Normansrule/Gonioreflectometer-Open-Source/phases/00-plan/3d/README.md

# 00 · 3D files

## Print

Black ABS, enclosed printer: nozzle 245–255 °C, bed 100–105 °C, fan ≤ 20 %, 0.2 mm layers, 4 walls, 25 % gyroid, brim on tall or long parts, no supports unless noted; XY shrink compensation from the coupon (M03.3). Ventilate the room (ABS fumes). Counts and grams: [cad/PRINT.md](../../../cad/PRINT.md). v0 geometry: measure your parts first.

**STEP** imports into Onshape as an editable solid (Insert → Import). **STL** is a mesh for the slicer.

| ID | Part | Edit (STEP) | Print (STL) |
|---|---|---|---|
| PLAN-01 | Fit test: M2 self-tap holes + 608 pockets | [PLAN-01_tolerance_coupon.step](PLAN-01_tolerance_coupon.step) | [PLAN-01_tolerance_coupon.stl](PLAN-01_tolerance_coupon.stl) |

Regenerate: `python tools/cad/parts.py` (parameters at the top of the file).

## Bought parts

Every bought part has a model in the repo (dummy in `cad/bought/` or open model in `cad/open/`; list: [cad/README.md](../../../cad/README.md)). `bash scripts/get_cad.sh` saves the real vendor models into `cad/vendor/` (not committed: vendor licences).

| ID | Part | In the repo | Real model |
|---|---|---|---|
| FIL-01 | ABS filament 1.75 mm, black, 1 kg (4 spools) | — | n/a (filament) |

Design notes: [../design.md](../design.md).
