Normansrule/Gonioreflectometer-Open-Source/phases/11-scan-capture/3d/README.md

# 11 · 3D files

## Print

Black ABS, enclosed printer: nozzle 245–255 °C, bed 100–105 °C, fan ≤ 20 %, 0.2 mm layers, 4 walls, 25 % gyroid, brim on tall or long parts, no supports unless noted; XY shrink compensation from the coupon (M03.3). Ventilate the room (ABS fumes). Counts and grams: [cad/PRINT.md](../../../cad/PRINT.md). v0 geometry: measure your parts first.

**STEP** imports into Onshape as an editable solid (Insert → Import). **STL** is a mesh for the slicer.

| ID | Part | Edit (STEP) | Print (STL) |
|---|---|---|---|
| SCN-03a | Riser 20 mm | [SCN-03a_riser_20.step](SCN-03a_riser_20.step) | [SCN-03a_riser_20.stl](SCN-03a_riser_20.stl) |
| SCN-03b | Riser 40 mm | [SCN-03b_riser_40.step](SCN-03b_riser_40.step) | [SCN-03b_riser_40.stl](SCN-03b_riser_40.stl) |
| SCN-03c | Riser 60 mm | [SCN-03c_riser_60.step](SCN-03c_riser_60.step) | [SCN-03c_riser_60.stl](SCN-03c_riser_60.stl) |
| SCN-03d | Scan camera plate, looks 15 deg down | [SCN-03d_scan_camera_plate_15.step](SCN-03d_scan_camera_plate_15.step) | [SCN-03d_scan_camera_plate_15.stl](SCN-03d_scan_camera_plate_15.stl) |

Regenerate: `python tools/cad/parts.py` (parameters at the top of the file).

## Bought parts

Every bought part has a model in the repo (dummy in `cad/bought/` or open model in `cad/open/`; list: [cad/README.md](../../../cad/README.md)). `bash scripts/get_cad.sh` saves the real vendor models into `cad/vendor/` (not committed: vendor licences).

| ID | Part | In the repo | Real model |
|---|---|---|---|
| SCN-01 | Mounting putty 2 oz | [`SCN-01_mounting_putty_blob.step`](../../../cad/bought/SCN-01_mounting_putty_blob.step) | None published - use the dummy (putty) |
| SCN-02 | ChArUco scanning mat (printed on TLS-08) | [`SCN-02_charuco_mat_print.step`](../../../cad/bought/SCN-02_charuco_mat_print.step) | None published - use the dummy (print, generated by the software) |
| CAM-04 | Second USB camera 12 MP IMX477, M12 mount (scan camera) | [`CAM-01_arducam_b0433_imx477_usb.step`](../../../cad/bought/CAM-01_arducam_b0433_imx477_usb.step) | None published - use the dummy (same as CAM-01) |
| CAM-05 | Second M12 16 mm lens (scan camera) | [`CAM-02_m12_lens_16mm.step`](../../../cad/bought/CAM-02_m12_lens_16mm.step) | None published - use the dummy (same as CAM-02) |

Design notes: [../design.md](../design.md).
