Normansrule/Gonioreflectometer-Open-Source/wiki/Hardware.md

<!-- generated from wiki/src/Hardware.md by tools/refs_bib.py - edit the source -->

# Hardware

Every electrical connection, pin by pin (power, SKR Pico, ESP32-S3 header, lamp, USB; step by step in the [wiring guide](https://github.com/Normansrule/Gonioreflectometer-Open-Source/blob/main/docs/wiring.html)): [README → Wiring](https://github.com/Normansrule/Gonioreflectometer-Open-Source/blob/main/README.md#wiring).

| Subsystem | Parts | Stage |
|---|---|---|
| Power | 24 V 3 A wall adapter with a screw-terminal jack, latching e-stop in its own box, pre-wired limit switch, lever connectors | [01](https://github.com/Normansrule/Gonioreflectometer-Open-Source/blob/main/phases/01-power) |
| Controller | BTT SKR Pico (grblHAL, USB-C) + ESP32-S3 hub, keypads | [02](https://github.com/Normansrule/Gonioreflectometer-Open-Source/blob/main/phases/02-controller) |
| Frame | printed 600 × 600 mm deck (9 tiles), printed 20 × 20 bars, M2 screws | [03](https://github.com/Normansrule/Gonioreflectometer-Open-Source/blob/main/phases/03-frame) |
| Light arm (M4) | 12 in lazy Susan, GT2 belt rim, 24:1 | [04](https://github.com/Normansrule/Gonioreflectometer-Open-Source/blob/main/phases/04-light-arm) |
| Table (M3), tilt (M2), spin (M1) | NEMA 17 steppers, 5:1 belts, M8 bolt axles, direct-drive spin | [05](https://github.com/Normansrule/Gonioreflectometer-Open-Source/blob/main/phases/05-table) · [08](https://github.com/Normansrule/Gonioreflectometer-Open-Source/blob/main/phases/08-tilt) · [09](https://github.com/Normansrule/Gonioreflectometer-Open-Source/blob/main/phases/09-spin) |
| Camera | 12 MP IMX477 USB, 16 mm M12 lens, printed f/8 stop | [06](https://github.com/Normansrule/Gonioreflectometer-Open-Source/blob/main/phases/06-camera-light) |
| Light | Citizen CLU701 COB, colour rendering index (CRI) ≥ 90, 2700 K, in a solderless TE holder, 350 mA wire-lead driver, pin-fin heatsink | [06](https://github.com/Normansrule/Gonioreflectometer-Open-Source/blob/main/phases/06-camera-light) |

- **No tools beyond a kit:** lever connectors, screw terminals, modules instead of loose chips, M2 screws self-tapping into printed pilots.
- **One screw size:** M2 everywhere; M3 only into the motors, M8 bolts as axles.
- **Printed parts:** black ABS (acrylonitrile butadiene styrene) on an enclosed printer; ≈ 2.7 kg, half of it the deck.
- **Circuit board (future):** a carrier board that replaces the modules and jumpers: [pcb/](https://github.com/Normansrule/Gonioreflectometer-Open-Source/blob/main/pcb/README.md).
- **Optical homing** on every axis; one over-travel switch in the e-stop loop (light arm, at 17°; the other ends rely on soft limits and the e-stop).
- **Cost:** see the [bill of materials](https://github.com/Normansrule/Gonioreflectometer-Open-Source/blob/main/README.md#electronics) (pictures, buy links, STEP/STL downloads).

Open-hardware practice (Open Source Hardware Association, n.d.; Pearce, 2012): [Appendix E](Appendix-E-Hardware.md).

## References

Open Source Hardware Association. (n.d.). *Open source hardware (OSHW) definition 1.0*. Retrieved <https://oshwa.org/definition/>

Pearce, J. M. (2012). Building research equipment with free, open-source hardware. *Science*, *337*(6100), 1303–1304. <https://doi.org/10.1126/science.1228183>
