Normansrule/Gonioreflectometer-Open-Source/wiki/Appendix-E-Hardware.md

# Appendix E · Motion control, electronics, open hardware

<!-- generated by tools/refs_bib.py from REFERENCES.md - edit that file, then `make build` -->

Background papers and sources, by topic. Format: APA reference — *what this project uses it for*. Full list: [Bibliography](Bibliography.md).

## Stepper drivers and microcontrollers

- Analog Devices (Trinamic). (n.d.-b). *TMC2209 datasheet*. https://www.analog.com/media/en/technical-documentation/data-sheets/tmc2209_datasheet_rev1.09.pdf — *Driver registers, UART, current (phase 02)* `[H1]`
- Analog Devices (Trinamic). (n.d.-a). *AN-002: Parameterization of StallGuard2 & CoolStep*. https://www.analog.com/en/resources/app-notes/an-002.html — *Stall-detection thresholds, crash detection (phases 02, 04)* `[H2]`
- Dwersteg (Analog Devices/Trinamic), B. (n.d.). *AN-026: Programmable adaptive microstep table*. https://www.analog.com/en/resources/app-notes/an-026.html — *Microstep linearity, even step spacing (phases 08, 09)* `[H3]`
- Marlin Firmware. (n.d.). *Trinamic drivers*. https://marlinfw.org/docs/hardware/tmc_drivers.html — *StealthChop vs SpreadCycle choice (phase 02)* `[H4]`
- Espressif Systems. (n.d.-b). *ESP32 technical reference manual*. https://documentation.espressif.com/esp32_technical_reference_manual_en.pdf — *E4 MCU peripherals, step timing (phase 02)* `[H5]`
- Espressif Systems. (n.d.-a). *ESP32 series datasheet*. https://www.espressif.com/sites/default/files/documentation/esp32_datasheet_en.pdf — *Strapping pins, electrical limits (phase 02)* `[H6]`
- Raspberry Pi Ltd. (n.d.-b). *RP2040 datasheet*. https://datasheets.raspberrypi.com/rp2040/rp2040-datasheet.pdf — *Pico GPIO, pull-ups, PIO (phase 02)* `[H7]`
- Raspberry Pi Ltd. (n.d.-a). *Raspberry Pi Pico-series Python SDK: A MicroPython environment for Raspberry Pi microcontrollers*. https://datasheets.raspberrypi.com/pico/raspberry-pi-pico-python-sdk.pdf — *MicroPython button-hub firmware (phase 02)* `[H8]`

## Interface electronics and position sensors

- Sharp Corporation. (2018). *PC817XxNSZ1B series*. https://global.sharp/products/device/lineup/data/pdf/datasheet/PC817XxNSZ1B_e.pdf — *24 V sense optocoupler, CTR (phase 01)* `[H9]`
- Texas Instruments. (2025). *ULN200x, ULQ200x high-voltage, high-current darlington transistor arrays*. https://www.ti.com/lit/gpn/ULN2003A — *8-band LED low-side switching (phase 10)* `[H10]`
- Vishay Semiconductors. (n.d.). *TCST2103, TCST2202, TCST2300: Transmissive optical sensor with phototransistor output*. https://www.vishay.com/docs/81147/tcst2103.pdf — *Optical homing flag, 1 mm aperture (phases 04, 05)* `[H11]`
- ams AG (ams OSRAM). (2014). *AS5600 – 12-bit programmable contactless potentiometer*. https://www.mouser.com/pdfdocs/AMS_AS5600_Datasheet_EN.PDF — *Absolute-angle check of axes (phase 17)* `[H12]`

## Camera interface

- Sony Semiconductor Solutions. (2018). *IMX477-AACK: Diagonal 7.857 mm (type 1/2.3) 12.3 mega-pixel CMOS image sensor*. https://www.sony-semicon.com/files/62/pdf/p-13_IMX477-AACK_Flyer.pdf — *Pixel pitch 1.55 µm, sensor size (phase 06)* `[H13]`
- USB Implementers Forum. (2012). *Video class v1.5 document set*. https://www.usb.org/document-library/video-class-v15-document-set — *UVC exposure/white-balance controls (phase 06)* `[H14]`
- Linux kernel documentation. (n.d.). *The linux USB video class (UVC) driver*. https://www.kernel.org/doc/html/latest/userspace-api/media/drivers/uvcvideo.html — *uvcvideo controls, extension units (phases 06, 14)* `[H15]`

## Belt drives and positioning accuracy

- Gates Corporation. (n.d.-b). *PowerGrip GT2 belt drives – drive design manual*. https://docs.rs-online.com/5016/0900766b8002d3b7.pdf — *GT tooth profile, registration, backlash (phases 04, 05)* `[H16]`
- Gates Corporation. (n.d.-a). *Light power & precision drive design manual*. https://www.gates.com/content/dam/documents-library/catalogs/light-power-and-precision-manual.pdf — *Small-pitch pulley sizing, tension (phases 04, 05)* `[H17]`
- Prusa Research. (n.d.). *Adjusting belt tension (CORE one/+, CORE one INDX, CORE one L/+)*. https://help.prusa3d.com/article/adjusting-belt-tension-core-one_845048 — *Frequency-based belt tension check (phase 04)* `[H18]`
- Oriental Motor USA. (n.d.). *Stepper motor basics*. https://www.orientalmotor.com/stepper-motors/technology/stepper-motor-basics.html — *Angular error budget per axis (phase 07)* `[H19]`
- Walter, M. (2016). How accurate is microstepping really? *Hackaday*, *29*. https://hackaday.com/2016/08/29/how-accurate-is-microstepping-really/ — *Microsteps ≠ accuracy under load (phase 08)* `[H20]`
- Fritz Faulhaber GmbH, Dr. (n.d.). *Stepper motor technical note: Microstepping myths and realities*. https://www.faulhaber.com/fileadmin/user_upload/Support/dff_200276_whitepaper_microstepping_8cb.pdf — *Incremental torque per microstep (phase 08)* `[H21]`
- Zaber Technologies. (n.d.). *Microstepping tutorial*. https://www.zaber.com/technical-articles/microstepping-tutorial — *Stiction vs microstep resolution (phase 07)* `[H22]`
- Chang, C., & Tran, T. (2025). Mastering precision: Understanding microstepping in motion control. *Analog Dialogue*, *59*(2). https://www.analog.com/en/resources/analog-dialogue/articles/mastering-precision-understanding-microstepping.html — *Microstep current waveforms, holding torque (phase 02)* `[H23]`

## Motion firmware, homing and G-code

- Grbl project (gnea). (n.d.). *An open source, embedded, high performance g-code-parser and CNC milling controller*. https://github.com/gnea/grbl — *FluidNC lineage, protocol, homing cycle (phase 02)* `[H24]`
- grblHAL. (n.d.). *grblHAL core code and master wiki*. https://github.com/grblHAL/core — *Alternative Grbl-derived firmware (phase 02)* `[H25]`
- LinuxCNC. (n.d.). *Homing configuration*. https://linuxcnc.org/docs/html/config/ini-homing.html — *Two-speed search/latch homing (phases 04, 05)* `[H26]`
- Kramer, T. R., Proctor, F. M., & Messina, E. R. (2000). *The NIST RS274NGC interpreter – version 3*. https://www.nist.gov/publications/nist-rs274ngc-interpreter-version-3 — *G-code semantics for capture scripts (phase 14)* `[H27]`

## Open-source hardware practice and licensing

- Pearce, J. M. (2012). Building research equipment with free, open-source hardware. *Science*, *337*(6100), 1303–1304. https://doi.org/10.1126/science.1228183 — *Rationale for open lab equipment (phase 00)* `[H28]`
- Pearce, J. M. (2014). *Open-source lab: How to build your own hardware and reduce research costs*. Elsevier. https://doi.org/10.1016/C2012-0-07249-3 — *Low-cost scientific tool design (phase 00)* `[H29]`
- Jones, R., Haufe, P., Sells, E., Iravani, P., Olliver, V., Palmer, C., & Bowyer, A. (2011). RepRap – the replicating rapid prototyper. *Robotica*, *29*(1), 177–191. https://doi.org/10.1017/S026357471000069X — *Printed-part machine heritage (phase 03)* `[H30]`
- Open Source Hardware Association. (n.d.). *Open source hardware (OSHW) definition 1.0*. https://oshwa.org/definition/ — *Release documentation criteria (phase 16)* `[H31]`
- CERN. (n.d.). *CERN open hardware licence version 2*. https://www.ohwr.org/cernohl — *Hardware licence choice (phase 16)* `[H32]`
- Gathering for Open Science Hardware. (n.d.). *GOSH manifesto*. https://openhardware.science/gosh-manifesto/ — *Project values, accessibility (phase 16)* `[H33]`
- Bonvoisin, J., Mies, R., Boujut, J.-F., & Stark, R. (2017). What is the ’source’ of open source hardware? *Journal of Open Hardware*, *1*(1). https://doi.org/10.5334/joh.7 — *What files to publish (phase 16)* `[H34]`
- Collins, J. T., Knapper, J., Stirling, J., …, & Bowman, R. (2020). Robotic microscopy for everyone: The OpenFlexure microscope. *Biomedical Optics Express*, *11*(5), 2447–2460. https://doi.org/10.1364/BOE.385729 — *Model for documented printed instrument (phases 00, 16)* `[H35]`
- Elsevier. (n.d.). *Guide for authors – HardwareX*. https://doi.org/10.5281/zenodo.5078227 — *Paper structure, BOM, validation (phase 16)* `[H36]`

## Low-cost open instruments (HardwareX and related)

- Toschke, Y., Klenen, J., & Imlau, M. (2024). Open photonics: An integrated approach for building a 3D-printed motorized rotation stage system. *HardwareX*, *20*, e00577. https://doi.org/10.1016/j.ohx.2024.e00577 — *ESP32 rotation stage, home switch (phases 05, 09)* `[H37]`
- Schneidereit, D., Kraus, L., Meier, J. C., Friedrich, O., & Gilbert, D. F. (2017). Step-by-step guide to building an inexpensive 3D printed motorized positioning stage for automated high-content screening microscopy. *Biosensors and Bioelectronics*, *92*, 472–481. https://doi.org/10.1016/j.bios.2016.10.078 — *Printed stepper stage accuracy (phase 03)* `[H38]`
- Hietanen, I., Heikkinen, I. T. S., Savin, H., & Pearce, J. M. (2018). Approaches to open source 3-D printable probe positioners and micromanipulators for probe stations. *HardwareX*. https://doi.org/10.1016/j.ohx.2018.e00042 — *Validating printed positioners (phase 07)* `[H39]`
- Salazar-Vazquez, J., & Mendez-Vazquez, A. (2020). A plug-and-play hyperspectral imaging sensor using low-cost equipment. *HardwareX*. https://doi.org/10.1016/j.ohx.2019.e00087 — *Low-cost spectral imaging prior art (phase 10)* `[H40]`
- Dhankania, K. C., & Pearce, J. M. (2016). Open source laboratory sample rotator mixer and shaker. *HardwareX*. http://www.sciencedirect.com/science/article/pii/S2468067216300049 — *Printed rotary stage prior art (phase 05)* `[H41]`
- Public Lab. (n.d.). *Desktop spectrometry kit 3.0*. https://publiclab.org/wiki/desktop-spectrometry-kit-3-0 — *DIY spectral calibration (phase 10)* `[H42]`

## Design tools and project publishing

- *KiCad EDA*. (n.d.). https://kicad.org/ — *Power-box and hub schematics (phases 01, 02)* `[H43]`
- GitHub Docs. (n.d.-b). *REST API endpoints for milestones*. https://docs.github.com/en/rest/issues/milestones — *Phase milestones and issue scripts (phase 00)* `[H44]`
- GitHub Docs. (n.d.-a). *Configuring a publishing source for your GitHub pages site*. https://docs.github.com/en/pages/getting-started-with-github-pages/configuring-a-publishing-source-for-your-github-pages-site — *Documentation site deployment (phase 16)* `[H45]`

## Software dependencies

- *Python software foundation, Python language and standard library*. (n.d.). https://www.python.org — *Laptop app runtime (phase 14)* `[H46]`
- Harris, C. R., Millman, K. J., Walt, S. J. van der, et al. (2020). Array programming with NumPy. *Nature*, *585*, 357–362. https://doi.org/10.1038/s41586-020-2649-2 — *Image arrays, HDR, geometry (phase 07)* `[H47]`
- Virtanen, P., Gommers, R., Oliphant, T. E., et al. (2020). SciPy 1.0: Fundamental algorithms for scientific computing in Python. *Nature Methods*, *17*, 261–272. https://doi.org/10.1038/s41592-019-0686-2 — *BRDF least-squares fitting, rotations (phases 07, 08)* `[H48]`
- Bradski, G. (2000). The OpenCV library. *Dr. Dobb’s Journal of Software Tools*. https://github.com/opencv/opencv/wiki/CiteOpenCV — *Capture, calibration, ChArUco (phases 06, 11)* `[H49]`
- *PyYAML (YAML parser and emitter for Python)*. (n.d.). https://pyyaml.org/ — *Config files and test suite (phase 14)* `[H50]`

## Standalone station

- *Raspberry Pi Zero 2 W*. (n.d.). https://www.raspberrypi.com/products/raspberry-pi-zero-2-w/ — *Standalone station (phase 15)* `[H51]`
- *Micropython-lib SSD1306 driver*. (n.d.). https://github.com/micropython/micropython-lib/tree/master/micropython/drivers/display/ssd1306 — *Panel OLED (phase 15)* `[H52]`
- *Raspberry Pi configuration, ‘raspi-config‘ and UART*. (n.d.). https://www.raspberrypi.com/documentation/computers/configuration.html — *Pi UART to Pico (phase 15)* `[H53]`
- *Usbipd-win*. (n.d.). https://github.com/dorssel/usbipd-win — *USB boards into WSL (phase 02)* `[H54]`
- *MicroPython ‘machine.UART‘*. (n.d.). https://docs.micropython.org/en/latest/library/machine.UART.html — *Pico ↔ Pi link (phase 15)* `[H55]`
- *CadQuery 2.x, parametric CAD in Python*. (n.d.). https://pypi.org/project/cadquery/ — *Generated STEP/STL parts (phase 00)* `[H56]`
- *Numpy-stl*. (n.d.). https://pypi.org/project/numpy-stl/ — *Parts gallery rendering (phase 00)* `[H57]`
- *Matplotlib*. (n.d.). https://matplotlib.org/ — *Parts gallery rendering (phase 00)* `[H58]`
- *Ams AS7341 11-channel spectral sensor; adafruit breakout #4698*. (n.d.). https://www.adafruit.com/product/4698 — *Spectral sensor (phase 10)* `[H59]`
- *W3C, portable network graphics (PNG) specification*. (n.d.). https://www.w3.org/TR/png/ — *Built-in PNG reader/writer in `opengonio.imageio` (phase 00)* `[H60]`
