Normansrule/Gonioreflectometer-Open-Source/phases/07-calibrate/design.md

# 07 · Design

- Blackout drape on four dowels; black felt behind the sample; the power plate and controller tray stay uncovered (air around the e-stop box, adapter jack and SKR Pico).
- Printed kinematic holders for PTFE, mirror tile, chrome balls, ChArUco board on glass.

## 3D parts

| Part | Source |
|---|---|
| Dowel sockets, drape clips (ENC-04) | Onshape `ENC` |
| Holders for PTFE, mirror, balls (CAL-06) | Onshape `CAL` |

## Results

(fill in)
