Normansrule/Gonioreflectometer-Open-Source/phases/06-camera-light/optics.md

# Fixed-camera optics (generated by tools/optics.py)

f = 16.0 mm, 3840 x 3032 px at 1.55 um (sensor 5.95 x 4.70 mm).

## BRDF mode (350 mm)

- Magnification 0.0479; field 124 x 98 mm; pixel footprint 32 um.
- Depth needed for a 50 mm swatch: 43 mm at theta_r 60 deg.

| Aperture N | Airy disk (um) | Airy / pixel | DOF (mm, c = 2 px) |
|---:|---:|---:|---:|
| f/2 | 2.7 | 1.7 | 5.7 |
| f/2.8 | 3.8 | 2.4 | 7.9 |
| f/4 | 5.4 | 3.5 | 11.3 |
| f/5.6 | 7.5 | 4.8 | 15.9 |
| f/8 | 10.7 | 6.9 | 22.6 |
| f/11 | 14.8 | 9.5 | 31.1 |
| f/16 | 21.5 | 13.9 | 45.3 |

Swatch BRDF: f/8 (averaged regions). Texture detail: f/4 and theta_r <= 45 deg.

## Scan mode (650 mm)

- Magnification 0.0252; field 236 x 186 mm; pixel footprint 0.061 mm (footprint, not resolution: see table).

| Aperture N | DOF (mm, c = diffraction) | Resolution on object (mm) |
|---:|---:|---:|
| f/5.6 | 57 | 0.18 |
| f/8 | 117 | 0.25 |
| f/11 | 221 | 0.35 |
| f/16 | 467 | 0.51 |

Scanning uses f/8: ~0.25 mm detail with enough depth for objects ~110 mm deep. Printed aperture stop = f / N = 2.0 mm (same stop as BRDF mode).
