Normansrule/Gonioreflectometer-Open-Source/wiki/Bibliography.md

# Bibliography

<!-- generated by tools/refs_bib.py from REFERENCES.md - edit that file, then `make build` -->

322 scholarly sources, APA 7th edition. `[G12]` = ID in [REFERENCES.md](https://github.com/Normansrule/Gonioreflectometer-Open-Source/blob/main/REFERENCES.md) and BibTeX key in [paper/references.bib](https://github.com/Normansrule/Gonioreflectometer-Open-Source/blob/main/paper/references.bib). Topic lists with what each source is used for: [Appendix A](Appendix-A-Measurement.md) · [Appendix B](Appendix-B-Reflectance-models.md) · [Appendix C](Appendix-C-Calibration-and-3D.md) · [Appendix D](Appendix-D-Standards-and-colour.md) · [Appendix E](Appendix-E-Hardware.md).

- Ackermann, J., & Goesele, M. (2015). A survey of photometric stereo techniques. *Foundations and Trends in Computer Graphics and Vision*, *9*. https://doi.org/10.1561/0600000065 `[V27]`
- Aittala, M., Weyrich, T., & Lehtinen, J. (2013). Practical SVBRDF capture in the frequency domain. *ACM Transactions on Graphics*, *32*(4). https://doi.org/10.1145/2461912.2461978 `[G44]`
- Ali, I., Suominen, O., Gotchev, A., & Ruiz Morales, E. (2019). Methods for simultaneous robot-world-hand–eye calibration: A comparative study. *Sensors*, *19*(12), 2837. https://doi.org/10.3390/s19122837 `[V17]`
- ams AG (ams OSRAM). (2014). *AS5600 – 12-bit programmable contactless potentiometer*. https://www.mouser.com/pdfdocs/AMS_AS5600_Datasheet_EN.PDF `[H12]`
- *Ams AS7341 11-channel spectral sensor; adafruit breakout #4698*. (n.d.). https://www.adafruit.com/product/4698 `[H59]`
- Analog Devices (Trinamic). (n.d.-a). *AN-002: Parameterization of StallGuard2 & CoolStep*. https://www.analog.com/en/resources/app-notes/an-002.html `[H2]`
- Analog Devices (Trinamic). (n.d.-b). *TMC2209 datasheet*. https://www.analog.com/media/en/technical-documentation/data-sheets/tmc2209_datasheet_rev1.09.pdf `[H1]`
- Andersson, Z., Edmondson, P., Guertault, J., Herubel, A., Kutz, P., Machizaud, A., Portsmouth, J., Servant, F., & Stone, J. (2025). OpenPBR surface: An open shading model for physically based materials. *DigiPro 2025*. https://doi.org/10.1145/3744199.3744632 `[T50]`
- Ansari-Asl, M. (2026). *Development of a multispectral camera-based device for goniometric acquisition of spatially varying reflectance properties*. PhD thesis. https://www.ntnu.edu/colourlab/phd-theses `[G35]`
- Ansari-Asl, M., Barbieri, M., Obein, G., & Hardeberg, J. Y. (2023). Advancing material appearance measurement: A cost-effective multispectral imaging system for capturing SVBRDF and BTF. *London Imaging Meeting*. https://doi.org/10.2352/lim.2023.4.1.25 `[G33]`
- Ansari-Asl, M., Barbieri, M., Obein, G., & Hardeberg, J. Y. (2024). Optical and electromechanical design and implementation of an advanced multispectral device to capture material appearance. *Journal of Imaging*, *10*(3), 55. https://doi.org/10.3390/jimaging10030055 `[R1]`
- Ansari-Asl, M., Thomas, J.-B., & Hardeberg, J. Y. (2022). Camera response function assessment in multispectral HDR imaging. *IS&T Electronic Imaging (Color Imaging XXVII)*, *141*. https://doi.org/10.2352/EI.2022.34.15.COLOR-141 `[G34]`
- Ashikhmin, M., & Shirley, P. (2000). An anisotropic Phong BRDF model. *Journal of Graphics Tools*, *5*(2), 25–32. https://doi.org/10.1080/10867651.2000.10487522 `[T15]`
- ASTM International. (n.d.). *Standard test method for specular gloss*. https://store.astm.org/standards/d523 `[N4]`
- ASTM International. (2003). *Standard practice for angle resolved optical scatter measurements on specular or diffuse surfaces*. https://www.astm.org/DATABASE.CART/WITHDRAWN/E1392.htm `[N2]`
- ASTM International. (2005). *Standard practice for goniophotometry of objects and materials*. https://store.astm.org/e0167-96.html `[N3]`
- ASTM International. (2019). *Standard practice for goniometric optical scatter measurements*. https://store.astm.org/e2387-19.html `[N1]`
- ASTM International. (2023a). *Standard practice for obtaining spectrometric data for object-color evaluation*. https://store.astm.org/standards/e1164 `[N9]`
- ASTM International. (2023b). *Standard test methods for measurement of gloss of high-gloss surfaces by abridged goniophotometry*. https://store.astm.org/standards/e430 `[N5]`
- ASTM International. (2025a). *Standard terminology of appearance*. https://doi.org/10.1520/E0284-25 `[N6]`
- ASTM International. (2025b). *Standard test method for multiangle color measurement of metal flake pigmented materials*. https://doi.org/10.1520/E2194-14R25 `[N8]`
- ASTM International. (2026). *Standard practice for specifying the geometry of multiangle spectrophotometers*. https://store.astm.org/standards/e2175 `[N7]`
- *ASWF, MaterialX specification and physically based shading nodes*. (n.d.). https://github.com/AcademySoftwareFoundation/MaterialX/blob/main/documents/Specification/MaterialX.PBRSpec.md `[T51]`
- Baek, S.-H., Zeltner, T., Ku, H., Hwang, I., Tong, X., Jakob, W., & Kim, M. H. (2020). Image-based acquisition and modeling of polarimetric reflectance. *ACM Transactions on Graphics*, *39*(4), 139. https://doi.org/10.1145/3386569.3392387 `[G45]`
- Bagher, M. M., Soler, C., & Holzschuch, N. (2012). Accurate fitting of measured reflectances using a shifted gamma micro-facet distribution. *Computer Graphics Forum*, *31*(4). https://inria.hal.science/hal-00702304 `[T23]`
- Barnes, P. Y., Early, E. A., & Parr, A. C. (1998a). *NIST measurement services: Spectral reflectance*. https://nvlpubs.nist.gov/nistpubs/Legacy/SP/nistspecialpublication250-48.pdf `[G21]`
- Barnes, P. Y., Early, E. A., & Parr, A. C. (1998b). *Spectral reflectance*. https://doi.org/10.6028/NIST.SP.250-48 `[N33]`
- Basri, R., Jacobs, D., & Kemelmacher, I. (2007). Photometric stereo with general, unknown lighting. *International Journal of Computer Vision*, *72*(3), 239–257. https://doi.org/10.1007/s11263-006-8815-7 `[V26]`
- Ben-Ezra, M., Wang, J., Wilburn, B., Li, X., & Ma, L. (2008). An LED-only BRDF measurement device. *Proceedings of the IEEE Conference on Computer Vision and Pattern Recognition*. https://doi.org/10.1109/CVPR.2008.4587766 `[G17]`
- Blender Manual. (n.d.). *Principled BSDF*. https://docs.blender.org/manual/en/latest/render/shader_nodes/shader/principled.html `[T48]`
- *Blender manual: PLY, OBJ, glTF 2.0, formats*. (n.d.). https://docs.blender.org/manual/en/latest/files/import_export/ply.html `[S16]`
- Blinn, J. F. (1977). Models of light reflection for computer synthesized pictures. *Proc. SIGGRAPH ’77*. https://doi.org/10.1145/563858.563893 `[T9]`
- Bonvoisin, J., Mies, R., Boujut, J.-F., & Stark, R. (2017). What is the ’source’ of open source hardware? *Journal of Open Hardware*, *1*(1). https://doi.org/10.5334/joh.7 `[H34]`
- Born, M., & Wolf, E. (2019). *Principles of optics* (7th ed.). https://www.cambridge.org/9781108477437 `[T30]`
- Bouguet, J.-Y. (2022). *Camera calibration toolbox for Matlab*. https://doi.org/10.22002/D1.20164 `[V5]`
- *BQ ciclop scanner + horus software*. (n.d.). https://github.com/bqlabs/ciclop `[V55]`
- Bradski, G. (2000). The OpenCV library. *Dr. Dobb’s Journal of Software Tools*. https://github.com/opencv/opencv/wiki/CiteOpenCV `[H49]`
- Brown, D. C. (1971). Close-range camera calibration. *Photogrammetric Engineering*, *37*(8), 855–866. https://www.semanticscholar.org/paper/Close-Range-Camera-Calibration-Brown/1150007b62a3c7dac99c2c8f85c63bfab74891af `[V4]`
- Burley, B. (2012). Physically-based shading at Disney. *Practical Physically Based Shading in Film and Game Production*. https://static1.squarespace.com/static/58586fa5ebbd1a60e7d76d3e/t/593a3afa46c3c4a376d779f6/1496988449807/s2012_pbs_disney_brdf_notes_v2.pdf `[T33]`
- Burley, B. (2015). *Extending the Disney BRDF to a BSDF with integrated subsurface scattering*. https://blog.selfshadow.com/publications/s2015-shading-course/burley/s2015_pbs_disney_bsdf_notes.pdf `[T34]`
- *CadQuery 2.x, parametric CAD in Python*. (n.d.). https://pypi.org/project/cadquery/ `[H56]`
- CERN. (n.d.). *CERN open hardware licence version 2*. https://www.ohwr.org/cernohl `[H32]`
- Chang, C., & Tran, T. (2025). Mastering precision: Understanding microstepping in motion control. *Analog Dialogue*, *59*(2). https://www.analog.com/en/resources/analog-dialogue/articles/mastering-precision-understanding-microstepping.html `[H23]`
- Chen, G., Dong, Y., Peers, P., Zhang, J., & Tong, X. (2014). Reflectance scanning: Estimating shading frame and BRDF with generalized linear light sources. *ACM Transactions on Graphics*, *33*(4). https://doi.org/10.1145/2601097.2601180 `[G43]`
- Chitnis, S., Sole, A., & Chandran, S. (2025). Spectral bidirectional reflectance distribution function simplification. *Journal of Imaging*, *11*(1), 18. https://doi.org/10.3390/jimaging11010018 `[G37]`
- CIE. (1995). *Method of measuring and specifying colour rendering properties of light sources*. https://cie.co.at/publications/method-measuring-and-specifying-colour-rendering-properties-light-sources `[N15]`
- CIE. (2006). *A framework for the measurement of visual appearance*. https://cie.co.at/publications/framework-measurement-visual-appearance `[N12]`
- CIE. (2017). *CIE 2017 colour fidelity index for accurate scientific use*. https://doi.org/10.25039/TR.224.2017 `[N16]`
- CIE. (2018). *Colorimetry, 4th edition*. https://doi.org/10.25039/TR.015.2018 `[N13]`
- CIE. (2020). *ILV: International lighting vocabulary, 2nd edition*. https://doi.org/10.25039/S017.2020 `[N14]`
- Collins, J. T., Knapper, J., Stirling, J., …, & Bowman, R. (2020). Robotic microscopy for everyone: The OpenFlexure microscope. *Biomedical Optics Express*, *11*(5), 2447–2460. https://doi.org/10.1364/BOE.385729 `[H35]`
- COLMAP FAQ. (n.d.). *Reconstruct sparse/dense model from known camera poses*. https://colmap.github.io/faq.html `[S2]`
- *COLMAP output format*. (n.d.). https://colmap.github.io/format.html `[S1]`
- Cook, R., & Torrance, K. (1982). A reflectance model for computer graphics. *ACM Transactions on Graphics*, *1*(1). `[R8]`
- *Cornell gonioreflectometer*. (n.d.). http://w1.graphics.cornell.edu/research/measure/gonio.html `[R10]`
- *Cornell measurement data*. (n.d.). https://www.graphics.cornell.edu/online/measurements/ `[R12]`
- Curless, B., & Levoy, M. (1996). A volumetric method for building complex models from range images. *Proc. SIGGRAPH*. https://doi.org/10.1145/237170.237269 `[V44]`
- Dana, K. J., Ginneken, B. van, Nayar, S. K., & Koenderink, J. J. (1999). Reflectance and texture of real-world surfaces. *ACM Transactions on Graphics*, *18*(1), 1–34. https://doi.org/10.1145/300776.300778 `[G11]`
- Dana, K. J., & Wang, J. (2004). Device for convenient measurement of spatially varying bidirectional reflectance. *Journal of the Optical Society of America A*, *21*(1), 1–12. https://doi.org/10.1364/JOSAA.21.000001 `[G14]`
- Daniilidis, K. (1999). Hand-eye calibration using dual quaternions. *International Journal of Robotics Research*, *18*(3), 286–298. https://doi.org/10.1177/02783649922066213 `[V12]`
- Debevec, P., Hawkins, T., Tchou, C., Duiker, H.-P., Sarokin, W., & Sagar, M. (2000). Acquiring the reflectance field of a human face. *Proc. SIGGRAPH*. https://doi.org/10.1145/344779.344855 `[V48]`
- Debevec, P., & Malik, J. (1997). Recovering high dynamic range radiance maps from photographs. *Proc. SIGGRAPH ’97*. https://pauldebevec.com/Research/HDR/debevec-siggraph97.pdf `[R5]`
- Dhankania, K. C., & Pearce, J. M. (2016). Open source laboratory sample rotator mixer and shaker. *HardwareX*. http://www.sciencedirect.com/science/article/pii/S2468067216300049 `[H41]`
- Dornaika, F., & Horaud, R. (1998). Simultaneous robot-world and hand-eye calibration. *IEEE Transactions on Robotics and Automation*, *14*(4), 617–622. https://doi.org/10.1109/70.704233 `[V14]`
- Dorsey, J., Rushmeier, H., & Sillion, F. (2008). *Digital modeling of material appearance*. Morgan Kaufmann. https://booksite.elsevier.com/samplechapters/9780122211812/Sample_Chapters/01~Front_Matter.pdf `[G2]`
- Dupuy, J., & Benyoub, A. (2023). Sampling visible GGX normals with spherical caps. *Computer Graphics Forum*, *42*(8). https://doi.org/10.1111/cgf.14867 `[T20]`
- Dupuy, J., Heitz, E., Iehl, J.-C., Poulin, P., & Ostromoukhov, V. (2015). Extracting microfacet-based BRDF parameters from arbitrary materials with power iterations. *Computer Graphics Forum*, *34*(4), 21–30. https://doi.org/10.1111/cgf.12675 `[T26]`
- Dupuy, J., & Jakob, W. (2018). *An adaptive parameterization for efficient material acquisition and rendering*. https://rgl.epfl.ch/publications/Dupuy2018Adaptive `[R15]`
- Durell, C., Scharpf, D., McKee, G., L’Heureux, M., Georgiev, G., Obein, G., & Cooksey, C. (2015). Creation and validation of sintered PTFE BRDF targets & standards. *Proceedings of SPIE*. https://tsapps.nist.gov/publication/get_pdf.cfm?pub_id=919590 `[G24]`
- Dwersteg (Analog Devices/Trinamic), B. (n.d.). *AN-026: Programmable adaptive microstep table*. https://www.analog.com/en/resources/app-notes/an-026.html `[H3]`
- Elsevier. (n.d.). *Guide for authors – HardwareX*. https://doi.org/10.5281/zenodo.5078227 `[H36]`
- EMVA. (2021). *Standard 1288: Standard for characterization of image sensors and cameras*. https://www.emva.org/standards-technology/emva-1288/ `[N24]`
- Epic Games. (n.d.). *Physically based materials in Unreal engine*. https://dev.epicgames.com/documentation/en-us/unreal-engine/physically-based-materials-in-unreal-engine `[T46]`
- Ericson, C. (2005). *Real-time collision detection*. Morgan Kaufmann. `[R9]`
- Espressif Systems. (n.d.-a). *ESP32 series datasheet*. https://www.espressif.com/sites/default/files/documentation/esp32_datasheet_en.pdf `[H6]`
- Espressif Systems. (n.d.-b). *ESP32 technical reference manual*. https://documentation.espressif.com/esp32_technical_reference_manual_en.pdf `[H5]`
- *F. Schröder, master’s thesis, 2019*. (2019). https://f-schroeder.github.io/publication/masterthesis/ `[R37]`
- *FabScan, media computing group, RWTH aachen university*. (n.d.). https://hci.rwth-aachen.de/fabscan `[V54]`
- Fairchild, M. D. (2013). *Color appearance models* (3rd ed.). https://doi.org/10.1002/9781118653128 `[N22]`
- Filip, J., & Haindl, M. (2009). Bidirectional texture function modeling: A state of the art survey. *IEEE Transactions on Pattern Analysis and Machine Intelligence*, *31*(11). https://doi.org/10.1109/TPAMI.2008.246 `[G5]`
- Filip, J., Vávra, R., & Krupička, M. (2014). Rapid material appearance acquisition using consumer hardware. *Sensors*, *14*(10), 19785–19805. https://doi.org/10.3390/s141019785 `[G38]`
- Fitzgibbon, A. W., Cross, G., & Zisserman, A. (1998). *Automatic 3D model construction for turn-table sequences*. https://doi.org/10.1007/3-540-49437-5_11 `[S9]`
- Fritz Faulhaber GmbH, Dr. (n.d.). *Stepper motor technical note: Microstepping myths and realities*. https://www.faulhaber.com/fileadmin/user_upload/Support/dff_200276_whitepaper_microstepping_8cb.pdf `[H21]`
- Furukawa, Y., & Hernández, C. (2015). Multi-view stereo: A tutorial. *Foundations and Trends in Computer Graphics and Vision*, *9*. https://doi.org/10.1561/0600000052 `[V39]`
- Furukawa, Y., & Ponce, J. (2010). Accurate, dense, and robust multiview stereopsis. *IEEE Transactions on Pattern Analysis and Machine Intelligence*, *32*(8), 1362–1376. https://doi.org/10.1109/TPAMI.2009.161 `[V38]`
- Garrido-Jurado, S., Muñoz-Salinas, R., Madrid-Cuevas, F. J., & Marín-Jiménez, M. J. (2014). Automatic generation and detection of highly reliable fiducial markers under occlusion. *Pattern Recognition*, *47*(6), 2280–2292. https://doi.org/10.1016/j.patcog.2014.01.005 `[V7]`
- Gates Corporation. (n.d.-a). *Light power & precision drive design manual*. https://www.gates.com/content/dam/documents-library/catalogs/light-power-and-precision-manual.pdf `[H17]`
- Gates Corporation. (n.d.-b). *PowerGrip GT2 belt drives – drive design manual*. https://docs.rs-online.com/5016/0900766b8002d3b7.pdf `[H16]`
- Gathering for Open Science Hardware. (n.d.). *GOSH manifesto*. https://openhardware.science/gosh-manifesto/ `[H33]`
- *GatherLab/goniometer*. (n.d.). https://github.com/GatherLab/Goniometer `[R38]`
- Georgiev, I., Portsmouth, J., Andersson, Z., Herubel, A., King, A., Ogaki, S., & Servant, F. (n.d.). *Autodesk standard surface*. https://autodesk.github.io/standard-surface/ `[T49]`
- Ghosh, A., Chen, T., Peers, P., Wilson, C. A., & Debevec, P. (2009). Estimating specular roughness and anisotropy from second order spherical gradient illumination. *Eurographics Symposium on Rendering*. https://www.cs.wm.edu/~ppeers/publications/Ghosh2009ESR/Ghosh_EGSR2009.pdf `[G41]`
- Ghosh, A., Chen, T., Peers, P., Wilson, C. A., & Debevec, P. (2010). Circularly polarized spherical illumination reflectometry. *ACM SIGGRAPH Asia*. https://vgl.ict.usc.edu/Research/CPSIR/ `[G42]`
- Ghosh, A., Fyffe, G., Tunwattanapong, B., Busch, J., Yu, X., & Debevec, P. (2011). Multiview face capture using polarized spherical gradient illumination. *ACM Transactions on Graphics*, *30*(6). https://doi.org/10.1145/2070781.2024163 `[V50]`
- GitHub Docs. (n.d.-a). *Configuring a publishing source for your GitHub pages site*. https://docs.github.com/en/pages/getting-started-with-github-pages/configuring-a-publishing-source-for-your-github-pages-site `[H45]`
- GitHub Docs. (n.d.-b). *REST API endpoints for milestones*. https://docs.github.com/en/rest/issues/milestones `[H44]`
- Goldman, D. B., Curless, B., Hertzmann, A., & Seitz, S. M. (2005). *Shape and spatially-varying BRDFs from photometric stereo*. https://doi.org/10.1109/ICCV.2005.219 `[S15]`
- Goodman, J. W. (2017). *Introduction to Fourier optics* (1st ed.). https://doi.org/10.1063/1.3035549 `[N46]`
- Granados, M., Ajdin, B., Wand, M., Theobalt, C., Seidel, H.-P., & Lensch, H. P. A. (2010). Optimal HDR reconstruction with linear digital cameras. *Proceedings of the IEEE Conference on Computer Vision and Pattern Recognition*. https://vcai.mpi-inf.mpg.de/projects/opthdr/ `[V23]`
- Grbl project (gnea). (n.d.). *An open source, embedded, high performance g-code-parser and CNC milling controller*. https://github.com/gnea/grbl `[H24]`
- grblHAL. (n.d.). *grblHAL core code and master wiki*. https://github.com/grblHAL/core `[H25]`
- Griwodz, C. et al. (2021). AliceVision meshroom: An open-source 3D reconstruction pipeline. *Proc. ACM MMSys*. https://doi.org/10.1145/3458305.3478443 `[V40]`
- Grossberg, M. D., & Nayar, S. K. (2003). What is the space of camera response functions? *Proceedings of the IEEE Conference on Computer Vision and Pattern Recognition*. https://doi.org/10.1109/TPAMI.2004.88 `[V21]`
- Guarnera, D., Guarnera, G. C., Ghosh, A., Denk, C., & Glencross, M. (2016). BRDF representation and acquisition. *Computer Graphics Forum*, *35*(2), 625–650. https://doi.org/10.1111/cgf.12867 `[G3]`
- Gulbrandsen, O. (2014). Artist friendly metallic Fresnel. *Journal of Computer Graphics Techniques*, *3*(4), 64–72. https://jcgt.org/published/0003/04/03/paper.pdf `[T31]`
- Guy, R., & Agopian, M. (n.d.). *Physically based rendering in Filament*. https://google.github.io/filament/Filament.md.html `[T39]`
- Han, J. Y., & Perlin, K. (2003). Measuring bidirectional texture reflectance with a kaleidoscope. *ACM Transactions on Graphics*, *22*(3). https://doi.org/10.1145/882262.882341 `[G13]`
- Hanrahan, P. (2016). *Reflection models I: Ideal materials*. `[R2]`
- Hardeberg, J. Y. (2001). *Acquisition and reproduction of color images: Colorimetric and multispectral approaches*. https://doi.org/10.1002/col.10073 `[N43]`
- Hardeberg, J. Y. (2004). Filter selection for multispectral color image acquisition. *Journal of Imaging Science and Technology*, *48*(2). https://doi.org/10.2352/J.ImagingSci.Technol.2004.48.2.art00005 `[N44]`
- Harris, C. R., Millman, K. J., Walt, S. J. van der, et al. (2020). Array programming with NumPy. *Nature*, *585*, 357–362. https://doi.org/10.1038/s41586-020-2649-2 `[H47]`
- Hartley, R., & Zisserman, A. (2004). *Multiple view geometry in computer vision* (2nd ed.). https://doi.org/10.1017/CBO9780511811685 `[V8]`
- Hasinoff, S. W., Durand, F., & Freeman, W. T. (2010). Noise-optimal capture for high dynamic range photography. *Proceedings of the IEEE Conference on Computer Vision and Pattern Recognition*, 553–560. https://doi.org/10.1109/CVPR.2010.5540167 `[V22]`
- Heikkilä, J., & Silvén, O. (1997). A four-step camera calibration procedure with implicit image correction. *Proceedings of the IEEE Conference on Computer Vision and Pattern Recognition*, 1106–1112. https://doi.org/10.1109/CVPR.1997.609468 `[V3]`
- Heitz, E. (2014). Understanding the masking-shadowing function in microfacet-based BRDFs. *Journal of Computer Graphics Techniques*, *3*(2), 48–107. https://jcgt.org/published/0003/02/03/paper.pdf `[T17]`
- Heitz, E. (2018). Sampling the GGX distribution of visible normals. *Journal of Computer Graphics Techniques*, *7*(4), 1–13. https://jcgt.org/published/0007/04/01/paper.pdf `[T19]`
- Heitz, E., & d’Eon, E. (2014). Importance sampling microfacet-based BSDFs using the distribution of visible normals. *Computer Graphics Forum*, *33*(4), 103–112. https://doi.org/10.1111/cgf.12417 `[T18]`
- Heitz, E., Hanika, J., d’Eon, E., & Dachsbacher, C. (2016). Multiple-scattering microfacet BSDFs with the Smith model. *ACM Transactions on Graphics*, *35*(4), 58. https://doi.org/10.1145/2897824.2925943 `[T21]`
- Hernández Esteban, C., & Schmitt, F. (2004). Silhouette and stereo fusion for 3D object modeling. *Computer Vision and Image Understanding*, *96*(3), 367–392. https://www.sciencedirect.com/science/article/abs/pii/S1077314204000542 `[V42]`
- Hertzmann, A., & Seitz, S. M. (2005). Example-based photometric stereo: Shape reconstruction with general, varying BRDFs. *IEEE Transactions on Pattern Analysis and Machine Intelligence*, *27*(8), 1254–1264. https://doi.org/10.1109/TPAMI.2005.158 `[V25]`
- Hietanen, I., Heikkinen, I. T. S., Savin, H., & Pearce, J. M. (2018). Approaches to open source 3-D printable probe positioners and micromanipulators for probe stations. *HardwareX*. https://doi.org/10.1016/j.ohx.2018.e00042 `[H39]`
- Hoffman, N. (2015). Physics and math of shading. *Physically Based Shading in Theory and Practice*. https://blog.selfshadow.com/publications/s2015-shading-course/hoffman/s2015_pbs_physics_math_slides.pdf `[T38]`
- Höpe, A. et al. (2012). ARGon3: ’3D appearance robot-based gonioreflectometer’ at PTB. *Review of Scientific Instruments*, *83*(4), 045102. https://pubs.aip.org/aip/rsi/article/83/4/045102/355039/ARGon3-3D-appearance-robot-based `[G27]`
- Höpe, A. et al. (2014). Multidimensional reflectometry for industry (xD-reflect) an European research project. *Proceedings of SPIE*. https://doi.org/10.1117/12.2035981 `[G28]`
- Höpe, A., & Hauer, K.-O. (2010). Three-dimensional appearance characterization of diffuse standard reflection materials. *Metrologia*, *47*(3), 295. https://doi.org/10.1088/0026-1394/47/3/021 `[G26]`
- Höpe, A., Hünerhoff, D., & Hauer, K.-O. (2006). Robot-based gonioreflectometer. In *Industrial robotics: Programming, simulation and applications* (pp. 624–632). (ed. L. K. Huat). https://cdn.intechopen.com/pdfs/284/InTech-Robot_based_gonioreflectometer.pdf `[G25]`
- Hsia, J. J., & Barnes, P. Y. (1995). *45°/0° reflectance factors of pressed polytetrafluoroethylene (PTFE) powder*. https://doi.org/10.6028/NIST.TN.1413 `[N32]`
- Hunt, R. W. G., & Pointer, M. R. (2011). *Measuring colour* (4th ed.). https://doi.org/10.1002/9781119975595 `[N23]`
- IEC. (n.d.). *Photobiological safety of lamps and lamp systems*. https://doi.org/10.3403/30149289 `[N47]`
- *IEC, "audio/video, information and communication technology equipment*. (n.d.). https://doi.org/10.3403/30347376U `[N51]`
- *IEC, "multimedia systems and equipment*. (n.d.). https://webstore.ansi.org/standards/iec/iec61966ed1999 `[N28]`
- *IEC, "safety of machinery*. (n.d.). https://doi.org/10.3403/30238348 `[N49]`
- IES. (n.d.). *Technical memorandum: IES method for evaluating light source color rendition*. https://store.ies.org/product/technical-memorandum-ies-method-for-evaluating-light-source-color-rendition/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 `[N18]`
- Ikehata, S. (2018). CNN-PS: CNN-based photometric stereo for general non-convex surfaces. *European Conference on Computer Vision*. https://doi.org/10.1007/978-3-030-01267-0_1 `[V34]`
- Imai, F. H., Berns, R. S., & Tzeng, D.-Y. (2000). A comparative analysis of spectral reflectance estimated in various spaces using a trichromatic camera system. *Journal of Imaging Science and Technology*, *44*(4), 280–287. https://doi.org/10.2352/J.ImagingSci.Technol.2000.44.4.art00003 `[N41]`
- Imai, F. H., Rosen, M. R., & Berns, R. S. (2000). Comparison of spectrally narrow-band capture versus wide-band with a priori sample analysis for spectral reflectance estimation. *Color and Imaging Conference*, *8*(1), 234–241. https://doi.org/10.2352/CIC.2000.8.1.art00043 `[N42]`
- *ISO, "graphic technology and photography*. (n.d.). https://www.iso.org/standard/35835.html `[N27]`
- *ISO, "paints and varnishes*. (n.d.). https://www.iso.org/standard/56807.html `[N10]`
- *ISO, "photography*. (n.d.-a). https://www.iso.org/standard/79169.html `[N25]`
- *ISO, "photography*. (n.d.-b). https://www.iso.org/standard/82233.html `[N26]`
- *ISO, "safety of machinery*. (n.d.-a). https://doi.org/10.3403/30265059 `[N48]`
- *ISO, "safety of machinery*. (n.d.-b). https://doi.org/10.3403/30201665 `[N50]`
- *J. Filip et al., specular BRDF with a goniometer, 2017*. (2017). https://staff.utia.cas.cz/filip/papers/filip17brdf.pdf `[R17]`
- Jakob, W., & Hanika, J. (2019). A low-dimensional function space for efficient spectral upsampling. *Computer Graphics Forum*, *38*(2), 147–155. https://doi.org/10.1111/cgf.13626 `[T53]`
- Jones, R., Haufe, P., Sells, E., Iravani, P., Olliver, V., Palmer, C., & Bowyer, A. (2011). RepRap – the replicating rapid prototyper. *Robotica*, *29*(1), 177–191. https://doi.org/10.1017/S026357471000069X `[H30]`
- *K. A. G. Smet, CRI_CIE_rf_2017 calculator (MATLAB/excel)*. (n.d.). https://github.com/ksmet1977/CRI_CIE_Rf_2017 `[N17]`
- Kajiya, J. T. (1986). The rendering equation. *Proc. SIGGRAPH ’86, Computer Graphics*, *20*(4), 143–150. https://doi.org/10.1145/15922.15902 `[T1]`
- Karis, B. (2013). Real shading in Unreal engine 4. *Physically Based Shading in Theory and Practice*. https://cdn2.unrealengine.com/Resources/files/2013SiggraphPresentationsNotes-26915738.pdf `[T35]`
- Karis, B. (2014). *Physically based shading on mobile*. `[T57]`
- Kavoosighafi, B. et al. (2025). Perceived quality of BRDF models. *Computer Graphics Forum*. https://doi.org/10.1111/cgf.70162 `[T28]`
- Kazhdan, M., Bolitho, M., & Hoppe, H. (2006). Poisson surface reconstruction. *Eurographics Symposium on Geometry Processing*. https://diglib.eg.org/items/245d6ba1-0209-4365-a4a4-16ce46421620 `[V45]`
- Kazhdan, M., & Hoppe, H. (2013). Screened Poisson surface reconstruction. *ACM Transactions on Graphics*, *32*(3), 29. https://doi.org/10.1145/2487228.2487237 `[V46]`
- *Khronos, glTF sample viewer*. (n.d.). https://github.com/KhronosGroup/glTF-Sample-Viewer `[T45]`
- Khronos Group. (n.d.). *glTF 2.0 specification*. https://registry.khronos.org/glTF/specs/2.0/glTF-2.0.html#metallic-roughness-material `[T40]`
- *Khronos, KHR_materials_anisotropy*. (n.d.). https://github.com/KhronosGroup/glTF/blob/main/extensions/2.0/Khronos/KHR_materials_anisotropy/README.md `[T41]`
- *Khronos, KHR_materials_sheen, KHR_materials_clearcoat*. (n.d.). https://github.com/KhronosGroup/glTF/blob/main/extensions/2.0/Khronos/KHR_materials_sheen/README.md `[T42]`
- *Khronos, KHR_materials_specular, KHR_materials_ior*. (n.d.). https://github.com/KhronosGroup/glTF/blob/main/extensions/2.0/Khronos/KHR_materials_specular/README.md `[T43]`
- *Khronos, KHR_texture_transform*. (n.d.). https://github.com/KhronosGroup/glTF/blob/main/extensions/2.0/Khronos/KHR_texture_transform/README.md `[T44]`
- *KiCad EDA*. (n.d.). https://kicad.org/ `[H43]`
- Kingslake, R., & Johnson, R. B. (2010). *Lens design fundamentals* (2nd ed.). https://doi.org/10.1016/B978-0-12-374301-5.00008-5 `[N45]`
- Kramer, T. R., Proctor, F. M., & Messina, E. R. (2000). *The NIST RS274NGC interpreter – version 3*. https://www.nist.gov/publications/nist-rs274ngc-interpreter-version-3 `[H27]`
- Kulla, C., & Conty, A. (2017). *Revisiting physically based shading at Imageworks*. https://blog.selfshadow.com/publications/s2017-shading-course/imageworks/s2017_pbs_imageworks_slides_v2.pdf `[T37]`
- Kurt, M., Szirmay-Kalos, L., & Křivánek, J. (2010). An anisotropic BRDF model for fitting and Monte Carlo rendering. *ACM SIGGRAPH Computer Graphics*, *44*(1), 1–15. https://doi.org/10.1145/1722991.1722996 `[G18]`
- Kutulakos, K. N., & Seitz, S. M. (2000). A theory of shape by space carving. *International Journal of Computer Vision*. https://doi.org/10.1023/A:1008191222954 `[S7]`
- Labsphere. (n.d.). *Technical guide: Reflectance materials and coatings*. https://www.systems-eng.co.jp/dcms_media/other/Guide_Reflectance_Materials_Coatings.pdf `[N34]`
- Lafortune, E. P. F., Foo, S.-C., Torrance, K. E., & Greenberg, D. P. (1997). Non-linear approximation of reflectance functions. *Proc. SIGGRAPH ’97*. https://doi.org/10.1145/258734.258801 `[T14]`
- Lagarde, S., & Rousiers, C. de. (2014). *Moving Frostbite to physically based rendering 3.0*. https://seblagarde.wordpress.com/wp-content/uploads/2015/07/course_notes_moving_frostbite_to_pbr_v3.pdf `[T36]`
- Lanevski, D. et al. (2022). Machine-readable universal data format for bidirectional reflectance distribution function and BiRDview—an open-source web-based application for viewing and comparing bidirectional reflectance data. *Color Research & Application*. https://doi.org/10.1002/col.22790 `[G52]`
- Laurentini, A. (1994). The visual hull concept for silhouette-based image understanding. *IEEE Transactions on Pattern Analysis and Machine Intelligence*, *16*(2). https://doi.org/10.1109/34.273735 `[S5]`
- Lavoué, G., Bonneel, N., Farrugia, J.-P., & Soler, C. (2021). Perceptual quality of BRDF approximations: Dataset and metrics. *Computer Graphics Forum*, *40*(2). https://doi.org/10.1111/cgf.142636 `[T27]`
- Le Breton, R., Ged, G., & Obein, G. (2015). Out of plane BRDF measurement at LNE-cnam using ’ConDOR’ our primary goniospectrophotometer. *Proc. 28th CIE Session*. https://inm.cnam.fr/gael-obein-71373.kjsp `[G30]`
- Lévy, B., Petitjean, S., Ray, N., & Maillot, J. (2002). Least squares conformal maps for automatic texture atlas generation. *ACM Transactions on Graphics*, *21*(3), 362–371. https://doi.org/10.1145/566654.566590 `[V56]`
- Linux kernel documentation. (n.d.). *The linux USB video class (UVC) driver*. https://www.kernel.org/doc/html/latest/userspace-api/media/drivers/uvcvideo.html `[H15]`
- LinuxCNC. (n.d.). *Homing configuration*. https://linuxcnc.org/docs/html/config/ini-homing.html `[H26]`
- *Loctite fun-tak 2 oz*. (n.d.). https://www.staples.com/Loctite-Fun-Tak-2-oz-Mounting-Adhesive-Putty-1270884/product_1480018 `[S20]`
- Logothetis, F., Quéau, Y., Mecca, R., & Cipolla, R. (2017). Semi-calibrated near-light photometric stereo. *SSVM*. https://doi.org/10.1007/978-3-319-58771-4_52 `[V31]`
- Lorensen, W. E., & Cline, H. E. (1987). Marching cubes: A high resolution 3D surface construction algorithm. *Proc. SIGGRAPH*. https://doi.org/10.1145/37401.37422 `[V43]`
- Löw, J., Kronander, J., Ynnerman, A., & Unger, J. (2012). BRDF models for accurate and efficient rendering of glossy surfaces. *ACM Transactions on Graphics*, *31*(1), 9. https://doi.org/10.1145/2077341.2077350 `[T25]`
- Lyngby, R. A., Matthiassen, J. B., Frisvad, J. R., Dahl, A. B., & Aanæs, H. (2019). Using a robotic arm for measuring BRDFs. *SCIA 2019*. https://doi.org/10.1007/978-3-030-20205-7_16 `[G39]`
- *M. Stokes, M. Anderson, S. Chandrasekar, R. Motta, "a standard default color space for the internet*. (n.d.). https://www.w3.org/Graphics/Color/sRGB.html `[N29]`
- Ma, W.-C., Hawkins, T., Peers, P., Chabert, C.-F., Weiss, M., & Debevec, P. (2007). Rapid acquisition of specular and diffuse normal maps from polarized spherical gradient illumination. *Eurographics Symposium on Rendering*. https://diglib.eg.org/items/da04b92c-39fe-41d1-a658-a8535521521c `[V49]`
- Marlin Firmware. (n.d.). *Trinamic drivers*. https://marlinfw.org/docs/hardware/tmc_drivers.html `[H4]`
- Marschner, S. R., Westin, S. H., Lafortune, E. P. F., & Torrance, K. E. (2000). Image-based bidirectional reflectance distribution function measurement. *Applied Optics*, *39*(16), 2592–2600. https://doi.org/10.1364/AO.39.002592 `[G12]`
- *Matplotlib*. (n.d.). https://matplotlib.org/ `[H58]`
- Matusik, W., Buehler, C., Raskar, R., Gortler, S. J., & McMillan, L. (2000). Image-based visual hulls. *Proc. SIGGRAPH*. https://doi.org/10.1145/344779.344951 `[V41]`
- Matusik, W., Pfister, H., Brand, M., & McMillan, L. (2003). Efficient isotropic BRDF measurement. *Proc. 14th Eurographics Workshop on Rendering*. https://www.pbr-book.org/4ed/Reflection_Models/Further_Reading `[G15]`
- Matusik, W., Pfister, H., Brand, M., & McMillan, L. (2023). *BRDF database – bidirectional reflectance distribution function*. https://doi.org/10.5281/zenodo.8101681 `[G51]`
- Mecca, R., Wetzler, A., Bruckstein, A. M., & Kimmel, R. (2014). Near field photometric stereo with point light sources. *SIAM Journal on Imaging Sciences*, *7*(4), 2732–2770. https://doi.org/10.1137/140968100 `[V29]`
- *MERL BRDF database*. (n.d.). Retrieved `[R13]`
- *Meshroom / AliceVision*. (n.d.). https://alicevision.org/ `[S10]`
- *MicroPython ‘machine.UART‘*. (n.d.). https://docs.micropython.org/en/latest/library/machine.UART.html `[H55]`
- *Micropython-lib SSD1306 driver*. (n.d.). https://github.com/micropython/micropython-lib/tree/master/micropython/drivers/display/ssd1306 `[H52]`
- Mitsuba 3 documentation. (n.d.). *BSDFs*. https://mitsuba.readthedocs.io/en/stable/src/generated/plugins_bsdfs.html `[T7]`
- Mitsunaga, T., & Nayar, S. K. (1999). Radiometric self calibration. *Proceedings of the IEEE Conference on Computer Vision and Pattern Recognition*, 374–380. https://doi.org/10.1109/CVPR.1999.786966 `[V19]`
- Molloy, E., Patrick, H., Hauer, K.-O., Hünerhoff, D., & Quast, T. (2026). Comparison of bidirectional reflectance distribution function scales over the hemisphere. *Applied Optics*, *65*(18), 6358–6365. https://doi.org/10.1364/AO.603369 `[G29]`
- Montes, R., & Ureña, C. (2012). *An overview of BRDF models*. https://digibug.ugr.es/bitstream/handle/10481/19751/rmontes_LSI-2012-001TR.pdf `[T5]`
- Murray-Coleman, J. F., & Smith, A. M. (1990). The automated measurement of BRDFs and their application to luminaire modeling. *Journal of the Illuminating Engineering Society*, *19*, 87–99. https://doi.org/10.1080/00994480.1990.10747944 `[G8]`
- *MVTec HALCON ‘photometric_stereo‘ reference*. (n.d.). https://www.mvtec.com/doc/halcon/13/en/photometric_stereo.html `[S8]`
- Nadal, M. E., & Thompson, E. A. (2001). NIST reference goniophotometer for specular gloss measurements. *Journal of Coatings Technology*, *73*(917), 73–80. https://www.paint.org/wp-content/uploads/2021/09/jctJUNE01-Nadal.pdf `[N11]`
- Narkowicz, K. (2016). *ACES filmic tone mapping curve*. `[T58]`
- Nayar, S. K., Fang, X.-S., & Boult, T. (1997). Separation of reflection components using color and polarization. *International Journal of Computer Vision*, *21*(3), 163–186. https://doi.org/10.1023/A:1007937815113 `[V51]`
- Nehab, D., Rusinkiewicz, S., Davis, J., & Ramamoorthi, R. (2005). Efficiently combining positions and normals for precise 3D geometry. *ACM Transactions on Graphics*, *24*(3). https://gfx.cs.princeton.edu/pubs/Nehab_2005_ECP/index.php `[V36]`
- Ngan, A., Durand, F., & Matusik, W. (2005). Experimental analysis of BRDF models. *Eurographics Symposium on Rendering*. https://diglib.eg.org/items/b3a3223e-ad94-4366-8ae7-fce371c08d04 `[G16]`
- Nicodemus, F. E., Richmond, J. C., Hsia, J. J., Ginsberg, I. W., & Limperis, T. (1977). Geometrical considerations and nomenclature for reflectance. *NBS Monograph*, *160*. https://doi.org/10.6028/NBS.MONO.160 `[G1]`
- Nielsen, J. B., Jensen, H. W., & Ramamoorthi, R. (2015). On optimal, minimal BRDF sampling for reflectance acquisition. *ACM Transactions on Graphics*, *34*(6), 186. https://www.pbr-book.org/4ed/Reflection_Models/Further_Reading `[G46]`
- Nimier-David, M., Vicini, D., Zeltner, T., & Jakob, W. (2019). Mitsuba 2: A retargetable forward and inverse renderer. *ACM Transactions on Graphics*, *38*(6), 203. https://doi.org/10.1145/3355089.3356498 `[T6]`
- *Numpy-stl*. (n.d.). https://pypi.org/project/numpy-stl/ `[H57]`
- Obein, G. (2021). The measurement of appearance. *Proc. Int. School of Physics "Enrico Fermi"*. https://doi.org/10.3254/ENFI210025 `[G7]`
- Ohno, Y. (2005). Spectral design considerations for white LED color rendering. *Optical Engineering*, *44*(11). https://doi.org/10.1117/1.2130694 `[N20]`
- Open Source Hardware Association. (n.d.). *Open source hardware (OSHW) definition 1.0*. https://oshwa.org/definition/ `[H31]`
- *OpenCV, camera calibration and 3D reconstruction (‘calibrateHandEye‘, ‘calibrateRobotWorldHandEye‘)*. (n.d.). https://docs.opencv.org/4.13.0/d9/d0c/group__calib3d.html `[V18]`
- *OpenCV ChArUco calibration*. (n.d.). https://docs.opencv.org/4.13.0/da/d13/tutorial_aruco_calibration.html `[S12]`
- *OpenCV ‘solvePnP‘*. (n.d.). https://docs.opencv.org/4.13.0/d5/d1f/calib3d_solvePnP.html `[S11]`
- *OpenMVS*. (n.d.). https://github.com/cdcseacave/openMVS `[S17]`
- *OpenScan (Raspberry Pi photogrammetry scanner)*. (n.d.). https://openscan.eu/pages/openscan-mini `[V53]`
- Oren, M., & Nayar, S. K. (1994). Generalization of Lambert’s reflectance model. *Proc. SIGGRAPH ’94*. https://doi.org/10.1145/192161.192213 `[T13]`
- Oriental Motor USA. (n.d.). *Stepper motor basics*. https://www.orientalmotor.com/stepper-motors/technology/stepper-motor-basics.html `[H19]`
- Papadhimitri, T., & Favaro, P. (2013). A new perspective on uncalibrated photometric stereo. *Proceedings of the IEEE Conference on Computer Vision and Pattern Recognition*. https://openaccess.thecvf.com/content_cvpr_2013/papers/Papadhimitri_A_New_Perspective_2013_CVPR_paper.pdf `[V33]`
- Park, F. C., & Martin, B. J. (1994). Robot sensor calibration: Solving AX=XB on the Euclidean group. *IEEE Transactions on Robotics and Automation*, *10*(5), 717–721. https://doi.org/10.1109/70.326576 `[V11]`
- Park, J.-I., Lee, M.-H., Grossberg, M. D., & Nayar, S. K. (2007). Multispectral imaging using multiplexed illumination. *Proceedings of the IEEE International Conference on Computer Vision*, 1–8. https://doi.org/10.1109/ICCV.2007.4409090 `[N37]`
- Patrick, H., Cooksey, C., Germer, T. A., Nadal, M. E., & Zarobila, C. (2021). Bidirectional reflectance capabilities of the NIST robotic optical scattering instrument. *Applied Optics*, *60*(28), 8774. https://doi.org/10.1364/AO.435117 `[G23]`
- Pearce, J. M. (2012). Building research equipment with free, open-source hardware. *Science*, *337*(6100), 1303–1304. https://doi.org/10.1126/science.1228183 `[H28]`
- Pearce, J. M. (2014). *Open-source lab: How to build your own hardware and reduce research costs*. Elsevier. https://doi.org/10.1016/C2012-0-07249-3 `[H29]`
- Peters, C., Merzbach, S., Hanika, J., & Dachsbacher, C. (2019). Using moments to represent bounded signals for spectral rendering. *ACM Transactions on Graphics*, *38*(4), 136. https://doi.org/10.1145/3306346.3322964 `[T54]`
- Pharr, M., Jakob, W., & Humphreys, G. (2023). *Physically based rendering: From theory to implementation* (4th ed.). https://www.pbr-book.org/4ed/Reflection_Models/Further_Reading `[T2]`
- Phong, B. T. (1975). Illumination for computer generated pictures. *Communications of the ACM*, *18*(6), 311–317. https://doi.org/10.1145/360825.360839 `[T8]`
- Polyanskiy, M. N. (2024). Refractiveindex.info database of optical constants. *Scientific Data*, *11*, 94. https://doi.org/10.1038/s41597-023-02898-2 `[T32]`
- Proctor, J. E., & Barnes, P. Y. (1996). NIST high accuracy reference reflectometer-spectrophotometer. *Journal of Research of the National Institute of Standards and Technology*, *101*(5), 619. https://nvlpubs.nist.gov/nistpubs/jres/101/5/j5proc.pdf `[G22]`
- Prusa Research. (n.d.). *Adjusting belt tension (CORE one/+, CORE one INDX, CORE one L/+)*. https://help.prusa3d.com/article/adjusting-belt-tension-core-one_845048 `[H18]`
- Public Lab. (n.d.). *Desktop spectrometry kit 3.0*. https://publiclab.org/wiki/desktop-spectrometry-kit-3-0 `[H42]`
- *Python software foundation, Python language and standard library*. (n.d.). https://www.python.org `[H46]`
- *PyYAML (YAML parser and emitter for Python)*. (n.d.). https://pyyaml.org/ `[H50]`
- *QuakeHold! Museum putty*. (n.d.). https://www.sosproducts.com/quakehold-museum-putty-p/64810.htm `[S19]`
- Quéau, Y., Durix, B., Wu, T., Cremers, D., Lauze, F., & Durou, J.-D. (2018). LED-based photometric stereo: Modeling, calibration and numerical solution. *Journal of Mathematical Imaging and Vision*, *60*(3), 313–340. https://doi.org/10.1007/s10851-017-0761-1 `[V30]`
- Quéau, Y., Durou, J.-D., & Aujol, J.-F. (2018). Normal integration: A survey. *Journal of Mathematical Imaging and Vision*, *60*(4), 576–593. https://doi.org/10.1007/s10851-017-0773-x `[V35]`
- *Raspberry Pi configuration, ‘raspi-config‘ and UART*. (n.d.). https://www.raspberrypi.com/documentation/computers/configuration.html `[H53]`
- Raspberry Pi Ltd. (n.d.-a). *Raspberry Pi Pico-series Python SDK: A MicroPython environment for Raspberry Pi microcontrollers*. https://datasheets.raspberrypi.com/pico/raspberry-pi-pico-python-sdk.pdf `[H8]`
- Raspberry Pi Ltd. (n.d.-b). *RP2040 datasheet*. https://datasheets.raspberrypi.com/rp2040/rp2040-datasheet.pdf `[H7]`
- *Raspberry Pi Zero 2 W*. (n.d.). https://www.raspberrypi.com/products/raspberry-pi-zero-2-w/ `[H51]`
- *RealityScan (formerly RealityCapture)*. (n.d.). https://www.realityscan.com/license `[S18]`
- Reinhard, E., Ward, G., Pattanaik, S., Debevec, P., Heidrich, W., & Myszkowski, K. (2010). *High dynamic range imaging: Acquisition, display, and image-based lighting* (2nd ed.). https://www.oreilly.com/library/view/high-dynamic-range/9780123749147/ `[V24]`
- *RGL-EPFL, customized PAB pgII gonio-photometer (instrument page)*. (n.d.). https://rgl.epfl.ch/pages/lab/pgII `[G32]`
- *RGL-EPFL material database*. (n.d.). https://rgl.epfl.ch/pages/lab/material-database `[R16]`
- Ribardière, M., Bringier, B., Meneveaux, D., & Simonot, L. (2017). STD: Student’s t-distribution of slopes for microfacet based BSDFs. *Computer Graphics Forum*, *36*(2). https://doi.org/10.1111/cgf.13137 `[T24]`
- Riviere, J., Peers, P., & Ghosh, A. (2016). Mobile surface reflectometry. *Computer Graphics Forum*, *35*, 191–202. https://doi.org/10.1111/cgf.12719 `[G40]`
- Robertson, M. A., Borman, S., & Stevenson, R. L. (2003). Estimation-theoretic approach to dynamic range enhancement using multiple exposures. *Journal of Electronic Imaging*, *12*(2), 219–228. https://doi.org/10.1117/1.1557695 `[V20]`
- Royer, M. P. (2019). Analysis of color rendition specification criteria. *Proceedings of SPIE*. https://www.energy.gov/cmei/ssl/articles/analysis-color-rendition-specification-criteria `[N19]`
- Rusinkiewicz, S. (1998). A new change of variables for efficient BRDF representation. *Rendering Techniques ’98*. https://doi.org/10.1007/978-3-7091-6453-2_2 `[T16]`
- *S. Westin et al., cornell three-axis gonioreflectometer, SPIE 5878-29*. (n.d.). https://www.graphics.cornell.edu/~westin/SPIE_5878-29_Gonio.pdf `[R11]`
- Saha, D., Gevaux, L., Frisvad, J. R., & Obein, G. (2024). Bidirectional reflectance measurements over a micrometric surface area using a goniospectrophotometer. *Review of Scientific Instruments*, *95*(5), 055114. https://doi.org/10.1063/5.0193490 `[G31]`
- Salazar-Vazquez, J., & Mendez-Vazquez, A. (2020). A plug-and-play hyperspectral imaging sensor using low-cost equipment. *HardwareX*. https://doi.org/10.1016/j.ohx.2019.e00087 `[H40]`
- Santo, H., Waechter, M., & Matsushita, Y. (2020). Deep near-light photometric stereo for spatially varying reflectances. *European Conference on Computer Vision*. https://doi.org/10.1007/978-3-030-58598-3_9 `[V32]`
- Schlick, C. (1994). An inexpensive BRDF model for physically-based rendering. *Computer Graphics Forum*, *13*(3). `[R7]`
- Schneidereit, D., Kraus, L., Meier, J. C., Friedrich, O., & Gilbert, D. F. (2017). Step-by-step guide to building an inexpensive 3D printed motorized positioning stage for automated high-content screening microscopy. *Biosensors and Bioelectronics*, *92*, 472–481. https://doi.org/10.1016/j.bios.2016.10.078 `[H38]`
- Schnieders, D., & Wong, K.-Y. K. (2013). Camera and light calibration from reflections on a sphere. *Computer Vision and Image Understanding*. https://www.sciencedirect.com/science/article/abs/pii/S1077314213001082 `[S13]`
- Schönberger, J. L., & Frahm, J.-M. (2016). *Structure-from-motion revisited*. https://doi.org/10.1007/978-3-319-46487-9_31 `[S3]`
- Schöps, T., Larsson, V., Pollefeys, M., & Sattler, T. (2020). Why having 10,000 parameters in your camera model is better than twelve. *Proceedings of the IEEE Conference on Computer Vision and Pattern Recognition*. https://openaccess.thecvf.com/content_CVPR_2020/html/Schops_Why_Having_10000_Parameters_in_Your_Camera_Model_Is_Better_CVPR_2020_paper.html `[V6]`
- Schwartz, C., Sarlette, R., Weinmann, M., & Klein, R. (2013). DOME II: A parallelized BTF acquisition system. *Eurographics Workshop on Material Appearance Modeling*. https://doi.org/10.2312/MAM.MAM2013.025-031 `[G50]`
- Schwartz, C., Sarlette, R., Weinmann, M., Rump, M., & Klein, R. (2014). Design and implementation of practical bidirectional texture function measurement devices focusing on the developments at the university of Bonn. *Sensors*, *14*(5), 7753–7819. https://doi.org/10.3390/s140507753 `[G49]`
- Shah, M. (2013). Solving the robot-world/hand-eye calibration problem using the Kronecker product. *Journal of Mechanisms and Robotics*, *5*(3), 031007. https://doi.org/10.1115/1.4024473 `[V15]`
- Sharp Corporation. (2018). *PC817XxNSZ1B series*. https://global.sharp/products/device/lineup/data/pdf/datasheet/PC817XxNSZ1B_e.pdf `[H9]`
- Shi, B. et al. (2016). A benchmark dataset and evaluation for non-Lambertian and uncalibrated photometric stereo. *Proceedings of the IEEE Conference on Computer Vision and Pattern Recognition*. https://openaccess.thecvf.com/content_cvpr_2016/html/Shi_A_Benchmark_Dataset_CVPR_2016_paper.html `[V28]`
- Shrestha, R., & Hardeberg, J. Y. (2013). Multispectral imaging using LED illumination and an RGB camera. *Color and Imaging Conference*, *21*(1), 8–13. https://doi.org/10.2352/CIC.2013.21.1.art00003 `[N38]`
- Shrestha, R., & Hardeberg, J. Y. (2014a). Evaluation and comparison of multispectral imaging systems. *Color and Imaging Conference*, *22*(1). https://doi.org/10.2352/CIC.2014.22.1.art00018 `[N39]`
- Shrestha, R., & Hardeberg, J. Y. (2014b). How are LED illumination based multispectral imaging systems influenced by different factors? *ICISP 2014*, *61*, 61–71. https://doi.org/10.1007/978-3-319-07998-1_8 `[N40]`
- Smith, B. G. (1967). Geometrical shadowing of a random rough surface. *IEEE Transactions on Antennas and Propagation*, *15*(5), 668–671. https://ui.adsabs.harvard.edu/abs/1967ITAP...15..668S/abstract `[T12]`
- Smits, B. (1999). An RGB-to-spectrum conversion for reflectances. *Journal of Graphics Tools*, *4*(4), 11–22. https://doi.org/10.1080/10867651.1999.10487511 `[T52]`
- Snavely, N., Seitz, S. M., & Szeliski, R. (2006). Photo tourism: Exploring photo collections in 3D. *ACM Transactions on Graphics*, *25*(3), 835–846. https://doi.org/10.1145/1141911.1141964 `[V37]`
- Sole, A. (2019). *Image-based bidirectional reflectance measurement of non-diffuse and gonio-chromatic materials*. PhD thesis. https://www.ntnu.edu/colourlab/phd-theses `[G20]`
- Sole, A., Farup, I., Nussbaum, P., & Tominaga, S. (2018). Evaluating an image-based bidirectional reflectance distribution function measurement setup. *Applied Optics*, *57*(8), 1918–1928. https://doi.org/10.1364/AO.57.001918 `[G19]`
- Sole, A., Gigilashvili, D., Midtfjord, H., Guarnera, D., Guarnera, G. C., Thomas, J.-B., & Hardeberg, J. Y. (2019). On the acquisition and reproduction of material appearance. *CCIW 2019*, *11418*, 26–38. https://doi.org/10.1007/978-3-030-13940-7_3 `[G36]`
- Sony Semiconductor Solutions. (2018). *IMX477-AACK: Diagonal 7.857 mm (type 1/2.3) 12.3 mega-pixel CMOS image sensor*. https://www.sony-semicon.com/files/62/pdf/p-13_IMX477-AACK_Flyer.pdf `[H13]`
- Springsteen, A. (1998a). Reflectance spectroscopy: An overview of classification and techniques. In *Applied spectroscopy: A compact reference for practitioners* (pp. 193–224). Academic Press. https://doi.org/10.1016/B978-012764070-9/50008-1 `[N35]`
- Springsteen, A. (1998b). Standards for reflectance measurements. In *Applied spectroscopy: A compact reference for practitioners* (pp. 247–267). Academic Press. https://doi.org/10.1016/B978-012764070-9/50010-X `[N36]`
- *Stanford spherical gantry*. (n.d.). https://graphics.stanford.edu/projects/gantry/ `[R3]`
- *Stanford spherical gantry specifications*. (n.d.). https://graphics.stanford.edu/projects/gantry/design/specifications.html `[R4]`
- Szeliski, R. (1993). Rapid octree construction from image sequences. *CVGIP: Image Understanding*, *58*(1). https://www.sciencedirect.com/science/article/abs/pii/S1049966083710296 `[S6]`
- Szeliski, R. (2022). *Computer vision: Algorithms and applications* (2nd ed.). https://doi.org/10.1007/978-3-030-34372-9 `[V9]`
- Sztrajman, A., Rainer, G., Ritschel, T., & Weyrich, T. (2021). Neural BRDF representation and importance sampling. *Computer Graphics Forum*, *40*. https://doi.org/10.1111/cgf.14335 `[T29]`
- Tabb, A., & Ahmad Yousef, K. M. (2017). Solving the robot-world hand-eye(s) calibration problem with iterative methods. *Machine Vision and Applications*. https://doi.org/10.1007/s00138-017-0841-7 `[V16]`
- Taubin, G. (1995). A signal processing approach to fair surface design. *SIGGRAPH*. `[T56]`
- Texas Instruments. (2025). *ULN200x, ULQ200x high-voltage, high-current darlington transistor arrays*. https://www.ti.com/lit/gpn/ULN2003A `[H10]`
- Torrance, K. E., & Sparrow, E. M. (1967). Theory for off-specular reflection from roughened surfaces. *Journal of the Optical Society of America*, *57*(9), 1105–1114. https://doi.org/10.1364/JOSA.57.001105 `[T10]`
- Toschke, Y., Klenen, J., & Imlau, M. (2024). Open photonics: An integrated approach for building a 3D-printed motorized rotation stage system. *HardwareX*, *20*, e00577. https://doi.org/10.1016/j.ohx.2024.e00577 `[H37]`
- Trowbridge, T. S., & Reitz, K. P. (1975). Average irregularity representation of a rough surface for ray reflection. *Journal of the Optical Society of America*, *65*(5), 531–536. https://doi.org/10.1364/JOSA.65.000531 `[T11]`
- Tsai, R. Y. (1987). A versatile camera calibration technique for high-accuracy 3D machine vision metrology using off-the-shelf TV cameras and lenses. *IEEE Journal of Robotics and Automation*, *3*(4), 323–344. https://doi.org/10.1109/JRA.1987.1087109 `[V2]`
- Tsai, R. Y., & Lenz, R. K. (1989). A new technique for fully autonomous and efficient 3D robotics hand/eye calibration. *IEEE Transactions on Robotics and Automation*, *5*(3), 345–358. https://doi.org/10.1109/70.34770 `[V10]`
- Turquin, E. (2019). *Practical multiple scattering compensation for microfacet models*. https://blog.selfshadow.com/publications/turquin/ms_comp_final.pdf `[T22]`
- *Unity, HDRP "lit shader"*. (n.d.). https://docs.unity3d.com/Packages/com.unity.render-pipelines.high-definition@14.0/manual/Lit-Shader.html `[T47]`
- USB Implementers Forum. (2012). *Video class v1.5 document set*. https://www.usb.org/document-library/video-class-v15-document-set `[H14]`
- *Usbipd-win*. (n.d.). https://github.com/dorssel/usbipd-win `[H54]`
- *UTIA BTF database*. (n.d.). https://btf.utia.cas.cz/?faq= `[R18]`
- Vávra, R., & Filip, J. (2016). Minimal sampling for effective acquisition of anisotropic BRDFs. *Computer Graphics Forum*, *35*(7), 299–309. https://www.pbr-book.org/4ed/Reflection_Models/Further_Reading `[G47]`
- Vávra, R., & Filip, J. (2018). Adaptive slices for acquisition of anisotropic BRDF. *Computational Visual Media*, *4*(1), 55–69. https://doi.org/10.1007/s41095-017-0099-z `[G48]`
- Veach, E. (1997). *Robust Monte Carlo methods for light transport simulation*. https://graphics.stanford.edu/papers/veach_thesis/thesis-bw.pdf `[T3]`
- Virtanen, P., Gommers, R., Oliphant, T. E., et al. (2020). SciPy 1.0: Fundamental algorithms for scientific computing in Python. *Nature Methods*, *17*, 261–272. https://doi.org/10.1038/s41592-019-0686-2 `[H48]`
- Vishay Semiconductors. (n.d.). *TCST2103, TCST2202, TCST2300: Transmissive optical sensor with phototransistor output*. https://www.vishay.com/docs/81147/tcst2103.pdf `[H11]`
- *W. Matusik et al., MERL TR2003-83*. (n.d.). https://www.merl.com/publications/docs/TR2003-83.pdf `[R14]`
- *W3C, portable network graphics (PNG) specification*. (n.d.). https://www.w3.org/TR/png/ `[H60]`
- Waechter, M., Moehrle, N., & Goesele, M. (2014). Let there be color! Large-scale texturing of 3D reconstructions. *European Conference on Computer Vision*. https://doi.org/10.1007/978-3-319-10602-1_54 `[V58]`
- Walter, B., Marschner, S., Li, H., & Torrance, K. (2007). Microfacet models for refraction through rough surfaces. *Eurographics Symposium on Rendering*. `[R6]`
- Walter, M. (2016). How accurate is microstepping really? *Hackaday*, *29*. https://hackaday.com/2016/08/29/how-accurate-is-microstepping-really/ `[H20]`
- Ward, G. J. (1992). Measuring and modeling anisotropic reflection. *ACM SIGGRAPH Computer Graphics*, *26*(2), 265–272. https://doi.org/10.1145/142920.134078 `[G9]`
- Weidner, V. R., & Hsia, J. J. (1981). Reflection properties of pressed polytetrafluoroethylene powder. *Journal of the Optical Society of America*, *71*(7), 856–861. https://doi.org/10.1364/JOSA.71.000856 `[N30]`
- Weidner, V. R., Hsia, J. J., & Adams, B. (1985). Laboratory intercomparison study of pressed polytetrafluoroethylene powder reflectance standards. *Applied Optics*, *24*(14), 2225. https://doi.org/10.1364/AO.24.002225 `[N31]`
- Weinmann, M., & Klein, R. (2015). Advances in geometry and reflectance acquisition (course notes). *SIGGRAPH Asia 2015 Courses*. https://doi.org/10.1145/2818143.2818165 `[G4]`
- Weyrich, T., Lawrence, J., Lensch, H. P. A., Rusinkiewicz, S., & Zickler, T. (2009). Principles of appearance acquisition and representation. *Foundations and Trends in Computer Graphics and Vision*, *4*(2), 75–191. https://doi.org/10.1561/0600000022 `[T4]`
- White, D. R., Saunders, P., Bonsey, S. J., Ven, J. van de, & Edgar, H. (1998). Reflectometer for measuring the bidirectional reflectance of rough surfaces. *Applied Optics*, *37*(16), 3450–3454. https://doi.org/10.1364/AO.37.003450 `[G10]`
- Wilkie, A., Nawaz, S., Droske, M., Weidlich, A., & Hanika, J. (2014). Hero wavelength spectral sampling. *Computer Graphics Forum*, *33*(4), 123–131. https://doi.org/10.1111/cgf.12419 `[T55]`
- Wolff, L. B. (1990). Polarization-based material classification from specular reflection. *IEEE Transactions on Pattern Analysis and Machine Intelligence*, *12*(11), 1059–1071. https://doi.org/10.1109/34.61705 `[V52]`
- Woodham, R. J. (1980). Photometric method for determining surface orientation from multiple images. *Optical Engineering*, *19*(1). https://doi.org/10.1117/12.7972479 `[S4]`
- Wyszecki, G., & Stiles, W. S. (1982). *Color science: Concepts and methods, quantitative data and formulae* (2nd ed.). https://doi.org/10.1002/col.5080080421 `[N21]`
- *Xatlas, mesh parameterization / UV unwrapping library*. (n.d.). https://github.com/jpcy/xatlas `[V57]`
- *X-rite PANTORA*. (n.d.). https://www.xrite.com/pantora-software `[R40]`
- *X-rite TAC7*. (n.d.). https://www.xrite.com/categories/appearance/tac7 `[R19]`
- *X-rite TAC7 user guide*. (n.d.). https://www.xrite.com/-/media/xrite/files/manuals_and_userguides/t/tac7_user_guide_en.pdf `[R39]`
- Yu, Chen, & Da. (2025). Geometric calibration for photometric stereo under near-field point light sources using spheres. *Optics & Laser Technology*, *180*. https://www.sciencedirect.com/science/article/pii/S0030399224010156 `[S14]`
- Zaber Technologies. (n.d.). *Microstepping tutorial*. https://www.zaber.com/technical-articles/microstepping-tutorial `[H22]`
- Zhang, Z. (2000). A flexible new technique for camera calibration. *IEEE Transactions on Pattern Analysis and Machine Intelligence*, *22*(11), 1330–1334. https://doi.org/10.1109/34.888718 `[V1]`
- Zhou, Q.-Y., Park, J., & Koltun, V. (2018). *Open3D: A modern library for 3D data processing*. https://arxiv.org/abs/1801.09847 `[V47]`
- Zhuang, H., Roth, Z. S., & Sudhakar, R. (1994). Simultaneous robot/world and tool/flange calibration by solving homogeneous transformation equations of the form AX=YB. *IEEE Transactions on Robotics and Automation*, *10*(4), 549–554. https://doi.org/10.1109/70.313105 `[V13]`
- Zou, Y., Zhang, L., Zhang, J., Li, B., & Lv, X. (2022). Developmental trends in the application and measurement of the bidirectional reflection distribution function. *Sensors*, *22*(5), 1739. https://doi.org/10.3390/s22051739 `[G6]`
