Normansrule/Gonioreflectometer-Open-Source/wiki/Home.md

<!-- generated from wiki/src/Home.md by tools/refs_bib.py - edit the source -->

# OpenGonio wiki

Open-source four-axis gonioreflectometer and 3D scanner. It measures the bidirectional reflectance distribution function (BRDF) of flat samples and scans objects in 3D. Design follows Ansari-Asl et al. (2024), rebuilt for under \$630 in parts, with no soldering, drilling, sawing or crimping.

New here? The **project map** on the website (`docs/explore/`) shows the whole project as a clickable map with a guided tour in plain words. Inside (`docs/inside.html`) opens up the software, tests, firmware, wiring and roadmap, and the control app (`docs/app/`) runs in the browser on the simulated machine.

| Page | Contents |
|---|---|
| [How it works](How-it-works.md) | BRDF, geometry, the four axes, one measurement |
| [Machine](Machine.md) · [Hardware](Hardware.md) | axes, subsystems, cost |
| [Tools and joins](Tools-and-joins.md) · [CAD](CAD.md) | joins without tools; 3D files, Onshape |
| [Calibration](Calibration.md) | angles, camera response, absolute reflectance, drift |
| [3D scanning](3D-scanning.md) | fixed camera, visual hull, photogrammetry, photometric stereo |
| [Software](Software.md) · [Commands](Commands.md) | `opengonio`, simulator, every command |
| [Build guide](Build-guide.md) · [Theory](Theory.md) | how steps work; all equations |
| [Test materials](Test-materials.md) · [Extend](Extend.md) · [Repository map](Repository-map.md) | samples; changing the design; where files are |
| [Paper](Paper.md) | manuscript for *HardwareX*, build, status |
| [Bibliography](Bibliography.md) | every scholarly source, APA 7 |
| Appendices [A](Appendix-A-Measurement.md) · [B](Appendix-B-Reflectance-models.md) · [C](Appendix-C-Calibration-and-3D.md) · [D](Appendix-D-Standards-and-colour.md) · [E](Appendix-E-Hardware.md) | background papers by topic, with what each is used for |

Build guide, bill of materials and commands: [README](https://github.com/Normansrule/Gonioreflectometer-Open-Source/blob/main/README.md). Step checklists: [phases](https://github.com/Normansrule/Gonioreflectometer-Open-Source/blob/main/phases).

## References

Ansari-Asl, M., Barbieri, M., Obein, G., & Hardeberg, J. Y. (2024). Optical and electromechanical design and implementation of an advanced multispectral device to capture material appearance. *Journal of Imaging*, *10*(3), 55. <https://doi.org/10.3390/jimaging10030055>
