Normansrule/Gonioreflectometer-Open-Source/wiki/Appendix-D-Standards-and-colour.md

# Appendix D · Standards, colour, optics, safety

<!-- generated by tools/refs_bib.py from REFERENCES.md - edit that file, then `make build` -->

Background papers and sources, by topic. Format: APA reference — *what this project uses it for*. Full list: [Bibliography](Bibliography.md).

## Appearance and scatter measurement standards (ASTM)

- ASTM International. (2019). *Standard practice for goniometric optical scatter measurements*. https://store.astm.org/e2387-19.html — *BRDF/BTDF measurement practice (phases 07, 08)* `[N1]`
- ASTM International. (2003). *Standard practice for angle resolved optical scatter measurements on specular or diffuse surfaces*. https://www.astm.org/DATABASE.CART/WITHDRAWN/E1392.htm — *Historical BRDF practice cited by Labsphere (phase 07)* `[N2]`
- ASTM International. (2005). *Standard practice for goniophotometry of objects and materials*. https://store.astm.org/e0167-96.html — *Goniophotometer geometry conventions (phase 06)* `[N3]`
- ASTM International. (n.d.). *Standard test method for specular gloss*. https://store.astm.org/standards/d523 — *20/60/85° gloss cross-check (phase 07)* `[N4]`
- ASTM International. (2023b). *Standard test methods for measurement of gloss of high-gloss surfaces by abridged goniophotometry*. https://store.astm.org/standards/e430 — *Haze/distinctness-of-image near specular (phases 08, 17)* `[N5]`
- ASTM International. (2025a). *Standard terminology of appearance*. https://doi.org/10.1520/E0284-25 — *Docs glossary terms (phase 00)* `[N6]`
- ASTM International. (2026). *Standard practice for specifying the geometry of multiangle spectrophotometers*. https://store.astm.org/standards/e2175 — *Reporting light/camera angle geometry (phase 08)* `[N7]`
- ASTM International. (2025b). *Standard test method for multiangle color measurement of metal flake pigmented materials*. https://doi.org/10.1520/E2194-14R25 — *Aspecular angles for metallic samples (phases 08, 09)* `[N8]`
- ASTM International. (2023a). *Standard practice for obtaining spectrometric data for object-color evaluation*. https://store.astm.org/standards/e1164 — *Spectral data and calibration practice (phase 10)* `[N9]`
- *ISO, "paints and varnishes*. (n.d.). https://www.iso.org/standard/56807.html — *Gloss reference geometry (phase 07)* `[N10]`
- Nadal, M. E., & Thompson, E. A. (2001). NIST reference goniophotometer for specular gloss measurements. *Journal of Coatings Technology*, *73*(917), 73–80. https://www.paint.org/wp-content/uploads/2021/09/jctJUNE01-Nadal.pdf — *Reference-instrument design and uncertainty (phases 06, 17)* `[N11]`

## CIE colorimetry, appearance and colour rendering

- CIE. (2006). *A framework for the measurement of visual appearance*. https://cie.co.at/publications/framework-measurement-visual-appearance — *Colour/gloss/translucency/texture scope (phase 00)* `[N12]`
- CIE. (2018). *Colorimetry, 4th edition*. https://doi.org/10.25039/TR.015.2018 — *XYZ, CIELAB, illuminants from spectra (phase 10)* `[N13]`
- CIE. (2020). *ILV: International lighting vocabulary, 2nd edition*. https://doi.org/10.25039/S017.2020 — *Radiometric/photometric terminology (phase 00)* `[N14]`
- CIE. (1995). *Method of measuring and specifying colour rendering properties of light sources*. https://cie.co.at/publications/method-measuring-and-specifying-colour-rendering-properties-light-sources — *COB CRI (Ra) meaning (phases 04, 10)* `[N15]`
- CIE. (2017). *CIE 2017 colour fidelity index for accurate scientific use*. https://doi.org/10.25039/TR.224.2017 — *Rf for white and LED-bank spectra (phase 10)* `[N16]`
- *K. A. G. Smet, CRI_CIE_rf_2017 calculator (MATLAB/excel)*. (n.d.). https://github.com/ksmet1977/CRI_CIE_Rf_2017 — *Checking our Rf implementation (phase 10)* `[N17]`
- IES. (n.d.). *Technical memorandum: IES method for evaluating light source color rendition*. https://store.ies.org/product/technical-memorandum-ies-method-for-evaluating-light-source-color-rendition/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 — *Rf/Rg report for light sources (phase 10)* `[N18]`
- Royer, M. P. (2019). Analysis of color rendition specification criteria. *Proceedings of SPIE*. https://www.energy.gov/cmei/ssl/articles/analysis-color-rendition-specification-criteria — *Choosing Rf/Rg acceptance thresholds (phase 10)* `[N19]`
- Ohno, Y. (2005). Spectral design considerations for white LED color rendering. *Optical Engineering*, *44*(11). https://doi.org/10.1117/1.2130694 — *Designing the 8-band LED spectrum (phase 10)* `[N20]`

## Colour science books

- Wyszecki, G., & Stiles, W. S. (1982). *Color science: Concepts and methods, quantitative data and formulae* (2nd ed.). https://doi.org/10.1002/col.5080080421 — *Colorimetric data and formulae (phase 10)* `[N21]`
- Fairchild, M. D. (2013). *Color appearance models* (3rd ed.). https://doi.org/10.1002/9781118653128 — *Appearance/white point for renders (phases 10, 13)* `[N22]`
- Hunt, R. W. G., & Pointer, M. R. (2011). *Measuring colour* (4th ed.). https://doi.org/10.1002/9781119975595 — *Practical colour measurement geometry (phase 10)* `[N23]`

## Camera characterization and colour encoding

- EMVA. (2021). *Standard 1288: Standard for characterization of image sensors and cameras*. https://www.emva.org/standards-technology/emva-1288/ — *IMX477 linearity, noise, dark current tests (phases 06, 07)* `[N24]`
- *ISO, "photography*. (n.d.-a). https://www.iso.org/standard/79169.html — *Slanted-edge SFR of 16 mm lens (phase 06)* `[N25]`
- *ISO, "photography*. (n.d.-b). https://www.iso.org/standard/82233.html — *Noise and dynamic range for HDR (phase 07)* `[N26]`
- *ISO, "graphic technology and photography*. (n.d.). https://www.iso.org/standard/35835.html — *Camera spectral sensitivity/colour matrix (phase 10)* `[N27]`
- *IEC, "multimedia systems and equipment*. (n.d.). https://webstore.ansi.org/standards/iec/iec61966ed1999 — *sRGB transfer function for texture export (phases 07, 13)* `[N28]`
- *M. Stokes, M. Anderson, S. Chandrasekar, R. Motta, "a standard default color space for the internet*. (n.d.). https://www.w3.org/Graphics/Color/sRGB.html — *Linear vs gamma-encoded texture handling (phase 13)* `[N29]`

## Reflectance standards (PTFE / Spectralon)

- Weidner, V. R., & Hsia, J. J. (1981). Reflection properties of pressed polytetrafluoroethylene powder. *Journal of the Optical Society of America*, *71*(7), 856–861. https://doi.org/10.1364/JOSA.71.000856 — *PTFE white reference reflectance (phase 07)* `[N30]`
- Weidner, V. R., Hsia, J. J., & Adams, B. (1985). Laboratory intercomparison study of pressed polytetrafluoroethylene powder reflectance standards. *Applied Optics*, *24*(14), 2225. https://doi.org/10.1364/AO.24.002225 — *PTFE reference repeatability (phase 07)* `[N31]`
- Hsia, J. J., & Barnes, P. Y. (1995). *45°/0° reflectance factors of pressed polytetrafluoroethylene (PTFE) powder*. https://doi.org/10.6028/NIST.TN.1413 — *45/0 PTFE factor for our geometry (phase 07)* `[N32]`
- Barnes, P. Y., Early, E. A., & Parr, A. C. (1998b). *Spectral reflectance*. https://doi.org/10.6028/NIST.SP.250-48 — *Traceable reflectance calibration method (phase 07)* `[N33]`
- Labsphere. (n.d.). *Technical guide: Reflectance materials and coatings*. https://www.systems-eng.co.jp/dcms_media/other/Guide_Reflectance_Materials_Coatings.pdf — *Spectralon vs DIY PTFE choice (phase 07)* `[N34]`
- Springsteen, A. (1998a). Reflectance spectroscopy: An overview of classification and techniques. In *Applied spectroscopy: A compact reference for practitioners* (pp. 193–224). Academic Press. https://doi.org/10.1016/B978-012764070-9/50008-1 — *Reflectance geometry nomenclature (phase 07)* `[N35]`
- Springsteen, A. (1998b). Standards for reflectance measurements. In *Applied spectroscopy: A compact reference for practitioners* (pp. 247–267). Academic Press. https://doi.org/10.1016/B978-012764070-9/50010-X — *Choosing white/grey/black references (phase 07)* `[N36]`

## Multispectral imaging with LED illumination

- Park, J.-I., Lee, M.-H., Grossberg, M. D., & Nayar, S. K. (2007). Multispectral imaging using multiplexed illumination. *Proceedings of the IEEE International Conference on Computer Vision*, 1–8. https://doi.org/10.1109/ICCV.2007.4409090 — *Multiplexed LED band capture (phase 10)* `[N37]`
- Shrestha, R., & Hardeberg, J. Y. (2013). Multispectral imaging using LED illumination and an RGB camera. *Color and Imaging Conference*, *21*(1), 8–13. https://doi.org/10.2352/CIC.2013.21.1.art00003 — *LED bank + RGB camera reflectance (phase 10)* `[N38]`
- Shrestha, R., & Hardeberg, J. Y. (2014a). Evaluation and comparison of multispectral imaging systems. *Color and Imaging Conference*, *22*(1). https://doi.org/10.2352/CIC.2014.22.1.art00018 — *Spectral accuracy metrics (phases 10, 17)* `[N39]`
- Shrestha, R., & Hardeberg, J. Y. (2014b). How are LED illumination based multispectral imaging systems influenced by different factors? *ICISP 2014*, *61*, 61–71. https://doi.org/10.1007/978-3-319-07998-1_8 — *Noise/band-count sensitivity of LED bank (phase 10)* `[N40]`
- Imai, F. H., Berns, R. S., & Tzeng, D.-Y. (2000). A comparative analysis of spectral reflectance estimated in various spaces using a trichromatic camera system. *Journal of Imaging Science and Technology*, *44*(4), 280–287. https://doi.org/10.2352/J.ImagingSci.Technol.2000.44.4.art00003 — *Spectral reconstruction from camera signals (phase 10)* `[N41]`
- Imai, F. H., Rosen, M. R., & Berns, R. S. (2000). Comparison of spectrally narrow-band capture versus wide-band with a priori sample analysis for spectral reflectance estimation. *Color and Imaging Conference*, *8*(1), 234–241. https://doi.org/10.2352/CIC.2000.8.1.art00043 — *Narrow-band LEDs vs filters trade-off (phase 10)* `[N42]`
- Hardeberg, J. Y. (2001). *Acquisition and reproduction of color images: Colorimetric and multispectral approaches*. https://doi.org/10.1002/col.10073 — *Camera colorimetric/spectral calibration (phase 10)* `[N43]`
- Hardeberg, J. Y. (2004). Filter selection for multispectral color image acquisition. *Journal of Imaging Science and Technology*, *48*(2). https://doi.org/10.2352/J.ImagingSci.Technol.2004.48.2.art00005 — *Choosing the 8 LED bands (phase 10)* `[N44]`

## Optics textbooks

- Kingslake, R., & Johnson, R. B. (2010). *Lens design fundamentals* (2nd ed.). https://doi.org/10.1016/B978-0-12-374301-5.00008-5 — *M12 lens f-number/aberration reasoning (phase 06)* `[N45]`
- Goodman, J. W. (2017). *Introduction to Fourier optics* (1st ed.). https://doi.org/10.1063/1.3035549 — *Diffraction limit and MTF at f/8 (phase 06)* `[N46]`

## Photobiological and machine/electrical safety

- IEC. (n.d.). *Photobiological safety of lamps and lamp systems*. https://doi.org/10.3403/30149289 — *COB and LED-bank eye-safety risk groups (phases 04, 10)* `[N47]`
- *ISO, "safety of machinery*. (n.d.-a). https://doi.org/10.3403/30265059 — *E-stop category and reset behaviour (phases 01, 02)* `[N48]`
- *IEC, "safety of machinery*. (n.d.). https://doi.org/10.3403/30238348 — *Power wiring, colours, stop circuit (phase 01)* `[N49]`
- *ISO, "safety of machinery*. (n.d.-b). https://doi.org/10.3403/30201665 — *Pinch-point/hazard risk assessment (phases 00, 16)* `[N50]`
- *IEC, "audio/video, information and communication technology equipment*. (n.d.). https://doi.org/10.3403/30347376U — *Bought-in PSU safety listing (phase 01)* `[N51]`
