Normansrule/Gonioreflectometer-Open-Source/firmware/grblhal/settings.txt

; OpenGonio - grblHAL settings for the BTT SKR Pico V1.0 (generated by tools/grblhal_settings.py: edit
; machine.yaml or the tool, then `make build`). Send with: bash scripts/controller.sh settings
; Lines starting with ';' are comments. Setting numbers: grblHAL core + Trinamic plugin [R83][R84].

$1=255    ; step idle delay: 255 = motors stay energised between poses (hold torque)
$5=0    ; limit inputs not inverted (optical endstop low = triggered); set the axis bit if `?` shows Pn while clear
$10=17    ; status report: machine position (1) + pin state Pn (16), as the software parses
$20=1    ; soft limits on (needs homing)
$21=0    ; hard limits off: one switch per axis, at the home end; the J3 over-travel switch cuts motor power
$22=15    ; homing: enable (1) + single-axis $HX (2) + Alarm until homed (4) + 0 at the switch (8)
$23=15    ; home every axis in the negative direction (switches at the range minimum)
$24=30    ; homing locate rate, deg/min
$25=300    ; homing search rate, deg/min
$26=250    ; homing debounce, ms
$27=2    ; homing pull-off, deg
$62=1    ; sleep enable: `$SLP` = opengonio sleep (leave with a reset, then re-home)
$44=1    ; homing cycle 1: X only ($H homes one axis at a time)
$45=2    ; homing cycle 2: Y only ($H homes one axis at a time)
$46=4    ; homing cycle 3: Z only ($H homes one axis at a time)
$47=8    ; homing cycle 4: A only ($H homes one axis at a time)
$100=213.333    ; X = M4 light_arm: steps per degree (gear 24, 1/16)
$110=900    ; X max rate, deg/min
$120=30    ; X acceleration, deg/s^2
$130=304    ; X travel, deg (20 to 324)
$140=800    ; X motor current, mA RMS (SKR Pico: add the fan above 800 mA)
$150=16    ; X microsteps
$210=50    ; X hold current, % of run current
$101=44.444    ; Y = M3 table_yaw: steps per degree (gear 5, 1/16)
$111=1800    ; Y max rate, deg/min
$121=60    ; Y acceleration, deg/s^2
$131=360    ; Y travel, deg (-180 to 180)
$141=800    ; Y motor current, mA RMS (SKR Pico: add the fan above 800 mA)
$151=16    ; Y microsteps
$211=50    ; Y hold current, % of run current
$102=44.444    ; Z = M2 sample_tilt: steps per degree (gear 5, 1/16)
$112=900    ; Z max rate, deg/min
$122=40    ; Z acceleration, deg/s^2
$132=180    ; Z travel, deg (-90 to 90)
$142=800    ; Z motor current, mA RMS (SKR Pico: add the fan above 800 mA)
$152=16    ; Z microsteps
$212=50    ; Z hold current, % of run current
$103=35.556    ; A = M1 sample_spin: steps per degree (gear 1, 1/64)
$113=1800    ; A max rate, deg/min
$123=60    ; A acceleration, deg/s^2
$133=360    ; A travel, deg (-180 to 180)
$143=700    ; A motor current, mA RMS (SKR Pico: add the fan above 800 mA)
$153=64    ; A microsteps
$213=50    ; A hold current, % of run current
