Normansrule/Gonioreflectometer-Open-Source/paper/generated/specs.tex

% generated by tools/paper_assets.py
\begin{tabularx}{\linewidth}{|l|X|}\hline
Hardware name & Open Source Gonioreflectometer \\ \hline
Subject area & Engineering and materials science; computer graphics (material appearance) \\ \hline
Hardware type & Measuring physical properties and in-lab sensors; imaging tools \\ \hline
Closest commercial analog & Laboratory gonioreflectometers and goniospectrophotometers \\ \hline
Open source license & Hardware CERN-OHL-S-2.0; software GPL-3.0-or-later; documentation CC BY-SA 4.0 \\ \hline
Cost of hardware & US\$511.60 in parts (cap US\$630); tools US\$469.76 \\ \hline
Source file repository & \url{https://github.com/Normansrule/Gonioreflectometer-Open-Source} (DOI at release) \\ \hline
\end{tabularx}
