Normansrule/Gonioreflectometer-Open-Source/exports/wiki/opengonio-wiki.docx

# OpenGonio wiki

Explanations, bibliography (APA 7) and background appendices

# OpenGonio wiki

Open-source four-axis gonioreflectometer and 3D scanner. It measures the bidirectional reflectance distribution function (BRDF) of flat samples and scans objects in 3D. Design follows Ansari-Asl et al. (2024), rebuilt for under $630 in parts, with no soldering, drilling, sawing or crimping.

New here? The project map on the website (docs/explore/) shows the whole project as a clickable map with a guided tour in plain words. Inside (docs/inside.html) opens up the software, tests, firmware, wiring and roadmap, and the control app (docs/app/) runs in the browser on the simulated machine.

Page | Contents
How it works | BRDF, geometry, the four axes, one measurement
Machine · Hardware | axes, subsystems, cost
Tools and joins · CAD | joins without tools; 3D files, Onshape
Calibration | angles, camera response, absolute reflectance, drift
3D scanning | fixed camera, visual hull, photogrammetry, photometric stereo
Software · Commands | opengonio, simulator, every command
Build guide · Theory | how steps work; all equations
Test materials · Extend · Repository map | samples; changing the design; where files are
Paper | manuscript for HardwareX, build, status
Bibliography | every scholarly source, APA 7
Appendices A · B · C · D · E | background papers by topic, with what each is used for

Build guide, bill of materials and commands: README (https://github.com/Normansrule/Gonioreflectometer-Open-Source/blob/main/README.md). Step checklists: phases (https://github.com/Normansrule/Gonioreflectometer-Open-Source/blob/main/phases).

## References

Ansari-Asl, M., Barbieri, M., Obein, G., & Hardeberg, J. Y. (2024). Optical and electromechanical design and implementation of an advanced multispectral device to capture material appearance. Journal of Imaging, 10(3), 55. https://doi.org/10.3390/jimaging10030055

# How it works

## What is measured

The BRDF f_r is reflected radiance per unit incident irradiance, for one incoming and one outgoing direction (Hanrahan, 2016; Nicodemus et al., 1977):

f_r (ω_i →ω_r )=(dL_r (ω_i →ω_r ))/(dE_i) [sr^(−1) ]

Isotropic materials need 3 angles; anisotropic ones (brushed metal, satin) need 4 (Ward, 1992).

## Geometry

One zero point; every axis turns about it.

Axis | Moves | Range
M4 | light arm around the sample | 20–324°
M3 | table (sample yaw) | ±180°
M2 | sample tilt | ±90°
M1 | sample spin | ±180°

- Measuring camera fixed at 350 mm; light 300 mm from the zero point.
- Light on a horizontal ring: M3 and M2 already turn the sample to every direction an overhead light could reach, so the arm stays low, stiff and out of the light path (Ansari-Asl et al., 2024).
- In-plane, the mirror peak sits at M3 = M4 / 2.
- Light within 20° of the camera is out of reach: pure back-scatter is not measured.

## One measurement

1. Move to a pose (inverse kinematics from θ_i ,θ_r ,Δφ ).
2. Capture at fixed exposure; several exposures for high dynamic range (HDR) (Debevec & Malik, 1997).
3. Subtract dark frame, linearise, divide by the white reference (Calibration).
4. Fit Lambert + GGX microfacet model (Trowbridge & Reitz, 1975; Walter et al., 2007) → game-engine material.

Full equations: Theory.

## References

Ansari-Asl, M., Barbieri, M., Obein, G., & Hardeberg, J. Y. (2024). Optical and electromechanical design and implementation of an advanced multispectral device to capture material appearance. Journal of Imaging, 10(3), 55. https://doi.org/10.3390/jimaging10030055

Debevec, P., & Malik, J. (1997). Recovering high dynamic range radiance maps from photographs. Proc. SIGGRAPH ’97. https://pauldebevec.com/Research/HDR/debevec-siggraph97.pdf

Hanrahan, P. (2016). Reflection models I: Ideal materials.

Nicodemus, F. E., Richmond, J. C., Hsia, J. J., Ginsberg, I. W., & Limperis, T. (1977). Geometrical considerations and nomenclature for reflectance. NBS Monograph, 160. https://doi.org/10.6028/NBS.MONO.160

Trowbridge, T. S., & Reitz, K. P. (1975). Average irregularity representation of a rough surface for ray reflection. Journal of the Optical Society of America, 65(5), 531–536. https://doi.org/10.1364/JOSA.65.000531

Walter, B., Marschner, S., Li, H., & Torrance, K. (2007). Microfacet models for refraction through rough surfaces. Eurographics Symposium on Rendering.

Ward, G. J. (1992). Measuring and modeling anisotropic reflection. ACM SIGGRAPH Computer Graphics, 26(2), 265–272. https://doi.org/10.1145/142920.134078

# The machine

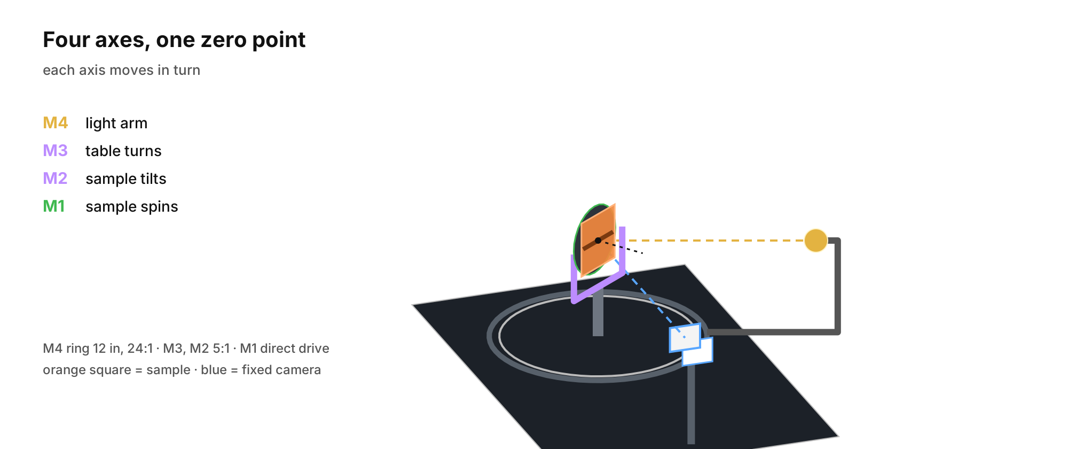
[picture p16: figure]

Four axes, one zero point

Axis | Moves | Range | Drive | Step (1/16) | Built in
M4 | light arm around the sample | 20–324° | GT2 belt on 12 in ring, 24:1 | 0.0047° | stage 04
M3 | table (sample yaw) | ±180° | 20T → 100T, 5:1 | 0.0225° | stage 05
M2 | sample tilt (yoke) | ±90° | 20T → 100T, 5:1 | 0.0225° | stage 08
M1 | sample spin (platter) | ±180° | direct drive (pancake motor), 1/64 microstep | 0.028° | stage 09

Measuring camera fixed on +X at 350 mm; scan camera fixed at 650 mm, 15° up, looking over it, so no camera ever moves or refocuses (one-camera option: move it, $81 cheaper). Light 300 mm from the zero point. Optical homing on every axis, one over-travel switch in the e-stop loop (light arm, at 17°; the other ends rely on soft limits and the e-stop), 30 mm keep-out and 5° minimum light–camera angle (Ansari-Asl et al., 2024).

Why the light is on a side ring. Reflectance depends only on the light and camera directions relative to the sample, and the table (M3) and tilt (M2) already turn the sample to every direction an overhead light could reach. A horizontal ring keeps the arm’s weight on the bearing (the motor only moves it), stays low and stiff, and keeps cables out of the light path. A light on the camera axis (coaxial, via a beam splitter) sees only back-scatter, not the mirror peak, and loses ~75 % of the light in the splitter; it stays a possible later add-on for retroreflective materials.

### Two sensors, two jobs

| Camera (IMX477, fixed, 350 mm) | Spectral sensor (AS7341, above the camera)
Measures | images: brightness per pixel, 3 colours | 8 visible bands 415–680 nm + clear + NIR (10 readings), one spot
Used for | angles (mirror test), textures (SVBRDF), 3D scan, calibration | colour spectrum vs angle (spectral BRDF)
Command | opengonio capture … | opengonio capture … --spectral (or --no-camera)
Stage | 06 | 10 (optional, +$17)

## References

Ansari-Asl, M., Barbieri, M., Obein, G., & Hardeberg, J. Y. (2024). Optical and electromechanical design and implementation of an advanced multispectral device to capture material appearance. Journal of Imaging, 10(3), 55. https://doi.org/10.3390/jimaging10030055

# Hardware

Every electrical connection, pin by pin (power, SKR Pico, ESP32-S3 header, lamp, USB; step by step in the wiring guide (https://github.com/Normansrule/Gonioreflectometer-Open-Source/blob/main/docs/wiring.html)): README → Wiring (https://github.com/Normansrule/Gonioreflectometer-Open-Source/blob/main/README.md#wiring).

Subsystem | Parts | Stage
Power | 24 V 3 A wall adapter with a screw-terminal jack, latching e-stop in its own box, pre-wired limit switch, lever connectors | 01 (https://github.com/Normansrule/Gonioreflectometer-Open-Source/blob/main/phases/01-power)
Controller | BTT SKR Pico (grblHAL, USB-C) + ESP32-S3 hub, keypads | 02 (https://github.com/Normansrule/Gonioreflectometer-Open-Source/blob/main/phases/02-controller)
Frame | printed 600 × 600 mm deck (9 tiles), printed 20 × 20 bars, M2 screws | 03 (https://github.com/Normansrule/Gonioreflectometer-Open-Source/blob/main/phases/03-frame)
Light arm (M4) | 12 in lazy Susan, GT2 belt rim, 24:1 | 04 (https://github.com/Normansrule/Gonioreflectometer-Open-Source/blob/main/phases/04-light-arm)
Table (M3), tilt (M2), spin (M1) | NEMA 17 steppers, 5:1 belts, M8 bolt axles, direct-drive spin | 05 (https://github.com/Normansrule/Gonioreflectometer-Open-Source/blob/main/phases/05-table) · 08 (https://github.com/Normansrule/Gonioreflectometer-Open-Source/blob/main/phases/08-tilt) · 09 (https://github.com/Normansrule/Gonioreflectometer-Open-Source/blob/main/phases/09-spin)
Camera | 12 MP IMX477 USB, 16 mm M12 lens, printed f/8 stop | 06 (https://github.com/Normansrule/Gonioreflectometer-Open-Source/blob/main/phases/06-camera-light)
Light | Citizen CLU701 COB, colour rendering index (CRI) ≥ 90, 2700 K, in a solderless TE holder, 350 mA wire-lead driver, pin-fin heatsink | 06 (https://github.com/Normansrule/Gonioreflectometer-Open-Source/blob/main/phases/06-camera-light)

- No tools beyond a kit: lever connectors, screw terminals, modules instead of loose chips, M2 screws self-tapping into printed pilots.
- One screw size: M2 everywhere; M3 only into the motors, M8 bolts as axles.
- Printed parts: black ABS (acrylonitrile butadiene styrene) on an enclosed printer; ≈ 2.7 kg, half of it the deck.
- Circuit board (future): a carrier board that replaces the modules and jumpers: pcb/ (https://github.com/Normansrule/Gonioreflectometer-Open-Source/blob/main/pcb/README.md).
- Optical homing on every axis; one over-travel switch in the e-stop loop (light arm, at 17°; the other ends rely on soft limits and the e-stop).
- Cost: see the bill of materials (https://github.com/Normansrule/Gonioreflectometer-Open-Source/blob/main/README.md#electronics) (pictures, buy links, STEP/STL downloads).

Open-hardware practice (Open Source Hardware Association, n.d.; Pearce, 2012): Appendix E.

## References

Open Source Hardware Association. (n.d.). Open source hardware (OSHW) definition 1.0. Retrieved https://oshwa.org/definition/

Pearce, J. M. (2012). Building research equipment with free, open-source hardware. Science, 337(6100), 1303–1304. https://doi.org/10.1126/science.1228183

# Tools and joins

Nothing is assumed owned except a laptop: the tools are rows TLS-01–TLS-10 with prices, a separate total from the machine’s (printer $279 of it; a print service or makerspace replaces it). Prints are black ABS, which needs an enclosed printer and a ventilated room. The parts were picked so nothing needs a soldering iron, drill, saw, crimper or heat-set inserts. Mark them have / ordered in PARTS.md (https://github.com/Normansrule/Gonioreflectometer-Open-Source/blob/main/PARTS.md).

Join | How, without solder or drilling | Parts
Wire to wire | strip 11 mm, lever connector (thin jumper wire: fold the stripped end double) | PWR-20 P47 (https://github.com/Normansrule/Gonioreflectometer-Open-Source/blob/main/REFERENCES.md)
Wire to terminal | stripped, twisted wire under the screw (2 wires may share one) | PWR-30 jack, PWR-28 e-stop, SKR Pico POWER
Wire to a pin | jumper wire (cut one in half for pin → bare wire); XH leads crimped on both ends for endstops; PH→XH cables for motors | CTL-07 C10 (https://github.com/Normansrule/Gonioreflectometer-Open-Source/blob/main/REFERENCES.md), CTL-06, CTL-11 C11 (https://github.com/Normansrule/Gonioreflectometer-Open-Source/blob/main/REFERENCES.md)
Small electronics | modules with screw terminals (opto PWR-10, MOSFET MSK-03) or wire leads (LED driver LSR-02, into screw terminals and lever connectors), held in printed frames with double-sided tape; no breadboard, no loose chips | PWR-10, MSK-03, LSR-02
Boards | SKR Pico (connectors fitted), ESP32-S3 dev board and Pi Zero 2 WH with headers soldered | CTL-01 C12 (https://github.com/Normansrule/Gonioreflectometer-Open-Source/blob/main/REFERENCES.md), CTL-02 C13 (https://github.com/Normansrule/Gonioreflectometer-Open-Source/blob/main/REFERENCES.md), STA-01
COB LED | sits in a solderless holder with poke-in wire terminals; the lamp cap clamps it | LSR-06 L23 (https://github.com/Normansrule/Gonioreflectometer-Open-Source/blob/main/REFERENCES.md)
Printed part to the deck | M2 × 12 into the pilot boss already printed at that spot (deck map (https://github.com/Normansrule/Gonioreflectometer-Open-Source/blob/main/phases/03-frame/deck-map.svg)); spare pilots every 40 mm | FRM-06
Deck tile to tile | M2 × 10 + nut through the shared walls, 3 per edge | FRM-06
Screw into a printed part | M2 self-taps into 1.7 mm pilots (M2_TAP, set from the coupon); one screw size everywhere. Only the motor faces take M3 (FRM-07) | FRM-06
Bar to clamp | printed 20 × 20 bars with M2 pilots at every clamp station; couplers join the halves | FRM-02, FRM-09i
Axles | M8 bolts instead of shafts: the table drum turns on two 608s around a fixed bolt (one nut clamps the inner races); the tilt cradle turns on two stub bolts; spin is direct drive. No shaft to cut, no flat to file | TBL-05, TLT-05, SPN-01

Trade-off: the solderless power path has no reverse-polarity MOSFET or surge diode. The jack’s screws are marked + / −, and step M04.2 checks the adapter’s polarity at the jack with the meter (M06.1 again at MOT+ / MOT−) before the motor board is connected; the SKR Pico has its own input fuse and capacitors. Short-circuit protection comes from the adapter itself (listing), not from anything built here.

# 3D files and making parts


All printed parts

Every part has a 3D model in the repo — list and status per part: cad/README.md (https://github.com/Normansrule/Gonioreflectometer-Open-Source/blob/main/cad/README.md).

Folder | What
phases/NN/3d/ | printed parts: STEP (Onshape: Insert → Import, editable solid) and STL (slicer)
cad/bought/ (https://github.com/Normansrule/Gonioreflectometer-Open-Source/blob/main/cad/bought) | dummy models of every bought part at true size (motors, boards, bearings, belts, camera, lens…)
cad/open/ (https://github.com/Normansrule/Gonioreflectometer-Open-Source/blob/main/cad/open) | real open-licence models (Adafruit MIT, KiCad CC-BY-SA + exception)
cad/assembly/opengonio_assembly.step (https://github.com/Normansrule/Gonioreflectometer-Open-Source/blob/main/cad/assembly) | the whole machine, one STEP: import this into Onshape to start
cad/vendor/ (not committed) | real vendor models: bash scripts/get_cad.sh
cad/PRINT.md (https://github.com/Normansrule/Gonioreflectometer-Open-Source/blob/main/cad/PRINT.md) | print list: how many of each, size vs build volume, ≈ grams of ABS (core ≈ 2.7 kg, deck tiles ≈ 1.4 kg)

Putting it together: the build book (https://github.com/Normansrule/Gonioreflectometer-Open-Source/blob/main/docs/build.html) shows every modelled part in order, one step per page (PDF (https://github.com/Normansrule/Gonioreflectometer-Open-Source/blob/main/exports/build-book.pdf)); the order is docs/assembly.yaml, the words come from the stage checklists.

make cad regenerates dummies + assembly and runs make cad-check (no collisions across every axis’ travel, clear sight lines from both cameras and the lamp to the sample); make cad-zip packs every STEP into dist/opengonio-cad.zip (one Onshape import).

- Starter geometry, generated: python tools/cad/parts.py (CadQuery; parameters at the top). Print the tolerance coupon (https://github.com/Normansrule/Gonioreflectometer-Open-Source/blob/main/phases/00-plan/3d/PLAN-01_tolerance_coupon.stl) first and set CLEAR / M2_TAP.
- Vendor models: bash scripts/get_cad.sh → cad/vendor/ (not committed); browser-only downloads: bash scripts/get_cad.sh --from /mnt/c/Users/aleks/Downloads.
- Deck: deck map (https://github.com/Normansrule/Gonioreflectometer-Open-Source/blob/main/phases/03-frame/deck-map.svg) (tiles and every pilot; PLACE in tools/cad/parts.py is the source) · frame design (https://github.com/Normansrule/Gonioreflectometer-Open-Source/blob/main/phases/03-frame/design.md).
- Wiring: power netlist (https://github.com/Normansrule/Gonioreflectometer-Open-Source/blob/main/phases/01-power/design.md) · controller pins (https://github.com/Normansrule/Gonioreflectometer-Open-Source/blob/main/phases/02-controller/design.md) · standalone wiring (https://github.com/Normansrule/Gonioreflectometer-Open-Source/blob/main/phases/15-standalone/design.md).
- Onshape: set-up steps (https://github.com/Normansrule/Gonioreflectometer-Open-Source/blob/main/phases/00-plan/design.md) — import the STEP files, edit, export STEP + STL back.

# Calibration

Quantity | Method | Pass
Angle offset | mirror peak must sit at M3 = M4 / 2 (Ansari-Asl et al., 2024) | residual ≤ 0.1°
Dark level C_d | lamp-off frame | —
Camera response γ | exposure series (Debevec & Malik, 1997) | linear fit
Absolute BRDF | PTFE (polytetrafluoroethylene) tile, ≈ 99 % diffuse, at 45° (Weidner & Hsia, 1981) | —
Lamp drift | repeat the first pose at the end | ≤ 2 %

f_r =(C_(lin))/(C_(w,lin))⋅(ρ_w)/π⋅(cos45^(∘))/(cosθ_i),  C_(lin) =(C−C_d )^γ

C camera counts, C_w white tile, ρ_w its reflectance. Steps: stage 07 (https://github.com/Normansrule/Gonioreflectometer-Open-Source/blob/main/phases/07-calibrate).

## References

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

Debevec, P., & Malik, J. (1997). Recovering high dynamic range radiance maps from photographs. Proc. SIGGRAPH ’97. https://pauldebevec.com/Research/HDR/debevec-siggraph97.pdf

Weidner, V. R., & Hsia, J. J. (1981). Reflection properties of pressed polytetrafluoroethylene powder. Journal of the Optical Society of America, 71(7), 856–861. https://doi.org/10.1364/JOSA.71.000856

# 3D scanning

The camera never moves; the sample axes turn the object, so every photo’s pose is known.

1. Pose from the axes: camera calibrated once against the turntable (hand-eye, AX = YB) (Shah, 2013).
2. Quick shape: silhouettes → visual hull (Laurentini, 1994).
3. Full mesh: photogrammetry (Griwodz et al., 2021), then screened Poisson reconstruction (Kazhdan & Hoppe, 2013).
4. Surface detail (optional LED bank): photometric stereo from known light directions (Ackermann & Goesele, 2015).
5. Material: measured BRDF fitted onto the mesh; export to a game engine (Rendering).

Stages 11 (https://github.com/Normansrule/Gonioreflectometer-Open-Source/blob/main/phases/11-scan-capture) · 12 (https://github.com/Normansrule/Gonioreflectometer-Open-Source/blob/main/phases/12-scan-mesh) · 13 (https://github.com/Normansrule/Gonioreflectometer-Open-Source/blob/main/phases/13-object-material). Background: Appendix C.

## References

Ackermann, J., & Goesele, M. (2015). A survey of photometric stereo techniques. Foundations and Trends in Computer Graphics and Vision, 9. https://doi.org/10.1561/0600000065

Griwodz, C. et al. (2021). AliceVision meshroom: An open-source 3D reconstruction pipeline. Proc. ACM MMSys. https://doi.org/10.1145/3458305.3478443

Kazhdan, M., & Hoppe, H. (2013). Screened Poisson surface reconstruction. ACM Transactions on Graphics, 32(3), 29. https://doi.org/10.1145/2487228.2487237

Laurentini, A. (1994). The visual hull concept for silhouette-based image understanding. IEEE Transactions on Pattern Analysis and Machine Intelligence, 16(2). https://doi.org/10.1109/34.273735

Shah, M. (2013). Solving the robot-world/hand-eye calibration problem using the Kronecker product. Journal of Mechanisms and Robotics, 5(3), 031007. https://doi.org/10.1115/1.4024473

# Rendering

What the machine measures, on a real shape: the fitted material and the scanned object as computer graphics.

Step | Command | File
1. Measure the Bidirectional Reflectance Distribution Function (BRDF) | opengonio capture inplane (after calibrate white) | curve.csv
2. Fit base colour, roughness, metallic | opengonio fit data/<run> | fit.json, fit.svg
3. Scan the object | opengonio scan run, opengonio scan hull | hull_mesh.ply, hull.glb
4. Combine shape + material | opengonio render data/<run> --mesh scan_out/hull_mesh.ply | hull_mesh.glb, hull_mesh.png
5. Render | Render page (https://normansrule.github.io/gonioreflectometer-open-source/render.html), Blender, Unity, Unreal, three.js | pixels

Without hardware: opengonio render demo runs all five on simulated data (data/render_demo/).

## One model everywhere

The fit is Lambert + GGX with metallic-roughness parameters (Walter et al., 2007) (Khronos Group, n.d.), the model glTF, Blender, Unreal (Karis, 2013) and Unity use. Three renderers draw it with the same formula:

Renderer | Where | Use
opengonio.render.raster | numpy, CPU | pictures in scripts and tests; no GPU
docs/og/render-gl.js | WebGL 2, browser | Render page and the control app’s material preview
Blender, Unity, Unreal, three.js | the .glb | production

tests/test_render.py checks that the renderer’s BRDF equals fit.py’s, and that a lit white sphere has the brightness the formula predicts.

## The .glb

- glTF 2.0 binary (Khronos Group, n.d.): one mesh, one metallic-roughness material, provenance (run, holdout, notes) in extras.
- Geometry stays in the scanner’s millimetres, Z up; the node’s scale (0.001) and rotation make it metres, Y up.
- Unity: smoothness = 1 − roughness (URP Lit).

## Lighting

- Lamp: the fitted model, exactly.
- Studio (sky gradient + two softboxes): approximate. A fitted curve lights the shadowed sides (Karis, 2014); it is not measured.
- Tone: ACES filmic (Narkowicz, 2016), then sRGB.

## Scan → mesh

The visual hull’s boundary voxels become triangles, then λ/μ smoothing removes the voxel steps without shrinking (Taubin, 1995). It is still the visual hull: cavities come out filled (the demo mug: hull 43 cm³ against 17 cm³ real).

## Limits

- Grey: one camera channel. A colour tint is typed by hand (--color R G B).
- One material per object; no texture.
- Isotropic only.
- Between and beyond the measured angles the picture is the model’s guess: check the holdout in fit.json.

## In the control app

Under a run’s curve: Material. With a fit it shows it; with absolute values it offers Fit material; a relative-only run says why it can’t be fitted, and a simulated run previews the simulator’s true material. Download .glb saves it on a shader ball.

## References

Karis, B. (2013). Real shading in Unreal engine 4. Physically Based Shading in Theory and Practice. https://cdn2.unrealengine.com/Resources/files/2013SiggraphPresentationsNotes-26915738.pdf

Karis, B. (2014). Physically based shading on mobile.

Khronos Group. (n.d.). glTF 2.0 specification. Retrieved https://registry.khronos.org/glTF/specs/2.0/glTF-2.0.html#metallic-roughness-material

Narkowicz, K. (2016). ACES filmic tone mapping curve.

Taubin, G. (1995). A signal processing approach to fair surface design. SIGGRAPH.

Walter, B., Marschner, S., Li, H., & Torrance, K. (2007). Microfacet models for refraction through rough surfaces. Eurographics Symposium on Rendering.

# Software

Python package opengonio (software/ (https://github.com/Normansrule/Gonioreflectometer-Open-Source/blob/main/software)). Motion: grblHAL on the BTT SKR Pico over USB-C (FluidNC ESP32 boards also supported); the ESP32-S3 hub reads keypads and sensors.

make setup && source .venv/bin/activate
make sim # simulated machine, ends "ALL PASS"
opengonio check-pose M4=60 M3=30 # angles + collision check
opengonio --sim plastic capture inplane --step 10 --out data/sim/plastic
opengonio curve data/sim/plastic # reflectance curve

- Laptop mode: the laptop runs jobs. Standalone mode: a Pi Zero 2 W runs them; opengonio pull + opengonio verify bring data back.
- make all: rebuild docs, checks, tests.

# Commands

### Try without hardware

make setup && source .venv/bin/activate # once; `source …` again in every new terminal
make all # build + check + tests
make ci # replay the GitHub checks on a clean clone (before pushing)
make sim # simulated machine: mirror → calibrate → dark → gamma → white → matte → drift → fit; ends "ALL PASS"
opengonio check-pose M4=60 M3=30 # angles + collision check for one pose
opengonio --sim plastic capture inplane --step 10 --out data/sim/plastic && opengonio curve data/sim/plastic
opengonio scan demo --out demo # 3D scan pipeline on a synthetic object

--sim MATERIAL (mirror, ptfe, matte, paper, plastic) runs any capture on a simulated machine; --sim-error M3=0.8 hides an angle error in it, --sim-drift 0.3 dims its lamp 0.3 % per shot and --sim-gamma 2.2 makes its camera non-linear, so you can watch verify and calibrate find them. The Calibration lab (https://github.com/Normansrule/Gonioreflectometer-Open-Source/blob/main/docs/lab.html#calibrate) shows the same thing interactively.

### Measure and calibrate

Measuring loop: capture, verify, calibrate, curve, fit (https://github.com/Normansrule/Gonioreflectometer-Open-Source/blob/main/docs/assets/measure.svg?raw=true)

opengonio capture warmup --minutes 10 # stage 06: lamp settle time -> lights.white.warmup_s
opengonio capture mirror --theta 40 # mirror sweep -> data/mirror_40/ (images + manifest.json)
opengonio verify data/mirror_40 # PASS / WARN / FAIL: missing images, angles, lamp drift, saturation
opengonio curve data/mirror_40 # curve.csv + curve.svg (picture of the run)
opengonio calibrate mirror data/mirror_* # angle offset -> software/config/calibration.yaml
opengonio capture dark && opengonio calibrate dark data/dark # lamp-off level
opengonio capture linearity && opengonio calibrate linearity data/linearity # camera response (gamma)
opengonio capture white && opengonio calibrate white data/white # PTFE at 45:0 -> absolute units
opengonio capture inplane --step 10 --out data/paper && opengonio curve data/paper # brdf_per_sr column
opengonio fit data/paper # base colour, roughness, metallic -> fit.json (+ Blender/Unreal/Unity values), fit.svg
opengonio render data/paper # that material on a shader ball -> material.glb + material.png (see Rendering)
opengonio render data/paper --mesh scan_out/hull_mesh.ply # on your scanned object -> hull_mesh.glb
opengonio render demo # the whole path on simulated data -> data/render_demo/
opengonio capture isotropic --step 15 # stage 08: out-of-plane set from BRDF angles (inverse kinematics)
opengonio capture spin --theta 30 # stage 09: sample spun 0–180° (brushed metal)
opengonio scan hull --out scan_cube --voxel 0.5 # stage 12: silhouettes -> hull.ply + object size
opengonio scan ps --out scan_ball --sphere # stage 12: photometric stereo -> normals, error on a sphere
opengonio calibrate show # every value, its date, and what is stale or not measured yet

Mirror run before calibration (curve.svg) | Material fit (fit.svg)
Mirror sweep: peak 0.4 degrees left of M3 = M4/2 (https://github.com/Normansrule/Gonioreflectometer-Open-Source/blob/main/docs/assets/example-mirror.svg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) | Fitted GGX curves through measured points (https://github.com/Normansrule/Gonioreflectometer-Open-Source/blob/main/docs/assets/example-fit.svg?raw=true)

Both from the simulated machine (make build regenerates them): the mirror peak sits 0.4° left of the orange line until calibrate mirror runs; the fit recovers the simulated plastic (base 0.2, roughness 0.3).

Every run shoots its first pose again at the end (ref_start.png, ref_end.png); verify fails the run if the lamp changed by more than drift_limit_pct (2 %). Every manifest.json carries schema, units and the calibration used, so old data can be re-processed later.

### Flash and move the motors

Full steps (incl. WSL USB): firmware.md (https://github.com/Normansrule/Gonioreflectometer-Open-Source/blob/main/phases/02-controller/design.md).

bash scripts/controller.sh flash # how to put grblHAL on the SKR Pico (Web Builder .uf2, drag and drop)
bash scripts/controller.sh settings # send firmware/grblhal/settings.txt over USB-C
bash scripts/controller.sh pins # output port numbers for machine.yaml lights
bash scripts/e4.sh test # home, move, motors off
bash scripts/hub.sh flash oct # MicroPython onto the ESP32-S3 (oct = N8R8/N16R8 module)
bash scripts/hub.sh # button hub firmware

### Control app: laptop, desktop, phone, website

opengonio app --sim mirror # browser, simulated machine
opengonio app --window # desktop window (pip install "./software[desktop]")
opengonio app --lan # + phones and tablets on this Wi-Fi: scan the QR code under Phone (pip install "./software[lan]")
bash scripts/pages.sh # once: the website on GitHub Pages (asks before making the repo public)
python software/packaging/build.py # desktop app for this computer -> dist/OpenGonio-<os>.zip (GitHub builds all three)

Each run in the app’s list downloads as a zip (↓). The web version (https://github.com/Normansrule/Gonioreflectometer-Open-Source/blob/main/docs/app/index.html) runs the same Python in the browser (Pyodide) on the simulated machine. The optional status screen on the hub shows the machine’s state without any app: SCREEN ON on the hub’s serial port (hub add-ons (https://github.com/Normansrule/Gonioreflectometer-Open-Source/blob/main/docs/addons.html)).

### Standalone mode (no laptop)

Wiring and setup (https://github.com/Normansrule/Gonioreflectometer-Open-Source/blob/main/phases/15-standalone/design.md).

bash scripts/station.sh aleks@opengonio.local # once: installs the station on the Pi Zero 2 W
# on the machine: NEXT = choose job, START = run, STOP = abort
opengonio pull aleks@opengonio.local # later, on the laptop
opengonio verify data/* # PASS / WARN / FAIL per job

### Publish and update the private GitHub repo (Ubuntu)

# 1. Tools
sudo apt update && sudo apt install -y git python3-venv unzip curl
sudo mkdir -p -m 755 /etc/apt/keyrings
curl -fsSL https://cli.github.com/packages/githubcli-archive-keyring.gpg | sudo tee /etc/apt/keyrings/githubcli-archive-keyring.gpg >/dev/null
echo "deb [arch=$(dpkg --print-architecture) signed-by=/etc/apt/keyrings/githubcli-archive-keyring.gpg] https://cli.github.com/packages stable main" | sudo tee /etc/apt/sources.list.d/github-cli.list >/dev/null
sudo apt update && sudo apt install -y gh

# 2. Log in (workflow scope lets the CI file push)
gh auth login --hostname github.com --git-protocol https --web --scopes workflow
gh auth setup-git

# 3. Unzip (WSL: /mnt/c/Users/<you>/Downloads)
mkdir -p ~/projects && cd ~/projects
unzip -q ~/Downloads/Gonioreflectometer-Open-Source.zip
cd Gonioreflectometer-Open-Source

# 4. Private repo, push, milestones, issues
bash scripts/publish.sh

# 5. Check
gh repo view --web

Other account over SSH: OWNER=<user> REMOTE=git@<host-alias>:<user>/Gonioreflectometer-Open-Source.git bash scripts/publish.sh

Every update after that (pushes, then syncs milestones and issues with .github/phases.yml):

cd ~/projects/Gonioreflectometer-Open-Source

# your own edits (same as: make publish m="…")
bash scripts/update.sh "M05.1 done"

# a new zip (keeps your history; replaces repo files with the zip's)
bash scripts/update.sh "update from new zip" /mnt/c/Users/<you>/Downloads/Gonioreflectometer-Open-Source.zip
bash scripts/get_papers.sh

# Build guide

## Start here

1. Set up once: publish the repo (commands), then make setup. Decide your parts in PARTS.md (https://github.com/Normansrule/Gonioreflectometer-Open-Source/blob/main/PARTS.md).
2. Try the software without hardware: Try without hardware.
3. Do the steps in order. make next prints the next one; its stage checklist has the full instructions.
4. After each step: make done id=M05.1 closes its GitHub issue, ticks it in the checklists and figures, and publishes.

Every step (= one GitHub issue) is Time · Needs → Do (numbered actions) → Verify (a measurement with a pass number) → If a check fails (what to look at first) → Record (the file to fill in). To change or extend anything, see Tweak and extend.

## Two ways to run

| Laptop mode | Standalone mode (stage 15)
Who runs jobs | laptop (opengonio) | Pi Zero 2 W (opengonio station)
Inputs | laptop or buttons | buttons + OLED menu; phone WebUI for jogging
Data | processed live | saved on the Pi → laptop opengonio pull + opengonio verify
Extra cost | $0 | $38 kit (optional)

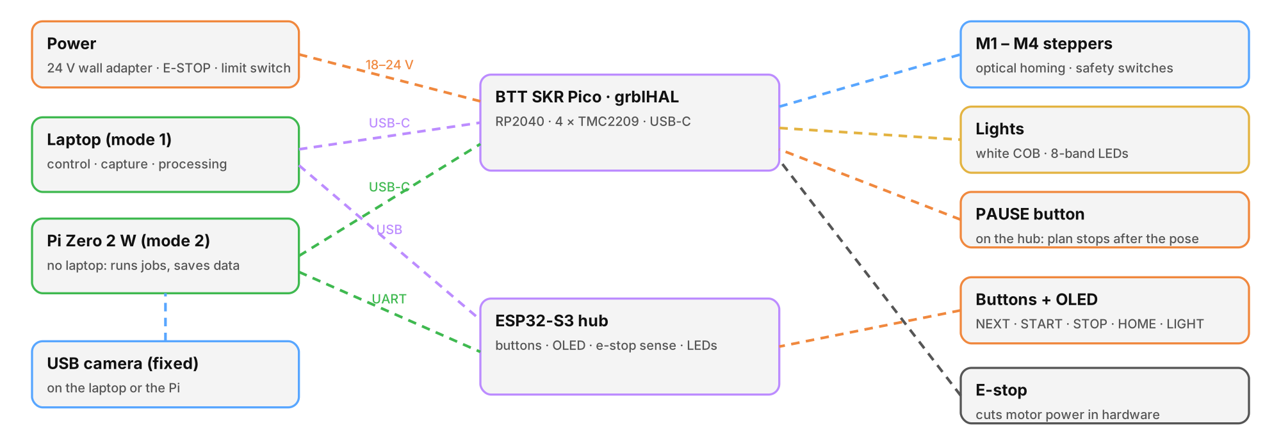
[picture p17: figure]

Laptop mode and standalone mode

# Theory and equations

- Bidirectional reflectance distribution function (BRDF): how much light arriving from one direction leaves toward another. The machine sets both directions: the light arm (M4) sets where light comes from; the fixed camera is where it goes; the sample axes (M3, M2, M1) turn the sample between them.
- Isotropic vs anisotropic: most materials look the same when spun about their normal (3 angles). Brushed metal, satin and hair do not (4 angles), so they need M1.
- Microfacet model: a rough surface is many tiny mirrors; GGX describes how they are tilted, Fresnel how much each reflects, Smith how they shadow each other. Fitting roughness, colour and metalness to measurements gives a game-engine material.
- Mirror check: a mirror only reflects when the incident and reflected angles are equal, so with no tilt the peak must sit at M3 = M4 / 2. That calibrates the angles.
- Calibration: the mirror peak gives the angle offset; a lamp-off image gives the dark level; a PTFE tile (≈ 99 % white, diffuse) at 45° turns camera counts into absolute BRDF units; repeating the first pose at the end of every run shows whether the lamp drifted.
- 3D scan: the camera never moves, so every photo’s pose is known from the axes; silhouettes give a quick shape (visual hull), photogrammetry gives the full mesh, and (with the optional LED bank) lights from several known directions give surface detail (photometric stereo).

BRDF and reflection equation (Hanrahan, 2016; Nicodemus et al., 1977)

f_r (ω_i →ω_r )=(dL_r (ω_i →ω_r ))/(dE_i) [sr^(−1) ],  L_r (x,ω_r )=∫_(H^2)^() f_r L_i (x,ω_i )cosθ_i dω_i

Reciprocity, isotropy, energy (Hanrahan, 2016)

f_r (ω_r →ω_i )=f_r (ω_i →ω_r ),  f_r^(iso) =f_r (θ_i ,θ_r ,|φ_r −φ_i |),  ∫_(H^2)^() f_r cosθ_r dω_r ≤1

Anisotropic (needs M1) (Ward, 1992)

f_r^(aniso) =f_r (θ_i ,φ_i ,θ_r ,φ_r ) (4 angles; φ measured from the brushing direction)

Mirror, Snell, total internal reflection (Hanrahan, 2016)

R=I−2(I⋅N)N,  η_i sinθ_i =η_t sinθ_t ,  1−μ^2 (1−(I⋅N)^2 )<0

Fresnel (Schlick), Lambert (Hanrahan, 2016; Schlick, 1994)

F(θ)=F_0 +(1−F_0 )(1−cosθ)^5 , F_0 =((η−1)/(η+1))^2 ,  f_(r,d) =(ρ_d)/π

Fitted model (Lambert + GGX) (Heitz, 2014; Trowbridge & Reitz, 1975; Walter et al., 2007)

f_r =(1−m)(1−F)ρ/π+(D G_2 F)/(4cosθ_i cosθ_r), D=(α^2)/(π((h⋅n)^2 (α^2 −1)+1)^2), h=(ω_i +ω_r)/(∥ω_i +ω_r ∥)

Sample orientation and angles (Ansari-Asl et al., 2024)

R=R_z (M_3 ) R_y (−M_2 ) R_x (M_1 ), ω^s =R^(⊤) ω^w , θ=arccos(ω^s ⋅n), φ=atan2(ω_z^s ,ω_y^s )

Light and camera directions (Ansari-Asl et al., 2024)

l=R_z (M_4 ) x,  c=x (fixed),  ω_i (p)=(P_L −p)/(∥P_L −p∥), ω_r (p)=(P_C −p)/(∥P_C −p∥)

In-plane geometry (M2 = M1 = 0) (Ansari-Asl et al., 2024)

θ_r =M_3 ,  θ_i =M_4 −M_3 ,  specular: M_3 =(M_4)/2

Step size

Δθ=(360^(∘))/(200⋅16⋅G) ⇒ 0.0047^(∘) (M_4 , G=24), 0.0225^(∘) (M_3 ,M_2 ); M_1 direct at 1/64: 0.028^(∘)

Optics (Ansari-Asl et al., 2024)

1/(p′)−1/p=1/f, m=(p′)/p, d_(Airy) =2.44 λN, DOF≈(2Nc(1+m))/(m^2)

HDR (Debevec & Malik, 1997)

g(Z_(ij) )=lnE_i +lnΔt_j

Repeatability from the mirror (Ansari-Asl et al., 2024)

Δθ_L =(s p_(px) P)/(f D_L)

Calibration: angle offset, camera response, absolute BRDF, lamp drift (Ansari-Asl et al., 2024; Debevec & Malik, 1997; Hanrahan, 2016)

δ_(M3) ←δ_(M3) −(M_3^(peak) −(M_4)/2),  ln(C−C_d )=1/γlnt+k,  C_(lin) =(C−C_d )^γ

f_r =(C_(lin))/(C_(w,lin))⋅(ρ_w)/π⋅(cos45^(∘))/(cosθ_i),  drift=(C_(end) −C_(start))/(C_(start) −C_d)≤2 %

C = camera counts (centre of the sample), C_d = lamp off, t = exposure, γ = camera response (1 = linear), C_w = PTFE at θ_i =45^(∘) , ρ_w = PTFE reflectance, δ = angle offset (true = commanded + δ ). Same exposure for all shots.

Out-of-plane poses from BRDF angles (inverse kinematics, stages 08–09) (Ansari-Asl et al., 2024; Hanrahan, 2016)

cosα=cosθ_i cosθ_r +sinθ_i sinθ_r cosΔφ, M_4 =α, n=ac+bl+g(c×l), M_2 =arcsinn_z , M_3 =atan2(n_y ,n_x )

a,b from n⋅c=cosθ_r , n⋅l=cosθ_i ; g from |n|=1 . Light on the camera axis ( α<20^(∘) ) is out of reach, so pure back-scatter is not measured.

3D scan: projection, view elevation (COLMAP Output Format, n.d.; OpenCV ’solvePnP‘, n.d.)

λ[u,v,1]^(⊤) =K(R_(oc) p_O +t_(oc) ), R_(oc) =R_(wc) RP,  ϵ=90^(∘) −M_2 +e_(cam)

3D scan: camera calibration (AX = YB) (Shah, 2013)

minX,Y∑_i^() ∥log(A_i^(−1) XB_i Y)∥^2

3D scan: visual hull, photometric stereo (Laurentini, 1994; Woodham, 1980)

V=⋂j{p:π_j (p)∈S_j },  I=L g, g=L^(+) I, ρ=∥g∥, n=g/ρ

Full notes: theory.md (https://github.com/Normansrule/Gonioreflectometer-Open-Source/blob/main/phases/00-plan/research.md) · scan methods (https://github.com/Normansrule/Gonioreflectometer-Open-Source/blob/main/phases/12-scan-mesh/research.md).

## References

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

COLMAP output format. (n.d.). Retrieved https://colmap.github.io/format.html

Debevec, P., & Malik, J. (1997). Recovering high dynamic range radiance maps from photographs. Proc. SIGGRAPH ’97. https://pauldebevec.com/Research/HDR/debevec-siggraph97.pdf

Hanrahan, P. (2016). Reflection models I: Ideal materials.

Heitz, E. (2014). Understanding the masking-shadowing function in microfacet-based BRDFs. Journal of Computer Graphics Techniques, 3(2), 48–107. https://jcgt.org/published/0003/02/03/paper.pdf

Laurentini, A. (1994). The visual hull concept for silhouette-based image understanding. IEEE Transactions on Pattern Analysis and Machine Intelligence, 16(2). https://doi.org/10.1109/34.273735

Nicodemus, F. E., Richmond, J. C., Hsia, J. J., Ginsberg, I. W., & Limperis, T. (1977). Geometrical considerations and nomenclature for reflectance. NBS Monograph, 160. https://doi.org/10.6028/NBS.MONO.160

OpenCV ’solvePnP‘. (n.d.). Retrieved https://docs.opencv.org/4.13.0/d5/d1f/calib3d_solvePnP.html

Schlick, C. (1994). An inexpensive BRDF model for physically-based rendering. Computer Graphics Forum, 13(3).

Shah, M. (2013). Solving the robot-world/hand-eye calibration problem using the Kronecker product. Journal of Mechanisms and Robotics, 5(3), 031007. https://doi.org/10.1115/1.4024473

Trowbridge, T. S., & Reitz, K. P. (1975). Average irregularity representation of a rough surface for ray reflection. Journal of the Optical Society of America, 65(5), 531–536. https://doi.org/10.1364/JOSA.65.000531

Walter, B., Marschner, S., Li, H., & Torrance, K. (2007). Microfacet models for refraction through rough surfaces. Eurographics Symposium on Rendering.

Ward, G. J. (1992). Measuring and modeling anisotropic reflection. ACM SIGGRAPH Computer Graphics, 26(2), 265–272. https://doi.org/10.1145/142920.134078

Woodham, R. J. (1980). Photometric method for determining surface orientation from multiple images. Optical Engineering, 19(1). https://doi.org/10.1117/12.7972479

# Test materials

θi = M4 − M3 (light from the normal), θr = M3 (camera from the normal), in-plane. Isotropic needs 3 angles (M4, M3, M2); anisotropic needs 4 (adds M1).

Material | Type | Light (M4) · camera (θr = M3) | What to look for
PTFE white reference | isotropic, diffuse | 45° · 0° (CIE 45°:0°) | flat response; calibrates brightness (Weidner & Hsia, 1981)
Matte paper | isotropic, diffuse | 60° · sweep M3 | ≈ cos θr
First-surface mirror | isotropic, specular | 60° · 30° | peak at M3 = M4/2; calibrates angles
Glossy plastic (acrylic, LEGO) | isotropic, glossy | 40/80/120° · M4/2 ± 10° | lobe width → roughness
Metallic car paint | isotropic, flake | 90° · 35° (15° off specular) | sparkle, colour shift (ASTM International, 2025)
Brushed aluminium | anisotropic | 60° · 30°, spin M1 0–180° | highlight stretches across the brushing (Ward, 1992)
Satin ribbon | anisotropic | 70° · 35°, M2 15°, M1 15° steps | two lobes vs direction
Velvet / retroreflective tape | back-scatter | 20° (closest allowed) · 10° | peak toward the light
3D scan: matte print, painted toy | object | lamp 30°, scan camera 650 mm / 15° up, M2 85→25°, M1 36 steps | spray shiny parts matte

## References

ASTM International. (2025). Standard test method for multiangle color measurement of metal flake pigmented materials. https://doi.org/10.1520/E2194-14R25

Ward, G. J. (1992). Measuring and modeling anisotropic reflection. ACM SIGGRAPH Computer Graphics, 26(2), 265–272. https://doi.org/10.1145/142920.134078

Weidner, V. R., & Hsia, J. J. (1981). Reflection properties of pressed polytetrafluoroethylene powder. Journal of the Optical Society of America, 71(7), 856–861. https://doi.org/10.1364/JOSA.71.000856

# Tweak and extend

Everything is generated from a few source files. Edit the source, run make all, then make publish m="…".

To change… | Edit | Then
a step, a milestone, a pass number | .github/phases.yml (do, verify, fail, record, time, wait, needs) | make all
mark a step done | — | make done id=M05.1 (closes the issue, refreshes ticks and figures)
add a stage / milestone / step | python tools/new.py stage 18-name "Title" · milestone 04-light-arm "Title" "Goal" · step M14 "Title" | fill the TODO lines, make all
agree / have / ordered / swap / skip a part, what you paid | PARTS.md (https://github.com/Normansrule/Gonioreflectometer-Open-Source/blob/main/PARTS.md) (also on GitHub in the browser) | make locally, or nothing: parts-sync runs on GitHub
a part’s spec, price or link; a new part | phases/NN/bom.csv (or python tools/new.py part …) | make all (budget is re-checked)
a printed part’s size | the PARAMETERS block or the part function in tools/cad/parts.py | make parts
a printed part, by hand | import phases/NN/3d/*.step into Onshape, export STEP + STL back | make all
machine geometry, ports, gear ratios (what you built) | software/config/machine.yaml | make all (simulator numbers update too)
angle offsets, dark level, white reference (what you measured) | written by opengonio calibrate … into software/config/calibration.yaml | commit it
lamp warm-up, drift limit | lights.white.warmup_s (machine.yaml) · drift_limit_pct (calibration.yaml) | —
what you paid | Paid USD column in phases/NN/bom.csv | make prints spent so far
mark a stage done | — | make release s=06 (tag v0.6 + every STEP/STL as a zip on GitHub)
motor board settings | tools/grblhal_settings.py → firmware/grblhal/settings.txt | make build, then bash scripts/controller.sh settings
buttons, screen, spectral sensor | firmware/hub/main.py | bash scripts/hub.sh
a reference | python tools/new.py ref G "Source" "Used for (phase NN)"; cite as [G53](https://github.com/Normansrule/Gonioreflectometer-Open-Source/blob/main/REFERENCES.md) | make all
how-to text for a stage | phases/NN/design.md (how) · research.md (why) | make check
a test result | phases/NN/test.csv | commit

Rules that keep it simple: - Generated, don’t edit by hand: phases/NN/README.md, phases/NN/3d/README.md, the tables between <!-- … --> markers in this README, docs/assets/*.svg, docs/assets/steps/*.svg, docs/machine.js, docs/plan.js, .github/progress.json, optics.md, power_budget.md, deck-map.svg. - Specs vs decisions: bom.csv holds what a part is (spec, price, link); PARTS.md holds what you decided (status, paid, note). make copies decisions into bom.csv (Status, Own, Paid USD), so edit those three only in PARTS.md. Zip updates never overwrite your PARTS.md. - Math on GitHub: make check rejects TeX macros GitHub refuses (operator-name and new-command macros); write \mathrm{atan2}. - Built vs measured: machine.yaml holds design values; calibration.yaml holds measured ones with dates. verify warns when a calibration is older than 30 days. - Simulator = software: the web simulator reads docs/machine.js, generated from machine.yaml; make check fails if they differ. - Test without hardware first: a code change must keep make sim at ALL PASS. - Go back: git checkout v0.6 returns to the state when stage 06 passed (git checkout main to return). - Every step has a time and a pass number: make check rejects a step without Do / Verify, with a malformed time, or with TODO left in it. - Milestone IDs never change once published: new ones get the next free number, so GitHub issue history stays attached. - make check lists every problem in one place: milestone format, parts lists, the budget cap, reference IDs, broken links, machine and calibration config. - Measurement data goes in data/<job>/: manifest.json, curve.csv and spectral.csv are committed; images stay local.

# Repository map

README.md this guide
CLAUDE.md rules for AI agents: update + build + commit the PDF after every change
PARTS.md your working parts list: decisions, paid, notes (edit on GitHub)
Makefile make help · setup · build · parts · cad · cad-check · cad-zip · check · test · paper · export · ci · all · sim · next · done · release · publish
REFERENCES.md 487 sources (also listed below)
phases/NN-name/ one folder per stage
README.md checklist: Do / Verify / Record (generated)
design.md how it is built (wiring, dimensions, notes)
research.md why (requirements, methods)
bom.csv parts to buy, prices, links
test.csv test log you fill in
3d/ printed parts: .step (Onshape) + .stl (slicer)
cad/ README.md (model per part) · PRINT.md (print list) · bought/ dummies · open/ open models · assembly/ whole machine · vendor/ (local)
pcb/ carrier circuit board: reference spec for a future version (README.md)
firmware/ grblHAL settings (SKR Pico) · FluidNC config (ESP32-board option) · MicroPython hub (ESP32-S3)
software/ opengonio: control, capture, calibration, simulator, scanning
config/ machine.yaml (built) · calibration.yaml (measured)
tools/ check.py (health) · new.py (add things) · roadmap, BOM, figures, CAD parts, deck map, export_machine
scripts/ controller.sh · hub.sh · e4.sh · station.sh · publish.sh · update.sh · release.sh · get_papers.sh · get_cad.sh
docs/ interactive simulator (index.html, machine.js, plan.js) + figures (assets/, assets/steps/NN.svg)
exports/ Word, Overleaf, Zotero, Excel, wiki PDF, glTF copies (generated; see exports/README.md)
paper/ HardwareX manuscript: opengonio.tex · references.bib (generated) · build/opengonio.pdf
wiki/ explanations, Bibliography (APA), Appendices A–E · src/ = sources · scripts/publish_wiki.sh
papers/ PDFs: open/ (committed) · personal/ (local only)
data/ measurement jobs: manifest.json, curve.csv, spectral.csv (images stay local; data/sim/ not committed)
.github/phases.yml stages + milestones (source of every checklist and issue)
.github/progress.json closed steps, pulled from GitHub by `make done` / `make publish`

# Paper

Manuscript for HardwareX (Elsevier), the open-source scientific hardware journal: paper/ (https://github.com/Normansrule/Gonioreflectometer-Open-Source/blob/main/paper).

- PDF: paper/build/opengonio.pdf (https://github.com/Normansrule/Gonioreflectometer-Open-Source/blob/main/paper/build/opengonio.pdf), rebuilt by make paper on every change.
- Sections follow the HardwareX hardware-article template; citations APA 7 (biblatex-apa), keys = reference IDs.
- Edit elsewhere: Word (https://github.com/Normansrule/Gonioreflectometer-Open-Source/blob/main/exports/paper/opengonio.docx) · Overleaf zip (https://github.com/Normansrule/Gonioreflectometer-Open-Source/blob/main/exports/paper/opengonio-overleaf.zip) · references for Zotero (https://github.com/Normansrule/Gonioreflectometer-Open-Source/blob/main/exports/references); copy edits back into paper/opengonio.tex.
- Results sections wait for measured data (stages 06–09).

# Bibliography

322 scholarly sources, APA 7th edition. [G12] = ID in REFERENCES.md (https://github.com/Normansrule/Gonioreflectometer-Open-Source/blob/main/REFERENCES.md) and BibTeX key in paper/references.bib (https://github.com/Normansrule/Gonioreflectometer-Open-Source/blob/main/paper/references.bib). Topic lists with what each source is used for: Appendix A · Appendix B · Appendix C · Appendix D · Appendix E.

- Ackermann, J., & Goesele, M. (2015). A survey of photometric stereo techniques. Foundations and Trends in Computer Graphics and Vision, 9. https://doi.org/10.1561/0600000065 [V27]
- Aittala, M., Weyrich, T., & Lehtinen, J. (2013). Practical SVBRDF capture in the frequency domain. ACM Transactions on Graphics, 32(4). https://doi.org/10.1145/2461912.2461978 [G44]
- Ali, I., Suominen, O., Gotchev, A., & Ruiz Morales, E. (2019). Methods for simultaneous robot-world-hand–eye calibration: A comparative study. Sensors, 19(12), 2837. https://doi.org/10.3390/s19122837 [V17]
- ams AG (ams OSRAM). (2014). AS5600 – 12-bit programmable contactless potentiometer. https://www.mouser.com/pdfdocs/AMS_AS5600_Datasheet_EN.PDF [H12]
- Ams AS7341 11-channel spectral sensor; adafruit breakout #4698. (n.d.). https://www.adafruit.com/product/4698 [H59]
- Analog Devices (Trinamic). (n.d.-a). AN-002: Parameterization of StallGuard2 & CoolStep. https://www.analog.com/en/resources/app-notes/an-002.html [H2]
- Analog Devices (Trinamic). (n.d.-b). TMC2209 datasheet. https://www.analog.com/media/en/technical-documentation/data-sheets/tmc2209_datasheet_rev1.09.pdf [H1]
- Andersson, Z., Edmondson, P., Guertault, J., Herubel, A., Kutz, P., Machizaud, A., Portsmouth, J., Servant, F., & Stone, J. (2025). OpenPBR surface: An open shading model for physically based materials. DigiPro 2025. https://doi.org/10.1145/3744199.3744632 [T50]
- Ansari-Asl, M. (2026). Development of a multispectral camera-based device for goniometric acquisition of spatially varying reflectance properties. PhD thesis. https://www.ntnu.edu/colourlab/phd-theses [G35]
- Ansari-Asl, M., Barbieri, M., Obein, G., & Hardeberg, J. Y. (2023). Advancing material appearance measurement: A cost-effective multispectral imaging system for capturing SVBRDF and BTF. London Imaging Meeting. https://doi.org/10.2352/lim.2023.4.1.25 [G33]
- Ansari-Asl, M., Barbieri, M., Obein, G., & Hardeberg, J. Y. (2024). Optical and electromechanical design and implementation of an advanced multispectral device to capture material appearance. Journal of Imaging, 10(3), 55. https://doi.org/10.3390/jimaging10030055 [R1]
- Ansari-Asl, M., Thomas, J.-B., & Hardeberg, J. Y. (2022). Camera response function assessment in multispectral HDR imaging. IS&T Electronic Imaging (Color Imaging XXVII), 141. https://doi.org/10.2352/EI.2022.34.15.COLOR-141 [G34]
- Ashikhmin, M., & Shirley, P. (2000). An anisotropic Phong BRDF model. Journal of Graphics Tools, 5(2), 25–32. https://doi.org/10.1080/10867651.2000.10487522 [T15]
- ASTM International. (n.d.). Standard test method for specular gloss. https://store.astm.org/standards/d523 [N4]
- ASTM International. (2003). Standard practice for angle resolved optical scatter measurements on specular or diffuse surfaces. https://www.astm.org/DATABASE.CART/WITHDRAWN/E1392.htm [N2]
- ASTM International. (2005). Standard practice for goniophotometry of objects and materials. https://store.astm.org/e0167-96.html [N3]
- ASTM International. (2019). Standard practice for goniometric optical scatter measurements. https://store.astm.org/e2387-19.html [N1]
- ASTM International. (2023a). Standard practice for obtaining spectrometric data for object-color evaluation. https://store.astm.org/standards/e1164 [N9]
- ASTM International. (2023b). Standard test methods for measurement of gloss of high-gloss surfaces by abridged goniophotometry. https://store.astm.org/standards/e430 [N5]
- ASTM International. (2025a). Standard terminology of appearance. https://doi.org/10.1520/E0284-25 [N6]
- ASTM International. (2025b). Standard test method for multiangle color measurement of metal flake pigmented materials. https://doi.org/10.1520/E2194-14R25 [N8]
- ASTM International. (2026). Standard practice for specifying the geometry of multiangle spectrophotometers. https://store.astm.org/standards/e2175 [N7]
- ASWF, MaterialX specification and physically based shading nodes. (n.d.). https://github.com/AcademySoftwareFoundation/MaterialX/blob/main/documents/Specification/MaterialX.PBRSpec.md [T51]
- Baek, S.-H., Zeltner, T., Ku, H., Hwang, I., Tong, X., Jakob, W., & Kim, M. H. (2020). Image-based acquisition and modeling of polarimetric reflectance. ACM Transactions on Graphics, 39(4), 139. https://doi.org/10.1145/3386569.3392387 [G45]
- Bagher, M. M., Soler, C., & Holzschuch, N. (2012). Accurate fitting of measured reflectances using a shifted gamma micro-facet distribution. Computer Graphics Forum, 31(4). https://inria.hal.science/hal-00702304 [T23]
- Barnes, P. Y., Early, E. A., & Parr, A. C. (1998a). NIST measurement services: Spectral reflectance. https://nvlpubs.nist.gov/nistpubs/Legacy/SP/nistspecialpublication250-48.pdf [G21]
- Barnes, P. Y., Early, E. A., & Parr, A. C. (1998b). Spectral reflectance. https://doi.org/10.6028/NIST.SP.250-48 [N33]
- Basri, R., Jacobs, D., & Kemelmacher, I. (2007). Photometric stereo with general, unknown lighting. International Journal of Computer Vision, 72(3), 239–257. https://doi.org/10.1007/s11263-006-8815-7 [V26]
- Ben-Ezra, M., Wang, J., Wilburn, B., Li, X., & Ma, L. (2008). An LED-only BRDF measurement device. Proceedings of the IEEE Conference on Computer Vision and Pattern Recognition. https://doi.org/10.1109/CVPR.2008.4587766 [G17]
- Blender Manual. (n.d.). Principled BSDF. https://docs.blender.org/manual/en/latest/render/shader_nodes/shader/principled.html [T48]
- Blender manual: PLY, OBJ, glTF 2.0, formats. (n.d.). https://docs.blender.org/manual/en/latest/files/import_export/ply.html [S16]
- Blinn, J. F. (1977). Models of light reflection for computer synthesized pictures. Proc. SIGGRAPH ’77. https://doi.org/10.1145/563858.563893 [T9]
- Bonvoisin, J., Mies, R., Boujut, J.-F., & Stark, R. (2017). What is the ’source’ of open source hardware? Journal of Open Hardware, 1(1). https://doi.org/10.5334/joh.7 [H34]
- Born, M., & Wolf, E. (2019). Principles of optics (7th ed.). https://www.cambridge.org/9781108477437 [T30]
- Bouguet, J.-Y. (2022). Camera calibration toolbox for Matlab. https://doi.org/10.22002/D1.20164 [V5]
- BQ ciclop scanner + horus software. (n.d.). https://github.com/bqlabs/ciclop [V55]
- Bradski, G. (2000). The OpenCV library. Dr. Dobb’s Journal of Software Tools. https://github.com/opencv/opencv/wiki/CiteOpenCV [H49]
- Brown, D. C. (1971). Close-range camera calibration. Photogrammetric Engineering, 37(8), 855–866. https://www.semanticscholar.org/paper/Close-Range-Camera-Calibration-Brown/1150007b62a3c7dac99c2c8f85c63bfab74891af [V4]
- Burley, B. (2012). Physically-based shading at Disney. Practical Physically Based Shading in Film and Game Production. https://static1.squarespace.com/static/58586fa5ebbd1a60e7d76d3e/t/593a3afa46c3c4a376d779f6/1496988449807/s2012_pbs_disney_brdf_notes_v2.pdf [T33]
- Burley, B. (2015). Extending the Disney BRDF to a BSDF with integrated subsurface scattering. https://blog.selfshadow.com/publications/s2015-shading-course/burley/s2015_pbs_disney_bsdf_notes.pdf [T34]
- CadQuery 2.x, parametric CAD in Python. (n.d.). https://pypi.org/project/cadquery/ [H56]
- CERN. (n.d.). CERN open hardware licence version 2. https://www.ohwr.org/cernohl [H32]
- Chang, C., & Tran, T. (2025). Mastering precision: Understanding microstepping in motion control. Analog Dialogue, 59(2). https://www.analog.com/en/resources/analog-dialogue/articles/mastering-precision-understanding-microstepping.html [H23]
- Chen, G., Dong, Y., Peers, P., Zhang, J., & Tong, X. (2014). Reflectance scanning: Estimating shading frame and BRDF with generalized linear light sources. ACM Transactions on Graphics, 33(4). https://doi.org/10.1145/2601097.2601180 [G43]
- Chitnis, S., Sole, A., & Chandran, S. (2025). Spectral bidirectional reflectance distribution function simplification. Journal of Imaging, 11(1), 18. https://doi.org/10.3390/jimaging11010018 [G37]
- CIE. (1995). Method of measuring and specifying colour rendering properties of light sources. https://cie.co.at/publications/method-measuring-and-specifying-colour-rendering-properties-light-sources [N15]
- CIE. (2006). A framework for the measurement of visual appearance. https://cie.co.at/publications/framework-measurement-visual-appearance [N12]
- CIE. (2017). CIE 2017 colour fidelity index for accurate scientific use. https://doi.org/10.25039/TR.224.2017 [N16]
- CIE. (2018). Colorimetry, 4th edition. https://doi.org/10.25039/TR.015.2018 [N13]
- CIE. (2020). ILV: International lighting vocabulary, 2nd edition. https://doi.org/10.25039/S017.2020 [N14]
- Collins, J. T., Knapper, J., Stirling, J., …, & Bowman, R. (2020). Robotic microscopy for everyone: The OpenFlexure microscope. Biomedical Optics Express, 11(5), 2447–2460. https://doi.org/10.1364/BOE.385729 [H35]
- COLMAP FAQ. (n.d.). Reconstruct sparse/dense model from known camera poses. https://colmap.github.io/faq.html [S2]
- COLMAP output format. (n.d.). https://colmap.github.io/format.html [S1]
- Cook, R., & Torrance, K. (1982). A reflectance model for computer graphics. ACM Transactions on Graphics, 1(1). [R8]
- Cornell gonioreflectometer. (n.d.). http://w1.graphics.cornell.edu/research/measure/gonio.html [R10]
- Cornell measurement data. (n.d.). https://www.graphics.cornell.edu/online/measurements/ [R12]
- Curless, B., & Levoy, M. (1996). A volumetric method for building complex models from range images. Proc. SIGGRAPH. https://doi.org/10.1145/237170.237269 [V44]
- Dana, K. J., Ginneken, B. van, Nayar, S. K., & Koenderink, J. J. (1999). Reflectance and texture of real-world surfaces. ACM Transactions on Graphics, 18(1), 1–34. https://doi.org/10.1145/300776.300778 [G11]
- Dana, K. J., & Wang, J. (2004). Device for convenient measurement of spatially varying bidirectional reflectance. Journal of the Optical Society of America A, 21(1), 1–12. https://doi.org/10.1364/JOSAA.21.000001 [G14]
- Daniilidis, K. (1999). Hand-eye calibration using dual quaternions. International Journal of Robotics Research, 18(3), 286–298. https://doi.org/10.1177/02783649922066213 [V12]
- Debevec, P., Hawkins, T., Tchou, C., Duiker, H.-P., Sarokin, W., & Sagar, M. (2000). Acquiring the reflectance field of a human face. Proc. SIGGRAPH. https://doi.org/10.1145/344779.344855 [V48]
- Debevec, P., & Malik, J. (1997). Recovering high dynamic range radiance maps from photographs. Proc. SIGGRAPH ’97. https://pauldebevec.com/Research/HDR/debevec-siggraph97.pdf [R5]
- Dhankania, K. C., & Pearce, J. M. (2016). Open source laboratory sample rotator mixer and shaker. HardwareX. http://www.sciencedirect.com/science/article/pii/S2468067216300049 [H41]
- Dornaika, F., & Horaud, R. (1998). Simultaneous robot-world and hand-eye calibration. IEEE Transactions on Robotics and Automation, 14(4), 617–622. https://doi.org/10.1109/70.704233 [V14]
- Dorsey, J., Rushmeier, H., & Sillion, F. (2008). Digital modeling of material appearance. Morgan Kaufmann. https://booksite.elsevier.com/samplechapters/9780122211812/Sample_Chapters/01~Front_Matter.pdf [G2]
- Dupuy, J., & Benyoub, A. (2023). Sampling visible GGX normals with spherical caps. Computer Graphics Forum, 42(8). https://doi.org/10.1111/cgf.14867 [T20]
- Dupuy, J., Heitz, E., Iehl, J.-C., Poulin, P., & Ostromoukhov, V. (2015). Extracting microfacet-based BRDF parameters from arbitrary materials with power iterations. Computer Graphics Forum, 34(4), 21–30. https://doi.org/10.1111/cgf.12675 [T26]
- Dupuy, J., & Jakob, W. (2018). An adaptive parameterization for efficient material acquisition and rendering. https://rgl.epfl.ch/publications/Dupuy2018Adaptive [R15]
- Durell, C., Scharpf, D., McKee, G., L’Heureux, M., Georgiev, G., Obein, G., & Cooksey, C. (2015). Creation and validation of sintered PTFE BRDF targets & standards. Proceedings of SPIE. https://tsapps.nist.gov/publication/get_pdf.cfm?pub_id=919590 [G24]
- Dwersteg (Analog Devices/Trinamic), B. (n.d.). AN-026: Programmable adaptive microstep table. https://www.analog.com/en/resources/app-notes/an-026.html [H3]
- Elsevier. (n.d.). Guide for authors – HardwareX. https://doi.org/10.5281/zenodo.5078227 [H36]
- EMVA. (2021). Standard 1288: Standard for characterization of image sensors and cameras. https://www.emva.org/standards-technology/emva-1288/ [N24]
- Epic Games. (n.d.). Physically based materials in Unreal engine. https://dev.epicgames.com/documentation/en-us/unreal-engine/physically-based-materials-in-unreal-engine [T46]
- Ericson, C. (2005). Real-time collision detection. Morgan Kaufmann. [R9]
- Espressif Systems. (n.d.-a). ESP32 series datasheet. https://www.espressif.com/sites/default/files/documentation/esp32_datasheet_en.pdf [H6]
- Espressif Systems. (n.d.-b). ESP32 technical reference manual. https://documentation.espressif.com/esp32_technical_reference_manual_en.pdf [H5]
- F. Schröder, master’s thesis, 2019. (2019). https://f-schroeder.github.io/publication/masterthesis/ [R37]
- FabScan, media computing group, RWTH aachen university. (n.d.). https://hci.rwth-aachen.de/fabscan [V54]
- Fairchild, M. D. (2013). Color appearance models (3rd ed.). https://doi.org/10.1002/9781118653128 [N22]
- Filip, J., & Haindl, M. (2009). Bidirectional texture function modeling: A state of the art survey. IEEE Transactions on Pattern Analysis and Machine Intelligence, 31(11). https://doi.org/10.1109/TPAMI.2008.246 [G5]
- Filip, J., Vávra, R., & Krupička, M. (2014). Rapid material appearance acquisition using consumer hardware. Sensors, 14(10), 19785–19805. https://doi.org/10.3390/s141019785 [G38]
- Fitzgibbon, A. W., Cross, G., & Zisserman, A. (1998). Automatic 3D model construction for turn-table sequences. https://doi.org/10.1007/3-540-49437-5_11 [S9]
- Fritz Faulhaber GmbH, Dr. (n.d.). Stepper motor technical note: Microstepping myths and realities. https://www.faulhaber.com/fileadmin/user_upload/Support/dff_200276_whitepaper_microstepping_8cb.pdf [H21]
- Furukawa, Y., & Hernández, C. (2015). Multi-view stereo: A tutorial. Foundations and Trends in Computer Graphics and Vision, 9. https://doi.org/10.1561/0600000052 [V39]
- Furukawa, Y., & Ponce, J. (2010). Accurate, dense, and robust multiview stereopsis. IEEE Transactions on Pattern Analysis and Machine Intelligence, 32(8), 1362–1376. https://doi.org/10.1109/TPAMI.2009.161 [V38]
- Garrido-Jurado, S., Muñoz-Salinas, R., Madrid-Cuevas, F. J., & Marín-Jiménez, M. J. (2014). Automatic generation and detection of highly reliable fiducial markers under occlusion. Pattern Recognition, 47(6), 2280–2292. https://doi.org/10.1016/j.patcog.2014.01.005 [V7]
- Gates Corporation. (n.d.-a). Light power & precision drive design manual. https://www.gates.com/content/dam/documents-library/catalogs/light-power-and-precision-manual.pdf [H17]
- Gates Corporation. (n.d.-b). PowerGrip GT2 belt drives – drive design manual. https://docs.rs-online.com/5016/0900766b8002d3b7.pdf [H16]
- Gathering for Open Science Hardware. (n.d.). GOSH manifesto. https://openhardware.science/gosh-manifesto/ [H33]
- GatherLab/goniometer. (n.d.). https://github.com/GatherLab/Goniometer [R38]
- Georgiev, I., Portsmouth, J., Andersson, Z., Herubel, A., King, A., Ogaki, S., & Servant, F. (n.d.). Autodesk standard surface. https://autodesk.github.io/standard-surface/ [T49]
- Ghosh, A., Chen, T., Peers, P., Wilson, C. A., & Debevec, P. (2009). Estimating specular roughness and anisotropy from second order spherical gradient illumination. Eurographics Symposium on Rendering. https://www.cs.wm.edu/~ppeers/publications/Ghosh2009ESR/Ghosh_EGSR2009.pdf [G41]
- Ghosh, A., Chen, T., Peers, P., Wilson, C. A., & Debevec, P. (2010). Circularly polarized spherical illumination reflectometry. ACM SIGGRAPH Asia. https://vgl.ict.usc.edu/Research/CPSIR/ [G42]
- Ghosh, A., Fyffe, G., Tunwattanapong, B., Busch, J., Yu, X., & Debevec, P. (2011). Multiview face capture using polarized spherical gradient illumination. ACM Transactions on Graphics, 30(6). https://doi.org/10.1145/2070781.2024163 [V50]
- GitHub Docs. (n.d.-a). Configuring a publishing source for your GitHub pages site. https://docs.github.com/en/pages/getting-started-with-github-pages/configuring-a-publishing-source-for-your-github-pages-site [H45]
- GitHub Docs. (n.d.-b). REST API endpoints for milestones. https://docs.github.com/en/rest/issues/milestones [H44]
- Goldman, D. B., Curless, B., Hertzmann, A., & Seitz, S. M. (2005). Shape and spatially-varying BRDFs from photometric stereo. https://doi.org/10.1109/ICCV.2005.219 [S15]
- Goodman, J. W. (2017). Introduction to Fourier optics (1st ed.). https://doi.org/10.1063/1.3035549 [N46]
- Granados, M., Ajdin, B., Wand, M., Theobalt, C., Seidel, H.-P., & Lensch, H. P. A. (2010). Optimal HDR reconstruction with linear digital cameras. Proceedings of the IEEE Conference on Computer Vision and Pattern Recognition. https://vcai.mpi-inf.mpg.de/projects/opthdr/ [V23]
- Grbl project (gnea). (n.d.). An open source, embedded, high performance g-code-parser and CNC milling controller. https://github.com/gnea/grbl [H24]
- grblHAL. (n.d.). grblHAL core code and master wiki. https://github.com/grblHAL/core [H25]
- Griwodz, C. et al. (2021). AliceVision meshroom: An open-source 3D reconstruction pipeline. Proc. ACM MMSys. https://doi.org/10.1145/3458305.3478443 [V40]
- Grossberg, M. D., & Nayar, S. K. (2003). What is the space of camera response functions? Proceedings of the IEEE Conference on Computer Vision and Pattern Recognition. https://doi.org/10.1109/TPAMI.2004.88 [V21]
- Guarnera, D., Guarnera, G. C., Ghosh, A., Denk, C., & Glencross, M. (2016). BRDF representation and acquisition. Computer Graphics Forum, 35(2), 625–650. https://doi.org/10.1111/cgf.12867 [G3]
- Gulbrandsen, O. (2014). Artist friendly metallic Fresnel. Journal of Computer Graphics Techniques, 3(4), 64–72. https://jcgt.org/published/0003/04/03/paper.pdf [T31]
- Guy, R., & Agopian, M. (n.d.). Physically based rendering in Filament. https://google.github.io/filament/Filament.md.html [T39]
- Han, J. Y., & Perlin, K. (2003). Measuring bidirectional texture reflectance with a kaleidoscope. ACM Transactions on Graphics, 22(3). https://doi.org/10.1145/882262.882341 [G13]
- Hanrahan, P. (2016). Reflection models I: Ideal materials. [R2]
- Hardeberg, J. Y. (2001). Acquisition and reproduction of color images: Colorimetric and multispectral approaches. https://doi.org/10.1002/col.10073 [N43]
- Hardeberg, J. Y. (2004). Filter selection for multispectral color image acquisition. Journal of Imaging Science and Technology, 48(2). https://doi.org/10.2352/J.ImagingSci.Technol.2004.48.2.art00005 [N44]
- Harris, C. R., Millman, K. J., Walt, S. J. van der, et al. (2020). Array programming with NumPy. Nature, 585, 357–362. https://doi.org/10.1038/s41586-020-2649-2 [H47]
- Hartley, R., & Zisserman, A. (2004). Multiple view geometry in computer vision (2nd ed.). https://doi.org/10.1017/CBO9780511811685 [V8]
- Hasinoff, S. W., Durand, F., & Freeman, W. T. (2010). Noise-optimal capture for high dynamic range photography. Proceedings of the IEEE Conference on Computer Vision and Pattern Recognition, 553–560. https://doi.org/10.1109/CVPR.2010.5540167 [V22]
- Heikkilä, J., & Silvén, O. (1997). A four-step camera calibration procedure with implicit image correction. Proceedings of the IEEE Conference on Computer Vision and Pattern Recognition, 1106–1112. https://doi.org/10.1109/CVPR.1997.609468 [V3]
- Heitz, E. (2014). Understanding the masking-shadowing function in microfacet-based BRDFs. Journal of Computer Graphics Techniques, 3(2), 48–107. https://jcgt.org/published/0003/02/03/paper.pdf [T17]
- Heitz, E. (2018). Sampling the GGX distribution of visible normals. Journal of Computer Graphics Techniques, 7(4), 1–13. https://jcgt.org/published/0007/04/01/paper.pdf [T19]
- Heitz, E., & d’Eon, E. (2014). Importance sampling microfacet-based BSDFs using the distribution of visible normals. Computer Graphics Forum, 33(4), 103–112. https://doi.org/10.1111/cgf.12417 [T18]
- Heitz, E., Hanika, J., d’Eon, E., & Dachsbacher, C. (2016). Multiple-scattering microfacet BSDFs with the Smith model. ACM Transactions on Graphics, 35(4), 58. https://doi.org/10.1145/2897824.2925943 [T21]
- Hernández Esteban, C., & Schmitt, F. (2004). Silhouette and stereo fusion for 3D object modeling. Computer Vision and Image Understanding, 96(3), 367–392. https://www.sciencedirect.com/science/article/abs/pii/S1077314204000542 [V42]
- Hertzmann, A., & Seitz, S. M. (2005). Example-based photometric stereo: Shape reconstruction with general, varying BRDFs. IEEE Transactions on Pattern Analysis and Machine Intelligence, 27(8), 1254–1264. https://doi.org/10.1109/TPAMI.2005.158 [V25]
- Hietanen, I., Heikkinen, I. T. S., Savin, H., & Pearce, J. M. (2018). Approaches to open source 3-D printable probe positioners and micromanipulators for probe stations. HardwareX. https://doi.org/10.1016/j.ohx.2018.e00042 [H39]
- Hoffman, N. (2015). Physics and math of shading. Physically Based Shading in Theory and Practice. https://blog.selfshadow.com/publications/s2015-shading-course/hoffman/s2015_pbs_physics_math_slides.pdf [T38]
- Höpe, A. et al. (2012). ARGon3: ’3D appearance robot-based gonioreflectometer’ at PTB. Review of Scientific Instruments, 83(4), 045102. https://pubs.aip.org/aip/rsi/article/83/4/045102/355039/ARGon3-3D-appearance-robot-based [G27]
- Höpe, A. et al. (2014). Multidimensional reflectometry for industry (xD-reflect) an European research project. Proceedings of SPIE. https://doi.org/10.1117/12.2035981 [G28]
- Höpe, A., & Hauer, K.-O. (2010). Three-dimensional appearance characterization of diffuse standard reflection materials. Metrologia, 47(3), 295. https://doi.org/10.1088/0026-1394/47/3/021 [G26]
- Höpe, A., Hünerhoff, D., & Hauer, K.-O. (2006). Robot-based gonioreflectometer. In Industrial robotics: Programming, simulation and applications (pp. 624–632). (ed. L. K. Huat). https://cdn.intechopen.com/pdfs/284/InTech-Robot_based_gonioreflectometer.pdf [G25]
- Hsia, J. J., & Barnes, P. Y. (1995). 45°/0° reflectance factors of pressed polytetrafluoroethylene (PTFE) powder. https://doi.org/10.6028/NIST.TN.1413 [N32]
- Hunt, R. W. G., & Pointer, M. R. (2011). Measuring colour (4th ed.). https://doi.org/10.1002/9781119975595 [N23]
- IEC. (n.d.). Photobiological safety of lamps and lamp systems. https://doi.org/10.3403/30149289 [N47]
- IEC, “audio/video, information and communication technology equipment. (n.d.). https://doi.org/10.3403/30347376U [N51]
- IEC, “multimedia systems and equipment. (n.d.). https://webstore.ansi.org/standards/iec/iec61966ed1999 [N28]
- IEC, “safety of machinery. (n.d.). https://doi.org/10.3403/30238348 [N49]
- IES. (n.d.). Technical memorandum: IES method for evaluating light source color rendition. https://store.ies.org/product/technical-memorandum-ies-method-for-evaluating-light-source-color-rendition/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 [N18]
- Ikehata, S. (2018). CNN-PS: CNN-based photometric stereo for general non-convex surfaces. European Conference on Computer Vision. https://doi.org/10.1007/978-3-030-01267-0_1 [V34]
- Imai, F. H., Berns, R. S., & Tzeng, D.-Y. (2000). A comparative analysis of spectral reflectance estimated in various spaces using a trichromatic camera system. Journal of Imaging Science and Technology, 44(4), 280–287. https://doi.org/10.2352/J.ImagingSci.Technol.2000.44.4.art00003 [N41]
- Imai, F. H., Rosen, M. R., & Berns, R. S. (2000). Comparison of spectrally narrow-band capture versus wide-band with a priori sample analysis for spectral reflectance estimation. Color and Imaging Conference, 8(1), 234–241. https://doi.org/10.2352/CIC.2000.8.1.art00043 [N42]
- ISO, “graphic technology and photography. (n.d.). https://www.iso.org/standard/35835.html [N27]
- ISO, “paints and varnishes. (n.d.). https://www.iso.org/standard/56807.html [N10]
- ISO, “photography. (n.d.-a). https://www.iso.org/standard/79169.html [N25]
- ISO, “photography. (n.d.-b). https://www.iso.org/standard/82233.html [N26]
- ISO, “safety of machinery. (n.d.-a). https://doi.org/10.3403/30265059 [N48]
- ISO, “safety of machinery. (n.d.-b). https://doi.org/10.3403/30201665 [N50]
- J. Filip et al., specular BRDF with a goniometer, 2017. (2017). https://staff.utia.cas.cz/filip/papers/filip17brdf.pdf [R17]
- Jakob, W., & Hanika, J. (2019). A low-dimensional function space for efficient spectral upsampling. Computer Graphics Forum, 38(2), 147–155. https://doi.org/10.1111/cgf.13626 [T53]
- Jones, R., Haufe, P., Sells, E., Iravani, P., Olliver, V., Palmer, C., & Bowyer, A. (2011). RepRap – the replicating rapid prototyper. Robotica, 29(1), 177–191. https://doi.org/10.1017/S026357471000069X [H30]
- K. A. G. Smet, CRI_CIE_rf_2017 calculator (MATLAB/excel). (n.d.). https://github.com/ksmet1977/CRI_CIE_Rf_2017 [N17]
- Kajiya, J. T. (1986). The rendering equation. Proc. SIGGRAPH ’86, Computer Graphics, 20(4), 143–150. https://doi.org/10.1145/15922.15902 [T1]
- Karis, B. (2013). Real shading in Unreal engine 4. Physically Based Shading in Theory and Practice. https://cdn2.unrealengine.com/Resources/files/2013SiggraphPresentationsNotes-26915738.pdf [T35]
- Karis, B. (2014). Physically based shading on mobile. [T57]
- Kavoosighafi, B. et al. (2025). Perceived quality of BRDF models. Computer Graphics Forum. https://doi.org/10.1111/cgf.70162 [T28]
- Kazhdan, M., Bolitho, M., & Hoppe, H. (2006). Poisson surface reconstruction. Eurographics Symposium on Geometry Processing. https://diglib.eg.org/items/245d6ba1-0209-4365-a4a4-16ce46421620 [V45]
- Kazhdan, M., & Hoppe, H. (2013). Screened Poisson surface reconstruction. ACM Transactions on Graphics, 32(3), 29. https://doi.org/10.1145/2487228.2487237 [V46]
- Khronos, glTF sample viewer. (n.d.). https://github.com/KhronosGroup/glTF-Sample-Viewer [T45]
- Khronos Group. (n.d.). glTF 2.0 specification. https://registry.khronos.org/glTF/specs/2.0/glTF-2.0.html#metallic-roughness-material [T40]
- Khronos, KHR_materials_anisotropy. (n.d.). https://github.com/KhronosGroup/glTF/blob/main/extensions/2.0/Khronos/KHR_materials_anisotropy/README.md [T41]
- Khronos, KHR_materials_sheen, KHR_materials_clearcoat. (n.d.). https://github.com/KhronosGroup/glTF/blob/main/extensions/2.0/Khronos/KHR_materials_sheen/README.md [T42]
- Khronos, KHR_materials_specular, KHR_materials_ior. (n.d.). https://github.com/KhronosGroup/glTF/blob/main/extensions/2.0/Khronos/KHR_materials_specular/README.md [T43]
- Khronos, KHR_texture_transform. (n.d.). https://github.com/KhronosGroup/glTF/blob/main/extensions/2.0/Khronos/KHR_texture_transform/README.md [T44]
- KiCad EDA. (n.d.). https://kicad.org/ [H43]
- Kingslake, R., & Johnson, R. B. (2010). Lens design fundamentals (2nd ed.). https://doi.org/10.1016/B978-0-12-374301-5.00008-5 [N45]
- Kramer, T. R., Proctor, F. M., & Messina, E. R. (2000). The NIST RS274NGC interpreter – version 3. https://www.nist.gov/publications/nist-rs274ngc-interpreter-version-3 [H27]
- Kulla, C., & Conty, A. (2017). Revisiting physically based shading at Imageworks. https://blog.selfshadow.com/publications/s2017-shading-course/imageworks/s2017_pbs_imageworks_slides_v2.pdf [T37]
- Kurt, M., Szirmay-Kalos, L., & Křivánek, J. (2010). An anisotropic BRDF model for fitting and Monte Carlo rendering. ACM SIGGRAPH Computer Graphics, 44(1), 1–15. https://doi.org/10.1145/1722991.1722996 [G18]
- Kutulakos, K. N., & Seitz, S. M. (2000). A theory of shape by space carving. International Journal of Computer Vision. https://doi.org/10.1023/A:1008191222954 [S7]
- Labsphere. (n.d.). Technical guide: Reflectance materials and coatings. https://www.systems-eng.co.jp/dcms_media/other/Guide_Reflectance_Materials_Coatings.pdf [N34]
- Lafortune, E. P. F., Foo, S.-C., Torrance, K. E., & Greenberg, D. P. (1997). Non-linear approximation of reflectance functions. Proc. SIGGRAPH ’97. https://doi.org/10.1145/258734.258801 [T14]
- Lagarde, S., & Rousiers, C. de. (2014). Moving Frostbite to physically based rendering 3.0. https://seblagarde.wordpress.com/wp-content/uploads/2015/07/course_notes_moving_frostbite_to_pbr_v3.pdf [T36]
- Lanevski, D. et al. (2022). Machine-readable universal data format for bidirectional reflectance distribution function and BiRDview—an open-source web-based application for viewing and comparing bidirectional reflectance data. Color Research & Application. https://doi.org/10.1002/col.22790 [G52]
- Laurentini, A. (1994). The visual hull concept for silhouette-based image understanding. IEEE Transactions on Pattern Analysis and Machine Intelligence, 16(2). https://doi.org/10.1109/34.273735 [S5]
- Lavoué, G., Bonneel, N., Farrugia, J.-P., & Soler, C. (2021). Perceptual quality of BRDF approximations: Dataset and metrics. Computer Graphics Forum, 40(2). https://doi.org/10.1111/cgf.142636 [T27]
- Le Breton, R., Ged, G., & Obein, G. (2015). Out of plane BRDF measurement at LNE-cnam using ’ConDOR’ our primary goniospectrophotometer. Proc. 28th CIE Session. https://inm.cnam.fr/gael-obein-71373.kjsp [G30]
- Lévy, B., Petitjean, S., Ray, N., & Maillot, J. (2002). Least squares conformal maps for automatic texture atlas generation. ACM Transactions on Graphics, 21(3), 362–371. https://doi.org/10.1145/566654.566590 [V56]
- Linux kernel documentation. (n.d.). The linux USB video class (UVC) driver. https://www.kernel.org/doc/html/latest/userspace-api/media/drivers/uvcvideo.html [H15]
- LinuxCNC. (n.d.). Homing configuration. https://linuxcnc.org/docs/html/config/ini-homing.html [H26]
- Loctite fun-tak 2 oz. (n.d.). https://www.staples.com/Loctite-Fun-Tak-2-oz-Mounting-Adhesive-Putty-1270884/product_1480018 [S20]
- Logothetis, F., Quéau, Y., Mecca, R., & Cipolla, R. (2017). Semi-calibrated near-light photometric stereo. SSVM. https://doi.org/10.1007/978-3-319-58771-4_52 [V31]
- Lorensen, W. E., & Cline, H. E. (1987). Marching cubes: A high resolution 3D surface construction algorithm. Proc. SIGGRAPH. https://doi.org/10.1145/37401.37422 [V43]
- Löw, J., Kronander, J., Ynnerman, A., & Unger, J. (2012). BRDF models for accurate and efficient rendering of glossy surfaces. ACM Transactions on Graphics, 31(1), 9. https://doi.org/10.1145/2077341.2077350 [T25]
- Lyngby, R. A., Matthiassen, J. B., Frisvad, J. R., Dahl, A. B., & Aanæs, H. (2019). Using a robotic arm for measuring BRDFs. SCIA 2019. https://doi.org/10.1007/978-3-030-20205-7_16 [G39]
- M. Stokes, M. Anderson, S. Chandrasekar, R. Motta, “a standard default color space for the internet. (n.d.). https://www.w3.org/Graphics/Color/sRGB.html [N29]
- Ma, W.-C., Hawkins, T., Peers, P., Chabert, C.-F., Weiss, M., & Debevec, P. (2007). Rapid acquisition of specular and diffuse normal maps from polarized spherical gradient illumination. Eurographics Symposium on Rendering. https://diglib.eg.org/items/da04b92c-39fe-41d1-a658-a8535521521c [V49]
- Marlin Firmware. (n.d.). Trinamic drivers. https://marlinfw.org/docs/hardware/tmc_drivers.html [H4]
- Marschner, S. R., Westin, S. H., Lafortune, E. P. F., & Torrance, K. E. (2000). Image-based bidirectional reflectance distribution function measurement. Applied Optics, 39(16), 2592–2600. https://doi.org/10.1364/AO.39.002592 [G12]
- Matplotlib. (n.d.). https://matplotlib.org/ [H58]
- Matusik, W., Buehler, C., Raskar, R., Gortler, S. J., & McMillan, L. (2000). Image-based visual hulls. Proc. SIGGRAPH. https://doi.org/10.1145/344779.344951 [V41]
- Matusik, W., Pfister, H., Brand, M., & McMillan, L. (2003). Efficient isotropic BRDF measurement. Proc. 14th Eurographics Workshop on Rendering. https://www.pbr-book.org/4ed/Reflection_Models/Further_Reading [G15]
- Matusik, W., Pfister, H., Brand, M., & McMillan, L. (2023). BRDF database – bidirectional reflectance distribution function. https://doi.org/10.5281/zenodo.8101681 [G51]
- Mecca, R., Wetzler, A., Bruckstein, A. M., & Kimmel, R. (2014). Near field photometric stereo with point light sources. SIAM Journal on Imaging Sciences, 7(4), 2732–2770. https://doi.org/10.1137/140968100 [V29]
- MERL BRDF database. (n.d.). Retrieved [R13]
- Meshroom / AliceVision. (n.d.). https://alicevision.org/ [S10]
- MicroPython ’machine.UART‘. (n.d.). https://docs.micropython.org/en/latest/library/machine.UART.html [H55]
- Micropython-lib SSD1306 driver. (n.d.). https://github.com/micropython/micropython-lib/tree/master/micropython/drivers/display/ssd1306 [H52]
- Mitsuba 3 documentation. (n.d.). BSDFs. https://mitsuba.readthedocs.io/en/stable/src/generated/plugins_bsdfs.html [T7]
- Mitsunaga, T., & Nayar, S. K. (1999). Radiometric self calibration. Proceedings of the IEEE Conference on Computer Vision and Pattern Recognition, 374–380. https://doi.org/10.1109/CVPR.1999.786966 [V19]
- Molloy, E., Patrick, H., Hauer, K.-O., Hünerhoff, D., & Quast, T. (2026). Comparison of bidirectional reflectance distribution function scales over the hemisphere. Applied Optics, 65(18), 6358–6365. https://doi.org/10.1364/AO.603369 [G29]
- Montes, R., & Ureña, C. (2012). An overview of BRDF models. https://digibug.ugr.es/bitstream/handle/10481/19751/rmontes_LSI-2012-001TR.pdf [T5]
- Murray-Coleman, J. F., & Smith, A. M. (1990). The automated measurement of BRDFs and their application to luminaire modeling. Journal of the Illuminating Engineering Society, 19, 87–99. https://doi.org/10.1080/00994480.1990.10747944 [G8]
- MVTec HALCON ’photometric_stereo‘ reference. (n.d.). https://www.mvtec.com/doc/halcon/13/en/photometric_stereo.html [S8]
- Nadal, M. E., & Thompson, E. A. (2001). NIST reference goniophotometer for specular gloss measurements. Journal of Coatings Technology, 73(917), 73–80. https://www.paint.org/wp-content/uploads/2021/09/jctJUNE01-Nadal.pdf [N11]
- Narkowicz, K. (2016). ACES filmic tone mapping curve. [T58]
- Nayar, S. K., Fang, X.-S., & Boult, T. (1997). Separation of reflection components using color and polarization. International Journal of Computer Vision, 21(3), 163–186. https://doi.org/10.1023/A:1007937815113 [V51]
- Nehab, D., Rusinkiewicz, S., Davis, J., & Ramamoorthi, R. (2005). Efficiently combining positions and normals for precise 3D geometry. ACM Transactions on Graphics, 24(3). https://gfx.cs.princeton.edu/pubs/Nehab_2005_ECP/index.php [V36]
- Ngan, A., Durand, F., & Matusik, W. (2005). Experimental analysis of BRDF models. Eurographics Symposium on Rendering. https://diglib.eg.org/items/b3a3223e-ad94-4366-8ae7-fce371c08d04 [G16]
- Nicodemus, F. E., Richmond, J. C., Hsia, J. J., Ginsberg, I. W., & Limperis, T. (1977). Geometrical considerations and nomenclature for reflectance. NBS Monograph, 160. https://doi.org/10.6028/NBS.MONO.160 [G1]
- Nielsen, J. B., Jensen, H. W., & Ramamoorthi, R. (2015). On optimal, minimal BRDF sampling for reflectance acquisition. ACM Transactions on Graphics, 34(6), 186. https://www.pbr-book.org/4ed/Reflection_Models/Further_Reading [G46]
- Nimier-David, M., Vicini, D., Zeltner, T., & Jakob, W. (2019). Mitsuba 2: A retargetable forward and inverse renderer. ACM Transactions on Graphics, 38(6), 203. https://doi.org/10.1145/3355089.3356498 [T6]
- Numpy-stl. (n.d.). https://pypi.org/project/numpy-stl/ [H57]
- Obein, G. (2021). The measurement of appearance. Proc. Int. School of Physics “Enrico Fermi”. https://doi.org/10.3254/ENFI210025 [G7]
- Ohno, Y. (2005). Spectral design considerations for white LED color rendering. Optical Engineering, 44(11). https://doi.org/10.1117/1.2130694 [N20]
- Open Source Hardware Association. (n.d.). Open source hardware (OSHW) definition 1.0. https://oshwa.org/definition/ [H31]
- OpenCV, camera calibration and 3D reconstruction (’calibrateHandEye‘, ’calibrateRobotWorldHandEye‘). (n.d.). https://docs.opencv.org/4.13.0/d9/d0c/group__calib3d.html [V18]
- OpenCV ChArUco calibration. (n.d.). https://docs.opencv.org/4.13.0/da/d13/tutorial_aruco_calibration.html [S12]
- OpenCV ’solvePnP‘. (n.d.). https://docs.opencv.org/4.13.0/d5/d1f/calib3d_solvePnP.html [S11]
- OpenMVS. (n.d.). https://github.com/cdcseacave/openMVS [S17]
- OpenScan (Raspberry Pi photogrammetry scanner). (n.d.). https://openscan.eu/pages/openscan-mini [V53]
- Oren, M., & Nayar, S. K. (1994). Generalization of Lambert’s reflectance model. Proc. SIGGRAPH ’94. https://doi.org/10.1145/192161.192213 [T13]
- Oriental Motor USA. (n.d.). Stepper motor basics. https://www.orientalmotor.com/stepper-motors/technology/stepper-motor-basics.html [H19]
- Papadhimitri, T., & Favaro, P. (2013). A new perspective on uncalibrated photometric stereo. Proceedings of the IEEE Conference on Computer Vision and Pattern Recognition. https://openaccess.thecvf.com/content_cvpr_2013/papers/Papadhimitri_A_New_Perspective_2013_CVPR_paper.pdf [V33]
- Park, F. C., & Martin, B. J. (1994). Robot sensor calibration: Solving AX=XB on the Euclidean group. IEEE Transactions on Robotics and Automation, 10(5), 717–721. https://doi.org/10.1109/70.326576 [V11]
- Park, J.-I., Lee, M.-H., Grossberg, M. D., & Nayar, S. K. (2007). Multispectral imaging using multiplexed illumination. Proceedings of the IEEE International Conference on Computer Vision, 1–8. https://doi.org/10.1109/ICCV.2007.4409090 [N37]
- Patrick, H., Cooksey, C., Germer, T. A., Nadal, M. E., & Zarobila, C. (2021). Bidirectional reflectance capabilities of the NIST robotic optical scattering instrument. Applied Optics, 60(28), 8774. https://doi.org/10.1364/AO.435117 [G23]
- Pearce, J. M. (2012). Building research equipment with free, open-source hardware. Science, 337(6100), 1303–1304. https://doi.org/10.1126/science.1228183 [H28]
- Pearce, J. M. (2014). Open-source lab: How to build your own hardware and reduce research costs. Elsevier. https://doi.org/10.1016/C2012-0-07249-3 [H29]
- Peters, C., Merzbach, S., Hanika, J., & Dachsbacher, C. (2019). Using moments to represent bounded signals for spectral rendering. ACM Transactions on Graphics, 38(4), 136. https://doi.org/10.1145/3306346.3322964 [T54]
- Pharr, M., Jakob, W., & Humphreys, G. (2023). Physically based rendering: From theory to implementation (4th ed.). https://www.pbr-book.org/4ed/Reflection_Models/Further_Reading [T2]
- Phong, B. T. (1975). Illumination for computer generated pictures. Communications of the ACM, 18(6), 311–317. https://doi.org/10.1145/360825.360839 [T8]
- Polyanskiy, M. N. (2024). Refractiveindex.info database of optical constants. Scientific Data, 11, 94. https://doi.org/10.1038/s41597-023-02898-2 [T32]
- Proctor, J. E., & Barnes, P. Y. (1996). NIST high accuracy reference reflectometer-spectrophotometer. Journal of Research of the National Institute of Standards and Technology, 101(5), 619. https://nvlpubs.nist.gov/nistpubs/jres/101/5/j5proc.pdf [G22]
- Prusa Research. (n.d.). Adjusting belt tension (CORE one/+, CORE one INDX, CORE one L/+). https://help.prusa3d.com/article/adjusting-belt-tension-core-one_845048 [H18]
- Public Lab. (n.d.). Desktop spectrometry kit 3.0. https://publiclab.org/wiki/desktop-spectrometry-kit-3-0 [H42]
- Python software foundation, Python language and standard library. (n.d.). https://www.python.org [H46]
- PyYAML (YAML parser and emitter for Python). (n.d.). https://pyyaml.org/ [H50]
- QuakeHold! Museum putty. (n.d.). https://www.sosproducts.com/quakehold-museum-putty-p/64810.htm [S19]
- Quéau, Y., Durix, B., Wu, T., Cremers, D., Lauze, F., & Durou, J.-D. (2018). LED-based photometric stereo: Modeling, calibration and numerical solution. Journal of Mathematical Imaging and Vision, 60(3), 313–340. https://doi.org/10.1007/s10851-017-0761-1 [V30]
- Quéau, Y., Durou, J.-D., & Aujol, J.-F. (2018). Normal integration: A survey. Journal of Mathematical Imaging and Vision, 60(4), 576–593. https://doi.org/10.1007/s10851-017-0773-x [V35]
- Raspberry Pi configuration, ’raspi-config‘ and UART. (n.d.). https://www.raspberrypi.com/documentation/computers/configuration.html [H53]
- Raspberry Pi Ltd. (n.d.-a). Raspberry Pi Pico-series Python SDK: A MicroPython environment for Raspberry Pi microcontrollers. https://datasheets.raspberrypi.com/pico/raspberry-pi-pico-python-sdk.pdf [H8]
- Raspberry Pi Ltd. (n.d.-b). RP2040 datasheet. https://datasheets.raspberrypi.com/rp2040/rp2040-datasheet.pdf [H7]
- Raspberry Pi Zero 2 W. (n.d.). https://www.raspberrypi.com/products/raspberry-pi-zero-2-w/ [H51]
- RealityScan (formerly RealityCapture). (n.d.). https://www.realityscan.com/license [S18]
- Reinhard, E., Ward, G., Pattanaik, S., Debevec, P., Heidrich, W., & Myszkowski, K. (2010). High dynamic range imaging: Acquisition, display, and image-based lighting (2nd ed.). https://www.oreilly.com/library/view/high-dynamic-range/9780123749147/ [V24]
- RGL-EPFL, customized PAB pgII gonio-photometer (instrument page). (n.d.). https://rgl.epfl.ch/pages/lab/pgII [G32]
- RGL-EPFL material database. (n.d.). https://rgl.epfl.ch/pages/lab/material-database [R16]
- Ribardière, M., Bringier, B., Meneveaux, D., & Simonot, L. (2017). STD: Student’s t-distribution of slopes for microfacet based BSDFs. Computer Graphics Forum, 36(2). https://doi.org/10.1111/cgf.13137 [T24]
- Riviere, J., Peers, P., & Ghosh, A. (2016). Mobile surface reflectometry. Computer Graphics Forum, 35, 191–202. https://doi.org/10.1111/cgf.12719 [G40]
- Robertson, M. A., Borman, S., & Stevenson, R. L. (2003). Estimation-theoretic approach to dynamic range enhancement using multiple exposures. Journal of Electronic Imaging, 12(2), 219–228. https://doi.org/10.1117/1.1557695 [V20]
- Royer, M. P. (2019). Analysis of color rendition specification criteria. Proceedings of SPIE. https://www.energy.gov/cmei/ssl/articles/analysis-color-rendition-specification-criteria [N19]
- Rusinkiewicz, S. (1998). A new change of variables for efficient BRDF representation. Rendering Techniques ’98. https://doi.org/10.1007/978-3-7091-6453-2_2 [T16]
- S. Westin et al., cornell three-axis gonioreflectometer, SPIE 5878-29. (n.d.). https://www.graphics.cornell.edu/~westin/SPIE_5878-29_Gonio.pdf [R11]
- Saha, D., Gevaux, L., Frisvad, J. R., & Obein, G. (2024). Bidirectional reflectance measurements over a micrometric surface area using a goniospectrophotometer. Review of Scientific Instruments, 95(5), 055114. https://doi.org/10.1063/5.0193490 [G31]
- Salazar-Vazquez, J., & Mendez-Vazquez, A. (2020). A plug-and-play hyperspectral imaging sensor using low-cost equipment. HardwareX. https://doi.org/10.1016/j.ohx.2019.e00087 [H40]
- Santo, H., Waechter, M., & Matsushita, Y. (2020). Deep near-light photometric stereo for spatially varying reflectances. European Conference on Computer Vision. https://doi.org/10.1007/978-3-030-58598-3_9 [V32]
- Schlick, C. (1994). An inexpensive BRDF model for physically-based rendering. Computer Graphics Forum, 13(3). [R7]
- Schneidereit, D., Kraus, L., Meier, J. C., Friedrich, O., & Gilbert, D. F. (2017). Step-by-step guide to building an inexpensive 3D printed motorized positioning stage for automated high-content screening microscopy. Biosensors and Bioelectronics, 92, 472–481. https://doi.org/10.1016/j.bios.2016.10.078 [H38]
- Schnieders, D., & Wong, K.-Y. K. (2013). Camera and light calibration from reflections on a sphere. Computer Vision and Image Understanding. https://www.sciencedirect.com/science/article/abs/pii/S1077314213001082 [S13]
- Schönberger, J. L., & Frahm, J.-M. (2016). Structure-from-motion revisited. https://doi.org/10.1007/978-3-319-46487-9_31 [S3]
- Schöps, T., Larsson, V., Pollefeys, M., & Sattler, T. (2020). Why having 10,000 parameters in your camera model is better than twelve. Proceedings of the IEEE Conference on Computer Vision and Pattern Recognition. https://openaccess.thecvf.com/content_CVPR_2020/html/Schops_Why_Having_10000_Parameters_in_Your_Camera_Model_Is_Better_CVPR_2020_paper.html [V6]
- Schwartz, C., Sarlette, R., Weinmann, M., & Klein, R. (2013). DOME II: A parallelized BTF acquisition system. Eurographics Workshop on Material Appearance Modeling. https://doi.org/10.2312/MAM.MAM2013.025-031 [G50]
- Schwartz, C., Sarlette, R., Weinmann, M., Rump, M., & Klein, R. (2014). Design and implementation of practical bidirectional texture function measurement devices focusing on the developments at the university of Bonn. Sensors, 14(5), 7753–7819. https://doi.org/10.3390/s140507753 [G49]
- Shah, M. (2013). Solving the robot-world/hand-eye calibration problem using the Kronecker product. Journal of Mechanisms and Robotics, 5(3), 031007. https://doi.org/10.1115/1.4024473 [V15]
- Sharp Corporation. (2018). PC817XxNSZ1B series. https://global.sharp/products/device/lineup/data/pdf/datasheet/PC817XxNSZ1B_e.pdf [H9]
- Shi, B. et al. (2016). A benchmark dataset and evaluation for non-Lambertian and uncalibrated photometric stereo. Proceedings of the IEEE Conference on Computer Vision and Pattern Recognition. https://openaccess.thecvf.com/content_cvpr_2016/html/Shi_A_Benchmark_Dataset_CVPR_2016_paper.html [V28]
- Shrestha, R., & Hardeberg, J. Y. (2013). Multispectral imaging using LED illumination and an RGB camera. Color and Imaging Conference, 21(1), 8–13. https://doi.org/10.2352/CIC.2013.21.1.art00003 [N38]
- Shrestha, R., & Hardeberg, J. Y. (2014a). Evaluation and comparison of multispectral imaging systems. Color and Imaging Conference, 22(1). https://doi.org/10.2352/CIC.2014.22.1.art00018 [N39]
- Shrestha, R., & Hardeberg, J. Y. (2014b). How are LED illumination based multispectral imaging systems influenced by different factors? ICISP 2014, 61, 61–71. https://doi.org/10.1007/978-3-319-07998-1_8 [N40]
- Smith, B. G. (1967). Geometrical shadowing of a random rough surface. IEEE Transactions on Antennas and Propagation, 15(5), 668–671. https://ui.adsabs.harvard.edu/abs/1967ITAP…15..668S/abstract [T12]
- Smits, B. (1999). An RGB-to-spectrum conversion for reflectances. Journal of Graphics Tools, 4(4), 11–22. https://doi.org/10.1080/10867651.1999.10487511 [T52]
- Snavely, N., Seitz, S. M., & Szeliski, R. (2006). Photo tourism: Exploring photo collections in 3D. ACM Transactions on Graphics, 25(3), 835–846. https://doi.org/10.1145/1141911.1141964 [V37]
- Sole, A. (2019). Image-based bidirectional reflectance measurement of non-diffuse and gonio-chromatic materials. PhD thesis. https://www.ntnu.edu/colourlab/phd-theses [G20]
- Sole, A., Farup, I., Nussbaum, P., & Tominaga, S. (2018). Evaluating an image-based bidirectional reflectance distribution function measurement setup. Applied Optics, 57(8), 1918–1928. https://doi.org/10.1364/AO.57.001918 [G19]
- Sole, A., Gigilashvili, D., Midtfjord, H., Guarnera, D., Guarnera, G. C., Thomas, J.-B., & Hardeberg, J. Y. (2019). On the acquisition and reproduction of material appearance. CCIW 2019, 11418, 26–38. https://doi.org/10.1007/978-3-030-13940-7_3 [G36]
- Sony Semiconductor Solutions. (2018). IMX477-AACK: Diagonal 7.857 mm (type 1/2.3) 12.3 mega-pixel CMOS image sensor. https://www.sony-semicon.com/files/62/pdf/p-13_IMX477-AACK_Flyer.pdf [H13]
- Springsteen, A. (1998a). Reflectance spectroscopy: An overview of classification and techniques. In Applied spectroscopy: A compact reference for practitioners (pp. 193–224). Academic Press. https://doi.org/10.1016/B978-012764070-9/50008-1 [N35]
- Springsteen, A. (1998b). Standards for reflectance measurements. In Applied spectroscopy: A compact reference for practitioners (pp. 247–267). Academic Press. https://doi.org/10.1016/B978-012764070-9/50010-X [N36]
- Stanford spherical gantry. (n.d.). https://graphics.stanford.edu/projects/gantry/ [R3]
- Stanford spherical gantry specifications. (n.d.). https://graphics.stanford.edu/projects/gantry/design/specifications.html [R4]
- Szeliski, R. (1993). Rapid octree construction from image sequences. CVGIP: Image Understanding, 58(1). https://www.sciencedirect.com/science/article/abs/pii/S1049966083710296 [S6]
- Szeliski, R. (2022). Computer vision: Algorithms and applications (2nd ed.). https://doi.org/10.1007/978-3-030-34372-9 [V9]
- Sztrajman, A., Rainer, G., Ritschel, T., & Weyrich, T. (2021). Neural BRDF representation and importance sampling. Computer Graphics Forum, 40. https://doi.org/10.1111/cgf.14335 [T29]
- Tabb, A., & Ahmad Yousef, K. M. (2017). Solving the robot-world hand-eye(s) calibration problem with iterative methods. Machine Vision and Applications. https://doi.org/10.1007/s00138-017-0841-7 [V16]
- Taubin, G. (1995). A signal processing approach to fair surface design. SIGGRAPH. [T56]
- Texas Instruments. (2025). ULN200x, ULQ200x high-voltage, high-current darlington transistor arrays. https://www.ti.com/lit/gpn/ULN2003A [H10]
- Torrance, K. E., & Sparrow, E. M. (1967). Theory for off-specular reflection from roughened surfaces. Journal of the Optical Society of America, 57(9), 1105–1114. https://doi.org/10.1364/JOSA.57.001105 [T10]
- Toschke, Y., Klenen, J., & Imlau, M. (2024). Open photonics: An integrated approach for building a 3D-printed motorized rotation stage system. HardwareX, 20, e00577. https://doi.org/10.1016/j.ohx.2024.e00577 [H37]
- Trowbridge, T. S., & Reitz, K. P. (1975). Average irregularity representation of a rough surface for ray reflection. Journal of the Optical Society of America, 65(5), 531–536. https://doi.org/10.1364/JOSA.65.000531 [T11]
- Tsai, R. Y. (1987). A versatile camera calibration technique for high-accuracy 3D machine vision metrology using off-the-shelf TV cameras and lenses. IEEE Journal of Robotics and Automation, 3(4), 323–344. https://doi.org/10.1109/JRA.1987.1087109 [V2]
- Tsai, R. Y., & Lenz, R. K. (1989). A new technique for fully autonomous and efficient 3D robotics hand/eye calibration. IEEE Transactions on Robotics and Automation, 5(3), 345–358. https://doi.org/10.1109/70.34770 [V10]
- Turquin, E. (2019). Practical multiple scattering compensation for microfacet models. https://blog.selfshadow.com/publications/turquin/ms_comp_final.pdf [T22]
- Unity, HDRP “lit shader”. (n.d.). https://docs.unity3d.com/Packages/com.unity.render-pipelines.high-definition@14.0/manual/Lit-Shader.html [T47]
- USB Implementers Forum. (2012). Video class v1.5 document set. https://www.usb.org/document-library/video-class-v15-document-set [H14]
- Usbipd-win. (n.d.). https://github.com/dorssel/usbipd-win [H54]
- UTIA BTF database. (n.d.). https://btf.utia.cas.cz/?faq= [R18]
- Vávra, R., & Filip, J. (2016). Minimal sampling for effective acquisition of anisotropic BRDFs. Computer Graphics Forum, 35(7), 299–309. https://www.pbr-book.org/4ed/Reflection_Models/Further_Reading [G47]
- Vávra, R., & Filip, J. (2018). Adaptive slices for acquisition of anisotropic BRDF. Computational Visual Media, 4(1), 55–69. https://doi.org/10.1007/s41095-017-0099-z [G48]
- Veach, E. (1997). Robust Monte Carlo methods for light transport simulation. https://graphics.stanford.edu/papers/veach_thesis/thesis-bw.pdf [T3]
- Virtanen, P., Gommers, R., Oliphant, T. E., et al. (2020). SciPy 1.0: Fundamental algorithms for scientific computing in Python. Nature Methods, 17, 261–272. https://doi.org/10.1038/s41592-019-0686-2 [H48]
- Vishay Semiconductors. (n.d.). TCST2103, TCST2202, TCST2300: Transmissive optical sensor with phototransistor output. https://www.vishay.com/docs/81147/tcst2103.pdf [H11]
- W. Matusik et al., MERL TR2003-83. (n.d.). https://www.merl.com/publications/docs/TR2003-83.pdf [R14]
- W3C, portable network graphics (PNG) specification. (n.d.). https://www.w3.org/TR/png/ [H60]
- Waechter, M., Moehrle, N., & Goesele, M. (2014). Let there be color! Large-scale texturing of 3D reconstructions. European Conference on Computer Vision. https://doi.org/10.1007/978-3-319-10602-1_54 [V58]
- Walter, B., Marschner, S., Li, H., & Torrance, K. (2007). Microfacet models for refraction through rough surfaces. Eurographics Symposium on Rendering. [R6]
- Walter, M. (2016). How accurate is microstepping really? Hackaday, 29. https://hackaday.com/2016/08/29/how-accurate-is-microstepping-really/ [H20]
- Ward, G. J. (1992). Measuring and modeling anisotropic reflection. ACM SIGGRAPH Computer Graphics, 26(2), 265–272. https://doi.org/10.1145/142920.134078 [G9]
- Weidner, V. R., & Hsia, J. J. (1981). Reflection properties of pressed polytetrafluoroethylene powder. Journal of the Optical Society of America, 71(7), 856–861. https://doi.org/10.1364/JOSA.71.000856 [N30]
- Weidner, V. R., Hsia, J. J., & Adams, B. (1985). Laboratory intercomparison study of pressed polytetrafluoroethylene powder reflectance standards. Applied Optics, 24(14), 2225. https://doi.org/10.1364/AO.24.002225 [N31]
- Weinmann, M., & Klein, R. (2015). Advances in geometry and reflectance acquisition (course notes). SIGGRAPH Asia 2015 Courses. https://doi.org/10.1145/2818143.2818165 [G4]
- Weyrich, T., Lawrence, J., Lensch, H. P. A., Rusinkiewicz, S., & Zickler, T. (2009). Principles of appearance acquisition and representation. Foundations and Trends in Computer Graphics and Vision, 4(2), 75–191. https://doi.org/10.1561/0600000022 [T4]
- White, D. R., Saunders, P., Bonsey, S. J., Ven, J. van de, & Edgar, H. (1998). Reflectometer for measuring the bidirectional reflectance of rough surfaces. Applied Optics, 37(16), 3450–3454. https://doi.org/10.1364/AO.37.003450 [G10]
- Wilkie, A., Nawaz, S., Droske, M., Weidlich, A., & Hanika, J. (2014). Hero wavelength spectral sampling. Computer Graphics Forum, 33(4), 123–131. https://doi.org/10.1111/cgf.12419 [T55]
- Wolff, L. B. (1990). Polarization-based material classification from specular reflection. IEEE Transactions on Pattern Analysis and Machine Intelligence, 12(11), 1059–1071. https://doi.org/10.1109/34.61705 [V52]
- Woodham, R. J. (1980). Photometric method for determining surface orientation from multiple images. Optical Engineering, 19(1). https://doi.org/10.1117/12.7972479 [S4]
- Wyszecki, G., & Stiles, W. S. (1982). Color science: Concepts and methods, quantitative data and formulae (2nd ed.). https://doi.org/10.1002/col.5080080421 [N21]
- Xatlas, mesh parameterization / UV unwrapping library. (n.d.). https://github.com/jpcy/xatlas [V57]
- X-rite PANTORA. (n.d.). https://www.xrite.com/pantora-software [R40]
- X-rite TAC7. (n.d.). https://www.xrite.com/categories/appearance/tac7 [R19]
- X-rite TAC7 user guide. (n.d.). https://www.xrite.com/-/media/xrite/files/manuals_and_userguides/t/tac7_user_guide_en.pdf [R39]
- Yu, Chen, & Da. (2025). Geometric calibration for photometric stereo under near-field point light sources using spheres. Optics & Laser Technology, 180. https://www.sciencedirect.com/science/article/pii/S0030399224010156 [S14]
- Zaber Technologies. (n.d.). Microstepping tutorial. https://www.zaber.com/technical-articles/microstepping-tutorial [H22]
- Zhang, Z. (2000). A flexible new technique for camera calibration. IEEE Transactions on Pattern Analysis and Machine Intelligence, 22(11), 1330–1334. https://doi.org/10.1109/34.888718 [V1]
- Zhou, Q.-Y., Park, J., & Koltun, V. (2018). Open3D: A modern library for 3D data processing. https://arxiv.org/abs/1801.09847 [V47]
- Zhuang, H., Roth, Z. S., & Sudhakar, R. (1994). Simultaneous robot/world and tool/flange calibration by solving homogeneous transformation equations of the form AX=YB. IEEE Transactions on Robotics and Automation, 10(4), 549–554. https://doi.org/10.1109/70.313105 [V13]
- Zou, Y., Zhang, L., Zhang, J., Li, B., & Lv, X. (2022). Developmental trends in the application and measurement of the bidirectional reflection distribution function. Sensors, 22(5), 1739. https://doi.org/10.3390/s22051739 [G6]

# Appendix A · Reflectance measurement and gonioreflectometers

Background papers and sources, by topic. Format: APA reference — what this project uses it for. Full list: Bibliography.

## Primary design references

- Ansari-Asl, M., Barbieri, M., Obein, G., & Hardeberg, J. Y. (2024). Optical and electromechanical design and implementation of an advanced multispectral device to capture material appearance. Journal of Imaging, 10(3), 55. https://doi.org/10.3390/jimaging10030055 — Main design reference: layout, homing, safety, kinematics, optics, tests [R1]
- Hanrahan, P. (2016). Reflection models I: Ideal materials. — BRDF equations (phase 00 theory) [R2]
- Stanford spherical gantry. (n.d.). https://graphics.stanford.edu/projects/gantry/ — First-draft architecture [R3]
- Stanford spherical gantry specifications. (n.d.). https://graphics.stanford.edu/projects/gantry/design/specifications.html — First-draft sizing [R4]

## Theory and algorithms

- Debevec, P., & Malik, J. (1997). Recovering high dynamic range radiance maps from photographs. Proc. SIGGRAPH ’97. https://pauldebevec.com/Research/HDR/debevec-siggraph97.pdf — Camera response + HDR for 8-bit UVC frames [R5]
- Walter, B., Marschner, S., Li, H., & Torrance, K. (2007). Microfacet models for refraction through rough surfaces. Eurographics Symposium on Rendering. — GGX distribution [R6]
- Schlick, C. (1994). An inexpensive BRDF model for physically-based rendering. Computer Graphics Forum, 13(3). — Schlick Fresnel [R7]
- Cook, R., & Torrance, K. (1982). A reflectance model for computer graphics. ACM Transactions on Graphics, 1(1). — Cook-Torrance colour shift [R8]
- Ericson, C. (2005). Real-time collision detection. Morgan Kaufmann. — Segment-segment distance in the collision model [R9]

## Other rigs and data

- Cornell gonioreflectometer. (n.d.). http://w1.graphics.cornell.edu/research/measure/gonio.html — Comparison [R10]
- S. Westin et al., cornell three-axis gonioreflectometer, SPIE 5878-29. (n.d.). https://www.graphics.cornell.edu/~westin/SPIE_5878-29_Gonio.pdf — Comparison [R11]
- Cornell measurement data. (n.d.). https://www.graphics.cornell.edu/online/measurements/ — Validation data [R12]
- MERL BRDF database. (n.d.). Retrieved — Validation data [R13]
- W. Matusik et al., MERL TR2003-83. (n.d.). https://www.merl.com/publications/docs/TR2003-83.pdf — Comparison [R14]
- Dupuy, J., & Jakob, W. (2018). An adaptive parameterization for efficient material acquisition and rendering. https://rgl.epfl.ch/publications/Dupuy2018Adaptive — Adaptive sampling (phase 17) [R15]
- RGL-EPFL material database. (n.d.). https://rgl.epfl.ch/pages/lab/material-database — Validation data [R16]
- J. Filip et al., specular BRDF with a goniometer, 2017. (2017). https://staff.utia.cas.cz/filip/papers/filip17brdf.pdf — Comparison [R17]
- UTIA BTF database. (n.d.). https://btf.utia.cas.cz/?faq= — BTF context [R18]
- X-rite TAC7. (n.d.). https://www.xrite.com/categories/appearance/tac7 — Commercial multi-light capture [R19]
- F. Schröder, master’s thesis, 2019. (2019). https://f-schroeder.github.io/publication/masterthesis/ — DIY prior art [R37]
- GatherLab/goniometer. (n.d.). https://github.com/GatherLab/Goniometer — Consulted; emission goniometer, not used [R38]
- X-rite TAC7 user guide. (n.d.). https://www.xrite.com/-/media/xrite/files/manuals_and_userguides/t/tac7_user_guide_en.pdf — Context [R39]
- X-rite PANTORA. (n.d.). https://www.xrite.com/pantora-software — Context [R40]

## Foundations, surveys and books

- Nicodemus, F. E., Richmond, J. C., Hsia, J. J., Ginsberg, I. W., & Limperis, T. (1977). Geometrical considerations and nomenclature for reflectance. NBS Monograph, 160. https://doi.org/10.6028/NBS.MONO.160 — BRDF definition, units, nomenclature (phases 00, 07) [G1]
- Dorsey, J., Rushmeier, H., & Sillion, F. (2008). Digital modeling of material appearance. Morgan Kaufmann. https://booksite.elsevier.com/samplechapters/9780122211812/Sample_Chapters/01~Front_Matter.pdf — Measurement chapter, device taxonomy (phase 00) [G2]
- Guarnera, D., Guarnera, G. C., Ghosh, A., Denk, C., & Glencross, M. (2016). BRDF representation and acquisition. Computer Graphics Forum, 35(2), 625–650. https://doi.org/10.1111/cgf.12867 — Survey of acquisition devices, models (phase 08) [G3]
- Weinmann, M., & Klein, R. (2015). Advances in geometry and reflectance acquisition (course notes). SIGGRAPH Asia 2015 Courses. https://doi.org/10.1145/2818143.2818165 — Joint shape + reflectance capture (phases 11, 13) [G4]
- Filip, J., & Haindl, M. (2009). Bidirectional texture function modeling: A state of the art survey. IEEE Transactions on Pattern Analysis and Machine Intelligence, 31(11). https://doi.org/10.1109/TPAMI.2008.246 — BTF capture and representation (phase 09) [G5]
- Zou, Y., Zhang, L., Zhang, J., Li, B., & Lv, X. (2022). Developmental trends in the application and measurement of the bidirectional reflection distribution function. Sensors, 22(5), 1739. https://doi.org/10.3390/s22051739 — Recent review of BRDF instruments (phase 00) [G6]
- Obein, G. (2021). The measurement of appearance. Proc. Int. School of Physics “Enrico Fermi”. https://doi.org/10.3254/ENFI210025 — Metrology view of appearance (phase 00) [G7]

## Classic gonioreflectometers and image-based BRDF measurement

- Murray-Coleman, J. F., & Smith, A. M. (1990). The automated measurement of BRDFs and their application to luminaire modeling. Journal of the Illuminating Engineering Society, 19, 87–99. https://doi.org/10.1080/00994480.1990.10747944 — Early automated gonioreflectometer (phase 08) [G8]
- Ward, G. J. (1992). Measuring and modeling anisotropic reflection. ACM SIGGRAPH Computer Graphics, 26(2), 265–272. https://doi.org/10.1145/142920.134078 — Imaging gonioreflectometer, anisotropic fit (phase 09) [G9]
- White, D. R., Saunders, P., Bonsey, S. J., Ven, J. van de, & Edgar, H. (1998). Reflectometer for measuring the bidirectional reflectance of rough surfaces. Applied Optics, 37(16), 3450–3454. https://doi.org/10.1364/AO.37.003450 — Four-axis rotating-arm gonio design (phases 03, 04) [G10]
- Dana, K. J., Ginneken, B. van, Nayar, S. K., & Koenderink, J. J. (1999). Reflectance and texture of real-world surfaces. ACM Transactions on Graphics, 18(1), 1–34. https://doi.org/10.1145/300776.300778 — CUReT robot-arm BTF capture/dataset (phases 09, 17) [G11]
- Marschner, S. R., Westin, S. H., Lafortune, E. P. F., & Torrance, K. E. (2000). Image-based bidirectional reflectance distribution function measurement. Applied Optics, 39(16), 2592–2600. https://doi.org/10.1364/AO.39.002592 — Camera-based BRDF from curved samples (phases 06, 07) [G12]
- Han, J. Y., & Perlin, K. (2003). Measuring bidirectional texture reflectance with a kaleidoscope. ACM Transactions on Graphics, 22(3). https://doi.org/10.1145/882262.882341 — Mirror-based multi-view BTF alternative (phase 17) [G13]
- Dana, K. J., & Wang, J. (2004). Device for convenient measurement of spatially varying bidirectional reflectance. Journal of the Optical Society of America A, 21(1), 1–12. https://doi.org/10.1364/JOSAA.21.000001 — Curved-mirror SVBRDF camera (phase 09) [G14]
- Matusik, W., Pfister, H., Brand, M., & McMillan, L. (2003). Efficient isotropic BRDF measurement. Proc. 14th Eurographics Workshop on Rendering. https://www.pbr-book.org/4ed/Reflection_Models/Further_Reading — Sphere-sample MERL acquisition method (phase 17) [G15]
- Ngan, A., Durand, F., & Matusik, W. (2005). Experimental analysis of BRDF models. Eurographics Symposium on Rendering. https://diglib.eg.org/items/b3a3223e-ad94-4366-8ae7-fce371c08d04 — Model-fit comparison, anisotropic cylinder rig (phases 07, 09) [G16]
- Ben-Ezra, M., Wang, J., Wilburn, B., Li, X., & Ma, L. (2008). An LED-only BRDF measurement device. Proceedings of the IEEE Conference on Computer Vision and Pattern Recognition. https://doi.org/10.1109/CVPR.2008.4587766 — LEDs as emitters/sensors, multispectral (phase 10) [G17]
- Kurt, M., Szirmay-Kalos, L., & Křivánek, J. (2010). An anisotropic BRDF model for fitting and Monte Carlo rendering. ACM SIGGRAPH Computer Graphics, 44(1), 1–15. https://doi.org/10.1145/1722991.1722996 — Anisotropic fit to measured data (phase 09) [G18]
- Sole, A., Farup, I., Nussbaum, P., & Tominaga, S. (2018). Evaluating an image-based bidirectional reflectance distribution function measurement setup. Applied Optics, 57(8), 1918–1928. https://doi.org/10.1364/AO.57.001918 — Validating camera BRDF vs commercial (phase 07) [G19]
- Sole, A. (2019). Image-based bidirectional reflectance measurement of non-diffuse and gonio-chromatic materials. PhD thesis. https://www.ntnu.edu/colourlab/phd-theses — Image-based BRDF method details (phase 07) [G20]

## National metrology institute instruments and references

- Barnes, P. Y., Early, E. A., & Parr, A. C. (1998a). NIST measurement services: Spectral reflectance. https://nvlpubs.nist.gov/nistpubs/Legacy/SP/nistspecialpublication250-48.pdf — STARR reference reflectometer, uncertainty (phase 07) [G21]
- Proctor, J. E., & Barnes, P. Y. (1996). NIST high accuracy reference reflectometer-spectrophotometer. Journal of Research of the National Institute of Standards and Technology, 101(5), 619. https://nvlpubs.nist.gov/nistpubs/jres/101/5/j5proc.pdf — STARR design, absolute BRDF (phase 07) [G22]
- Patrick, H., Cooksey, C., Germer, T. A., Nadal, M. E., & Zarobila, C. (2021). Bidirectional reflectance capabilities of the NIST robotic optical scattering instrument. Applied Optics, 60(28), 8774. https://doi.org/10.1364/AO.435117 — Robot-arm reference gonio, STARR comparison (phase 08) [G23]
- Durell, C., Scharpf, D., McKee, G., L’Heureux, M., Georgiev, G., Obein, G., & Cooksey, C. (2015). Creation and validation of sintered PTFE BRDF targets & standards. Proceedings of SPIE. https://tsapps.nist.gov/publication/get_pdf.cfm?pub_id=919590 — PTFE white reference BRDF (phase 07) [G24]
- Höpe, A., Hünerhoff, D., & Hauer, K.-O. (2006). Robot-based gonioreflectometer. In Industrial robotics: Programming, simulation and applications (pp. 624–632). (ed. L. K. Huat). https://cdn.intechopen.com/pdfs/284/InTech-Robot_based_gonioreflectometer.pdf — PTB robot sample holder concept (phase 08) [G25]
- Höpe, A., & Hauer, K.-O. (2010). Three-dimensional appearance characterization of diffuse standard reflection materials. Metrologia, 47(3), 295. https://doi.org/10.1088/0026-1394/47/3/021 — Non-Lambertian behaviour of white standards (phase 07) [G26]
- Höpe, A. et al. (2012). ARGon3: ’3D appearance robot-based gonioreflectometer’ at PTB. Review of Scientific Instruments, 83(4), 045102. https://pubs.aip.org/aip/rsi/article/83/4/045102/355039/ARGon3-3D-appearance-robot-based — Camera-based spatially resolved gonio (phase 09) [G27]
- Höpe, A. et al. (2014). Multidimensional reflectometry for industry (xD-reflect) an European research project. Proceedings of SPIE. https://doi.org/10.1117/12.2035981 — Gonio colour, sparkle, gloss metrology (phase 10) [G28]
- Molloy, E., Patrick, H., Hauer, K.-O., Hünerhoff, D., & Quast, T. (2026). Comparison of bidirectional reflectance distribution function scales over the hemisphere. Applied Optics, 65(18), 6358–6365. https://doi.org/10.1364/AO.603369 — Inter-lab BRDF agreement limits (phase 07) [G29]
- Le Breton, R., Ged, G., & Obein, G. (2015). Out of plane BRDF measurement at LNE-cnam using ’ConDOR’ our primary goniospectrophotometer. Proc. 28th CIE Session. https://inm.cnam.fr/gael-obein-71373.kjsp — High-resolution out-of-plane gonio (phase 08) [G30]
- Saha, D., Gevaux, L., Frisvad, J. R., & Obein, G. (2024). Bidirectional reflectance measurements over a micrometric surface area using a goniospectrophotometer. Review of Scientific Instruments, 95(5), 055114. https://doi.org/10.1063/5.0193490 — Small-spot BRDF, spatial resolution (phase 17) [G31]
- RGL-EPFL, customized PAB pgII gonio-photometer (instrument page). (n.d.). https://rgl.epfl.ch/pages/lab/pgII — Reference instrument behind RGL data (phase 17) [G32]

## Lineage of the main design reference (NTNU / LNE-CNAM)

- Ansari-Asl, M., Barbieri, M., Obein, G., & Hardeberg, J. Y. (2023). Advancing material appearance measurement: A cost-effective multispectral imaging system for capturing SVBRDF and BTF. London Imaging Meeting. https://doi.org/10.2352/lim.2023.4.1.25 — Precursor of R1 rig layout (phases 00, 05) [G33]
- Ansari-Asl, M., Thomas, J.-B., & Hardeberg, J. Y. (2022). Camera response function assessment in multispectral HDR imaging. IS&T Electronic Imaging (Color Imaging XXVII), 141. https://doi.org/10.2352/EI.2022.34.15.COLOR-141 — Measured vs Debevec CRF for HDR (phase 07) [G34]
- Ansari-Asl, M. (2026). Development of a multispectral camera-based device for goniometric acquisition of spatially varying reflectance properties. PhD thesis. https://www.ntnu.edu/colourlab/phd-theses — Full design record of R1 (phase 00) [G35]
- Sole, A., Gigilashvili, D., Midtfjord, H., Guarnera, D., Guarnera, G. C., Thomas, J.-B., & Hardeberg, J. Y. (2019). On the acquisition and reproduction of material appearance. CCIW 2019, 11418, 26–38. https://doi.org/10.1007/978-3-030-13940-7_3 — NTNU appearance-capture context (phase 00) [G36]
- Chitnis, S., Sole, A., & Chandran, S. (2025). Spectral bidirectional reflectance distribution function simplification. Journal of Imaging, 11(1), 18. https://doi.org/10.3390/jimaging11010018 — Fewer spectral bands per BRDF (phase 10) [G37]

## Low-cost, robotic and portable devices

- Filip, J., Vávra, R., & Krupička, M. (2014). Rapid material appearance acquisition using consumer hardware. Sensors, 14(10), 19785–19805. https://doi.org/10.3390/s141019785 — Toy-gantry low-cost BTF prior art (phases 00, 03) [G38]
- Lyngby, R. A., Matthiassen, J. B., Frisvad, J. R., Dahl, A. B., & Aanæs, H. (2019). Using a robotic arm for measuring BRDFs. SCIA 2019. https://doi.org/10.1007/978-3-030-20205-7_16 — Hand-eye calibration for BRDF rigs (phase 11) [G39]
- Riviere, J., Peers, P., & Ghosh, A. (2016). Mobile surface reflectometry. Computer Graphics Forum, 35, 191–202. https://doi.org/10.1111/cgf.12719 — Phone-flash SVBRDF capture baseline (phase 09) [G40]

## Spherical, polarized and linear-light illumination; SVBRDF capture

- Ghosh, A., Chen, T., Peers, P., Wilson, C. A., & Debevec, P. (2009). Estimating specular roughness and anisotropy from second order spherical gradient illumination. Eurographics Symposium on Rendering. https://www.cs.wm.edu/~ppeers/publications/Ghosh2009ESR/Ghosh_EGSR2009.pdf — Polarized diffuse/specular separation (phase 10) [G41]
- Ghosh, A., Chen, T., Peers, P., Wilson, C. A., & Debevec, P. (2010). Circularly polarized spherical illumination reflectometry. ACM SIGGRAPH Asia. https://vgl.ict.usc.edu/Research/CPSIR/ — Polarization-based index/specular estimation (phase 10) [G42]
- Chen, G., Dong, Y., Peers, P., Zhang, J., & Tong, X. (2014). Reflectance scanning: Estimating shading frame and BRDF with generalized linear light sources. ACM Transactions on Graphics, 33(4). https://doi.org/10.1145/2601097.2601180 — Linear-light SVBRDF scanning (phase 09) [G43]
- Aittala, M., Weyrich, T., & Lehtinen, J. (2013). Practical SVBRDF capture in the frequency domain. ACM Transactions on Graphics, 32(4). https://doi.org/10.1145/2461912.2461978 — Screen-pattern SVBRDF capture (phase 09) [G44]
- Baek, S.-H., Zeltner, T., Ku, H., Hwang, I., Tong, X., Jakob, W., & Kim, M. H. (2020). Image-based acquisition and modeling of polarimetric reflectance. ACM Transactions on Graphics, 39(4), 139. https://doi.org/10.1145/3386569.3392387 — Polarimetric BRDF capture (phase 10) [G45]

## Sampling strategies

- Nielsen, J. B., Jensen, H. W., & Ramamoorthi, R. (2015). On optimal, minimal BRDF sampling for reflectance acquisition. ACM Transactions on Graphics, 34(6), 186. https://www.pbr-book.org/4ed/Reflection_Models/Further_Reading — Few-sample BRDF from MERL basis (phase 17) [G46]
- Vávra, R., & Filip, J. (2016). Minimal sampling for effective acquisition of anisotropic BRDFs. Computer Graphics Forum, 35(7), 299–309. https://www.pbr-book.org/4ed/Reflection_Models/Further_Reading — Anisotropic sparse sampling (phase 17) [G47]
- Vávra, R., & Filip, J. (2018). Adaptive slices for acquisition of anisotropic BRDF. Computational Visual Media, 4(1), 55–69. https://doi.org/10.1007/s41095-017-0099-z — Adaptive 1D-slice sampling (phase 17) [G48]

## BTF capture setups (Bonn)

- Schwartz, C., Sarlette, R., Weinmann, M., Rump, M., & Klein, R. (2014). Design and implementation of practical bidirectional texture function measurement devices focusing on the developments at the university of Bonn. Sensors, 14(5), 7753–7819. https://doi.org/10.3390/s140507753 — BTF device requirements, HDR, calibration (phase 09) [G49]
- Schwartz, C., Sarlette, R., Weinmann, M., & Klein, R. (2013). DOME II: A parallelized BTF acquisition system. Eurographics Workshop on Material Appearance Modeling. https://doi.org/10.2312/MAM.MAM2013.025-031 — Camera-array dome comparison (phase 09) [G50]

## Datasets and data formats

- Matusik, W., Pfister, H., Brand, M., & McMillan, L. (2023). BRDF database – bidirectional reflectance distribution function. https://doi.org/10.5281/zenodo.8101681 — Licensed MERL copy for comparison (phase 17) [G51]
- Lanevski, D. et al. (2022). Machine-readable universal data format for bidirectional reflectance distribution function and BiRDview—an open-source web-based application for viewing and comparing bidirectional reflectance data. Color Research & Application. https://doi.org/10.1002/col.22790 — BRDF export format, viewer (phase 14) [G52]

# Appendix B · Reflectance theory and models

Background papers and sources, by topic. Format: APA reference — what this project uses it for. Full list: Bibliography.

## Rendering theory and textbooks

- Kajiya, J. T. (1986). The rendering equation. Proc. SIGGRAPH ’86, Computer Graphics, 20(4), 143–150. https://doi.org/10.1145/15922.15902 — Reflection/rendering equation background (phases 00, 07) [T1]
- Pharr, M., Jakob, W., & Humphreys, G. (2023). Physically based rendering: From theory to implementation (4th ed.). https://www.pbr-book.org/4ed/Reflection_Models/Further_Reading — BRDF, microfacet, sampling reference (phases 07, 08) [T2]
- Veach, E. (1997). Robust Monte Carlo methods for light transport simulation. https://graphics.stanford.edu/papers/veach_thesis/thesis-bw.pdf — Reciprocity, importance sampling theory (phases 08, 17) [T3]
- Weyrich, T., Lawrence, J., Lensch, H. P. A., Rusinkiewicz, S., & Zickler, T. (2009). Principles of appearance acquisition and representation. Foundations and Trends in Computer Graphics and Vision, 4(2), 75–191. https://doi.org/10.1561/0600000022 — Measurement-to-representation overview (phases 00, 08, 09) [T4]
- Montes, R., & Ureña, C. (2012). An overview of BRDF models. https://digibug.ugr.es/bitstream/handle/10481/19751/rmontes_LSI-2012-001TR.pdf — Model catalogue for choosing fits (phases 07, 08) [T5]
- Nimier-David, M., Vicini, D., Zeltner, T., & Jakob, W. (2019). Mitsuba 2: A retargetable forward and inverse renderer. ACM Transactions on Graphics, 38(6), 203. https://doi.org/10.1145/3355089.3356498 — Differentiable reference renderer for fit checks (phase 17) [T6]
- Mitsuba 3 documentation. (n.d.). BSDFs. https://mitsuba.readthedocs.io/en/stable/src/generated/plugins_bsdfs.html — Render fitted vs RGL measured BSDF (phase 17) [T7]

## Classic analytic reflectance models

- Phong, B. T. (1975). Illumination for computer generated pictures. Communications of the ACM, 18(6), 311–317. https://doi.org/10.1145/360825.360839 — Baseline lobe model for comparisons (phase 07) [T8]
- Blinn, J. F. (1977). Models of light reflection for computer synthesized pictures. Proc. SIGGRAPH ’77. https://doi.org/10.1145/563858.563893 — Half-vector lobe, legacy export mapping (phase 07) [T9]
- Torrance, K. E., & Sparrow, E. M. (1967). Theory for off-specular reflection from roughened surfaces. Journal of the Optical Society of America, 57(9), 1105–1114. https://doi.org/10.1364/JOSA.57.001105 — Microfacet theory, off-specular peak (phase 08) [T10]
- Trowbridge, T. S., & Reitz, K. P. (1975). Average irregularity representation of a rough surface for ray reflection. Journal of the Optical Society of America, 65(5), 531–536. https://doi.org/10.1364/JOSA.65.000531 — Origin of GGX/TR distribution (phase 07) [T11]
- Smith, B. G. (1967). Geometrical shadowing of a random rough surface. IEEE Transactions on Antennas and Propagation, 15(5), 668–671. https://ui.adsabs.harvard.edu/abs/1967ITAP…15..668S/abstract — Smith masking-shadowing term (phases 07, 08) [T12]
- Oren, M., & Nayar, S. K. (1994). Generalization of Lambert’s reflectance model. Proc. SIGGRAPH ’94. https://doi.org/10.1145/192161.192213 — Rough-diffuse alternative to Lambert (phases 07, 08) [T13]
- Lafortune, E. P. F., Foo, S.-C., Torrance, K. E., & Greenberg, D. P. (1997). Non-linear approximation of reflectance functions. Proc. SIGGRAPH ’97. https://doi.org/10.1145/258734.258801 — Multi-lobe fit, retroreflection (phase 08) [T14]
- Ashikhmin, M., & Shirley, P. (2000). An anisotropic Phong BRDF model. Journal of Graphics Tools, 5(2), 25–32. https://doi.org/10.1080/10867651.2000.10487522 — Anisotropic fit alternative (phase 09) [T15]
- Rusinkiewicz, S. (1998). A new change of variables for efficient BRDF representation. Rendering Techniques ’98. https://doi.org/10.1007/978-3-7091-6453-2_2 — Half/difference angle data layout (phases 08, 17) [T16]

## Microfacet theory and sampling (modern)

- Heitz, E. (2014). Understanding the masking-shadowing function in microfacet-based BRDFs. Journal of Computer Graphics Techniques, 3(2), 48–107. https://jcgt.org/published/0003/02/03/paper.pdf — Correct Smith G for GGX fit (phases 07, 08) [T17]
- Heitz, E., & d’Eon, E. (2014). Importance sampling microfacet-based BSDFs using the distribution of visible normals. Computer Graphics Forum, 33(4), 103–112. https://doi.org/10.1111/cgf.12417 — Sampling fitted GGX in renders (phases 14, 17) [T18]
- Heitz, E. (2018). Sampling the GGX distribution of visible normals. Journal of Computer Graphics Techniques, 7(4), 1–13. https://jcgt.org/published/0007/04/01/paper.pdf — Simple VNDF sampler code (phase 14) [T19]
- Dupuy, J., & Benyoub, A. (2023). Sampling visible GGX normals with spherical caps. Computer Graphics Forum, 42(8). https://doi.org/10.1111/cgf.14867 — Faster VNDF sampling (phase 14) [T20]
- Heitz, E., Hanika, J., d’Eon, E., & Dachsbacher, C. (2016). Multiple-scattering microfacet BSDFs with the Smith model. ACM Transactions on Graphics, 35(4), 58. https://doi.org/10.1145/2897824.2925943 — Energy loss at high roughness (phase 08) [T21]
- Turquin, E. (2019). Practical multiple scattering compensation for microfacet models. https://blog.selfshadow.com/publications/turquin/ms_comp_final.pdf — Energy compensation when fitting rough metals (phase 07) [T22]
- Bagher, M. M., Soler, C., & Holzschuch, N. (2012). Accurate fitting of measured reflectances using a shifted gamma micro-facet distribution. Computer Graphics Forum, 31(4). https://inria.hal.science/hal-00702304 — Long-tail NDF fitting option (phase 17) [T23]
- Ribardière, M., Bringier, B., Meneveaux, D., & Simonot, L. (2017). STD: Student’s t-distribution of slopes for microfacet based BSDFs. Computer Graphics Forum, 36(2). https://doi.org/10.1111/cgf.13137 — Generalised GGX tail fitting (phase 17) [T24]

## Fitting measured data and evaluating fits

- Löw, J., Kronander, J., Ynnerman, A., & Unger, J. (2012). BRDF models for accurate and efficient rendering of glossy surfaces. ACM Transactions on Graphics, 31(1), 9. https://doi.org/10.1145/2077341.2077350 — Fit error metric, glossy model choice (phases 07, 08) [T25]
- Dupuy, J., Heitz, E., Iehl, J.-C., Poulin, P., & Ostromoukhov, V. (2015). Extracting microfacet-based BRDF parameters from arbitrary materials with power iterations. Computer Graphics Forum, 34(4), 21–30. https://doi.org/10.1111/cgf.12675 — Robust NDF extraction for GGX fit (phases 08, 09) [T26]
- Lavoué, G., Bonneel, N., Farrugia, J.-P., & Soler, C. (2021). Perceptual quality of BRDF approximations: Dataset and metrics. Computer Graphics Forum, 40(2). https://doi.org/10.1111/cgf.142636 — Perceptual fit-quality metric (phases 07, 17) [T27]
- Kavoosighafi, B. et al. (2025). Perceived quality of BRDF models. Computer Graphics Forum. https://doi.org/10.1111/cgf.70162 — Which model looks best when fitted (phase 17) [T28]
- Sztrajman, A., Rainer, G., Ritschel, T., & Weyrich, T. (2021). Neural BRDF representation and importance sampling. Computer Graphics Forum, 40. https://doi.org/10.1111/cgf.14335 — Neural fit stretch; remap to analytic (phase 17) [T29]

## Fresnel and optical constants

- Born, M., & Wolf, E. (2019). Principles of optics (7th ed.). https://www.cambridge.org/9781108477437 — Exact Fresnel equations, polarisation (phases 07, 10) [T30]
- Gulbrandsen, O. (2014). Artist friendly metallic Fresnel. Journal of Computer Graphics Techniques, 3(4), 64–72. https://jcgt.org/published/0003/04/03/paper.pdf — Map n,k to reflectivity/edge tint (phase 07) [T31]
- Polyanskiy, M. N. (2024). Refractiveindex.info database of optical constants. Scientific Data, 11, 94. https://doi.org/10.1038/s41597-023-02898-2 — Metal F0 sanity check vs mirror, chrome (phases 06, 07) [T32]

## Production shading models (course notes)

- Burley, B. (2012). Physically-based shading at Disney. Practical Physically Based Shading in Film and Game Production. https://static1.squarespace.com/static/58586fa5ebbd1a60e7d76d3e/t/593a3afa46c3c4a376d779f6/1496988449807/s2012_pbs_disney_brdf_notes_v2.pdf — Principled parameters, MERL-based design (phases 07, 17) [T33]
- Burley, B. (2015). Extending the Disney BRDF to a BSDF with integrated subsurface scattering. https://blog.selfshadow.com/publications/s2015-shading-course/burley/s2015_pbs_disney_bsdf_notes.pdf — Anisotropic alpha mapping, sheen (phase 09) [T34]
- Karis, B. (2013). Real shading in Unreal engine 4. Physically Based Shading in Theory and Practice. https://cdn2.unrealengine.com/Resources/files/2013SiggraphPresentationsNotes-26915738.pdf — UE GGX/Smith/Schlick, α = roughness² (phase 07) [T35]
- Lagarde, S., & Rousiers, C. de. (2014). Moving Frostbite to physically based rendering 3.0. https://seblagarde.wordpress.com/wp-content/uploads/2015/07/course_notes_moving_frostbite_to_pbr_v3.pdf — Validation against references, photometric units (phase 07) [T36]
- Kulla, C., & Conty, A. (2017). Revisiting physically based shading at Imageworks. https://blog.selfshadow.com/publications/s2017-shading-course/imageworks/s2017_pbs_imageworks_slides_v2.pdf — Energy compensation, Charlie sheen (phases 07, 09) [T37]
- Hoffman, N. (2015). Physics and math of shading. Physically Based Shading in Theory and Practice. https://blog.selfshadow.com/publications/s2015-shading-course/hoffman/s2015_pbs_physics_math_slides.pdf — Plain-language theory for docs (phases 00, 07) [T38]
- Guy, R., & Agopian, M. (n.d.). Physically based rendering in Filament. https://google.github.io/filament/Filament.md.html — Readable real-time BRDF derivations (phases 07, 14) [T39]

## Material exchange formats and engine docs

- Khronos Group. (n.d.). glTF 2.0 specification. https://registry.khronos.org/glTF/specs/2.0/glTF-2.0.html#metallic-roughness-material — Core export target and BRDF (phases 07, 13) [T40]
- Khronos, KHR_materials_anisotropy. (n.d.). https://github.com/KhronosGroup/glTF/blob/main/extensions/2.0/Khronos/KHR_materials_anisotropy/README.md — Export fitted anisotropy (phase 09) [T41]
- Khronos, KHR_materials_sheen, KHR_materials_clearcoat. (n.d.). https://github.com/KhronosGroup/glTF/blob/main/extensions/2.0/Khronos/KHR_materials_sheen/README.md — Fabric and coated-sample export (phase 09) [T42]
- Khronos, KHR_materials_specular, KHR_materials_ior. (n.d.). https://github.com/KhronosGroup/glTF/blob/main/extensions/2.0/Khronos/KHR_materials_specular/README.md — Export measured dielectric F0 (phase 07) [T43]
- Khronos, KHR_texture_transform. (n.d.). https://github.com/KhronosGroup/glTF/blob/main/extensions/2.0/Khronos/KHR_texture_transform/README.md — SVBRDF texture tiling on models (phases 09, 13) [T44]
- Khronos, glTF sample viewer. (n.d.). https://github.com/KhronosGroup/glTF-Sample-Viewer — Reference check of exported .glb (phases 07, 13) [T45]
- Epic Games. (n.d.). Physically based materials in Unreal engine. https://dev.epicgames.com/documentation/en-us/unreal-engine/physically-based-materials-in-unreal-engine — Unreal export mapping (phases 07, 13) [T46]
- Unity, HDRP “lit shader”. (n.d.). https://docs.unity3d.com/Packages/com.unity.render-pipelines.high-definition@14.0/manual/Lit-Shader.html — Unity export mapping (phases 07, 13) [T47]
- Blender Manual. (n.d.). Principled BSDF. https://docs.blender.org/manual/en/latest/render/shader_nodes/shader/principled.html — Check exports in Blender (phases 07, 13) [T48]
- Georgiev, I., Portsmouth, J., Andersson, Z., Herubel, A., King, A., Ogaki, S., & Servant, F. (n.d.). Autodesk standard surface. https://autodesk.github.io/standard-surface/ — DCC/film material mapping (phase 07) [T49]
- Andersson, Z., Edmondson, P., Guertault, J., Herubel, A., Kutz, P., Machizaud, A., Portsmouth, J., Servant, F., & Stone, J. (2025). OpenPBR surface: An open shading model for physically based materials. DigiPro 2025. https://doi.org/10.1145/3744199.3744632 — Future-proof export, F82-tint metals (phases 07, 16) [T50]
- ASWF, MaterialX specification and physically based shading nodes. (n.d.). https://github.com/AcademySoftwareFoundation/MaterialX/blob/main/documents/Specification/MaterialX.PBRSpec.md — Renderer-neutral material file (phases 13, 16) [T51]

## Spectral rendering

- Smits, B. (1999). An RGB-to-spectrum conversion for reflectances. Journal of Graphics Tools, 4(4), 11–22. https://doi.org/10.1080/10867651.1999.10487511 — Baseline RGB↔spectrum for 8 bands (phase 10) [T52]
- Jakob, W., & Hanika, J. (2019). A low-dimensional function space for efficient spectral upsampling. Computer Graphics Forum, 38(2), 147–155. https://doi.org/10.1111/cgf.13626 — Smooth spectra from fitted RGB albedo (phase 10) [T53]
- Peters, C., Merzbach, S., Hanika, J., & Dachsbacher, C. (2019). Using moments to represent bounded signals for spectral rendering. ACM Transactions on Graphics, 38(4), 136. https://doi.org/10.1145/3306346.3322964 — Compact storage of 8-band reflectance (phase 10) [T54]
- Wilkie, A., Nawaz, S., Droske, M., Weidlich, A., & Hanika, J. (2014). Hero wavelength spectral sampling. Computer Graphics Forum, 33(4), 123–131. https://doi.org/10.1111/cgf.12419 — Spectral preview render of measured bands (phases 10, 14) [T55]
- Taubin, G. (1995). A signal processing approach to fair surface design. SIGGRAPH. — λ/μ mesh smoothing without shrinkage: scanned visual hull → mesh (render/mesh.py) [T56]
- Karis, B. (2014). Physically based shading on mobile. — Analytic environment-BRDF fit for the viewer’s approximate studio light (render/raster.py, render-gl.js) [T57]
- Narkowicz, K. (2016). ACES filmic tone mapping curve. — Tone curve shared by the software and WebGL renderers [T58]

# Appendix C · Calibration, HDR, photometric stereo, 3D scanning

Background papers and sources, by topic. Format: APA reference — what this project uses it for. Full list: Bibliography.

## 3D photo scanner

- COLMAP output format. (n.d.). https://colmap.github.io/format.html — COLMAP text model, quaternions [S1]
- COLMAP FAQ. (n.d.). Reconstruct sparse/dense model from known camera poses. https://colmap.github.io/faq.html — run_colmap.sh command sequence, meshing [S2]
- Schönberger, J. L., & Frahm, J.-M. (2016). Structure-from-motion revisited. https://doi.org/10.1007/978-3-319-46487-9_31 — Photogrammetry engine [S3]
- Woodham, R. J. (1980). Photometric method for determining surface orientation from multiple images. Optical Engineering, 19(1). https://doi.org/10.1117/12.7972479 — Photometric stereo [S4]
- Laurentini, A. (1994). The visual hull concept for silhouette-based image understanding. IEEE Transactions on Pattern Analysis and Machine Intelligence, 16(2). https://doi.org/10.1109/34.273735 — Visual hull [S5]
- Szeliski, R. (1993). Rapid octree construction from image sequences. CVGIP: Image Understanding, 58(1). https://www.sciencedirect.com/science/article/abs/pii/S1049966083710296 — Voxel carving [S6]
- Kutulakos, K. N., & Seitz, S. M. (2000). A theory of shape by space carving. International Journal of Computer Vision. https://doi.org/10.1023/A:1008191222954 — Space carving [S7]
- MVTec HALCON ’photometric_stereo‘ reference. (n.d.). https://www.mvtec.com/doc/halcon/13/en/photometric_stereo.html — ≥ 3 images, non-coplanar light directions [S8]
- Fitzgibbon, A. W., Cross, G., & Zisserman, A. (1998). Automatic 3D model construction for turn-table sequences. https://doi.org/10.1007/3-540-49437-5_11 — Turntable (rotating-object) reconstruction [S9]
- Meshroom / AliceVision. (n.d.). https://alicevision.org/ — Alternative reconstruction [S10]
- OpenCV ’solvePnP‘. (n.d.). https://docs.opencv.org/4.13.0/d5/d1f/calib3d_solvePnP.html — Camera axis convention, pose checks [S11]
- OpenCV ChArUco calibration. (n.d.). https://docs.opencv.org/4.13.0/da/d13/tutorial_aruco_calibration.html — Scan-mode intrinsics, scanning mat [S12]
- Schnieders, D., & Wong, K.-Y. K. (2013). Camera and light calibration from reflections on a sphere. Computer Vision and Image Understanding. https://www.sciencedirect.com/science/article/abs/pii/S1077314213001082 — Chrome-ball light calibration [S13]
- Yu, Chen, & Da. (2025). Geometric calibration for photometric stereo under near-field point light sources using spheres. Optics & Laser Technology, 180. https://www.sciencedirect.com/science/article/pii/S0030399224010156 — Near-light correction (phase 11) [S14]
- Goldman, D. B., Curless, B., Hertzmann, A., & Seitz, S. M. (2005). Shape and spatially-varying BRDFs from photometric stereo. https://doi.org/10.1109/ICCV.2005.219 — Material on the mesh (phase 13) [S15]
- Blender manual: PLY, OBJ, glTF 2.0, formats. (n.d.). https://docs.blender.org/manual/en/latest/files/import_export/ply.html — Mesh import check [S16]
- OpenMVS. (n.d.). https://github.com/cdcseacave/openMVS — Optional dense/mesh stage [S17]
- RealityScan (formerly RealityCapture). (n.d.). https://www.realityscan.com/license — Optional reconstruction [S18]
- QuakeHold! Museum putty. (n.d.). https://www.sosproducts.com/quakehold-museum-putty-p/64810.htm — Heavier-object option [S19]
- Loctite fun-tak 2 oz. (n.d.). https://www.staples.com/Loctite-Fun-Tak-2-oz-Mounting-Adhesive-Putty-1270884/product_1480018 — $3.49 object mount [S20]

## Geometric camera calibration

- Zhang, Z. (2000). A flexible new technique for camera calibration. IEEE Transactions on Pattern Analysis and Machine Intelligence, 22(11), 1330–1334. https://doi.org/10.1109/34.888718 — Planar-target intrinsics (phase 06) [V1]
- Tsai, R. Y. (1987). A versatile camera calibration technique for high-accuracy 3D machine vision metrology using off-the-shelf TV cameras and lenses. IEEE Journal of Robotics and Automation, 3(4), 323–344. https://doi.org/10.1109/JRA.1987.1087109 — Classic calibration background (phase 06) [V2]
- Heikkilä, J., & Silvén, O. (1997). A four-step camera calibration procedure with implicit image correction. Proceedings of the IEEE Conference on Computer Vision and Pattern Recognition, 1106–1112. https://doi.org/10.1109/CVPR.1997.609468 — Distortion model and correction (phase 06) [V3]
- Brown, D. C. (1971). Close-range camera calibration. Photogrammetric Engineering, 37(8), 855–866. https://www.semanticscholar.org/paper/Close-Range-Camera-Calibration-Brown/1150007b62a3c7dac99c2c8f85c63bfab74891af — Radial/tangential lens distortion (phase 06) [V4]
- Bouguet, J.-Y. (2022). Camera calibration toolbox for Matlab. https://doi.org/10.22002/D1.20164 — Reference calibration workflow (phase 06) [V5]
- Schöps, T., Larsson, V., Pollefeys, M., & Sattler, T. (2020). Why having 10,000 parameters in your camera model is better than twelve. Proceedings of the IEEE Conference on Computer Vision and Pattern Recognition. https://openaccess.thecvf.com/content_CVPR_2020/html/Schops_Why_Having_10000_Parameters_in_Your_Camera_Model_Is_Better_CVPR_2020_paper.html — Calibration accuracy limits (phase 17) [V6]
- Garrido-Jurado, S., Muñoz-Salinas, R., Madrid-Cuevas, F. J., & Marín-Jiménez, M. J. (2014). Automatic generation and detection of highly reliable fiducial markers under occlusion. Pattern Recognition, 47(6), 2280–2292. https://doi.org/10.1016/j.patcog.2014.01.005 — ArUco markers on ChArUco board (phases 06, 11) [V7]
- Hartley, R., & Zisserman, A. (2004). Multiple view geometry in computer vision (2nd ed.). https://doi.org/10.1017/CBO9780511811685 — Projection, triangulation, bundle adjustment (phases 06, 11) [V8]
- Szeliski, R. (2022). Computer vision: Algorithms and applications (2nd ed.). https://doi.org/10.1007/978-3-030-34372-9 — General CV reference (phases 06, 07, 08, 09, 10, 11, 12, 13) [V9]

## Hand-eye and robot-world calibration (AX=XB, AX=YB)

- Tsai, R. Y., & Lenz, R. K. (1989). A new technique for fully autonomous and efficient 3D robotics hand/eye calibration. IEEE Transactions on Robotics and Automation, 5(3), 345–358. https://doi.org/10.1109/70.34770 — Hand-eye AX=XB baseline (phase 11) [V10]
- Park, F. C., & Martin, B. J. (1994). Robot sensor calibration: Solving AX=XB on the Euclidean group. IEEE Transactions on Robotics and Automation, 10(5), 717–721. https://doi.org/10.1109/70.326576 — Lie-group hand-eye solver (phase 11) [V11]
- Daniilidis, K. (1999). Hand-eye calibration using dual quaternions. International Journal of Robotics Research, 18(3), 286–298. https://doi.org/10.1177/02783649922066213 — Simultaneous rotation/translation hand-eye (phase 11) [V12]
- Zhuang, H., Roth, Z. S., & Sudhakar, R. (1994). Simultaneous robot/world and tool/flange calibration by solving homogeneous transformation equations of the form AX=YB. IEEE Transactions on Robotics and Automation, 10(4), 549–554. https://doi.org/10.1109/70.313105 — AX=YB formulation (phase 11) [V13]
- Dornaika, F., & Horaud, R. (1998). Simultaneous robot-world and hand-eye calibration. IEEE Transactions on Robotics and Automation, 14(4), 617–622. https://doi.org/10.1109/70.704233 — AX=YB nonlinear solution (phase 11) [V14]
- Shah, M. (2013). Solving the robot-world/hand-eye calibration problem using the Kronecker product. Journal of Mechanisms and Robotics, 5(3), 031007. https://doi.org/10.1115/1.4024473 — Closed-form AX=YB (OpenCV SHAH) (phase 11) [V15]
- Tabb, A., & Ahmad Yousef, K. M. (2017). Solving the robot-world hand-eye(s) calibration problem with iterative methods. Machine Vision and Applications. https://doi.org/10.1007/s00138-017-0841-7 — Reprojection-error AX=YB refinement (phase 11) [V16]
- Ali, I., Suominen, O., Gotchev, A., & Ruiz Morales, E. (2019). Methods for simultaneous robot-world-hand–eye calibration: A comparative study. Sensors, 19(12), 2837. https://doi.org/10.3390/s19122837 — Choosing an AX=YB method (phase 11) [V17]
- OpenCV, camera calibration and 3D reconstruction (’calibrateHandEye‘, ’calibrateRobotWorldHandEye‘). (n.d.). https://docs.opencv.org/4.13.0/d9/d0c/group__calib3d.html — Hand-eye implementation (phase 11) [V18]

## Radiometric calibration and HDR capture

- Mitsunaga, T., & Nayar, S. K. (1999). Radiometric self calibration. Proceedings of the IEEE Conference on Computer Vision and Pattern Recognition, 374–380. https://doi.org/10.1109/CVPR.1999.786966 — Polynomial response curve (phase 07) [V19]
- Robertson, M. A., Borman, S., & Stevenson, R. L. (2003). Estimation-theoretic approach to dynamic range enhancement using multiple exposures. Journal of Electronic Imaging, 12(2), 219–228. https://doi.org/10.1117/1.1557695 — Weighted HDR merge (OpenCV Robertson) (phase 07) [V20]
- Grossberg, M. D., & Nayar, S. K. (2003). What is the space of camera response functions? Proceedings of the IEEE Conference on Computer Vision and Pattern Recognition. https://doi.org/10.1109/TPAMI.2004.88 — Response-curve prior (EMoR) (phase 07) [V21]
- Hasinoff, S. W., Durand, F., & Freeman, W. T. (2010). Noise-optimal capture for high dynamic range photography. Proceedings of the IEEE Conference on Computer Vision and Pattern Recognition, 553–560. https://doi.org/10.1109/CVPR.2010.5540167 — Choosing exposure brackets (phase 07) [V22]
- Granados, M., Ajdin, B., Wand, M., Theobalt, C., Seidel, H.-P., & Lensch, H. P. A. (2010). Optimal HDR reconstruction with linear digital cameras. Proceedings of the IEEE Conference on Computer Vision and Pattern Recognition. https://vcai.mpi-inf.mpg.de/projects/opthdr/ — Noise-weighted HDR merge (phase 07) [V23]
- Reinhard, E., Ward, G., Pattanaik, S., Debevec, P., Heidrich, W., & Myszkowski, K. (2010). High dynamic range imaging: Acquisition, display, and image-based lighting (2nd ed.). https://www.oreilly.com/library/view/high-dynamic-range/9780123749147/ — HDR formats and theory (phase 07) [V24]

## Photometric stereo

- Hertzmann, A., & Seitz, S. M. (2005). Example-based photometric stereo: Shape reconstruction with general, varying BRDFs. IEEE Transactions on Pattern Analysis and Machine Intelligence, 27(8), 1254–1264. https://doi.org/10.1109/TPAMI.2005.158 — Reference-sphere PS for glossy objects (phase 11) [V25]
- Basri, R., Jacobs, D., & Kemelmacher, I. (2007). Photometric stereo with general, unknown lighting. International Journal of Computer Vision, 72(3), 239–257. https://doi.org/10.1007/s11263-006-8815-7 — Spherical-harmonic lighting PS (phase 12) [V26]
- Ackermann, J., & Goesele, M. (2015). A survey of photometric stereo techniques. Foundations and Trends in Computer Graphics and Vision, 9. https://doi.org/10.1561/0600000065 — PS method overview (phases 11, 12) [V27]
- Shi, B. et al. (2016). A benchmark dataset and evaluation for non-Lambertian and uncalibrated photometric stereo. Proceedings of the IEEE Conference on Computer Vision and Pattern Recognition. https://openaccess.thecvf.com/content_cvpr_2016/html/Shi_A_Benchmark_Dataset_CVPR_2016_paper.html — PS validation dataset (phase 12) [V28]
- Mecca, R., Wetzler, A., Bruckstein, A. M., & Kimmel, R. (2014). Near field photometric stereo with point light sources. SIAM Journal on Imaging Sciences, 7(4), 2732–2770. https://doi.org/10.1137/140968100 — Near-light PS model (phase 12) [V29]
- Quéau, Y., Durix, B., Wu, T., Cremers, D., Lauze, F., & Durou, J.-D. (2018). LED-based photometric stereo: Modeling, calibration and numerical solution. Journal of Mathematical Imaging and Vision, 60(3), 313–340. https://doi.org/10.1007/s10851-017-0761-1 — LED anisotropy and falloff model (phases 11, 12) [V30]
- Logothetis, F., Quéau, Y., Mecca, R., & Cipolla, R. (2017). Semi-calibrated near-light photometric stereo. SSVM. https://doi.org/10.1007/978-3-319-58771-4_52 — Unknown LED intensities (phase 12) [V31]
- Santo, H., Waechter, M., & Matsushita, Y. (2020). Deep near-light photometric stereo for spatially varying reflectances. European Conference on Computer Vision. https://doi.org/10.1007/978-3-030-58598-3_9 — Learned near-light PS option (phase 17) [V32]
- Papadhimitri, T., & Favaro, P. (2013). A new perspective on uncalibrated photometric stereo. Proceedings of the IEEE Conference on Computer Vision and Pattern Recognition. https://openaccess.thecvf.com/content_cvpr_2013/papers/Papadhimitri_A_New_Perspective_2013_CVPR_paper.pdf — Perspective uncalibrated PS fallback (phase 12) [V33]
- Ikehata, S. (2018). CNN-PS: CNN-based photometric stereo for general non-convex surfaces. European Conference on Computer Vision. https://doi.org/10.1007/978-3-030-01267-0_1 — Learned PS for glossy objects (phase 17) [V34]
- Quéau, Y., Durou, J.-D., & Aujol, J.-F. (2018). Normal integration: A survey. Journal of Mathematical Imaging and Vision, 60(4), 576–593. https://doi.org/10.1007/s10851-017-0773-x — Normals to depth map (phase 12) [V35]
- Nehab, D., Rusinkiewicz, S., Davis, J., & Ramamoorthi, R. (2005). Efficiently combining positions and normals for precise 3D geometry. ACM Transactions on Graphics, 24(3). https://gfx.cs.princeton.edu/pubs/Nehab_2005_ECP/index.php — Fuse PS normals with mesh (phase 12) [V36]

## Multi-view reconstruction, visual hulls, meshing

- Snavely, N., Seitz, S. M., & Szeliski, R. (2006). Photo tourism: Exploring photo collections in 3D. ACM Transactions on Graphics, 25(3), 835–846. https://doi.org/10.1145/1141911.1141964 — Incremental SfM background (phase 12) [V37]
- Furukawa, Y., & Ponce, J. (2010). Accurate, dense, and robust multiview stereopsis. IEEE Transactions on Pattern Analysis and Machine Intelligence, 32(8), 1362–1376. https://doi.org/10.1109/TPAMI.2009.161 — Patch-based MVS (PMVS) (phase 12) [V38]
- Furukawa, Y., & Hernández, C. (2015). Multi-view stereo: A tutorial. Foundations and Trends in Computer Graphics and Vision, 9. https://doi.org/10.1561/0600000052 — MVS overview (phase 12) [V39]
- Griwodz, C. et al. (2021). AliceVision meshroom: An open-source 3D reconstruction pipeline. Proc. ACM MMSys. https://doi.org/10.1145/3458305.3478443 — Alternative pipeline citation (phase 12) [V40]
- Matusik, W., Buehler, C., Raskar, R., Gortler, S. J., & McMillan, L. (2000). Image-based visual hulls. Proc. SIGGRAPH. https://doi.org/10.1145/344779.344951 — Silhouette visual hull (phase 12) [V41]
- Hernández Esteban, C., & Schmitt, F. (2004). Silhouette and stereo fusion for 3D object modeling. Computer Vision and Image Understanding, 96(3), 367–392. https://www.sciencedirect.com/science/article/abs/pii/S1077314204000542 — Hull + stereo fusion on turntable (phase 12) [V42]
- Lorensen, W. E., & Cline, H. E. (1987). Marching cubes: A high resolution 3D surface construction algorithm. Proc. SIGGRAPH. https://doi.org/10.1145/37401.37422 — Voxel grid to mesh (phase 12) [V43]
- Curless, B., & Levoy, M. (1996). A volumetric method for building complex models from range images. Proc. SIGGRAPH. https://doi.org/10.1145/237170.237269 — TSDF fusion of depth maps (phase 12) [V44]
- Kazhdan, M., Bolitho, M., & Hoppe, H. (2006). Poisson surface reconstruction. Eurographics Symposium on Geometry Processing. https://diglib.eg.org/items/245d6ba1-0209-4365-a4a4-16ce46421620 — Oriented points to mesh (phase 12) [V45]
- Kazhdan, M., & Hoppe, H. (2013). Screened Poisson surface reconstruction. ACM Transactions on Graphics, 32(3), 29. https://doi.org/10.1145/2487228.2487237 — Default meshing step (phase 12) [V46]
- Zhou, Q.-Y., Park, J., & Koltun, V. (2018). Open3D: A modern library for 3D data processing. https://arxiv.org/abs/1801.09847 — Point cloud/mesh library (phases 12, 13, 14) [V47]

## Reflectance capture rigs and polarization

- Debevec, P., Hawkins, T., Tchou, C., Duiker, H.-P., Sarokin, W., & Sagar, M. (2000). Acquiring the reflectance field of a human face. Proc. SIGGRAPH. https://doi.org/10.1145/344779.344855 — Light-stage relighting concept (phases 09, 11) [V48]
- Ma, W.-C., Hawkins, T., Peers, P., Chabert, C.-F., Weiss, M., & Debevec, P. (2007). Rapid acquisition of specular and diffuse normal maps from polarized spherical gradient illumination. Eurographics Symposium on Rendering. https://diglib.eg.org/items/da04b92c-39fe-41d1-a658-a8535521521c — Polarized diffuse/specular normals (phase 10) [V49]
- Ghosh, A., Fyffe, G., Tunwattanapong, B., Busch, J., Yu, X., & Debevec, P. (2011). Multiview face capture using polarized spherical gradient illumination. ACM Transactions on Graphics, 30(6). https://doi.org/10.1145/2070781.2024163 — Multi-view polarized capture (phases 10, 11) [V50]
- Nayar, S. K., Fang, X.-S., & Boult, T. (1997). Separation of reflection components using color and polarization. International Journal of Computer Vision, 21(3), 163–186. https://doi.org/10.1023/A:1007937815113 — Diffuse/specular split with polarizer (phase 10) [V51]
- Wolff, L. B. (1990). Polarization-based material classification from specular reflection. IEEE Transactions on Pattern Analysis and Machine Intelligence, 12(11), 1059–1071. https://doi.org/10.1109/34.61705 — Polarization physics background (phase 10) [V52]

## Open-source turntable scanners

- OpenScan (Raspberry Pi photogrammetry scanner). (n.d.). https://openscan.eu/pages/openscan-mini — DIY scanner prior art (phase 11) [V53]
- FabScan, media computing group, RWTH aachen university. (n.d.). https://hci.rwth-aachen.de/fabscan — Turntable laser scanner prior art (phase 11) [V54]
- BQ ciclop scanner + horus software. (n.d.). https://github.com/bqlabs/ciclop — Turntable calibration UX reference (phases 11, 14) [V55]

## Texturing and UV unwrapping

- Lévy, B., Petitjean, S., Ray, N., & Maillot, J. (2002). Least squares conformal maps for automatic texture atlas generation. ACM Transactions on Graphics, 21(3), 362–371. https://doi.org/10.1145/566654.566590 — LSCM UV unwrapping (phase 13) [V56]
- Xatlas, mesh parameterization / UV unwrapping library. (n.d.). https://github.com/jpcy/xatlas — Automatic UV atlas (phase 13) [V57]
- Waechter, M., Moehrle, N., & Goesele, M. (2014). Let there be color! Large-scale texturing of 3D reconstructions. European Conference on Computer Vision. https://doi.org/10.1007/978-3-319-10602-1_54 — View selection for mesh textures (phase 13) [V58]

# Appendix D · Standards, colour, optics, safety

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

## Appearance and scatter measurement standards (ASTM)

- ASTM International. (2019). Standard practice for goniometric optical scatter measurements. https://store.astm.org/e2387-19.html — BRDF/BTDF measurement practice (phases 07, 08) [N1]
- ASTM International. (2003). Standard practice for angle resolved optical scatter measurements on specular or diffuse surfaces. https://www.astm.org/DATABASE.CART/WITHDRAWN/E1392.htm — Historical BRDF practice cited by Labsphere (phase 07) [N2]
- ASTM International. (2005). Standard practice for goniophotometry of objects and materials. https://store.astm.org/e0167-96.html — Goniophotometer geometry conventions (phase 06) [N3]
- ASTM International. (n.d.). Standard test method for specular gloss. https://store.astm.org/standards/d523 — 20/60/85° gloss cross-check (phase 07) [N4]
- ASTM International. (2023b). Standard test methods for measurement of gloss of high-gloss surfaces by abridged goniophotometry. https://store.astm.org/standards/e430 — Haze/distinctness-of-image near specular (phases 08, 17) [N5]
- ASTM International. (2025a). Standard terminology of appearance. https://doi.org/10.1520/E0284-25 — Docs glossary terms (phase 00) [N6]
- ASTM International. (2026). Standard practice for specifying the geometry of multiangle spectrophotometers. https://store.astm.org/standards/e2175 — Reporting light/camera angle geometry (phase 08) [N7]
- ASTM International. (2025b). Standard test method for multiangle color measurement of metal flake pigmented materials. https://doi.org/10.1520/E2194-14R25 — Aspecular angles for metallic samples (phases 08, 09) [N8]
- ASTM International. (2023a). Standard practice for obtaining spectrometric data for object-color evaluation. https://store.astm.org/standards/e1164 — Spectral data and calibration practice (phase 10) [N9]
- ISO, “paints and varnishes. (n.d.). https://www.iso.org/standard/56807.html — Gloss reference geometry (phase 07) [N10]
- Nadal, M. E., & Thompson, E. A. (2001). NIST reference goniophotometer for specular gloss measurements. Journal of Coatings Technology, 73(917), 73–80. https://www.paint.org/wp-content/uploads/2021/09/jctJUNE01-Nadal.pdf — Reference-instrument design and uncertainty (phases 06, 17) [N11]

## CIE colorimetry, appearance and colour rendering

- CIE. (2006). A framework for the measurement of visual appearance. https://cie.co.at/publications/framework-measurement-visual-appearance — Colour/gloss/translucency/texture scope (phase 00) [N12]
- CIE. (2018). Colorimetry, 4th edition. https://doi.org/10.25039/TR.015.2018 — XYZ, CIELAB, illuminants from spectra (phase 10) [N13]
- CIE. (2020). ILV: International lighting vocabulary, 2nd edition. https://doi.org/10.25039/S017.2020 — Radiometric/photometric terminology (phase 00) [N14]
- CIE. (1995). Method of measuring and specifying colour rendering properties of light sources. https://cie.co.at/publications/method-measuring-and-specifying-colour-rendering-properties-light-sources — COB CRI (Ra) meaning (phases 04, 10) [N15]
- CIE. (2017). CIE 2017 colour fidelity index for accurate scientific use. https://doi.org/10.25039/TR.224.2017 — Rf for white and LED-bank spectra (phase 10) [N16]
- K. A. G. Smet, CRI_CIE_rf_2017 calculator (MATLAB/excel). (n.d.). https://github.com/ksmet1977/CRI_CIE_Rf_2017 — Checking our Rf implementation (phase 10) [N17]
- IES. (n.d.). Technical memorandum: IES method for evaluating light source color rendition. https://store.ies.org/product/technical-memorandum-ies-method-for-evaluating-light-source-color-rendition/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 — Rf/Rg report for light sources (phase 10) [N18]
- Royer, M. P. (2019). Analysis of color rendition specification criteria. Proceedings of SPIE. https://www.energy.gov/cmei/ssl/articles/analysis-color-rendition-specification-criteria — Choosing Rf/Rg acceptance thresholds (phase 10) [N19]
- Ohno, Y. (2005). Spectral design considerations for white LED color rendering. Optical Engineering, 44(11). https://doi.org/10.1117/1.2130694 — Designing the 8-band LED spectrum (phase 10) [N20]

## Colour science books

- Wyszecki, G., & Stiles, W. S. (1982). Color science: Concepts and methods, quantitative data and formulae (2nd ed.). https://doi.org/10.1002/col.5080080421 — Colorimetric data and formulae (phase 10) [N21]
- Fairchild, M. D. (2013). Color appearance models (3rd ed.). https://doi.org/10.1002/9781118653128 — Appearance/white point for renders (phases 10, 13) [N22]
- Hunt, R. W. G., & Pointer, M. R. (2011). Measuring colour (4th ed.). https://doi.org/10.1002/9781119975595 — Practical colour measurement geometry (phase 10) [N23]

## Camera characterization and colour encoding

- EMVA. (2021). Standard 1288: Standard for characterization of image sensors and cameras. https://www.emva.org/standards-technology/emva-1288/ — IMX477 linearity, noise, dark current tests (phases 06, 07) [N24]
- ISO, “photography. (n.d.-a). https://www.iso.org/standard/79169.html — Slanted-edge SFR of 16 mm lens (phase 06) [N25]
- ISO, “photography. (n.d.-b). https://www.iso.org/standard/82233.html — Noise and dynamic range for HDR (phase 07) [N26]
- ISO, “graphic technology and photography. (n.d.). https://www.iso.org/standard/35835.html — Camera spectral sensitivity/colour matrix (phase 10) [N27]
- IEC, “multimedia systems and equipment. (n.d.). https://webstore.ansi.org/standards/iec/iec61966ed1999 — sRGB transfer function for texture export (phases 07, 13) [N28]
- M. Stokes, M. Anderson, S. Chandrasekar, R. Motta, “a standard default color space for the internet. (n.d.). https://www.w3.org/Graphics/Color/sRGB.html — Linear vs gamma-encoded texture handling (phase 13) [N29]

## Reflectance standards (PTFE / Spectralon)

- Weidner, V. R., & Hsia, J. J. (1981). Reflection properties of pressed polytetrafluoroethylene powder. Journal of the Optical Society of America, 71(7), 856–861. https://doi.org/10.1364/JOSA.71.000856 — PTFE white reference reflectance (phase 07) [N30]
- Weidner, V. R., Hsia, J. J., & Adams, B. (1985). Laboratory intercomparison study of pressed polytetrafluoroethylene powder reflectance standards. Applied Optics, 24(14), 2225. https://doi.org/10.1364/AO.24.002225 — PTFE reference repeatability (phase 07) [N31]
- Hsia, J. J., & Barnes, P. Y. (1995). 45°/0° reflectance factors of pressed polytetrafluoroethylene (PTFE) powder. https://doi.org/10.6028/NIST.TN.1413 — 45/0 PTFE factor for our geometry (phase 07) [N32]
- Barnes, P. Y., Early, E. A., & Parr, A. C. (1998b). Spectral reflectance. https://doi.org/10.6028/NIST.SP.250-48 — Traceable reflectance calibration method (phase 07) [N33]
- Labsphere. (n.d.). Technical guide: Reflectance materials and coatings. https://www.systems-eng.co.jp/dcms_media/other/Guide_Reflectance_Materials_Coatings.pdf — Spectralon vs DIY PTFE choice (phase 07) [N34]
- Springsteen, A. (1998a). Reflectance spectroscopy: An overview of classification and techniques. In Applied spectroscopy: A compact reference for practitioners (pp. 193–224). Academic Press. https://doi.org/10.1016/B978-012764070-9/50008-1 — Reflectance geometry nomenclature (phase 07) [N35]
- Springsteen, A. (1998b). Standards for reflectance measurements. In Applied spectroscopy: A compact reference for practitioners (pp. 247–267). Academic Press. https://doi.org/10.1016/B978-012764070-9/50010-X — Choosing white/grey/black references (phase 07) [N36]

## Multispectral imaging with LED illumination

- Park, J.-I., Lee, M.-H., Grossberg, M. D., & Nayar, S. K. (2007). Multispectral imaging using multiplexed illumination. Proceedings of the IEEE International Conference on Computer Vision, 1–8. https://doi.org/10.1109/ICCV.2007.4409090 — Multiplexed LED band capture (phase 10) [N37]
- Shrestha, R., & Hardeberg, J. Y. (2013). Multispectral imaging using LED illumination and an RGB camera. Color and Imaging Conference, 21(1), 8–13. https://doi.org/10.2352/CIC.2013.21.1.art00003 — LED bank + RGB camera reflectance (phase 10) [N38]
- Shrestha, R., & Hardeberg, J. Y. (2014a). Evaluation and comparison of multispectral imaging systems. Color and Imaging Conference, 22(1). https://doi.org/10.2352/CIC.2014.22.1.art00018 — Spectral accuracy metrics (phases 10, 17) [N39]
- Shrestha, R., & Hardeberg, J. Y. (2014b). How are LED illumination based multispectral imaging systems influenced by different factors? ICISP 2014, 61, 61–71. https://doi.org/10.1007/978-3-319-07998-1_8 — Noise/band-count sensitivity of LED bank (phase 10) [N40]
- Imai, F. H., Berns, R. S., & Tzeng, D.-Y. (2000). A comparative analysis of spectral reflectance estimated in various spaces using a trichromatic camera system. Journal of Imaging Science and Technology, 44(4), 280–287. https://doi.org/10.2352/J.ImagingSci.Technol.2000.44.4.art00003 — Spectral reconstruction from camera signals (phase 10) [N41]
- Imai, F. H., Rosen, M. R., & Berns, R. S. (2000). Comparison of spectrally narrow-band capture versus wide-band with a priori sample analysis for spectral reflectance estimation. Color and Imaging Conference, 8(1), 234–241. https://doi.org/10.2352/CIC.2000.8.1.art00043 — Narrow-band LEDs vs filters trade-off (phase 10) [N42]
- Hardeberg, J. Y. (2001). Acquisition and reproduction of color images: Colorimetric and multispectral approaches. https://doi.org/10.1002/col.10073 — Camera colorimetric/spectral calibration (phase 10) [N43]
- Hardeberg, J. Y. (2004). Filter selection for multispectral color image acquisition. Journal of Imaging Science and Technology, 48(2). https://doi.org/10.2352/J.ImagingSci.Technol.2004.48.2.art00005 — Choosing the 8 LED bands (phase 10) [N44]

## Optics textbooks

- Kingslake, R., & Johnson, R. B. (2010). Lens design fundamentals (2nd ed.). https://doi.org/10.1016/B978-0-12-374301-5.00008-5 — M12 lens f-number/aberration reasoning (phase 06) [N45]
- Goodman, J. W. (2017). Introduction to Fourier optics (1st ed.). https://doi.org/10.1063/1.3035549 — Diffraction limit and MTF at f/8 (phase 06) [N46]

## Photobiological and machine/electrical safety

- IEC. (n.d.). Photobiological safety of lamps and lamp systems. https://doi.org/10.3403/30149289 — COB and LED-bank eye-safety risk groups (phases 04, 10) [N47]
- ISO, “safety of machinery. (n.d.-a). https://doi.org/10.3403/30265059 — E-stop category and reset behaviour (phases 01, 02) [N48]
- IEC, “safety of machinery. (n.d.). https://doi.org/10.3403/30238348 — Power wiring, colours, stop circuit (phase 01) [N49]
- ISO, “safety of machinery. (n.d.-b). https://doi.org/10.3403/30201665 — Pinch-point/hazard risk assessment (phases 00, 16) [N50]
- IEC, “audio/video, information and communication technology equipment. (n.d.). https://doi.org/10.3403/30347376U — Bought-in PSU safety listing (phase 01) [N51]

# Appendix E · Motion control, electronics, open hardware

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

## Stepper drivers and microcontrollers

- Analog Devices (Trinamic). (n.d.-b). TMC2209 datasheet. https://www.analog.com/media/en/technical-documentation/data-sheets/tmc2209_datasheet_rev1.09.pdf — Driver registers, UART, current (phase 02) [H1]
- Analog Devices (Trinamic). (n.d.-a). AN-002: Parameterization of StallGuard2 & CoolStep. https://www.analog.com/en/resources/app-notes/an-002.html — Stall-detection thresholds, crash detection (phases 02, 04) [H2]
- Dwersteg (Analog Devices/Trinamic), B. (n.d.). AN-026: Programmable adaptive microstep table. https://www.analog.com/en/resources/app-notes/an-026.html — Microstep linearity, even step spacing (phases 08, 09) [H3]
- Marlin Firmware. (n.d.). Trinamic drivers. https://marlinfw.org/docs/hardware/tmc_drivers.html — StealthChop vs SpreadCycle choice (phase 02) [H4]
- Espressif Systems. (n.d.-b). ESP32 technical reference manual. https://documentation.espressif.com/esp32_technical_reference_manual_en.pdf — E4 MCU peripherals, step timing (phase 02) [H5]
- Espressif Systems. (n.d.-a). ESP32 series datasheet. https://www.espressif.com/sites/default/files/documentation/esp32_datasheet_en.pdf — Strapping pins, electrical limits (phase 02) [H6]
- Raspberry Pi Ltd. (n.d.-b). RP2040 datasheet. https://datasheets.raspberrypi.com/rp2040/rp2040-datasheet.pdf — Pico GPIO, pull-ups, PIO (phase 02) [H7]
- Raspberry Pi Ltd. (n.d.-a). Raspberry Pi Pico-series Python SDK: A MicroPython environment for Raspberry Pi microcontrollers. https://datasheets.raspberrypi.com/pico/raspberry-pi-pico-python-sdk.pdf — MicroPython button-hub firmware (phase 02) [H8]

## Interface electronics and position sensors

- Sharp Corporation. (2018). PC817XxNSZ1B series. https://global.sharp/products/device/lineup/data/pdf/datasheet/PC817XxNSZ1B_e.pdf — 24 V sense optocoupler, CTR (phase 01) [H9]
- Texas Instruments. (2025). ULN200x, ULQ200x high-voltage, high-current darlington transistor arrays. https://www.ti.com/lit/gpn/ULN2003A — 8-band LED low-side switching (phase 10) [H10]
- Vishay Semiconductors. (n.d.). TCST2103, TCST2202, TCST2300: Transmissive optical sensor with phototransistor output. https://www.vishay.com/docs/81147/tcst2103.pdf — Optical homing flag, 1 mm aperture (phases 04, 05) [H11]
- ams AG (ams OSRAM). (2014). AS5600 – 12-bit programmable contactless potentiometer. https://www.mouser.com/pdfdocs/AMS_AS5600_Datasheet_EN.PDF — Absolute-angle check of axes (phase 17) [H12]

## Camera interface

- Sony Semiconductor Solutions. (2018). IMX477-AACK: Diagonal 7.857 mm (type 1/2.3) 12.3 mega-pixel CMOS image sensor. https://www.sony-semicon.com/files/62/pdf/p-13_IMX477-AACK_Flyer.pdf — Pixel pitch 1.55 µm, sensor size (phase 06) [H13]
- USB Implementers Forum. (2012). Video class v1.5 document set. https://www.usb.org/document-library/video-class-v15-document-set — UVC exposure/white-balance controls (phase 06) [H14]
- Linux kernel documentation. (n.d.). The linux USB video class (UVC) driver. https://www.kernel.org/doc/html/latest/userspace-api/media/drivers/uvcvideo.html — uvcvideo controls, extension units (phases 06, 14) [H15]

## Belt drives and positioning accuracy

- Gates Corporation. (n.d.-b). PowerGrip GT2 belt drives – drive design manual. https://docs.rs-online.com/5016/0900766b8002d3b7.pdf — GT tooth profile, registration, backlash (phases 04, 05) [H16]
- Gates Corporation. (n.d.-a). Light power & precision drive design manual. https://www.gates.com/content/dam/documents-library/catalogs/light-power-and-precision-manual.pdf — Small-pitch pulley sizing, tension (phases 04, 05) [H17]
- Prusa Research. (n.d.). Adjusting belt tension (CORE one/+, CORE one INDX, CORE one L/+). https://help.prusa3d.com/article/adjusting-belt-tension-core-one_845048 — Frequency-based belt tension check (phase 04) [H18]
- Oriental Motor USA. (n.d.). Stepper motor basics. https://www.orientalmotor.com/stepper-motors/technology/stepper-motor-basics.html — Angular error budget per axis (phase 07) [H19]
- Walter, M. (2016). How accurate is microstepping really? Hackaday, 29. https://hackaday.com/2016/08/29/how-accurate-is-microstepping-really/ — Microsteps ≠ accuracy under load (phase 08) [H20]
- Fritz Faulhaber GmbH, Dr. (n.d.). Stepper motor technical note: Microstepping myths and realities. https://www.faulhaber.com/fileadmin/user_upload/Support/dff_200276_whitepaper_microstepping_8cb.pdf — Incremental torque per microstep (phase 08) [H21]
- Zaber Technologies. (n.d.). Microstepping tutorial. https://www.zaber.com/technical-articles/microstepping-tutorial — Stiction vs microstep resolution (phase 07) [H22]
- Chang, C., & Tran, T. (2025). Mastering precision: Understanding microstepping in motion control. Analog Dialogue, 59(2). https://www.analog.com/en/resources/analog-dialogue/articles/mastering-precision-understanding-microstepping.html — Microstep current waveforms, holding torque (phase 02) [H23]

## Motion firmware, homing and G-code

- Grbl project (gnea). (n.d.). An open source, embedded, high performance g-code-parser and CNC milling controller. https://github.com/gnea/grbl — FluidNC lineage, protocol, homing cycle (phase 02) [H24]
- grblHAL. (n.d.). grblHAL core code and master wiki. https://github.com/grblHAL/core — Alternative Grbl-derived firmware (phase 02) [H25]
- LinuxCNC. (n.d.). Homing configuration. https://linuxcnc.org/docs/html/config/ini-homing.html — Two-speed search/latch homing (phases 04, 05) [H26]
- Kramer, T. R., Proctor, F. M., & Messina, E. R. (2000). The NIST RS274NGC interpreter – version 3. https://www.nist.gov/publications/nist-rs274ngc-interpreter-version-3 — G-code semantics for capture scripts (phase 14) [H27]

## Open-source hardware practice and licensing

- Pearce, J. M. (2012). Building research equipment with free, open-source hardware. Science, 337(6100), 1303–1304. https://doi.org/10.1126/science.1228183 — Rationale for open lab equipment (phase 00) [H28]
- Pearce, J. M. (2014). Open-source lab: How to build your own hardware and reduce research costs. Elsevier. https://doi.org/10.1016/C2012-0-07249-3 — Low-cost scientific tool design (phase 00) [H29]
- Jones, R., Haufe, P., Sells, E., Iravani, P., Olliver, V., Palmer, C., & Bowyer, A. (2011). RepRap – the replicating rapid prototyper. Robotica, 29(1), 177–191. https://doi.org/10.1017/S026357471000069X — Printed-part machine heritage (phase 03) [H30]
- Open Source Hardware Association. (n.d.). Open source hardware (OSHW) definition 1.0. https://oshwa.org/definition/ — Release documentation criteria (phase 16) [H31]
- CERN. (n.d.). CERN open hardware licence version 2. https://www.ohwr.org/cernohl — Hardware licence choice (phase 16) [H32]
- Gathering for Open Science Hardware. (n.d.). GOSH manifesto. https://openhardware.science/gosh-manifesto/ — Project values, accessibility (phase 16) [H33]
- Bonvoisin, J., Mies, R., Boujut, J.-F., & Stark, R. (2017). What is the ’source’ of open source hardware? Journal of Open Hardware, 1(1). https://doi.org/10.5334/joh.7 — What files to publish (phase 16) [H34]
- Collins, J. T., Knapper, J., Stirling, J., …, & Bowman, R. (2020). Robotic microscopy for everyone: The OpenFlexure microscope. Biomedical Optics Express, 11(5), 2447–2460. https://doi.org/10.1364/BOE.385729 — Model for documented printed instrument (phases 00, 16) [H35]
- Elsevier. (n.d.). Guide for authors – HardwareX. https://doi.org/10.5281/zenodo.5078227 — Paper structure, BOM, validation (phase 16) [H36]

## Low-cost open instruments (HardwareX and related)

- Toschke, Y., Klenen, J., & Imlau, M. (2024). Open photonics: An integrated approach for building a 3D-printed motorized rotation stage system. HardwareX, 20, e00577. https://doi.org/10.1016/j.ohx.2024.e00577 — ESP32 rotation stage, home switch (phases 05, 09) [H37]
- Schneidereit, D., Kraus, L., Meier, J. C., Friedrich, O., & Gilbert, D. F. (2017). Step-by-step guide to building an inexpensive 3D printed motorized positioning stage for automated high-content screening microscopy. Biosensors and Bioelectronics, 92, 472–481. https://doi.org/10.1016/j.bios.2016.10.078 — Printed stepper stage accuracy (phase 03) [H38]
- Hietanen, I., Heikkinen, I. T. S., Savin, H., & Pearce, J. M. (2018). Approaches to open source 3-D printable probe positioners and micromanipulators for probe stations. HardwareX. https://doi.org/10.1016/j.ohx.2018.e00042 — Validating printed positioners (phase 07) [H39]
- Salazar-Vazquez, J., & Mendez-Vazquez, A. (2020). A plug-and-play hyperspectral imaging sensor using low-cost equipment. HardwareX. https://doi.org/10.1016/j.ohx.2019.e00087 — Low-cost spectral imaging prior art (phase 10) [H40]
- Dhankania, K. C., & Pearce, J. M. (2016). Open source laboratory sample rotator mixer and shaker. HardwareX. http://www.sciencedirect.com/science/article/pii/S2468067216300049 — Printed rotary stage prior art (phase 05) [H41]
- Public Lab. (n.d.). Desktop spectrometry kit 3.0. https://publiclab.org/wiki/desktop-spectrometry-kit-3-0 — DIY spectral calibration (phase 10) [H42]

## Design tools and project publishing

- KiCad EDA. (n.d.). https://kicad.org/ — Power-box and hub schematics (phases 01, 02) [H43]
- GitHub Docs. (n.d.-b). REST API endpoints for milestones. https://docs.github.com/en/rest/issues/milestones — Phase milestones and issue scripts (phase 00) [H44]
- GitHub Docs. (n.d.-a). Configuring a publishing source for your GitHub pages site. https://docs.github.com/en/pages/getting-started-with-github-pages/configuring-a-publishing-source-for-your-github-pages-site — Documentation site deployment (phase 16) [H45]

## Software dependencies

- Python software foundation, Python language and standard library. (n.d.). https://www.python.org — Laptop app runtime (phase 14) [H46]
- Harris, C. R., Millman, K. J., Walt, S. J. van der, et al. (2020). Array programming with NumPy. Nature, 585, 357–362. https://doi.org/10.1038/s41586-020-2649-2 — Image arrays, HDR, geometry (phase 07) [H47]
- Virtanen, P., Gommers, R., Oliphant, T. E., et al. (2020). SciPy 1.0: Fundamental algorithms for scientific computing in Python. Nature Methods, 17, 261–272. https://doi.org/10.1038/s41592-019-0686-2 — BRDF least-squares fitting, rotations (phases 07, 08) [H48]
- Bradski, G. (2000). The OpenCV library. Dr. Dobb’s Journal of Software Tools. https://github.com/opencv/opencv/wiki/CiteOpenCV — Capture, calibration, ChArUco (phases 06, 11) [H49]
- PyYAML (YAML parser and emitter for Python). (n.d.). https://pyyaml.org/ — Config files and test suite (phase 14) [H50]

## Standalone station

- Raspberry Pi Zero 2 W. (n.d.). https://www.raspberrypi.com/products/raspberry-pi-zero-2-w/ — Standalone station (phase 15) [H51]
- Micropython-lib SSD1306 driver. (n.d.). https://github.com/micropython/micropython-lib/tree/master/micropython/drivers/display/ssd1306 — Panel OLED (phase 15) [H52]
- Raspberry Pi configuration, ’raspi-config‘ and UART. (n.d.). https://www.raspberrypi.com/documentation/computers/configuration.html — Pi UART to Pico (phase 15) [H53]
- Usbipd-win. (n.d.). https://github.com/dorssel/usbipd-win — USB boards into WSL (phase 02) [H54]
- MicroPython ’machine.UART‘. (n.d.). https://docs.micropython.org/en/latest/library/machine.UART.html — Pico ↔ Pi link (phase 15) [H55]
- CadQuery 2.x, parametric CAD in Python. (n.d.). https://pypi.org/project/cadquery/ — Generated STEP/STL parts (phase 00) [H56]
- Numpy-stl. (n.d.). https://pypi.org/project/numpy-stl/ — Parts gallery rendering (phase 00) [H57]
- Matplotlib. (n.d.). https://matplotlib.org/ — Parts gallery rendering (phase 00) [H58]
- Ams AS7341 11-channel spectral sensor; adafruit breakout #4698. (n.d.). https://www.adafruit.com/product/4698 — Spectral sensor (phase 10) [H59]
- W3C, portable network graphics (PNG) specification. (n.d.). https://www.w3.org/TR/png/ — Built-in PNG reader/writer in opengonio.imageio (phase 00) [H60]
