Normansrule/Gonioreflectometer-Open-Source/docs/og/img/moment-camera.png

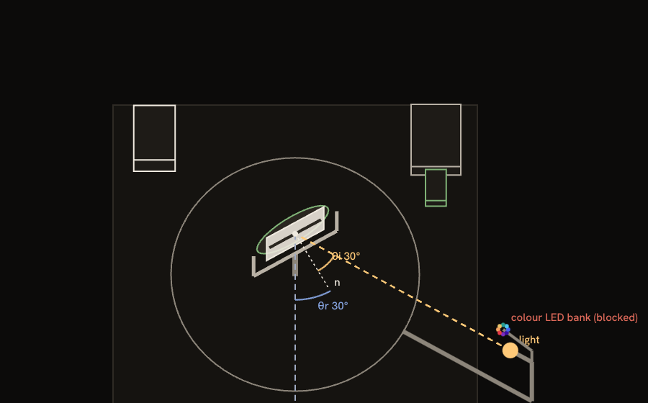
docs/og/img/moment-camera.png
