Normansrule/Gonioreflectometer-Open-Source/docs/og/img/moment-lamp.png

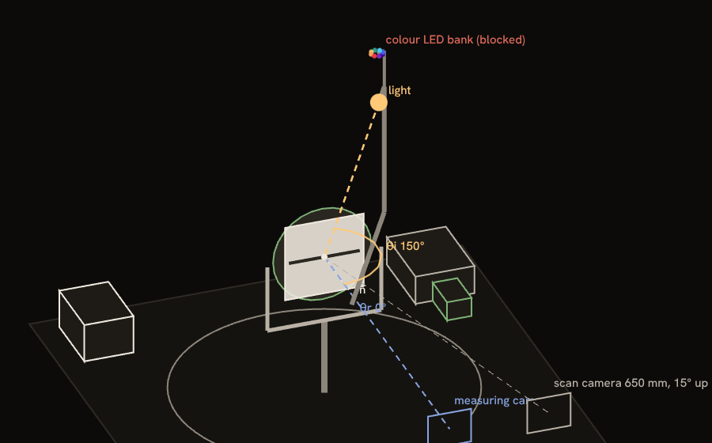
docs/og/img/moment-lamp.png
