Normansrule/Gonioreflectometer-Open-Source/docs/og/img/moment-lobe.png

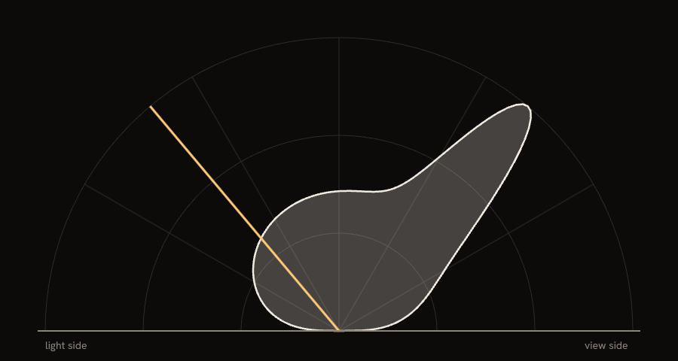
docs/og/img/moment-lobe.png
