Normansrule/Gonioreflectometer-Open-Source/docs/og/img/moment-spin.png

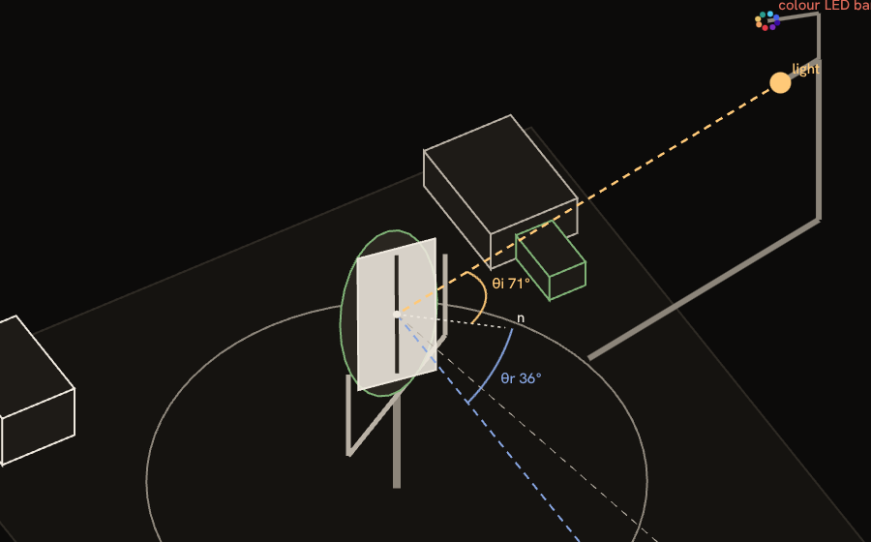
docs/og/img/moment-spin.png
