Normansrule/Gonioreflectometer-Open-Source/docs/og/img/moment-table.png

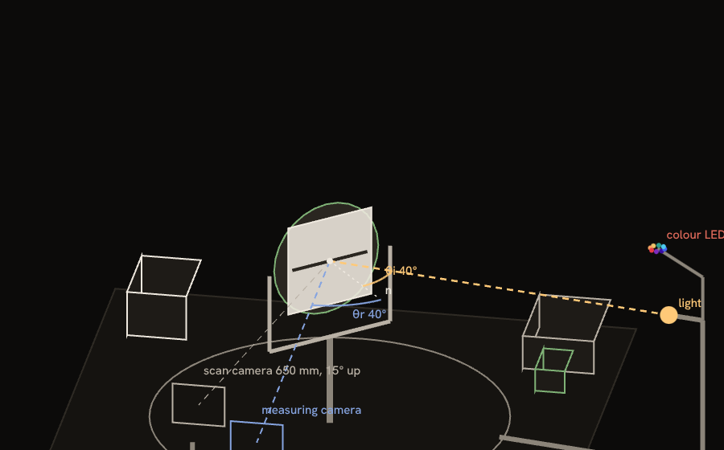
docs/og/img/moment-table.png
