Normansrule/Gonioreflectometer-Open-Source/docs/og/img/moment-tilt.png

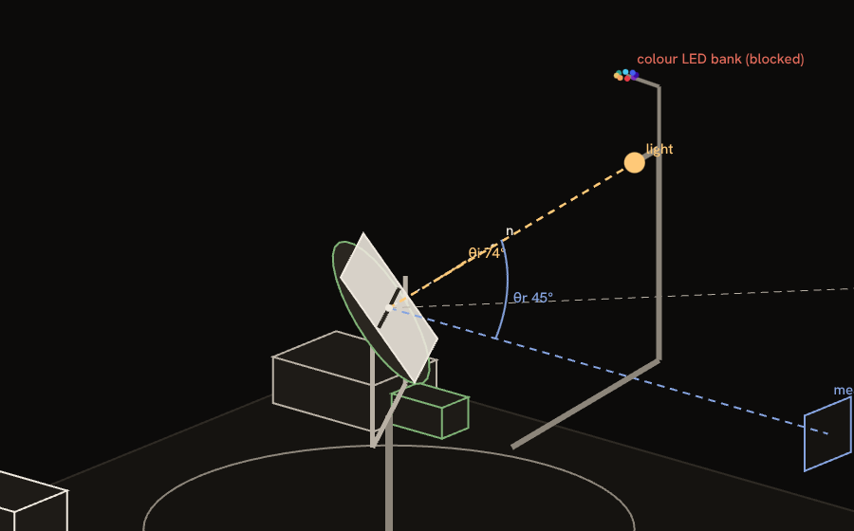
docs/og/img/moment-tilt.png
