Normansrule/Gonioreflectometer-Open-Source/docs/og/img/specimen.png

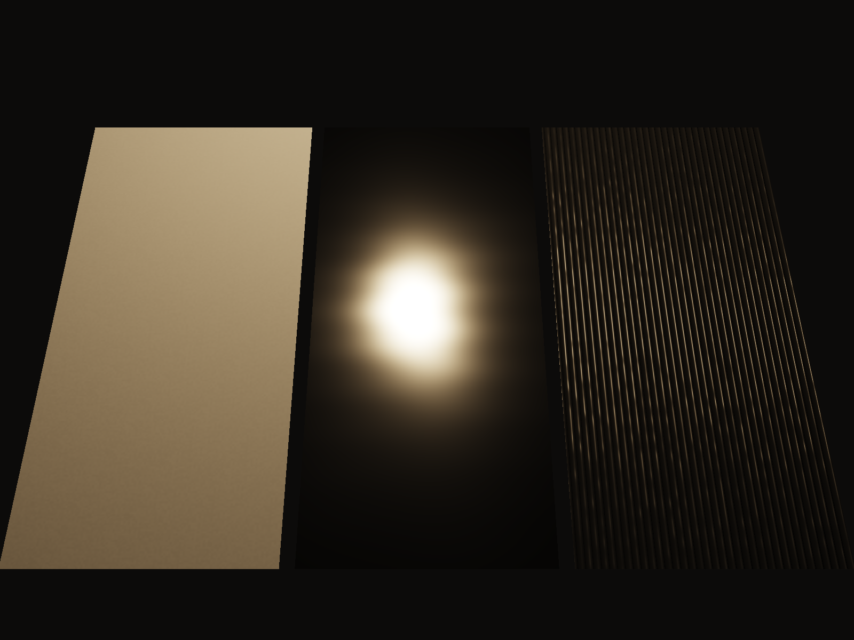
docs/og/img/specimen.png
