Normansrule/Gonioreflectometer-Open-Source/docs/og/img/stage-01.png

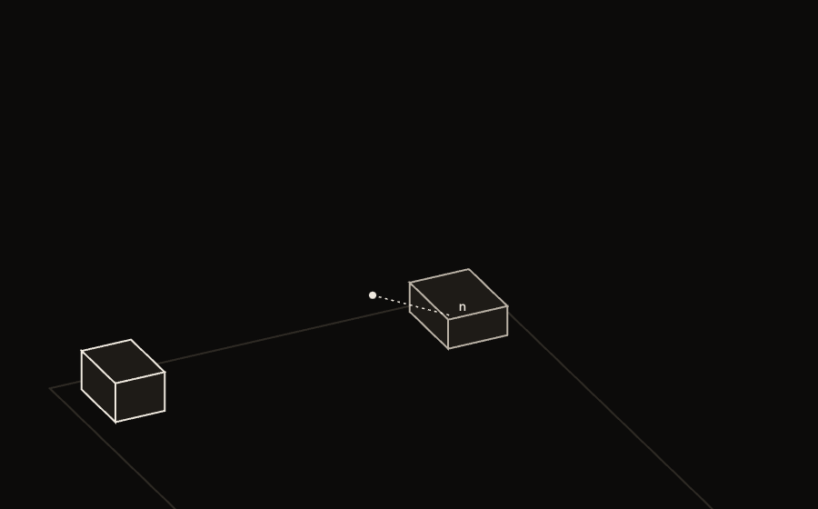
docs/og/img/stage-01.png
