Normansrule/Gonioreflectometer-Open-Source/docs/og/img/stage-03.png

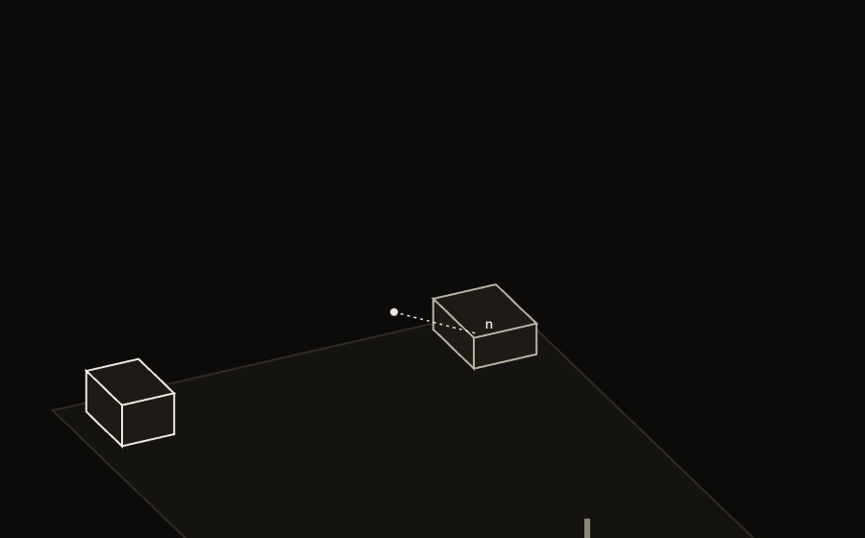
docs/og/img/stage-03.png
