Normansrule/Gonioreflectometer-Open-Source/docs/og/img/stage-04.png

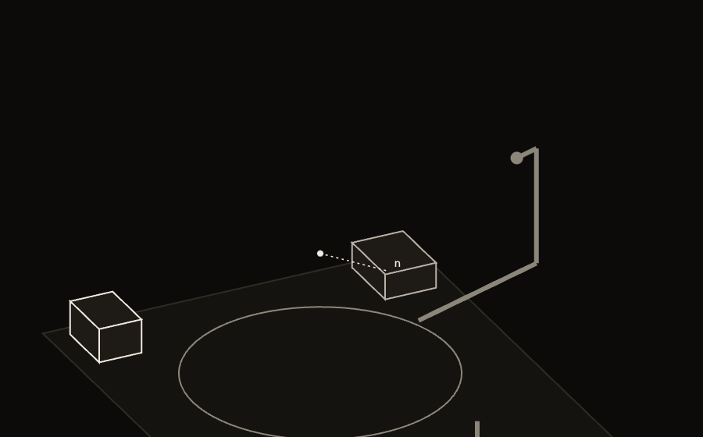
docs/og/img/stage-04.png
