Normansrule/Gonioreflectometer-Open-Source/docs/og/img/stage-05.png

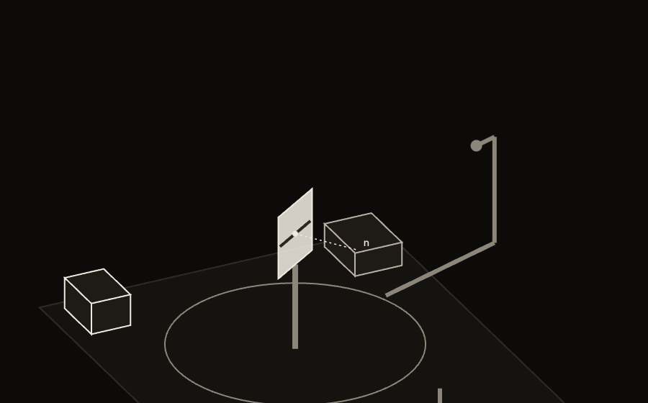
docs/og/img/stage-05.png
