Normansrule/Gonioreflectometer-Open-Source/docs/og/img/stage-10.png

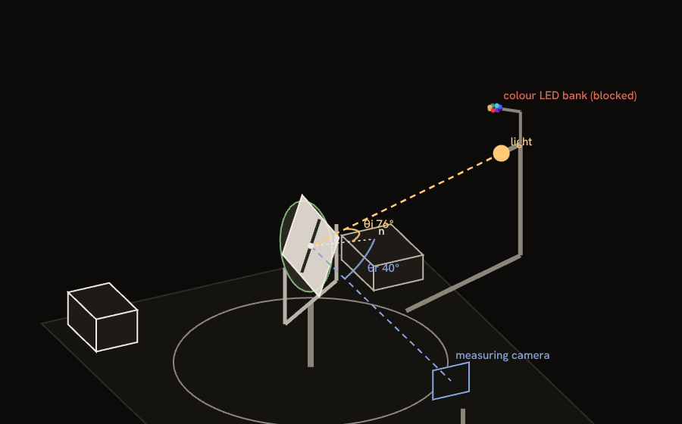
docs/og/img/stage-10.png
