Normansrule/Gonioreflectometer-Open-Source/exports/bom/opengonio-bom.xlsx

Sheet: Summary
Stage | Title | Parts USD | Optional USD | Tools USD
00-plan | Plan
01-power | Power
02-controller | Controller and buttons
03-frame | Frame
04-light-arm | Light arm (M4)
05-table | Table (M3)
06-camera-light | Camera and light
07-calibrate | Calibrate → game material
08-tilt | Tilt (M2)
09-spin | Spin (M1)
10-color | Colour add-ons (optional)
11-scan-capture | 3D scan: capture
15-standalone | Standalone (no laptop)
Total
Budget cap (parts) |  | $630.00
Under the cap?
Source of truth: phases/*/bom.csv (regenerated by make export). Edit decisions in PARTS.md, not here.

Sheet: Parts
Stage | ID | Type | Picture | Part | Use | Must meet | Qty | Unit USD | Total USD | Supplier | Buy | STEP | STL | Price checked | Status | Notes | Group
00-plan | TLS-01 | Tool |  | Enclosed FDM 3D printer for ABS (Elegoo Centauri 2) | Every printed part (ABS needs an enclosure: no warping, steady chamber heat) | Enclosed FDM printer, hot end ≥ 260 °C, heated bed ≥ 100 °C, build volume ≥ 220 × 220 × 200 mm (the tilt yoke is 175 mm tall) | 1 | $279.00 |  | Amazon | buy (https://www.amazon.com/dp/B0GZYZY956) |  |  | checked 2026-10-10 | suggested | Enclosed CoreXY, 350 °C nozzle, 256 mm cube. The Centauri Carbon listing (B0FDQP54X8) only had used units. Check the bed reaches 100 °C for ABS. | Tool
00-plan | TLS-02 | Tool |  | Screwdriver set (Phillips #1/#2 + flat 2–3 mm) | Terminal screws, lever connectors | Phillips #1/#2 (e-stop, switch), flat 2–3 mm (screw terminals) | 1 | $9.99 |  | Amazon | buy (https://www.amazon.com/dp/B07RFD9JWZ) |  |  | checked 2026-10-10 | suggested |  | Tool
00-plan | TLS-03 | Tool |  | Hex keys 1.5 / 2 / 2.5 / 3 / 4 mm | M2 socket screws (1.5 mm), M3 motor screws (2.5 mm), pulley grubs | Metric hex keys 1.5–4 mm (1.5 mm for every M2 screw; often in the FRM-06 kit) | 1 | $9.99 |  | Amazon | buy (https://www.amazon.com/dp/B0CJBRYQF3) |  |  | checked 2026-10-10 | suggested |  | Tool
00-plan | TLS-04 | Tool |  | Wire stripper / cutter 10–24 AWG | Strip 11 mm for lever connectors; cut jumpers and belt | Stripper for 10–24 AWG with a cutter (self-adjusting is easiest) | 1 | $10.49 |  | Amazon | buy (https://www.amazon.com/dp/B07TS6KCXD) |  |  | checked 2026-10-10 | suggested |  | Tool
00-plan | TLS-05 | Tool |  | Multimeter with temperature probe | Every electrical check (T1–T9) and the heat checks | Digital multimeter: DC V, Ω, continuity beep, diode; thermocouple probe (°C) | 1 | $34.99 |  | Amazon | buy (https://www.amazon.com/dp/B071JL6LLL) |  |  | checked 2026-10-10 | suggested | Check a K-type probe is in the box. | Tool
00-plan | TLS-06 | Tool |  | Digital calipers 150 mm | Print fit, tolerance coupon, positions | 150 mm (6 in) digital calipers, 0.01 mm display | 1 | $14.59 |  | Amazon | buy (https://www.amazon.com/dp/B0D2386QN9) |  |  | checked 2026-10-10 | suggested | Check 0.01 mm resolution on the listing. | Tool
00-plan | TLS-07 | Tool |  | Tape measure 3 m (metric) + phone level app | Camera distance, level checks | Metric tape ≥ 1 m; any phone level app (replaces a bubble level and set square) | 1 | $1.48 |  | Amazon | buy (https://www.amazon.com/dp/B0BRFTX359) |  |  | checked 2026-10-10 | suggested |  | Tool
00-plan | TLS-08 | Tool |  | Inkjet printer, US Letter, prints at 100 % | Placement template, ChArUco boards, focus grid | Prints Letter paper at 100 % (Actual size); any inkjet or laser | 1 | $49.99 |  | Amazon | buy (https://www.amazon.com/dp/B0GKJZ864R) |  |  | checked 2026-10-11 | suggested | Prints the placement template (4 tiles), ChArUco boards, focus grid and protractor. Print dialog: Actual size / 100 %; check the 100 mm bar. | Tool
00-plan | TLS-09 | Tool |  | CA glue, double-sided tape, utility knife, 400-grit sandpaper | Rim belt (M13.3), protractor scales (M12.3), labels; cut and sand the PTFE white tile (M16.3) | Cyanoacrylate (super) glue; double-sided foam or carpet tape; snap-off utility knife with spare blades; one sheet of 400-grit wet/dry paper | 1 | $29.28 |  | Amazon | buy (https://www.amazon.com/dp/B00I4CWHD4) |  |  | checked 2026-10-10 | suggested | Four listings: https://www.amazon.com/dp/B00I4CWHD4 , https://www.amazon.com/dp/B0D8PMVRKD , https://www.amazon.com/dp/B07PNG8ZSG , https://www.amazon.com/dp/B00004Z4BE | Tool
00-plan | TLS-10 | Tool |  | 13 mm spanner (or an adjustable wrench) | M8 nuts and bolt heads: table axle, tilt stub axles | 13 mm open/ring spanner or an adjustable wrench opening ≥ 13 mm | 1 | $7.00 |  | Amazon | buy (https://www.amazon.com/dp/B00Q01OBLC) |  |  | checked 2026-10-10 | suggested |  | Tool
00-plan | TLS-11 | Tool |  | Printer paper, Letter, 500 sheets | Template, ChArUco boards, focus grid | Plain matte white paper, 8.5 × 11 in | 1 | $6.97 |  | Amazon | buy (https://www.amazon.com/dp/B01FV0F8H8) |  |  | checked 2026-10-11 | suggested | For the TLS-08 printer. | Tool
00-plan | FIL-01 | Purchase |  | ABS filament 1.75 mm, black, 1 kg (4 spools) | All printed parts: core ≈ 2.7 kg with the printed deck (cad/PRINT.md) + reprints; black so nothing glints near the optics | ABS, 1.75 mm ± 0.03, black (matte if available), sealed with desiccant; ≥ 4 kg so a failed print never stops the build | 4 | $15.99 |  | Amazon | buy (https://www.amazon.com/dp/B0DDPSXDHG) |  |  | checked 2026-10-10 | suggested | Core prints ≈ 2.7 kg (cad/PRINT.md: the 9 deck tiles are half of it); the 4th spool covers reprints and kits. | Mechanical
01-power | PWR-30 | Purchase |  | 24 V 3 A wall adapter with screw-terminal DC jack | Power for the whole machine: plugs into the wall; its round plug goes into the screw-terminal jack | Regulated 24 V DC, ≥ 3 A (72 W), 5.5 × 2.1 mm plug, short-circuit and overload protection, with a female 5.5 × 2.1 mm jack to screw terminals (+ / − marked): no solder | 1 | $17.85 |  | Amazon | buy (https://www.amazon.com/dp/B078RY7BPL) | PWR-30_dc_jack_screw_terminal.step (https://github.com/Normansrule/Gonioreflectometer-Open-Source/blob/main/cad/bought/PWR-30_dc_jack_screw_terminal.step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) | PWR-30_dc_jack_screw_terminal.stl (https://github.com/Normansrule/Gonioreflectometer-Open-Source/blob/main/cad/bought/PWR-30_dc_jack_screw_terminal.stl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) | checked 2026-10-23 | suggested | Listing (read 2026-10-23): FCC / CE / RoHS (not a UL listing); short-circuit, overload and over-temperature protection; AC cable ~120 cm, DC cable ~110 cm. The adapter stays outside the machine; only the jack sits on the power plate. Replaces the battery, USB-C charging, fuse and their box. | Electronics
01-power | PWR-28 | Purchase |  | Emergency stop in its own box, latching, 1 NO + 1 NC, screw terminals | Cuts 24 V to the motor board (motors, lamp); also the off switch | Latching mushroom e-stop (push to stop, twist to release) already mounted in its own box: no panel hole; ≥ 1 normally-closed contact rated ≥ 3 A (DC rating where the listing gives one); screw terminals (no solder) | 1 | $8.99 |  | Amazon | buy (https://www.amazon.com/dp/B00NTT91Y0) | PWR-28_estop_station_1no1nc.step (https://github.com/Normansrule/Gonioreflectometer-Open-Source/blob/main/cad/bought/PWR-28_estop_station_1no1nc.step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) | PWR-28_estop_station_1no1nc.stl (https://github.com/Normansrule/Gonioreflectometer-Open-Source/blob/main/cad/bought/PWR-28_estop_station_1no1nc.stl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) | checked 2026-10-22 | suggested | Contacts rated 660 V / 10 A (AC). Wire the NC contact: terminals 1 and 2 on this switch, NO = 3 and 4 (confirm with the meter: 1–2 beep released, open pressed). Sits on the power plate on double-sided tape. | Electronics
01-power | PWR-10 | Purchase |  | Optocoupler module PC817, 24 V input, screw terminals (2-pack) | Isolated motion-power sense to the ESP32-S3 hub (resistor on the board) | 1-channel PC817 isolation module, 24 V input version (works from 18–24 V), 3.3–5 V output side, screw terminals: no breadboard, no solder | 1 | $6.99 |  | Amazon | buy (https://www.amazon.com/dp/B0B5382ZT7) | PWR-10_pc817_opto_module_24v.step (https://github.com/Normansrule/Gonioreflectometer-Open-Source/blob/main/cad/bought/PWR-10_pc817_opto_module_24v.step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) | PWR-10_pc817_opto_module_24v.stl (https://github.com/Normansrule/Gonioreflectometer-Open-Source/blob/main/cad/bought/PWR-10_pc817_opto_module_24v.stl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) | checked 2026-10-13 | suggested | 66 x 16.5 x 12 mm; sits in a locating frame on the controller tray (double-sided tape). Second module spare. | Electronics
01-power | PWR-15 | Purchase |  | 18 AWG silicone wire red/black, 1.5 m (5 ft) each colour | Power wiring | 18 AWG stranded silicone wire, red + black (≥ 5 A) | 1 | $7.98 |  | Amazon | buy (https://www.amazon.com/dp/B01708AYYQ) | PWR-15_wire_18awg_pair.step (https://github.com/Normansrule/Gonioreflectometer-Open-Source/blob/main/cad/bought/PWR-15_wire_18awg_pair.step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) | PWR-15_wire_18awg_pair.stl (https://github.com/Normansrule/Gonioreflectometer-Open-Source/blob/main/cad/bought/PWR-15_wire_18awg_pair.stl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) | checked 2026-10-10 | suggested |  | Electronics
01-power | PWR-20 | Purchase |  | Lever wire connectors, WAGO 221 assortment (12) | Every bare-wire join: no solder, no crimp, no heat-shrink | Lever splicing connectors for 24–12 AWG stranded and solid wire (fine-stranded down to 0.14 mm²), 2/3/5-way, ≥ 20 A (WAGO 221-412/413/415): ≥ 4 × 3-way, 6 × 2-way, 4 × 5-way, 3 × 221-2401 | 2 | $12.45 |  | Amazon | buy (https://www.amazon.com/dp/B0CJ5QF4Z2) | PWR-20_wago_221_assortment_12.step (https://github.com/Normansrule/Gonioreflectometer-Open-Source/blob/main/cad/bought/PWR-20_wago_221_assortment_12.step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) | PWR-20_wago_221_assortment_12.stl (https://github.com/Normansrule/Gonioreflectometer-Open-Source/blob/main/cad/bought/PWR-20_wago_221_assortment_12.stl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) | checked 2026-11-01 | suggested | Two packs: one is not enough since the lamp driver has wire leads. Uses (README → Wiring): MOT+, MOT− and keypad GND 221-413; M1 pancake splice 3 × 221-412 + 1 × 221-415 (motor leads ~26 AWG: only the 221-41x take fine-stranded 0.14 mm²); lamp: 2 on the tray (driver leads to jumper chains), 2 at the lamp, 1 capping the DIM lead (2-way or larger); all three 221-2401 at the limit switch (two splices into the red run + the unused wire's cap); hub add-ons: 3V3 rail 221-415 and sensor GND 221-413. The three tray 221-413s sit in pockets on the controller tray (CTL-10b). | Electronics
01-power | PWR-18 | Print |  | Power plate | Holds the screw-terminal jack and the e-stop box on the deck; OG-40 mount | ABS, 0.2 mm layers, 4 walls, 25–30 % infill, enclosed printer; settings and checks in this stage's checklist | 1 | $0.00 |  | Self-printed (black ABS) | n/a | PWR-18_power_plate.step (https://github.com/Normansrule/Gonioreflectometer-Open-Source/blob/main/phases/01-power/3d/PWR-18_power_plate.step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) | PWR-18_power_plate.stl (https://github.com/Normansrule/Gonioreflectometer-Open-Source/blob/main/phases/01-power/3d/PWR-18_power_plate.stl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) | n/a | suggested | Plate ABS weight: see cad/PRINT.md. The jack sits in a frame with its screw terminals toward the controller tray; the e-stop box sits in a 2 mm rim on double-sided tape (TLS-09). | Printed
02-controller | CTL-01 | Purchase |  | BIGTREETECH SKR Pico V1.0 (RP2040, 4 × TMC2209 UART, USB-C) | Motion controller running grblHAL; USB-C to the laptop | Board with 4 TMC2209 drivers on UART, USB-C, 12–24 V input, ≥ 4 endstop inputs, supported by grblHAL (BTT SKR Pico 1.0 board map) | 1 | $35.99 |  | Amazon | buy (https://www.amazon.com/dp/B09MYKL9MP) | CTL-01_btt_skr_pico_envelope.step (https://github.com/Normansrule/Gonioreflectometer-Open-Source/blob/main/cad/bought/CTL-01_btt_skr_pico_envelope.step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) | CTL-01_btt_skr_pico_envelope.stl (https://github.com/Normansrule/Gonioreflectometer-Open-Source/blob/main/cad/bought/CTL-01_btt_skr_pico_envelope.stl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) | checked 2026-10-14 | suggested | Sold by BIGTREETECH. 85 × 56 mm, 4 × Ø2.7 holes on 58 × 49 mm (maker STEP). Drivers: X = M4, Y = M3, Z1 = M2, E = M1; endstops X/Y/Z/E0-STOP (signal, GND, 5 V). grblHAL from the Web Builder (scripts/controller.sh flash). Fan advised above 0.8 A per motor (CTL-08). Replaces the FYSETC E4 (USB-B, 3 endstop inputs). | Electronics
02-controller | CTL-02 | Owned |  | ESP32-S3-DevKitC-1 (owned) | Buttons, PAUSE, e-stop sense, LED bank, OLED/AS7341 | ESP32-S3 dev board with pins soldered, USB-C, MicroPython (ESP32_GENERIC_S3) | 1 | $0.00 |  | owned | n/a |  |  | n/a | suggested | Already owned. Flash: bash scripts/hub.sh flash oct|plain (oct if the module can says N8R8 / N16R8). Plug its USB connector (not UART) into the laptop. | Owned
02-controller | CTL-03 | Purchase |  | USB-A to USB-C data cables, 3 ft (2-pack) | Laptop to SKR Pico and laptop to ESP32-S3 | USB-A (or USB-C) to USB-C data cable (not charge-only), ≤ 2 m; one per board | 1 | $8.99 |  | Amazon | buy (https://www.amazon.com/dp/B07DD5YHMH) | CTL-03_usb_cable_e4.step (https://github.com/Normansrule/Gonioreflectometer-Open-Source/blob/main/cad/bought/CTL-03_usb_cable_e4.step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) | CTL-03_usb_cable_e4.stl (https://github.com/Normansrule/Gonioreflectometer-Open-Source/blob/main/cad/bought/CTL-03_usb_cable_e4.stl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) | checked 2026-10-14 | suggested | 480 Mbps data. A laptop with only USB-C ports: use USB-C to USB-C data cables instead. | Electronics
02-controller | CTL-05 | Purchase |  | Membrane keypad 1 x 4 | HOME START STOP LIGHT (pad A); NEXT, PAUSE (pad B) | 1 × 4 membrane keypad, 70 × 20 mm, 5-wire tail (common + 4 keys) ending in a 2.54 mm Dupont connector, adhesive back (2 used) | 1 | $7.89 |  | Amazon | buy (https://www.amazon.com/dp/B076WS74VN) | CTL-05_membrane_keypad_1x4.step (https://github.com/Normansrule/Gonioreflectometer-Open-Source/blob/main/cad/bought/CTL-05_membrane_keypad_1x4.step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) | CTL-05_membrane_keypad_1x4.stl (https://github.com/Normansrule/Gonioreflectometer-Open-Source/blob/main/cad/bought/CTL-05_membrane_keypad_1x4.stl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) | checked 2026-10-14 | suggested | 3-pack: 2 used, 1 spare. Sticks onto the printed panel. Keys → ESP32-S3 GPIO 4, 5, 6, 7 / 15, 16 with male–female jumpers; both commons → one lever connector → GND (README → Wiring → 6). | Electronics
02-controller | CTL-06 | Purchase |  | JST-XH pre-crimped lead kit | Keyed connectors | JST-XH 2.54 mm leads crimped on BOTH ends, ≥ 50 cm, with 2- and 3-pin housings (an XH housing also plugs onto a 2.54 mm pin header) | 1 | $10.99 |  | Amazon | buy (https://www.amazon.com/dp/B0F8HMQRRN) | CTL-06_kicad_JST_XH_B3B_header.step (https://github.com/Normansrule/Gonioreflectometer-Open-Source/blob/main/cad/open/CTL-06_kicad_JST_XH_B3B_header.step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) |  | checked 2026-10-10 | suggested |  | Electronics
02-controller | CTL-07 | Purchase |  | Jumper wires male-female 20 cm (120) | Keypads, opto module and LED driver to the ESP32-S3 and SKR Pico; cut in half for pin-to-wire leads | Male–female 2.54 mm jumper wires, ≥ 150 mm, ≥ 30 | 1 | $6.98 |  | Amazon | buy (https://www.amazon.com/dp/B0BHNM91FX) | CTL-07_jumper_wire_mf.step (https://github.com/Normansrule/Gonioreflectometer-Open-Source/blob/main/cad/bought/CTL-07_jumper_wire_mf.step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) | CTL-07_jumper_wire_mf.stl (https://github.com/Normansrule/Gonioreflectometer-Open-Source/blob/main/cad/bought/CTL-07_jumper_wire_mf.stl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) | checked 2026-10-14 | suggested | Peel off strips of 40. Cut one in half = pin socket on one end, bare wire on the other. | Electronics
02-controller | CTL-08 | Optional |  | Fan 40 mm 24 V | Advised by BTT above 0.8 A per motor; fit it if C8 driver temperature fails | 40 mm fan, 24 V DC, 2-wire | 1 | $7.99 |  | Amazon | buy (https://www.amazon.com/dp/B09F9JT3BY) | CTL-08_fan_40mm.step (https://github.com/Normansrule/Gonioreflectometer-Open-Source/blob/main/cad/bought/CTL-08_fan_40mm.step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) | CTL-08_fan_40mm.stl (https://github.com/Normansrule/Gonioreflectometer-Open-Source/blob/main/cad/bought/CTL-08_fan_40mm.stl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) | checked 2026-10-10 | suggested | SKR Pico has FAN1–3 outputs (12/24 V, switched); this one runs from the motor supply. | Electronics
02-controller | CTL-09 | Owned |  | Laptop (Windows or Linux) | Control and processing | Laptop with a free USB port per camera; Windows 10+ (camera via Windows Python) or Linux | 1 | $0.00 |  | owned | n/a |  |  | n/a | suggested | The laptop you already run Ubuntu (WSL) on; the only thing assumed owned. | Owned
02-controller | CTL-11 | Optional |  | Stepper cables 1 m, PH2.0 6-pin to XH2.54 4-pin (4-pack) | Only if the motor cables in the 5-pack do not fit the SKR Pico XH sockets | 1 m, 4-wire, PH2.0 6-pin (motor end) to XH2.54 4-pin (board end) | 1 | $6.00 |  | Amazon | buy (https://www.amazon.com/dp/B099214RPZ) | CTL-11_kicad_JST_XH_B4B_header.step (https://github.com/Normansrule/Gonioreflectometer-Open-Source/blob/main/cad/open/CTL-11_kicad_JST_XH_B4B_header.step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) |  | checked 2026-10-10 | suggested | Only if the SIMAX 5-pack cables do not latch into the SKR Pico XH sockets: check on arrival before ordering. The listing names both an XH and a Dupont board end: check its photos. | Electronics
02-controller | CTL-10 | Print |  | Controller case + button panel | Holds the SKR Pico, ESP32-S3, opto module and LED driver; panel labels | ABS, 0.2 mm layers, 4 walls, 25–30 % infill, enclosed printer; settings and checks in this stage's checklist | 1 | $0.00 |  | Self-printed (black ABS) | n/a | CTL-10a_button_panel.step (https://github.com/Normansrule/Gonioreflectometer-Open-Source/blob/main/phases/02-controller/3d/CTL-10a_button_panel.step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) | CTL-10a_button_panel.stl (https://github.com/Normansrule/Gonioreflectometer-Open-Source/blob/main/phases/02-controller/3d/CTL-10a_button_panel.stl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) | n/a | suggested |  | Printed
03-frame | FRM-01 | Print |  | Deck: 9 tiles of 200 mm (600 x 600 x 24 mm) | Base for every part: replaces plywood | ABS, 0.2 mm layers, 4 walls, 25–30 % infill, enclosed printer; settings and checks in this stage's checklist | 1 | $0.00 |  | Self-printed (black ABS) | n/a | FRM-01a_deck_tile_SW.step (https://github.com/Normansrule/Gonioreflectometer-Open-Source/blob/main/phases/03-frame/3d/FRM-01a_deck_tile_SW.step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) | FRM-01a_deck_tile_SW.stl (https://github.com/Normansrule/Gonioreflectometer-Open-Source/blob/main/phases/03-frame/3d/FRM-01a_deck_tile_SW.stl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) | n/a | suggested | Bolted edge to edge with 36 x M2 x 10 + nuts (FRM-06). Pilot bosses at every mount point and a 40 mm grid of spare pilots: nothing to measure or mark. ≈ 1.4 kg ABS, ≈ 6 h per tile. | Printed
03-frame | FRM-02 | Print |  | Printed 20 x 20 bars: outrigger (2 x 250 mm), scan post (2 x 175 mm) | Outrigger and scan-camera post: replaces aluminium extrusion | ABS, 0.2 mm layers, 4 walls, 25–30 % infill, enclosed printer; settings and checks in this stage's checklist | 1 | $0.00 |  | Self-printed (black ABS) | n/a | FRM-02a_outrigger_bar_1.step (https://github.com/Normansrule/Gonioreflectometer-Open-Source/blob/main/phases/03-frame/3d/FRM-02a_outrigger_bar_1.step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) | FRM-02a_outrigger_bar_1.stl (https://github.com/Normansrule/Gonioreflectometer-Open-Source/blob/main/phases/03-frame/3d/FRM-02a_outrigger_bar_1.stl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) | n/a | suggested | M2 self-tap pilots at every clamp station; bar couplers (FRM-09i) join the halves. | Printed
03-frame | FRM-06 | Purchase |  | M2 socket screw kit, 4–25 mm, with nuts and washers (900 pcs) | Every printed join and module mount | M2-0.4 socket-head cap screws, stainless: ≥ 40 each of 8, 10, 12 mm and ≥ 20 of 16 mm, plus ≥ 100 nuts and washers; hex key 1.5 mm | 1 | $7.58 |  | Amazon | buy (https://www.amazon.com/dp/B0DCKCN2WM) | FRM-06_screws_m2_samples.step (https://github.com/Normansrule/Gonioreflectometer-Open-Source/blob/main/cad/bought/FRM-06_screws_m2_samples.step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) | FRM-06_screws_m2_samples.stl (https://github.com/Normansrule/Gonioreflectometer-Open-Source/blob/main/cad/bought/FRM-06_screws_m2_samples.stl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) | checked 2026-10-11 | suggested | 300 screws: 50 × 4/6/8, 40 × 10/12, 25 × 16/20, 20 × 25 mm. About 130 used. Self-tap into 1.7 mm printed pilots (set from the coupon). | Mechanical
03-frame | FRM-07 | Purchase |  | Socket screw kit M2/M3/M4 with nuts (820 pcs): M3 for the motors | M3 x 8 into three NEMA 17 faces, M3 x 16 through the tilt-yoke arm into the fourth (the motors' own thread); spare M2 | M3-0.5 × 8 mm (≥ 12) and × 16 mm (≥ 4) socket-head cap screws with washers; hex key 2.5 mm | 1 | $9.88 |  | Amazon | buy (https://www.amazon.com/dp/B0D636MJ1N) | FRM-07_screw_m3x8.step (https://github.com/Normansrule/Gonioreflectometer-Open-Source/blob/main/cad/bought/FRM-07_screw_m3x8.step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) | FRM-07_screw_m3x8.stl (https://github.com/Normansrule/Gonioreflectometer-Open-Source/blob/main/cad/bought/FRM-07_screw_m3x8.stl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) | checked 2026-10-11 | suggested | Only M3 left in the machine: motors are threaded M3. Covers TBL-06, TLT-06, SPN-06. | Mechanical
03-frame | FRM-08 | Purchase |  | 608-2RS bearings (10) | Table 2, tilt 2, spares 6 | 608-2RS ball bearings, 8 × 22 × 7 mm, sealed | 1 | $4.99 |  | Amazon | buy (https://www.amazon.com/dp/B0CX8CDL7D) | FRM-08_bearing_608_2rs.step (https://github.com/Normansrule/Gonioreflectometer-Open-Source/blob/main/cad/bought/FRM-08_bearing_608_2rs.step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) | FRM-08_bearing_608_2rs.stl (https://github.com/Normansrule/Gonioreflectometer-Open-Source/blob/main/cad/bought/FRM-08_bearing_608_2rs.stl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) | checked 2026-10-10 | suggested |  | Mechanical
03-frame | FRM-09 | Print |  | Ring scale clamps, bar saddles, scan-post socket, camera pillar, end foot, bar couplers | Printed frame parts | ABS, 0.2 mm layers, 4 walls, 25–30 % infill, enclosed printer; settings and checks in this stage's checklist | 1 | $0.00 |  | Self-printed (black ABS) | n/a | FRM-09c_protractor_segment.step (https://github.com/Normansrule/Gonioreflectometer-Open-Source/blob/main/phases/03-frame/3d/FRM-09c_protractor_segment.step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) | FRM-09c_protractor_segment.stl (https://github.com/Normansrule/Gonioreflectometer-Open-Source/blob/main/phases/03-frame/3d/FRM-09c_protractor_segment.stl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) | n/a | suggested | Everything screws into the deck's pilots with M2 (FRM-06). The ring-scale segments also clamp the lazy Susan [R1]. | Printed
04-light-arm | LAR-01 | Purchase |  | 12 in lazy Susan bearing | M4: light arm rotates around the sample | 12 in (≈ 305 mm) lazy-Susan ball bearing, flat, ≥ 50 kg rating, no wobble you can feel | 1 | $13.99 |  | Amazon | buy (https://www.amazon.com/dp/B0CQXFVDN7) | LAR-01_lazy_susan_12in.step (https://github.com/Normansrule/Gonioreflectometer-Open-Source/blob/main/cad/bought/LAR-01_lazy_susan_12in.step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) | LAR-01_lazy_susan_12in.stl (https://github.com/Normansrule/Gonioreflectometer-Open-Source/blob/main/cad/bought/LAR-01_lazy_susan_12in.stl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) | checked 2026-10-10 | suggested | Measure it before printing the rim (M13.1); the table motor needs an inner opening ≥ 150 mm. | Mechanical
04-light-arm | LAR-02 | Purchase |  | NEMA 17 stepper 42 Ncm 1.5 A, 38 mm (5-pack: M4, M3, M2 + 2 spare) | M4 drive | NEMA 17, 1.8°/step, bipolar 4-wire, ≥ 40 N·cm holding, ≤ 2.0 A/phase (driver runs 0.8 A), body ≤ 48 mm, 5 mm D-shaft | 1 | $32.99 |  | Amazon | buy (https://www.amazon.com/dp/B088B756MY) | LAR-02_nema17_17hs4401.step (https://github.com/Normansrule/Gonioreflectometer-Open-Source/blob/main/cad/bought/LAR-02_nema17_17hs4401.step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) | LAR-02_nema17_17hs4401.stl (https://github.com/Normansrule/Gonioreflectometer-Open-Source/blob/main/cad/bought/LAR-02_nema17_17hs4401.stl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) | checked 2026-10-14 | ordered | Bought. 5-pack covers LAR-02, TBL-01, TLT-01 and 2 spares. Its five 1 m cables (6-pin motor end, 4-pin XH board end in the photos): M4, M3, M2, one spliced to the M1 pancake (SPN-01), one spare. CAD clash check at 38 mm: 0 clashes on M4, M3, M2. Not for M1 (spin): that needs the 21.5 mm pancake (SPN-01). | Electronics
04-light-arm | LAR-03 | Purchase |  | GT2 6 mm open belt (5 m) | Teeth-out around the ring rim (~24:1) | GT2 (2 mm pitch) open belt, 6 mm wide, fibre-reinforced, ≥ 1 m per ring (2 m bought) | 1 | $7.59 |  | Amazon | buy (https://www.amazon.com/dp/B0BSMNZ53S) | LAR-03_gt2_belt_open_1m.step (https://github.com/Normansrule/Gonioreflectometer-Open-Source/blob/main/cad/bought/LAR-03_gt2_belt_open_1m.step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) | LAR-03_gt2_belt_open_1m.stl (https://github.com/Normansrule/Gonioreflectometer-Open-Source/blob/main/cad/bought/LAR-03_gt2_belt_open_1m.stl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) | checked 2026-10-10 | suggested |  | Mechanical
04-light-arm | LAR-04 | Purchase |  | GT2 20T pulley 5 mm bore (5-pack) | M4 motor pulley | GT2 (2 mm pitch) 20-tooth, 5 mm bore, for 6 mm belt, 2 set screws | 1 | $3.99 |  | Amazon | buy (https://www.amazon.com/dp/B0DJQC42DT) | LAR-04_adafruit_1253_gt2_20t_pulley_8mm_bore.step (https://github.com/Normansrule/Gonioreflectometer-Open-Source/blob/main/cad/open/LAR-04_adafruit_1253_gt2_20t_pulley_8mm_bore.step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) |  | checked 2026-10-10 | suggested | 5-pack covers LAR-04, TBL-03, TLT-03. | Mechanical
04-light-arm | LAR-05 | Purchase |  | Optical endstop module, slot type (6-pack) | M4 home | Slotted optical switch module (TCST2103, 3.1 mm slot), 3.3–5 V supply, digital output the controller endstop input reads | 1 | $8.99 |  | Amazon | buy (https://www.amazon.com/dp/B0719K9Z9R) | LAR-05_tcst2103_endstop_module.step (https://github.com/Normansrule/Gonioreflectometer-Open-Source/blob/main/cad/bought/LAR-05_tcst2103_endstop_module.step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) | LAR-05_tcst2103_endstop_module.stl (https://github.com/Normansrule/Gonioreflectometer-Open-Source/blob/main/cad/bought/LAR-05_tcst2103_endstop_module.stl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) | checked 2026-10-10 | suggested | Covers LAR-05, TBL-04, TLT-04, SPN-04. Check the slot is ≥ 3 mm (the flag is 1.5 mm). | Electronics
04-light-arm | LAR-06 | Purchase |  | Roller-lever limit switch, sealed, 3 wires attached (2-pack) | Over-travel switch in the motor-power line: cuts 24 V if the light arm runs past its range [R1] | Momentary roller-lever microswitch with COM / NC / NO wires already attached (no solder, no crimp), NC contact rated ≥ 3 A DC | 1 | $9.88 |  | Amazon | buy (https://www.amazon.com/dp/B09VGL29HS) | LAR-06_limit_switch_sealed_prewired.step (https://github.com/Normansrule/Gonioreflectometer-Open-Source/blob/main/cad/bought/LAR-06_limit_switch_sealed_prewired.step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) | LAR-06_limit_switch_sealed_prewired.stl (https://github.com/Normansrule/Gonioreflectometer-Open-Source/blob/main/cad/bought/LAR-06_limit_switch_sealed_prewired.stl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) | checked 2026-10-30 | suggested | Listing: 6 A at 12 V DC or 5 A at 250 V AC (no 24 V DC rating given). Wire colours on the units bought: black = COM, grey = NC, blue = NO (check yours with the meter: COM–NC beeps at rest, opens when the lever is pressed). Second switch spare. | Electronics
04-light-arm | LAR-08 | Print |  | Belt rim segments, arm segment, M4 motor mount, cross clamp, upright + arm bars | Printed M4 parts | ABS, 0.2 mm layers, 4 walls, 25–30 % infill, enclosed printer; settings and checks in this stage's checklist | 1 | $0.00 |  | Self-printed (black ABS) | n/a | LAR-08a_rim_segment.step (https://github.com/Normansrule/Gonioreflectometer-Open-Source/blob/main/phases/04-light-arm/3d/LAR-08a_rim_segment.step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) | LAR-08a_rim_segment.stl (https://github.com/Normansrule/Gonioreflectometer-Open-Source/blob/main/phases/04-light-arm/3d/LAR-08a_rim_segment.stl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) | n/a | suggested | 7 rim segments + the arm segment (8th, with the upright socket) bolt to the lazy-Susan top plate with M2 x 12 + wide printed washer + nut (FRM-06, TBL-07f) where a slot meets a plate hole, CA glue elsewhere; no idlers: the motor pinion meshes with the rim belt. Printed 200 mm upright and arm bars. | Printed
04-light-arm | LAR-09 | Tool |  | Laser module class 2 (650 nm, < 1 mW); mirror = one CAL-02 tile | Repeatability test: mirror on the moving part, spot on a wall 2 m away (0.1 deg = 7 mm) | Red laser pointer, class 2 (< 1 mW), plus a ~25 mm flat mirror | 1 | $15.99 |  | Amazon | buy (https://www.amazon.com/dp/B00ZR80S9S) |  |  | checked 2026-10-10 | suggested | Bare module, 2.6–6 V: run it from a spare 5 V and GND pin pair (SKR Pico RGB port: 5V pin 3, GND pin 1; README → Wiring → 8) with two jumper wires. Mirror: one CAL-02 tile. | Tool
05-table | TBL-01 | Purchase |  | NEMA 17 stepper 42 Ncm 1.5 A, 38 mm | M3 (table rotation, vertical axis) drive | NEMA 17, 1.8°/step, bipolar 4-wire, ≥ 40 N·cm holding, ≤ 2.0 A/phase (driver runs 0.8 A), body ≤ 48 mm, 5 mm D-shaft | 1 | $0.00 |  | Amazon | buy (https://www.amazon.com/dp/B088B756MY) | LAR-02_nema17_17hs4401.step (https://github.com/Normansrule/Gonioreflectometer-Open-Source/blob/main/cad/bought/LAR-02_nema17_17hs4401.step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) | LAR-02_nema17_17hs4401.stl (https://github.com/Normansrule/Gonioreflectometer-Open-Source/blob/main/cad/bought/LAR-02_nema17_17hs4401.stl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) | checked 2026-10-14 | ordered | In the LAR-02 5-pack. | Electronics
05-table | TBL-02 | Purchase |  | GT2 6 mm closed belt 232 mm | 20T to printed 100T, 5:1 | GT2 (2 mm pitch) closed loop, 6 mm wide, 232 mm (116 teeth): puts the motor 49.4 mm from the table axis, inside the lazy Susan opening | 1 | $8.19 |  | Amazon | buy (https://www.amazon.com/dp/B0FRFGBS6J) | TBL-02_gt2_belt_232_loop.step (https://github.com/Normansrule/Gonioreflectometer-Open-Source/blob/main/cad/bought/TBL-02_gt2_belt_232_loop.step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) | TBL-02_gt2_belt_232_loop.stl (https://github.com/Normansrule/Gonioreflectometer-Open-Source/blob/main/cad/bought/TBL-02_gt2_belt_232_loop.stl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) | checked 2026-10-10 | suggested |  | Mechanical
05-table | TBL-03 | Purchase |  | GT2 20T pulley 5 mm bore | Motor pulley | GT2 (2 mm pitch) 20-tooth, 5 mm bore, for 6 mm belt, 2 set screws | 1 | $0.00 |  | Amazon | buy (https://www.amazon.com/dp/B0DJQC42DT) | LAR-04_adafruit_1253_gt2_20t_pulley_8mm_bore.step (https://github.com/Normansrule/Gonioreflectometer-Open-Source/blob/main/cad/open/LAR-04_adafruit_1253_gt2_20t_pulley_8mm_bore.step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) |  | checked 2026-10-10 | suggested | In the LAR-04 5-pack. | Mechanical
05-table | TBL-04 | Purchase |  | Optical endstop module, slot type (from the LAR-05 6-pack) | Home | Slotted optical switch module (TCST2103, 3.1 mm slot), 3.3–5 V supply, digital output the controller endstop input reads | 1 | $0.00 |  | Amazon | buy (https://www.amazon.com/dp/B0719K9Z9R) | LAR-05_tcst2103_endstop_module.step (https://github.com/Normansrule/Gonioreflectometer-Open-Source/blob/main/cad/bought/LAR-05_tcst2103_endstop_module.step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) | LAR-05_tcst2103_endstop_module.stl (https://github.com/Normansrule/Gonioreflectometer-Open-Source/blob/main/cad/bought/LAR-05_tcst2103_endstop_module.stl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) | checked 2026-10-10 | suggested | In the LAR-05 6-pack. | Electronics
05-table | TBL-05 | Purchase |  | M8 x 75 hex bolt, partial thread + M8 nut (fixed table axle) | Fixed axle: head locked in the post, drum turns on two 608s around it | M8-1.25 × 75 mm hex bolt with ≥ 30 mm smooth shank (DIN 931, partial thread), grade 8.8, + M8 hex nut | 1 | $15.37 |  | Amazon | buy (https://www.amazon.com/dp/B0D83HW8ZM) | TBL-05_bolt_m8x75_nut.step (https://github.com/Normansrule/Gonioreflectometer-Open-Source/blob/main/cad/bought/TBL-05_bolt_m8x75_nut.step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) | TBL-05_bolt_m8x75_nut.stl (https://github.com/Normansrule/Gonioreflectometer-Open-Source/blob/main/cad/bought/TBL-05_bolt_m8x75_nut.stl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) | checked 2026-10-10 | suggested | Bolts $9.38 + nuts $5.99 (https://www.amazon.com/dp/B0CZQNB22Q); nuts also cover TLT-05. | Mechanical
05-table | TBL-06 | Purchase |  | Axis fasteners (M3 motor face + M2 set) | Motor face (M3), brackets, flags, clamps (M2) | 4 × M3 × 8 for the NEMA 17 face; M2 socket screws 6–16 mm with nuts and washers | 1 | $0.00 |  | Amazon | buy (https://www.amazon.com/dp/B0D636MJ1N) | FRM-07_screw_m3x8.step (https://github.com/Normansrule/Gonioreflectometer-Open-Source/blob/main/cad/bought/FRM-07_screw_m3x8.step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) | FRM-07_screw_m3x8.stl (https://github.com/Normansrule/Gonioreflectometer-Open-Source/blob/main/cad/bought/FRM-07_screw_m3x8.stl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) | checked 2026-10-11 | suggested | From the FRM-06 and FRM-07 kits. | Mechanical
05-table | TBL-07 | Print |  | Printed table parts | Post, drum (100T teeth + 608 seats + OG-40 top), motor bracket, flags, spacers, endstop riser | ABS, 0.2 mm layers, 4 walls, 25–30 % infill, enclosed printer; settings and checks in this stage's checklist | 1 | $0.00 |  | Self-printed (black ABS) | n/a | TBL-07a_table_drum.step (https://github.com/Normansrule/Gonioreflectometer-Open-Source/blob/main/phases/05-table/3d/TBL-07a_table_drum.step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) | TBL-07a_table_drum.stl (https://github.com/Normansrule/Gonioreflectometer-Open-Source/blob/main/phases/05-table/3d/TBL-07a_table_drum.stl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) | n/a | suggested |  | Printed
06-camera-light | CAM-01 | Purchase |  | USB camera 12 MP IMX477, M12 mount (UVC) | Fixed measurement camera on the laptop | USB Video Class (UVC) camera, Sony IMX477 12.3 MP, 1.55 µm pixels, M12 × 0.5 lens mount, manual exposure / gain / white balance, ≥ 3840 × 3032 output, IR-cut filter for true colour | 1 | $59.99 |  | Amazon | buy (https://www.amazon.com/dp/B0C1G73QZD) | CAM-01_arducam_b0433_imx477_usb.step (https://github.com/Normansrule/Gonioreflectometer-Open-Source/blob/main/cad/bought/CAM-01_arducam_b0433_imx477_usb.step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) | CAM-01_arducam_b0433_imx477_usb.stl (https://github.com/Normansrule/Gonioreflectometer-Open-Source/blob/main/cad/bought/CAM-01_arducam_b0433_imx477_usb.stl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) | checked 2026-10-10 | suggested | Arducam's B0433-family 12 MP USB board. | Electronics
06-camera-light | CAM-02 | Purchase |  | M12 lens 16 mm, ≥ 1/2 in format, low distortion | Lens | M12 × 0.5 lens, focal length 16 mm (±0.5) → 124 × 98 mm field and 32 µm per pixel at 350 mm, 236 × 186 mm at 650 mm; covers a ≥ 1/2.3 in sensor; F2.0 or slower (used at f/8 via the 2.0 mm stop: 22.6 mm depth of field at 350 mm, 117 mm at 650 mm); distortion < 1 % | 1 | $30.11 |  | Amazon | buy (https://www.amazon.com/dp/B0HJWVFD7R) | CAM-02_m12_lens_16mm.step (https://github.com/Normansrule/Gonioreflectometer-Open-Source/blob/main/cad/bought/CAM-02_m12_lens_16mm.step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) | CAM-02_m12_lens_16mm.stl (https://github.com/Normansrule/Gonioreflectometer-Open-Source/blob/main/cad/bought/CAM-02_m12_lens_16mm.stl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) | checked 2026-10-10 | suggested |  | Mechanical
06-camera-light | LSR-06 | Purchase |  | Solderless COB holder 13.5 mm (TE LUMAWISE Z35) | Holds and connects the COB without solder | Solderless holder for a 13.5 × 13.5 mm COB (Citizen CLU700 / CLU701), poke-in terminals for 18–20 AWG wire, rated ≥ 0.5 A and ≥ 24 V | 1 | $3.30 |  | Digi-Key | buy (https://www.digikey.com/en/products/detail/te-connectivity-amp-connectors/2213678-5/6174915) | LSR-06_te_lumawise_z35_2213678_5.step (https://github.com/Normansrule/Gonioreflectometer-Open-Source/blob/main/cad/bought/LSR-06_te_lumawise_z35_2213678_5.step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) | LSR-06_te_lumawise_z35_2213678_5.stl (https://github.com/Normansrule/Gonioreflectometer-Open-Source/blob/main/cad/bought/LSR-06_te_lumawise_z35_2213678_5.stl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) | checked 2026-11-11 | ordered | Ordered 2 (1 spare). Ø35 × 3.6 mm, 3 A / 60 V DC, poke-in for 18–20 AWG solid or stranded [L23]; listed for the CLU701 [L26]. No screws: the lamp body's round seat centres it and the cap clamps heatsink + holder. Leads: 2 × PWR-15 18 AWG from the lamp lever connector. | Electronics
06-camera-light | CAM-03 | Print |  | Camera L-arm, aperture stop (f/8), lens lock | Fixed, adjustable camera mount | Aperture stop hole = focal length / 8 = 2.0 mm (f/8); matte black ABS so it can't glint | 1 | $0.00 |  | Self-printed (black ABS) | n/a | CAM-03a_aperture_stop_f8.step (https://github.com/Normansrule/Gonioreflectometer-Open-Source/blob/main/phases/06-camera-light/3d/CAM-03a_aperture_stop_f8.step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) | CAM-03a_aperture_stop_f8.stl (https://github.com/Normansrule/Gonioreflectometer-Open-Source/blob/main/phases/06-camera-light/3d/CAM-03a_aperture_stop_f8.stl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) | n/a | suggested | Stop = f/N = 2.0 mm. | Printed
06-camera-light | LSR-01 | Purchase |  | COB LED CRI 90, 9 V, 13.5 mm (Citizen CLU701) | White measurement light | White chip-on-board LED, Colour Rendering Index (CRI) ≥ 90, 2700–5000 K, forward voltage ≤ 18 V at 350 mA (the driver steps down 4 V from 24 V), rated ≥ 350 mA, 13.5 × 13.5 mm board listed for LSR-06 in TE 114-32208 | 1 | $4.60 |  | Digi-Key | buy (https://www.digikey.com/en/products/detail/citizen/CLU701-0303C4-273H5K2/5820601) | LSR-01_citizen_clu701_cob.step (https://github.com/Normansrule/Gonioreflectometer-Open-Source/blob/main/cad/bought/LSR-01_citizen_clu701_cob.step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) | LSR-01_citizen_clu701_cob.stl (https://github.com/Normansrule/Gonioreflectometer-Open-Source/blob/main/cad/bought/LSR-01_citizen_clu701_cob.stl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) | checked 2026-11-11 | ordered | Ordered 2 (1 spare). Datasheet: Vf 8.6 / 9.4 / 10.2 V at 525 mA, max 690 mA, Tc ≤ 105 °C, Rj-c 3.5 °C/W; ≈ 3.2 W at 350 mA. TE 114-32208 lists the CLU701 for the Z35 2213678-5 [L26]. The square board sits in the holder's square seat; the round part is the holder. | Electronics
06-camera-light | LSR-02 | Purchase |  | Constant-current driver 350 mA, wire leads (MEAN WELL NLDD-350HW) | Drives the COB from 24 V; on/off from the SKR Pico HE (heater) MOSFET output | Constant-current LED driver 350 mA, input range covering 24 V, output covering the LED's ≈ 9 V, no flicker (DC output); wire leads that go under screw terminals or into lever connectors (no breadboard, no solder) | 1 | $7.20 |  | Digi-Key | buy (https://www.digikey.com/en/products/detail/mean-well-usa-inc/NLDD-350HW/13913611) | LSR-02_meanwell_nldd_350hw.step (https://github.com/Normansrule/Gonioreflectometer-Open-Source/blob/main/cad/bought/LSR-02_meanwell_nldd_350hw.step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) | LSR-02_meanwell_nldd_350hw.stl (https://github.com/Normansrule/Gonioreflectometer-Open-Source/blob/main/cad/bought/LSR-02_meanwell_nldd_350hw.stl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) | checked 2026-11-11 | ordered | Ordered. 32.1 × 20.5 × 12.5 mm, input 10–56 V, output 4 V under the input, DIM open = on [L27]. Taped into its frame on the controller tray. Input leads straight under the SKR Pico HE screws; output leads into lever connectors; DIM lead alone in a lever connector. Match lead colours to functions from the label on the driver. | Electronics
06-camera-light | LSR-03 | Purchase |  | Heatsink 40 x 40 x 11.6 mm, pin fin (Wakefield 910) | COB cooling | Aluminium heatsink 40 × 40 mm footprint, 11–12 mm tall, ≤ 10 °C/W in still air (keeps the LED case ≤ 70 °C at ≈ 2.5 W of heat) | 1 | $10.67 |  | Digi-Key | buy (https://www.digikey.com/en/products/detail/wakefield-thermal-solutions/910-40-2-12-2-B-0/4815166) | LSR-03_wakefield_910_40_2_12_2_b0.step (https://github.com/Normansrule/Gonioreflectometer-Open-Source/blob/main/cad/bought/LSR-03_wakefield_910_40_2_12_2_b0.step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) | LSR-03_wakefield_910_40_2_12_2_b0.stl (https://github.com/Normansrule/Gonioreflectometer-Open-Source/blob/main/cad/bought/LSR-03_wakefield_910_40_2_12_2_b0.stl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) | estimate | ordered | Ordered. Digi-Key price not in your cart message: [TBD] on the store page; 10.67 is Mouser's qty-1 price via Octopart (2026-11-12). Sold for clip mounting with no tape: needs LSR-04. | Mechanical
06-camera-light | LSR-04 | Purchase |  | Thermal adhesive tape 3M 8810, 19 mm | COB to heatsink | Thermally conductive, electrically insulating adhesive tape or pad, ≥ 20 mm wide | 1 | $0.00 |  | Digi-Key | buy (https://www.digikey.com/en/products/detail/3m-tc/8810-0-75-5/2649863) | LSR-04_thermal_pad_40x40.step (https://github.com/Normansrule/Gonioreflectometer-Open-Source/blob/main/cad/bought/LSR-04_thermal_pad_40x40.step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) | LSR-04_thermal_pad_40x40.stl (https://github.com/Normansrule/Gonioreflectometer-Open-Source/blob/main/cad/bought/LSR-04_thermal_pad_40x40.stl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) | estimate | suggested | Not ordered yet: the Wakefield heatsink comes without tape. Two 19 mm strips side by side cover the 13.5 mm board. Price [TBD]: check the store page and set it here. | Mechanical
06-camera-light | LSR-05 | Print |  | Lamp body + tube, back cap | Holds heatsink + COB holder, 10 mm exit aperture, polarizer slot, clamps to the printed arm bar (M2 into its pilot) | ABS, 0.2 mm layers, 4 walls, 25–30 % infill, enclosed printer; settings and checks in this stage's checklist | 1 | $0.00 |  | Self-printed (black ABS) | n/a | LSR-05a_lamp_tube.step (https://github.com/Normansrule/Gonioreflectometer-Open-Source/blob/main/phases/06-camera-light/3d/LSR-05a_lamp_tube.step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) | LSR-05a_lamp_tube.stl (https://github.com/Normansrule/Gonioreflectometer-Open-Source/blob/main/phases/06-camera-light/3d/LSR-05a_lamp_tube.stl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) | n/a | suggested |  | Printed
07-calibrate | ENC-01 | Optional |  | Blackout fabric, black (2 units) | Light-tight drape | Opaque blackout fabric, ≥ 2 yd × 54 in | 2 | $7.90 |  | Amazon | buy (https://www.amazon.com/dp/B00MQADTVY) | ENC-01_blackout_fabric_2yd.step (https://github.com/Normansrule/Gonioreflectometer-Open-Source/blob/main/cad/bought/ENC-01_blackout_fabric_2yd.step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) | ENC-01_blackout_fabric_2yd.stl (https://github.com/Normansrule/Gonioreflectometer-Open-Source/blob/main/cad/bought/ENC-01_blackout_fabric_2yd.stl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) | checked 2026-10-10 | suggested | Check the listing unit (per yard). | Mechanical
07-calibrate | ENC-02 | Purchase |  | Black felt sheet | Backdrop behind the sample | Matte black felt, ≥ 9 × 12 in | 1 | $6.99 |  | Amazon | buy (https://www.amazon.com/dp/B0FXKGNV95) | ENC-02_felt_9x12in.step (https://github.com/Normansrule/Gonioreflectometer-Open-Source/blob/main/cad/bought/ENC-02_felt_9x12in.step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) | ENC-02_felt_9x12in.stl (https://github.com/Normansrule/Gonioreflectometer-Open-Source/blob/main/cad/bought/ENC-02_felt_9x12in.stl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) | checked 2026-10-10 | suggested |  | Mechanical
07-calibrate | ENC-03 | Optional |  | Dowels 1/2 x 36 in (10) | Drape frame posts | ½ in (12.7 mm) hardwood dowels (poplar is fine), 36 in, straight | 1 | $19.99 |  | Amazon | buy (https://www.amazon.com/dp/B0BVGCCMZ9) | ENC-03_dowel_half_in_36in.step (https://github.com/Normansrule/Gonioreflectometer-Open-Source/blob/main/cad/bought/ENC-03_dowel_half_in_36in.step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) | ENC-03_dowel_half_in_36in.stl (https://github.com/Normansrule/Gonioreflectometer-Open-Source/blob/main/cad/bought/ENC-03_dowel_half_in_36in.stl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) | checked 2026-10-10 | suggested | Bamboo; 4 used. | Mechanical
07-calibrate | ENC-04 | Print |  | Dowel sockets, drape clips | Enclosure hardware | ABS, 0.2 mm layers, 4 walls, 25–30 % infill, enclosed printer; settings and checks in this stage's checklist | 1 | $0.00 |  | Self-printed (black ABS) | n/a | ENC-04a_dowel_socket.step (https://github.com/Normansrule/Gonioreflectometer-Open-Source/blob/main/phases/07-calibrate/3d/ENC-04a_dowel_socket.step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) | ENC-04a_dowel_socket.stl (https://github.com/Normansrule/Gonioreflectometer-Open-Source/blob/main/phases/07-calibrate/3d/ENC-04a_dowel_socket.stl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) | n/a | suggested |  | Printed
07-calibrate | CAL-01 | Purchase |  | PTFE sheets 100 x 100 x 3 mm (2): white tile = 3 stacked 50 mm squares | Near-Lambertian white reference | Virgin white PTFE; 3 stacked 3 mm squares = 9 mm (opaque, like a 3/8 in plate), ≥ 50 × 50 mm face; top sanded with 400 grit for a diffuse surface (reflectance ≈ 0.98–0.99) | 1 | $16.99 |  | Amazon | buy (https://www.amazon.com/dp/B0F83XRXTV) | CAL-01_ptfe_tile_50mm_3x3mm.step (https://github.com/Normansrule/Gonioreflectometer-Open-Source/blob/main/cad/bought/CAL-01_ptfe_tile_50mm_3x3mm.step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) | CAL-01_ptfe_tile_50mm_3x3mm.stl (https://github.com/Normansrule/Gonioreflectometer-Open-Source/blob/main/cad/bought/CAL-01_ptfe_tile_50mm_3x3mm.stl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) | checked 2026-10-10 | suggested | Cut one sheet into four 50 mm squares (knife); stack 3 in the holder. | Mechanical
07-calibrate | CAL-02 | Purchase |  | Glass mirror tile ~50 mm | Geometric calibration (specular peak) | Flat glass mirror ≈ 50 mm; front-surface preferred (no ghost reflection) | 1 | $11.49 |  | Amazon | buy (https://www.amazon.com/dp/B01H0ZU1QA) | CAL-02_mirror_tile_50mm.step (https://github.com/Normansrule/Gonioreflectometer-Open-Source/blob/main/cad/bought/CAL-02_mirror_tile_50mm.step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) | CAL-02_mirror_tile_50mm.stl (https://github.com/Normansrule/Gonioreflectometer-Open-Source/blob/main/cad/bought/CAL-02_mirror_tile_50mm.stl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) | checked 2026-10-10 | suggested |  | Mechanical
07-calibrate | CAL-03 | Optional |  | Chrome steel ball 1 in G25 (2) | Optional check of light directions (photometric stereo); light direction already comes from M4 and the mirror test | Two 1 in chrome-steel balls, grade 25 or better (polished) | 1 | $9.95 |  | Amazon | buy (https://www.amazon.com/dp/B01AX6ZRH6) | CAL-03_chrome_ball_1in.step (https://github.com/Normansrule/Gonioreflectometer-Open-Source/blob/main/cad/bought/CAL-03_chrome_ball_1in.step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) | CAL-03_chrome_ball_1in.stl (https://github.com/Normansrule/Gonioreflectometer-Open-Source/blob/main/cad/bought/CAL-03_chrome_ball_1in.stl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) | checked 2026-10-10 | suggested |  | Mechanical
07-calibrate | CAL-04 | Purchase |  | ChArUco print + picture-frame glass | Intrinsics, pose, repeatability | ChArUco board 7 × 5, 10 mm squares, 7 mm markers (DICT_4X4_50), printed at 100 % on matte paper, held flat under glass | 1 | $4.31 |  | Amazon | buy (https://www.amazon.com/dp/B000Y79K32) | CAL-04_charuco_glass_4x6in.step (https://github.com/Normansrule/Gonioreflectometer-Open-Source/blob/main/cad/bought/CAL-04_charuco_glass_4x6in.step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) | CAL-04_charuco_glass_4x6in.stl (https://github.com/Normansrule/Gonioreflectometer-Open-Source/blob/main/cad/bought/CAL-04_charuco_glass_4x6in.stl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) | checked 2026-10-10 | suggested | Check it has real glass (the board must be flat). Print the ChArUco board on the TLS-08 printer. | Mechanical
07-calibrate | CAL-05 | Optional |  | Colour target (ColorChecker Mini or similar) | Colour validation, as in [R1] | 24-patch colour checker with published reference values | 1 | $55.50 |  | Amazon | buy (https://www.amazon.com/dp/B0973JNJCB) | CAL-05_colorchecker_mini.step (https://github.com/Normansrule/Gonioreflectometer-Open-Source/blob/main/cad/bought/CAL-05_colorchecker_mini.step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) | CAL-05_colorchecker_mini.stl (https://github.com/Normansrule/Gonioreflectometer-Open-Source/blob/main/cad/bought/CAL-05_colorchecker_mini.stl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) | checked 2026-10-10 | suggested |  | Mechanical
07-calibrate | CAL-06 | Print |  | Kinematic holders for mirror, PTFE, balls | Fixtures on the stage | ABS, 0.2 mm layers, 4 walls, 25–30 % infill, enclosed printer; settings and checks in this stage's checklist | 1 | $0.00 |  | Self-printed (black ABS) | n/a | CAL-06a_ptfe_holder.step (https://github.com/Normansrule/Gonioreflectometer-Open-Source/blob/main/phases/07-calibrate/3d/CAL-06a_ptfe_holder.step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) | CAL-06a_ptfe_holder.stl (https://github.com/Normansrule/Gonioreflectometer-Open-Source/blob/main/phases/07-calibrate/3d/CAL-06a_ptfe_holder.stl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) | n/a | suggested |  | Printed
07-calibrate | ENC-05 | Optional |  | Flocked light-trap sheet, self-adhesive | Line the backdrop and the lamp tube: kills stray reflections | Flocked light-trap material, self-adhesive, absorbs > 99 % | 1 | $12.73 |  | Amazon | buy (https://www.amazon.com/dp/B0FJRWTXXF) | ENC-05_flock_sheet.step (https://github.com/Normansrule/Gonioreflectometer-Open-Source/blob/main/cad/bought/ENC-05_flock_sheet.step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) | ENC-05_flock_sheet.stl (https://github.com/Normansrule/Gonioreflectometer-Open-Source/blob/main/cad/bought/ENC-05_flock_sheet.stl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) | checked 2026-10-10 | suggested |  | Mechanical
07-calibrate | CAL-07 | Optional |  | 18 % grey card + white card set (8 x 10 in) | Lock exposure and white balance (M17.5); warm-up target (M18.3) | 18 % neutral grey card, matte, ≥ 4 × 5 in | 1 | $11.99 |  | Amazon | buy (https://www.amazon.com/dp/B00CJ59AKK) | CAL-07_grey_card_8x10in.step (https://github.com/Normansrule/Gonioreflectometer-Open-Source/blob/main/cad/bought/CAL-07_grey_card_8x10in.step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) | CAL-07_grey_card_8x10in.stl (https://github.com/Normansrule/Gonioreflectometer-Open-Source/blob/main/cad/bought/CAL-07_grey_card_8x10in.stl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) | checked 2026-10-10 | suggested |  | Mechanical
08-tilt | TLT-01 | Purchase |  | NEMA 17 stepper 42 Ncm 1.5 A, 38 mm | M2 (sample tilt, horizontal axis) drive | NEMA 17, 1.8°/step, bipolar 4-wire, ≥ 40 N·cm holding, ≤ 2.0 A/phase (driver runs 0.8 A), body ≤ 48 mm, 5 mm D-shaft | 1 | $0.00 |  | Amazon | buy (https://www.amazon.com/dp/B088B756MY) | LAR-02_nema17_17hs4401.step (https://github.com/Normansrule/Gonioreflectometer-Open-Source/blob/main/cad/bought/LAR-02_nema17_17hs4401.step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) | LAR-02_nema17_17hs4401.stl (https://github.com/Normansrule/Gonioreflectometer-Open-Source/blob/main/cad/bought/LAR-02_nema17_17hs4401.stl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) | checked 2026-10-14 | ordered | In the LAR-02 5-pack. | Electronics
08-tilt | TLT-02 | Purchase |  | GT2 6 mm closed belt 280 mm | 20T to printed 100T, 5:1 | GT2 6 mm closed loop, 280 mm | 1 | $7.49 |  | Amazon | buy (https://www.amazon.com/dp/B07RK1TX8C) | TLT-02_gt2_belt_280_loop.step (https://github.com/Normansrule/Gonioreflectometer-Open-Source/blob/main/cad/bought/TLT-02_gt2_belt_280_loop.step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) | TLT-02_gt2_belt_280_loop.stl (https://github.com/Normansrule/Gonioreflectometer-Open-Source/blob/main/cad/bought/TLT-02_gt2_belt_280_loop.stl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) | checked 2026-10-10 | suggested |  | Mechanical
08-tilt | TLT-03 | Purchase |  | GT2 20T pulley 5 mm bore | Motor pulley | GT2 (2 mm pitch) 20-tooth, 5 mm bore, for 6 mm belt, 2 set screws | 1 | $0.00 |  | Amazon | buy (https://www.amazon.com/dp/B0DJQC42DT) | LAR-04_adafruit_1253_gt2_20t_pulley_8mm_bore.step (https://github.com/Normansrule/Gonioreflectometer-Open-Source/blob/main/cad/open/LAR-04_adafruit_1253_gt2_20t_pulley_8mm_bore.step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) |  | checked 2026-10-10 | suggested | In the LAR-04 5-pack. | Mechanical
08-tilt | TLT-04 | Purchase |  | Optical endstop module, slot type (from the LAR-05 6-pack) | Home | Slotted optical switch module (TCST2103, 3.1 mm slot), 3.3–5 V supply, digital output the controller endstop input reads | 1 | $0.00 |  | Amazon | buy (https://www.amazon.com/dp/B0719K9Z9R) | LAR-05_tcst2103_endstop_module.step (https://github.com/Normansrule/Gonioreflectometer-Open-Source/blob/main/cad/bought/LAR-05_tcst2103_endstop_module.step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) | LAR-05_tcst2103_endstop_module.stl (https://github.com/Normansrule/Gonioreflectometer-Open-Source/blob/main/cad/bought/LAR-05_tcst2103_endstop_module.stl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) | checked 2026-10-10 | suggested | In the LAR-05 6-pack. | Electronics
08-tilt | TLT-05 | Purchase |  | M8 x 35 hex bolts, half thread (10-pack; 2 used) | Cradle turns on two stub axles in the yoke's 608s | 2 × M8-1.25 × 35 mm hex bolt (DIN 931, smooth shank under the bearing), grade 8.8, + 2 M8 hex nuts | 1 | $9.19 |  | Amazon | buy (https://www.amazon.com/dp/B08KSVMT7W) | TLT-05_bolt_m8x35_nut.step (https://github.com/Normansrule/Gonioreflectometer-Open-Source/blob/main/cad/bought/TLT-05_bolt_m8x35_nut.step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) | TLT-05_bolt_m8x35_nut.stl (https://github.com/Normansrule/Gonioreflectometer-Open-Source/blob/main/cad/bought/TLT-05_bolt_m8x35_nut.stl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) | checked 2026-10-10 | suggested | Nuts from the TBL-05 pack. | Mechanical
08-tilt | TLT-06 | Purchase |  | Axis fasteners (M3 motor face + M2 set) | Motor face (M3), brackets, flags, clamps (M2) | 4 × M3 × 16 for the NEMA 17 face (through the 12 mm yoke arm); M2 socket screws 6–16 mm with nuts and washers | 1 | $0.00 |  | Amazon | buy (https://www.amazon.com/dp/B0D636MJ1N) | FRM-07_screw_m3x8.step (https://github.com/Normansrule/Gonioreflectometer-Open-Source/blob/main/cad/bought/FRM-07_screw_m3x8.step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) | FRM-07_screw_m3x8.stl (https://github.com/Normansrule/Gonioreflectometer-Open-Source/blob/main/cad/bought/FRM-07_screw_m3x8.stl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) | checked 2026-10-11 | suggested | From the FRM-06 and FRM-07 kits. | Mechanical
08-tilt | TLT-07 | Print |  | Printed tilt parts | Yoke (motor slots above the axis), 100T pulley, cradle | ABS, 0.2 mm layers, 4 walls, 25–30 % infill, enclosed printer; settings and checks in this stage's checklist | 1 | $0.00 |  | Self-printed (black ABS) | n/a | TLT-07a_tilt_yoke.step (https://github.com/Normansrule/Gonioreflectometer-Open-Source/blob/main/phases/08-tilt/3d/TLT-07a_tilt_yoke.step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) | TLT-07a_tilt_yoke.stl (https://github.com/Normansrule/Gonioreflectometer-Open-Source/blob/main/phases/08-tilt/3d/TLT-07a_tilt_yoke.stl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) | n/a | suggested |  | Printed
09-spin | SPN-01 | Purchase |  | NEMA 17 pancake stepper 16 Ncm 1 A (direct drive) | M1 spin: the platter sits on its shaft | NEMA 17 pancake, body ≤ 25 mm, 1.8°/step, ≥ 13 N·cm, ≤ 1.0 A, 5 mm D-shaft ≥ 16 mm (driver at 1/64 microstep) | 1 | $11.99 |  | Amazon | buy (https://www.amazon.com/dp/B00PNEQ79Q) | SPN-01_nema17_17hs08_1004s_pancake.step (https://github.com/Normansrule/Gonioreflectometer-Open-Source/blob/main/cad/bought/SPN-01_nema17_17hs08_1004s_pancake.step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) | SPN-01_nema17_17hs08_1004s_pancake.stl (https://github.com/Normansrule/Gonioreflectometer-Open-Source/blob/main/cad/bought/SPN-01_nema17_17hs08_1004s_pancake.stl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) | checked 2026-10-10 | ordered | Bought. Fixed bare leads, no connector (listing photo): spliced to a spare LAR-02 cable (6-pin plug cut off) with 3 × WAGO 221-412 + 1 × 221-415 (fine-stranded 0.14–4 mm²), XH 4-pin end into the SKR Pico E socket. Wiring: README → Wiring, M27.1. Same frame and shaft, also fits: STEPPERONLINE 17HE08-1004S (B0B93PNYCP); check its shaft length ≥ 16 mm and D flat. | Electronics
09-spin | SPN-04 | Purchase |  | Optical endstop module, slot type (from the LAR-05 6-pack) | Home | Slotted optical switch module (TCST2103, 3.1 mm slot), 3.3–5 V supply, digital output the controller endstop input reads | 1 | $0.00 |  | Amazon | buy (https://www.amazon.com/dp/B0719K9Z9R) | LAR-05_tcst2103_endstop_module.step (https://github.com/Normansrule/Gonioreflectometer-Open-Source/blob/main/cad/bought/LAR-05_tcst2103_endstop_module.step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) | LAR-05_tcst2103_endstop_module.stl (https://github.com/Normansrule/Gonioreflectometer-Open-Source/blob/main/cad/bought/LAR-05_tcst2103_endstop_module.stl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) | checked 2026-10-10 | suggested | In the LAR-05 6-pack. | Electronics
09-spin | SPN-06 | Purchase |  | Axis fasteners (M3 motor face + M2 set) | Motor face (M3), brackets, flags, clamps (M2) | 4 × M3 × 8 for the NEMA 17 face; M2 socket screws 6–16 mm with nuts and washers | 1 | $0.00 |  | Amazon | buy (https://www.amazon.com/dp/B0D636MJ1N) | FRM-07_screw_m3x8.step (https://github.com/Normansrule/Gonioreflectometer-Open-Source/blob/main/cad/bought/FRM-07_screw_m3x8.step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) | FRM-07_screw_m3x8.stl (https://github.com/Normansrule/Gonioreflectometer-Open-Source/blob/main/cad/bought/FRM-07_screw_m3x8.stl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) | checked 2026-10-11 | suggested | From the FRM-06 and FRM-07 kits. | Mechanical
09-spin | SPN-07 | Print |  | Spin platter (direct drive) | Sample face; clamps the motor's D-shaft with an M3 grub in a captive nut | ABS, 0.2 mm layers, 4 walls, 25–30 % infill, enclosed printer; settings and checks in this stage's checklist | 1 | $0.00 |  | Self-printed (black ABS) | n/a | SPN-07a_spin_platter.step (https://github.com/Normansrule/Gonioreflectometer-Open-Source/blob/main/phases/09-spin/3d/SPN-07a_spin_platter.step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) | SPN-07a_spin_platter.stl (https://github.com/Normansrule/Gonioreflectometer-Open-Source/blob/main/phases/09-spin/3d/SPN-07a_spin_platter.stl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) | n/a | suggested |  | Printed
10-color | MSK-01 | Optional |  | Narrow-band 3 W star LEDs, pre-soldered leads (7 bands, 450–660 nm) | Colour bands | Narrow-band LEDs on 20 mm stars with pre-soldered wire leads (no solder), 1–3 W, bandwidth ≤ 30 nm, spread over 450–660 nm | 7 | $10.99 |  | Amazon | buy (https://www.amazon.com/dp/B0GJMJ5MWN) | MSK-01_star_led_20mm.step (https://github.com/Normansrule/Gonioreflectometer-Open-Source/blob/main/cad/bought/MSK-01_star_led_20mm.step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) | MSK-01_star_led_20mm.stl (https://github.com/Normansrule/Gonioreflectometer-Open-Source/blob/main/cad/bought/MSK-01_star_led_20mm.stl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) | checked 2026-10-10 | suggested | BLOCKED (audit F09): do not buy or power until the LED driver circuit is reviewed (design.md). One pack per band, $10.99 each (lens angle doesn't matter: the lenses are left off). The yellow and orange listings give no wavelength (typically ≈ 590 / ≈ 605 nm): measure them with the SPC sensor. Ring slot 8 stays spare. The first-draft CHANZON parts are bare chips that need soldering. | Electronics
10-color | MSK-02 | Optional |  | Constant-current driver 350 mA | One driver, one LED on at a time | Constant-current LED driver 350 mA, input covering 24 V | 1 | $5.41 |  | Digi-Key | buy (https://www.digikey.com/en/products/detail/mean-well-usa-inc/NLDD-350H/13913618) | MSK-02_meanwell_nldd_350h.step (https://github.com/Normansrule/Gonioreflectometer-Open-Source/blob/main/cad/bought/MSK-02_meanwell_nldd_350h.step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) | MSK-02_meanwell_nldd_350h.stl (https://github.com/Normansrule/Gonioreflectometer-Open-Source/blob/main/cad/bought/MSK-02_meanwell_nldd_350h.stl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) | checked 2026-10-10 | suggested | BLOCKED (audit F09): do not buy or power until the LED driver circuit is reviewed (design.md). | Electronics
10-color | MSK-03 | Optional |  | 4-channel MOSFET switch module, opto-isolated inputs, screw terminals (2 used: 8 channels) | The ESP32-S3 hub selects the band (low-side switch on each LED cathode) | 4-channel low-side MOSFET module, isolated inputs that switch at 3.3 V (3–20 V input), ≥ 0.5 A per channel at 24 V, screw terminals on every input and output (no solder) | 2 | $7.39 |  | Amazon | buy (https://www.amazon.com/dp/B0GY97176W) | MSK-03_mosfet_module_4ch.step (https://github.com/Normansrule/Gonioreflectometer-Open-Source/blob/main/cad/bought/MSK-03_mosfet_module_4ch.step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) | MSK-03_mosfet_module_4ch.stl (https://github.com/Normansrule/Gonioreflectometer-Open-Source/blob/main/cad/bought/MSK-03_mosfet_module_4ch.stl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) | checked 2026-10-11 | suggested | BLOCKED (audit F09): do not buy or power until the LED driver circuit is reviewed (design.md). Replaces the ULN2803A chip, which needed a breadboard. Same wiring: LED cathode → OUTn, inputs ← ESP32-S3 GPIO 8–14 and 21. | Electronics
10-color | MSK-04 | Optional |  | Heatsink 40 mm (second LSR-03) | LED bank cooling | Aluminium heatsink ≥ 40 × 40 mm | 1 | $10.67 |  | Digi-Key | buy (https://www.digikey.com/en/products/detail/wakefield-thermal-solutions/910-40-2-12-2-B-0/4815166) | LSR-03_wakefield_910_40_2_12_2_b0.step (https://github.com/Normansrule/Gonioreflectometer-Open-Source/blob/main/cad/bought/LSR-03_wakefield_910_40_2_12_2_b0.step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) | LSR-03_wakefield_910_40_2_12_2_b0.stl (https://github.com/Normansrule/Gonioreflectometer-Open-Source/blob/main/cad/bought/LSR-03_wakefield_910_40_2_12_2_b0.stl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) | estimate | suggested | Optional colour kit (stage 10). Price is Mouser's qty-1 via Octopart; Digi-Key price [TBD]. | Mechanical
10-color | MSK-05 | Optional |  | Linear polarizer film 10 x 10 cm (10) | Polarized capture (specular/diffuse separation) | Linear polarizer film for visible light; crossed ÷ parallel ≤ 1/20 when tested | 1 | $6.83 |  | Amazon | buy (https://www.amazon.com/dp/B0FX4P45HD) | MSK-05_polarizer_film_100mm.step (https://github.com/Normansrule/Gonioreflectometer-Open-Source/blob/main/cad/bought/MSK-05_polarizer_film_100mm.step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) | MSK-05_polarizer_film_100mm.stl (https://github.com/Normansrule/Gonioreflectometer-Open-Source/blob/main/cad/bought/MSK-05_polarizer_film_100mm.stl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) | checked 2026-10-10 | suggested |  | Mechanical
10-color | MSK-06 | Print |  | LED bank ring on a 40 deg mast, polarizer holders | 40° mast: 2nd light height | ABS, 0.2 mm layers, 4 walls, 25–30 % infill, enclosed printer; settings and checks in this stage's checklist | 1 | $0.00 |  | Self-printed (black ABS) | n/a | MSK-06a_led_ring.step (https://github.com/Normansrule/Gonioreflectometer-Open-Source/blob/main/phases/10-color/3d/MSK-06a_led_ring.step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) | MSK-06a_led_ring.stl (https://github.com/Normansrule/Gonioreflectometer-Open-Source/blob/main/phases/10-color/3d/MSK-06a_led_ring.stl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) | n/a | suggested |  | Printed
10-color | SPC-01 | Optional |  | AS7341 spectral sensor breakout, 8 visible bands + clear + NIR (STEMMA QT) | Spectral reading of the spot at the zero point | AS7341 spectral sensor breakout (8 visible bands + clear + NIR), I²C address 0x39, 3.3 V, STEMMA QT / Qwiic | 1 | $18.95 |  | Adafruit | buy (https://www.adafruit.com/product/4698) | SPC-01_adafruit_4698_as7341.step (https://github.com/Normansrule/Gonioreflectometer-Open-Source/blob/main/cad/open/SPC-01_adafruit_4698_as7341.step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) |  | checked 2026-10-09 | suggested | I2C 0x39 on ESP32-S3 GPIO 1 (SDA) / 2 (SCL), shared with the OLED | Electronics
10-color | SPC-02 | Optional |  | JST-SH 4-pin to female jumper cable 150 mm | Sensor to the ESP32-S3 hub | JST-SH 4-pin (STEMMA QT) to female 2.54 mm sockets, ≈ 150 mm | 1 | $0.95 |  | Adafruit | buy (https://www.adafruit.com/product/4397) | SPC-02_jst_sh_cable.step (https://github.com/Normansrule/Gonioreflectometer-Open-Source/blob/main/cad/bought/SPC-02_jst_sh_cable.step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) | SPC-02_jst_sh_cable.stl (https://github.com/Normansrule/Gonioreflectometer-Open-Source/blob/main/cad/bought/SPC-02_jst_sh_cable.stl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) | checked 2026-10-09 | suggested |  | Electronics
10-color | SPC-03 | Print |  | Spectral sensor tube + mount | 3 mm aperture, ~4 deg field; sits above the camera lens | ABS, 0.2 mm layers, 4 walls, 25–30 % infill, enclosed printer; settings and checks in this stage's checklist | 1 | $0.00 |  | Self-printed (black ABS) | n/a | SPC-03a_spectral_tube.step (https://github.com/Normansrule/Gonioreflectometer-Open-Source/blob/main/phases/10-color/3d/SPC-03a_spectral_tube.step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) | SPC-03a_spectral_tube.stl (https://github.com/Normansrule/Gonioreflectometer-Open-Source/blob/main/phases/10-color/3d/SPC-03a_spectral_tube.stl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) | n/a | suggested |  | Printed
11-scan-capture | SCN-01 | Purchase |  | Mounting putty 2 oz | Holds objects on the tilted platter during scans | Removable mounting putty | 1 | $2.33 |  | Amazon | buy (https://www.amazon.com/dp/B003LZMHIY) | SCN-01_mounting_putty_blob.step (https://github.com/Normansrule/Gonioreflectometer-Open-Source/blob/main/cad/bought/SCN-01_mounting_putty_blob.step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) | SCN-01_mounting_putty_blob.stl (https://github.com/Normansrule/Gonioreflectometer-Open-Source/blob/main/cad/bought/SCN-01_mounting_putty_blob.stl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) | checked 2026-10-10 | suggested |  | Mechanical
11-scan-capture | SCN-02 | Purchase |  | ChArUco scanning mat (printed on TLS-08) | Scale and pose check under the object | ChArUco mat printed at 100 % on matte paper | 1 | $0.00 |  | Amazon | buy (https://www.amazon.com/dp/B01FV0F8H8) | SCN-02_charuco_mat_print.step (https://github.com/Normansrule/Gonioreflectometer-Open-Source/blob/main/cad/bought/SCN-02_charuco_mat_print.step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) | SCN-02_charuco_mat_print.stl (https://github.com/Normansrule/Gonioreflectometer-Open-Source/blob/main/cad/bought/SCN-02_charuco_mat_print.stl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) | checked 2026-10-11 | suggested | In the TLS-11 paper. Free generator: ChArUco, Letter, print at 100 %. | Mechanical
11-scan-capture | SCN-03 | Print |  | Platter risers (20/40/60 mm), scan camera plate (15 deg) | Object centre at the zero point | ABS, 0.2 mm layers, 4 walls, 25–30 % infill, enclosed printer; settings and checks in this stage's checklist | 1 | $0.00 |  | Self-printed (black ABS) | n/a | SCN-03a_riser_20.step (https://github.com/Normansrule/Gonioreflectometer-Open-Source/blob/main/phases/11-scan-capture/3d/SCN-03a_riser_20.step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) | SCN-03a_riser_20.stl (https://github.com/Normansrule/Gonioreflectometer-Open-Source/blob/main/phases/11-scan-capture/3d/SCN-03a_riser_20.stl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) | n/a | suggested | δ = 60 − riser height. | Printed
11-scan-capture | CAM-04 | Optional |  | Second USB camera 12 MP IMX477, M12 mount (scan camera) | No-switching kit: the scan camera stays at 650 mm; the measuring camera never moves or refocuses | Identical to CAM-01 (same sensor, so the same settings and calibration steps) | 1 | $59.99 |  | Amazon | buy (https://www.amazon.com/dp/B0C1G73QZD) | CAM-01_arducam_b0433_imx477_usb.step (https://github.com/Normansrule/Gonioreflectometer-Open-Source/blob/main/cad/bought/CAM-01_arducam_b0433_imx477_usb.step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) | CAM-01_arducam_b0433_imx477_usb.stl (https://github.com/Normansrule/Gonioreflectometer-Open-Source/blob/main/cad/bought/CAM-01_arducam_b0433_imx477_usb.stl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) | checked 2026-10-10 | suggested |  | Electronics
11-scan-capture | CAM-05 | Optional |  | Second M12 16 mm lens (scan camera) | No-switching kit: the scan camera stays at 650 mm; the measuring camera never moves or refocuses | Identical to CAM-02: 16 mm focal length (236 × 186 mm field at 650 mm), used at f/8 (2.0 mm stop) | 1 | $30.11 |  | Amazon | buy (https://www.amazon.com/dp/B0HJWVFD7R) | CAM-02_m12_lens_16mm.step (https://github.com/Normansrule/Gonioreflectometer-Open-Source/blob/main/cad/bought/CAM-02_m12_lens_16mm.step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) | CAM-02_m12_lens_16mm.stl (https://github.com/Normansrule/Gonioreflectometer-Open-Source/blob/main/cad/bought/CAM-02_m12_lens_16mm.stl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) | checked 2026-10-10 | suggested |  | Mechanical
15-standalone | STA-01 | Optional |  | Raspberry Pi Zero 2 WH (header soldered) | Runs opengonio station: jobs + camera without the laptop | Raspberry Pi Zero 2 W with factory-soldered 40-pin header (Zero 2 WH), 64-bit, WiFi | 1 | $19.80 |  | Adafruit | buy (https://www.adafruit.com/product/6008) | STA-01_pi_zero_2wh.step (https://github.com/Normansrule/Gonioreflectometer-Open-Source/blob/main/cad/bought/STA-01_pi_zero_2wh.step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) | STA-01_pi_zero_2wh.stl (https://github.com/Normansrule/Gonioreflectometer-Open-Source/blob/main/cad/bought/STA-01_pi_zero_2wh.stl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) | checked 2026-10-09 | suggested | Out of stock at Adafruit when checked. Header pre-soldered: jumpers push on. MSRP; any approved reseller. | Electronics
15-standalone | STA-02 | Optional |  | microSD card 32 GB | Pi OS + job data | microSD ≥ 16 GB, A1 class | 1 | $18.99 |  | Amazon | buy (https://www.amazon.com/dp/B0DR926VXL) | STA-02_microsd_card.step (https://github.com/Normansrule/Gonioreflectometer-Open-Source/blob/main/cad/bought/STA-02_microsd_card.step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) | STA-02_microsd_card.stl (https://github.com/Normansrule/Gonioreflectometer-Open-Source/blob/main/cad/bought/STA-02_microsd_card.stl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) | checked 2026-10-10 | suggested |  | Electronics
15-standalone | STA-03 | Optional |  | Buck converter 24 V to 5 V 3 A | Powers the Pi from the pack (after the fuse, before the e-stop: the Pi stays up when the e-stop is pressed) | Buck converter 18–24 V in → 5.1 V out, ≥ 3 A, screw terminals on input and output | 1 | $7.99 |  | Amazon | buy (https://www.amazon.com/dp/B0DBVYP91F) | STA-03_buck_lm2596_display.step (https://github.com/Normansrule/Gonioreflectometer-Open-Source/blob/main/cad/bought/STA-03_buck_lm2596_display.step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) | STA-03_buck_lm2596_display.stl (https://github.com/Normansrule/Gonioreflectometer-Open-Source/blob/main/cad/bought/STA-03_buck_lm2596_display.stl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) | checked 2026-10-10 | suggested | Wired under the jack's +/− screws, before the e-stop: the Pi draws ~2–3 W whenever the adapter is plugged in. Set it to 5.1 V with the trimmer before connecting the Pi; check for screw terminals. | Electronics
15-standalone | STA-04 | Optional |  | Micro-USB OTG adapter | Camera and the SKR Pico into the Pi USB port | Micro-USB OTG to USB-A adapter, then a powered USB hub (camera + SKR Pico USB-C cable) | 1 | $2.50 |  | Adafruit | buy (https://www.adafruit.com/product/1099) | STA-04_otg_adapter.step (https://github.com/Normansrule/Gonioreflectometer-Open-Source/blob/main/cad/bought/STA-04_otg_adapter.step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) | STA-04_otg_adapter.stl (https://github.com/Normansrule/Gonioreflectometer-Open-Source/blob/main/cad/bought/STA-04_otg_adapter.stl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) | checked 2026-10-09 | suggested | A powered USB hub is also needed in standalone mode (two devices on one port); it is not in this list yet: choose one when you reach stage 15. | Electronics
15-standalone | STA-05 | Optional |  | SSD1306 OLED 0.96 in I2C 128x64 | Menu and progress on the panel (both modes) | SSD1306 OLED 128 × 64, I²C, 3.3 V, address 0x3C, 4-pin header pre-soldered | 1 | $17.50 |  | Adafruit | buy (https://www.adafruit.com/product/326) | STA-05_ssd1306_oled_096in.step (https://github.com/Normansrule/Gonioreflectometer-Open-Source/blob/main/cad/bought/STA-05_ssd1306_oled_096in.step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) | STA-05_ssd1306_oled_096in.stl (https://github.com/Normansrule/Gonioreflectometer-Open-Source/blob/main/cad/bought/STA-05_ssd1306_oled_096in.stl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) | checked 2026-10-09 | suggested | Check the address is 0x3C (some are 0x3D). | Electronics
15-standalone | STA-06 | Optional |  | Jumper wires female-female (10) | Pi UART to the ESP32-S3 hub; OLED | Female–female 2.54 mm jumper wires | 1 | $1.95 |  | Adafruit | buy (https://www.adafruit.com/product/1950) | STA-06_jumper_wire_ff.step (https://github.com/Normansrule/Gonioreflectometer-Open-Source/blob/main/cad/bought/STA-06_jumper_wire_ff.step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) | STA-06_jumper_wire_ff.stl (https://github.com/Normansrule/Gonioreflectometer-Open-Source/blob/main/cad/bought/STA-06_jumper_wire_ff.stl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) | checked 2026-10-09 | suggested | Consumable: set `have` if it's in your drawer. | Electronics
15-standalone | STA-08 | Optional |  | USB-A to micro-B data cable 1 m | Pi OTG port to a USB hub / camera | USB-A to micro-B data cable (not charge-only), ≤ 1 m | 1 | $2.95 |  | Adafruit | buy (https://www.adafruit.com/product/592) | STA-08_adafruit_592_microusb_cable.step (https://github.com/Normansrule/Gonioreflectometer-Open-Source/blob/main/cad/open/STA-08_adafruit_592_microusb_cable.step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) |  | checked 2026-10-09 | suggested |  | Electronics
15-standalone | STA-09 | Optional |  | Status screen 2 in IPS 240 x 320, SPI (Waveshare 2inch LCD Module) | Hub status on demand without the app: power, keys, laptop link, last spectral reading (SCREEN ON) | ST7789 or ST7789VW 2.0 in IPS LCD, 240 × 320, 4-wire SPI, 3.3 V logic and supply, 8 pins VCC GND DIN CLK CS DC RST BL, cable ending in 2.54 mm female jumper ends (no solder) | 1 | $0.00 |  | Amazon | buy (https://www.amazon.com/dp/B081Q79X2F) | STA-09_waveshare_2in_lcd.step (https://github.com/Normansrule/Gonioreflectometer-Open-Source/blob/main/cad/bought/STA-09_waveshare_2in_lcd.step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) | STA-09_waveshare_2in_lcd.stl (https://github.com/Normansrule/Gonioreflectometer-Open-Source/blob/main/cad/bought/STA-09_waveshare_2in_lcd.stl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) | [TBD] | suggested | Price [TBD]: check the store page and set it here. Box: module + 20 cm PH2.0 8-pin cable [L30]; the maker page does not say what its far end is: check the listing shows 8 female jumper ends before buying. Wiring: addons.html. Holder: STA-10 (M2 × 8, no screws into the module). | Electronics
15-standalone | STA-07 | Print |  | Pi Zero mount + OLED window | Clips into the controller case | ABS, 0.2 mm layers, 4 walls, 25–30 % infill, enclosed printer; settings and checks in this stage's checklist | 1 | $0.00 |  | Self-printed (black ABS) | n/a | STA-07a_pi_zero_mount.step (https://github.com/Normansrule/Gonioreflectometer-Open-Source/blob/main/phases/15-standalone/3d/STA-07a_pi_zero_mount.step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) | STA-07a_pi_zero_mount.stl (https://github.com/Normansrule/Gonioreflectometer-Open-Source/blob/main/phases/15-standalone/3d/STA-07a_pi_zero_mount.stl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) | n/a | suggested |  | Printed
15-standalone | STA-10 | Print |  | Status screen stand + bezel | Holds STA-09 at 30° from vertical beside the controller tray, facing the laptop side | ABS, 0.2 mm layers, 4 walls, 25–30 % infill, enclosed printer; settings and checks in this stage's checklist | 1 | $0.00 |  | Self-printed (black ABS) | n/a | STA-10a_screen_stand.step (https://github.com/Normansrule/Gonioreflectometer-Open-Source/blob/main/phases/15-standalone/3d/STA-10a_screen_stand.step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) | STA-10a_screen_stand.stl (https://github.com/Normansrule/Gonioreflectometer-Open-Source/blob/main/phases/15-standalone/3d/STA-10a_screen_stand.stl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) | n/a | suggested | The bezel clamps only the module's two short ends (4 mm each), so its holes and thickness need not be known. Check on the real module before printing: the display sits inside the 50 mm window and back-side parts clear the 3 mm ledge. | Printed
