Normansrule/Gonioreflectometer-Open-Source/phases/01-power/bom.csv

ID | Type | Part | Use | Requirement | Qty | Maker | Part number | Supplier | Link | Unit USD | Total USD | STEP | CAD license | Notes | Own | Price | Refs | Paid USD | Status
PWR-30 | Purchase | 24 V 3 A wall adapter with screw-terminal DC jack | Power for the whole machine: plugs into the wall; its round plug goes into the screw-terminal jack | Regulated 24 V DC, ≥ 3 A (72 W), 5.5 × 2.1 mm plug, short-circuit and overload protection, with a female 5.5 × 2.1 mm jack to screw terminals (+ / − marked): no solder | 1 | ALITOVE | 24 V 3 A 72 W, 5.5 × 2.1 mm, with screw-terminal jack (B078RY7BPL) | Amazon | https://www.amazon.com/dp/B078RY7BPL | 17.85 | 17.85 | None published - repo model of the jack at an ESTIMATED 32 x 14 x 13 mm (measure on arrival) | n/a | Listing (read 2026-10-23): FCC / CE / RoHS (not a UL listing); short-circuit, overload and over-temperature protection; AC cable ~120 cm, DC cable ~110 cm. The adapter stays outside the machine; only the jack sits on the power plate. Replaces the battery, USB-C charging, fuse and their box. | N | checked 2026-10-23 | P59 |  | suggested
PWR-28 | Purchase | Emergency stop in its own box, latching, 1 NO + 1 NC, screw terminals | Cuts 24 V to the motor board (motors, lamp); also the off switch | Latching mushroom e-stop (push to stop, twist to release) already mounted in its own box: no panel hole; ≥ 1 normally-closed contact rated ≥ 3 A (DC rating where the listing gives one); screw terminals (no solder) | 1 | BAOMAIN | Red Sign E-Stop station, 1NO1NC, IP65 (B00NTT91Y0) | Amazon | https://www.amazon.com/dp/B00NTT91Y0 | 8.99 | 8.99 | None published - repo model at an ESTIMATED 70 x 70 x 60 mm box + Ø40 head (measure on arrival) | n/a | Contacts rated 660 V / 10 A (AC). Wire the NC contact: terminals 1 and 2 on this switch, NO = 3 and 4 (confirm with the meter: 1–2 beep released, open pressed). Sits on the power plate on double-sided tape. | N | checked 2026-10-22 | P60 |  | suggested
PWR-10 | Purchase | Optocoupler module PC817, 24 V input, screw terminals (2-pack) | Isolated motion-power sense to the ESP32-S3 hub (resistor on the board) | 1-channel PC817 isolation module, 24 V input version (works from 18–24 V), 3.3–5 V output side, screw terminals: no breadboard, no solder | 1 | NOYITO | 1-ch PC817 module, 24 V version, 2-pack (B0B5382ZT7) | Amazon | https://www.amazon.com/dp/B0B5382ZT7 | 6.99 | 6.99 | None published - repo model at the maker size 66 x 16.5 x 12 mm | n/a | 66 x 16.5 x 12 mm; sits in a locating frame on the controller tray (double-sided tape). Second module spare. | N | checked 2026-10-13 | - |  | suggested
PWR-15 | Purchase | 18 AWG silicone wire red/black, 1.5 m (5 ft) each colour | Power wiring | 18 AWG stranded silicone wire, red + black (≥ 5 A) | 1 | BNTECHGO | 18 AWG silicone, red + black 5 ft each (B01708AYYQ) | Amazon | https://www.amazon.com/dp/B01708AYYQ | 7.98 | 7.98 | None published - use the dummy (wire) | n/a |  | N | checked 2026-10-10 | P20 |  | suggested
PWR-20 | Purchase | Lever wire connectors, WAGO 221 assortment (12) | Every bare-wire join: no solder, no crimp, no heat-shrink | Lever splicing connectors for 24–12 AWG stranded and solid wire (fine-stranded down to 0.14 mm²), 2/3/5-way, ≥ 20 A (WAGO 221-412/413/415): ≥ 4 × 3-way, 6 × 2-way, 4 × 5-way, 3 × 221-2401 | 2 | WAGO | 221 Lever-Nuts 12-pc assortment with case: 3 × 221-2401, 3 × 221-412, 3 × 221-413, 3 × 221-415 (B0CJ5QF4Z2) | Amazon | https://www.amazon.com/dp/B0CJ5QF4Z2 | 12.45 | 24.90 | https://www.wago.com/ch-de/installationsklemmen/compact-verbindungsklemme/p/221-412 (Downloads → STEP) | Vendor CAD - link only | Two packs: one is not enough since the lamp driver has wire leads. Uses (README → Wiring): MOT+, MOT− and keypad GND 221-413; M1 pancake splice 3 × 221-412 + 1 × 221-415 (motor leads ~26 AWG: only the 221-41x take fine-stranded 0.14 mm²); lamp: 2 on the tray (driver leads to jumper chains), 2 at the lamp, 1 capping the DIM lead (2-way or larger); all three 221-2401 at the limit switch (two splices into the red run + the unused wire's cap); hub add-ons: 3V3 rail 221-415 and sensor GND 221-413. The three tray 221-413s sit in pockets on the controller tray (CTL-10b). | N | checked 2026-11-01 | P62 |  | suggested
PWR-18 | Print | Power plate | Holds the screw-terminal jack and the e-stop box on the deck; OG-40 mount | ABS, 0.2 mm layers, 4 walls, 25–30 % infill, enclosed printer; settings and checks in this stage's checklist | 1 | OpenGonio | OG-PWR-PLATE | Self-printed (black ABS) | n/a | 0.00 | 0.00 | 3d/PWR-18_power_plate.step | CERN-OHL-S-2.0 | Plate ABS weight: see cad/PRINT.md. The jack sits in a frame with its screw terminals toward the controller tray; the e-stop box sits in a 2 mm rim on double-sided tape (TLS-09). | N | n/a | - |  | suggested
