Normansrule/Gonioreflectometer-Open-Source/phases/03-frame/bom.csv

ID | Type | Part | Use | Requirement | Qty | Maker | Part number | Supplier | Link | Unit USD | Total USD | STEP | CAD license | Notes | Own | Price | Refs | Paid USD | Status
FRM-01 | Print | Deck: 9 tiles of 200 mm (600 x 600 x 24 mm) | Base for every part: replaces plywood | ABS, 0.2 mm layers, 4 walls, 25–30 % infill, enclosed printer; settings and checks in this stage's checklist | 1 | OpenGonio | OG-FRM-01 | Self-printed (black ABS) | n/a | 0.00 | 0.00 | 3d/FRM-01a_deck_tile_SW.step; 3d/FRM-01b_deck_tile_S.step; 3d/FRM-01c_deck_tile_SE.step; 3d/FRM-01d_deck_tile_W.step; 3d/FRM-01e_deck_tile_C.step; 3d/FRM-01f_deck_tile_E.step; 3d/FRM-01g_deck_tile_NW.step; 3d/FRM-01h_deck_tile_N.step; 3d/FRM-01i_deck_tile_NE.step | CERN-OHL-S-2.0 | Bolted edge to edge with 36 x M2 x 10 + nuts (FRM-06). Pilot bosses at every mount point and a 40 mm grid of spare pilots: nothing to measure or mark. ≈ 1.4 kg ABS, ≈ 6 h per tile. | N | n/a | - |  | suggested
FRM-02 | Print | Printed 20 x 20 bars: outrigger (2 x 250 mm), scan post (2 x 175 mm) | Outrigger and scan-camera post: replaces aluminium extrusion | ABS, 0.2 mm layers, 4 walls, 25–30 % infill, enclosed printer; settings and checks in this stage's checklist | 1 | OpenGonio | OG-FRM-02 | Self-printed (black ABS) | n/a | 0.00 | 0.00 | 3d/FRM-02a_outrigger_bar_1.step; 3d/FRM-02b_outrigger_bar_2.step; 3d/FRM-02c_scan_post_bar_1.step; 3d/FRM-02d_scan_post_bar_2.step | CERN-OHL-S-2.0 | M2 self-tap pilots at every clamp station; bar couplers (FRM-09i) join the halves. | N | n/a | - |  | suggested
FRM-06 | Purchase | M2 socket screw kit, 4–25 mm, with nuts and washers (900 pcs) | Every printed join and module mount | M2-0.4 socket-head cap screws, stainless: ≥ 40 each of 8, 10, 12 mm and ≥ 20 of 16 mm, plus ≥ 100 nuts and washers; hex key 1.5 mm | 1 | TOOINKCV | 900-pc M2 4/6/8/10/12/16/20/25 mm + 300 nuts + 300 washers (B0DCKCN2WM) | Amazon | https://www.amazon.com/dp/B0DCKCN2WM | 7.58 | 7.58 | Onshape Standard Content: ISO 4762 socket head M2 | n/a | 300 screws: 50 × 4/6/8, 40 × 10/12, 25 × 16/20, 20 × 25 mm. About 130 used. Self-tap into 1.7 mm printed pilots (set from the coupon). | N | checked 2026-10-11 | - |  | suggested
FRM-07 | Purchase | Socket screw kit M2/M3/M4 with nuts (820 pcs): M3 for the motors | M3 x 8 into three NEMA 17 faces, M3 x 16 through the tilt-yoke arm into the fourth (the motors' own thread); spare M2 | M3-0.5 × 8 mm (≥ 12) and × 16 mm (≥ 4) socket-head cap screws with washers; hex key 2.5 mm | 1 | LuKaiSen | 820-pc M2/M3/M4 4–20 mm + nuts, washers, keys (B0D636MJ1N) | Amazon | https://www.amazon.com/dp/B0D636MJ1N | 9.88 | 9.88 | Onshape Standard Content: ISO 4762 socket head M3 | n/a | Only M3 left in the machine: motors are threaded M3. Covers TBL-06, TLT-06, SPN-06. | N | checked 2026-10-11 | - |  | suggested
FRM-08 | Purchase | 608-2RS bearings (10) | Table 2, tilt 2, spares 6 | 608-2RS ball bearings, 8 × 22 × 7 mm, sealed | 1 | generic | 608-2RS, 10 pcs (B0CX8CDL7D) | Amazon | https://www.amazon.com/dp/B0CX8CDL7D | 4.99 | 4.99 | Onshape Standard Content: ball bearing 608 (8 x 22 x 7) | n/a |  | N | checked 2026-10-10 | F7 |  | suggested
FRM-09 | Print | Ring scale clamps, bar saddles, scan-post socket, camera pillar, end foot, bar couplers | Printed frame parts | ABS, 0.2 mm layers, 4 walls, 25–30 % infill, enclosed printer; settings and checks in this stage's checklist | 1 | OpenGonio | OG-FRM-09 | Self-printed (black ABS) | n/a | 0.00 | 0.00 | 3d/FRM-09c_protractor_segment.step; 3d/FRM-09d_bar_saddle.step; 3d/FRM-09e_post_socket.step; 3d/FRM-09f_end_foot.step; 3d/FRM-09h_camera_pillar.step; 3d/FRM-09i_bar_coupler.step | CERN-OHL-S-2.0 | Everything screws into the deck's pilots with M2 (FRM-06). The ring-scale segments also clamp the lazy Susan [R1]. | N | n/a | R1 |  | suggested
