Normansrule/Gonioreflectometer-Open-Source/phases/09-spin/bom.csv

ID | Type | Part | Use | Requirement | Qty | Maker | Part number | Supplier | Link | Unit USD | Total USD | STEP | CAD license | Notes | Own | Price | Refs | Paid USD | Status
SPN-01 | Purchase | NEMA 17 pancake stepper 16 Ncm 1 A (direct drive) | M1 spin: the platter sits on its shaft | NEMA 17 pancake, body ≤ 25 mm, 1.8°/step, ≥ 13 N·cm, ≤ 1.0 A, 5 mm D-shaft ≥ 16 mm (driver at 1/64 microstep) | 1 | STEPPERONLINE | 17HS08-1004S pancake 16 Ncm (B00PNEQ79Q) | Amazon | https://www.amazon.com/dp/B00PNEQ79Q | 11.99 | 11.99 | https://files.omc-stepperonline.com/17HS08-1004S.STEP | Vendor CAD - link only | Bought. Fixed bare leads, no connector (listing photo): spliced to a spare LAR-02 cable (6-pin plug cut off) with 3 × WAGO 221-412 + 1 × 221-415 (fine-stranded 0.14–4 mm²), XH 4-pin end into the SKR Pico E socket. Wiring: README → Wiring, M27.1. Same frame and shaft, also fits: STEPPERONLINE 17HE08-1004S (B0B93PNYCP); check its shaft length ≥ 16 mm and D flat. | N | checked 2026-10-10 | P48 |  | ordered
SPN-04 | Purchase | Optical endstop module, slot type (from the LAR-05 6-pack) | Home | Slotted optical switch module (TCST2103, 3.1 mm slot), 3.3–5 V supply, digital output the controller endstop input reads | 1 | HESAI | in the LAR-05 6-pack (B0719K9Z9R) | Amazon | https://www.amazon.com/dp/B0719K9Z9R | 0.00 | 0.00 | https://www.vishay.com/en/product/81147/ (TCST2103 sensor only) | Vendor CAD - link only | In the LAR-05 6-pack. | N | checked 2026-10-10 | P43 |  | suggested
SPN-06 | Purchase | Axis fasteners (M3 motor face + M2 set) | Motor face (M3), brackets, flags, clamps (M2) | 4 × M3 × 8 for the NEMA 17 face; M2 socket screws 6–16 mm with nuts and washers | 1 | LuKaiSen / TOOINKCV | from the FRM-07 (M3) and FRM-06 (M2) kits | Amazon | https://www.amazon.com/dp/B0D636MJ1N | 0.00 | 0.00 | Onshape Standard Content | n/a | From the FRM-06 and FRM-07 kits. | N | checked 2026-10-11 | - |  | suggested
SPN-07 | Print | Spin platter (direct drive) | Sample face; clamps the motor's D-shaft with an M3 grub in a captive nut | ABS, 0.2 mm layers, 4 walls, 25–30 % infill, enclosed printer; settings and checks in this stage's checklist | 1 | OpenGonio | OG-SPN-* | Self-printed (black ABS) | n/a | 0.00 | 0.00 | 3d/SPN-07a_spin_platter.step | CERN-OHL-S-2.0 |  | N | n/a | - |  | suggested
