Normansrule/Gonioreflectometer-Open-Source/phases/11-scan-capture/bom.csv

ID | Type | Part | Use | Requirement | Qty | Maker | Part number | Supplier | Link | Unit USD | Total USD | STEP | CAD license | Notes | Own | Price | Refs | Paid USD | Status
SCN-01 | Purchase | Mounting putty 2 oz | Holds objects on the tilted platter during scans | Removable mounting putty | 1 | Loctite | Fun-Tak 2 oz (B003LZMHIY) | Amazon | https://www.amazon.com/dp/B003LZMHIY | 2.33 | 2.33 | None published - use the dummy (putty) | n/a |  | N | checked 2026-10-10 | S20 |  | suggested
SCN-02 | Purchase | ChArUco scanning mat (printed on TLS-08) | Scale and pose check under the object | ChArUco mat printed at 100 % on matte paper | 1 | Amazon Basics | printed on TLS-11 paper (B01FV0F8H8) | Amazon | https://www.amazon.com/dp/B01FV0F8H8 | 0.00 | 0.00 | None published - use the dummy (print, generated by the software) | n/a | In the TLS-11 paper. Free generator: ChArUco, Letter, print at 100 %. | N | checked 2026-10-11 | S12 |  | suggested
SCN-03 | Print | Platter risers (20/40/60 mm), scan camera plate (15 deg) | Object centre at the zero point | ABS, 0.2 mm layers, 4 walls, 25–30 % infill, enclosed printer; settings and checks in this stage's checklist | 1 | OpenGonio | OG-SCN-* | Self-printed (black ABS) | n/a | 0.00 | 0.00 | 3d/SCN-03a_riser_20.step; 3d/SCN-03b_riser_40.step; 3d/SCN-03c_riser_60.step; 3d/SCN-03d_scan_camera_plate_15.step | CERN-OHL-S-2.0 | δ = 60 − riser height. | N | n/a | - |  | suggested
CAM-04 | Optional | Second USB camera 12 MP IMX477, M12 mount (scan camera) | No-switching kit: the scan camera stays at 650 mm; the measuring camera never moves or refocuses | Identical to CAM-01 (same sensor, so the same settings and calibration steps) | 1 | Arducam | 12 MP USB (IMX477) M12 (B0C1G73QZD) | Amazon | https://www.amazon.com/dp/B0C1G73QZD | 59.99 | 59.99 | None published - use the dummy (same as CAM-01) | n/a |  | N | checked 2026-10-10 | K1,K2 |  | suggested
CAM-05 | Optional | Second M12 16 mm lens (scan camera) | No-switching kit: the scan camera stays at 650 mm; the measuring camera never moves or refocuses | Identical to CAM-02: 16 mm focal length (236 × 186 mm field at 650 mm), used at f/8 (2.0 mm stop) | 1 | generic | M12 16 mm low distortion 1/2 in (B0HJWVFD7R) | Amazon | https://www.amazon.com/dp/B0HJWVFD7R | 30.11 | 30.11 | None published - use the dummy (same as CAM-02) | n/a |  | N | checked 2026-10-10 | K5 |  | suggested
