Normansrule/Gonioreflectometer-Open-Source/phases/02-controller/test.csv

Test | Date | Measured | Pass criterion | Pass/Fail | Notes
C1 Link |  |  | ? returns <Idle|MPos:...> or <Alarm|MPos:...> over USB-C; $I lists grblHAL and BTT SKR Pico 1.0
C2 Flags |  |  | Blocking each flag shows the right Pn:
C3 Homing |  |  | $HX, $HY stop on flags; MPos 0 at the switch (opengonio status: M4 20, M3 -180)
C4 Hub |  |  | PING -> PONG OpenGonio-hub 4; each button -> one BTN line
C5 Panel |  |  | HOME homes, LIGHT toggles, NEXT moves, STOP alarms
C6 PAUSE |  |  | Plan stops after the pose in progress; START continues from the next pose
C7 E-stop |  |  | POWER 0; after release M122 I sent; moves refused until HOME
C8 Heat |  |  | Driver area <= 80 C after 30 min at 0.8 A
