Normansrule/Gonioreflectometer-Open-Source/cad/assembly/opengonio_assembly.step

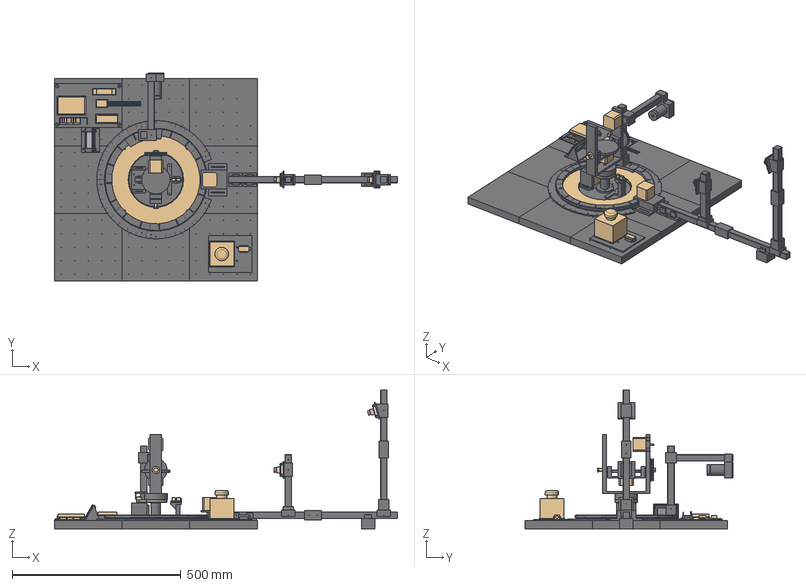
[picture p30: CAD file, 2026-11-14]
cad/assembly/opengonio_assembly.step
1015.0 x 616.0 x 410.0 mm
FRM-01a_deck_SW
FRM-01b_deck_S
FRM-01c_deck_SE
FRM-01d_deck_W
FRM-01e_deck_C
FRM-01f_deck_E
FRM-01g_deck_NW
FRM-01h_deck_N
FRM-01i_deck_NE
FRM-09d_1
FRM-09d_2
FRM-02a_outrigger_1
FRM-02b_outrigger_2
FRM-09i_1
FRM-09f_end_foot
FRM-09h_camera_pillar
FRM-09e_post_socket
FRM-02c_scan_post_1
FRM-02d_scan_post_2
FRM-09i_2
FRM-09c_1
FRM-09c_2
FRM-09c_3
FRM-09c_4
PWR-18_power_plate
PWR-28_estop
PWR-30_dc_jack
CTL-10b_controller_tray
CTL-01_btt_skr_pico
CTL-02_esp32s3_hub
PWR-10_opto_module
PWR-20_MOT_plus
PWR-20_MOT_minus
PWR-20_keypad_GND
LSR-02_led_driver
STA-10a_screen_stand
STA-09_status_screen
STA-10b_screen_bezel
LAR-01_lazy_susan
LAR-08a_1
LAR-08a_2
LAR-08a_3
LAR-08a_4
LAR-08a_5
LAR-08a_6
LAR-08a_7
LAR-08c_arm_segment
LAR-08b_ring_motor_mount
LAR-02_motor_M4
LAR-04_pulley_M4
LAR-08f_upright_bar
LAR-08e_cross_clamp
LAR-08g_arm_bar
LSR-05a_lamp
LSR-05b_lamp_cap
LSR-03_heatsink
LSR-06_holder
LSR-01_cob
TBL-07d_table_post
TBL-05_axle_bolt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
