Normansrule/Gonioreflectometer-Open-Source/cad/open/STA-08_adafruit_592_microusb_cable.step

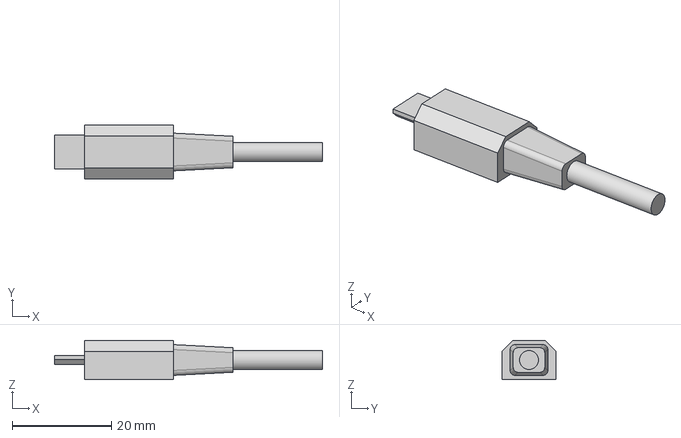
[picture p31: CAD file, 2026-10-10]
cad/open/STA-08_adafruit_592_microusb_cable.step
53.9 x 10.8 x 7.90 mm
