Normansrule/Gonioreflectometer-Open-Source/phases/00-plan/3d/PLAN-01_tolerance_coupon.step

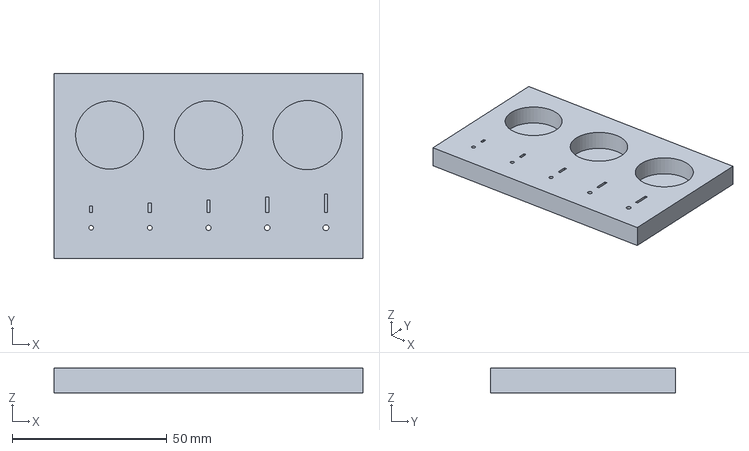
[picture p32: CAD file, 2026-10-21]
phases/00-plan/3d/PLAN-01_tolerance_coupon.step
100.0 x 60.0 x 8.00 mm
