Normansrule/Gonioreflectometer-Open-Source/phases/01-power/3d/PWR-18_power_plate.step

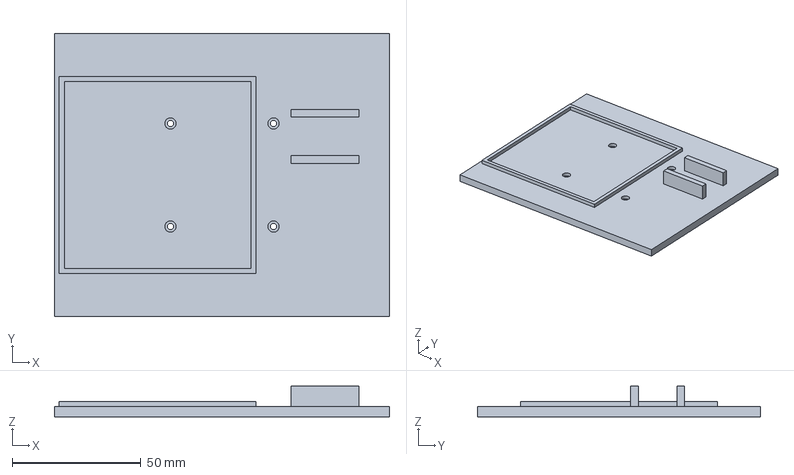
[picture p33: CAD file, 2026-11-03]
phases/01-power/3d/PWR-18_power_plate.step
130.0 x 110.0 x 12.0 mm
