Normansrule/Gonioreflectometer-Open-Source/phases/02-controller/3d/CTL-10b_controller_tray.step

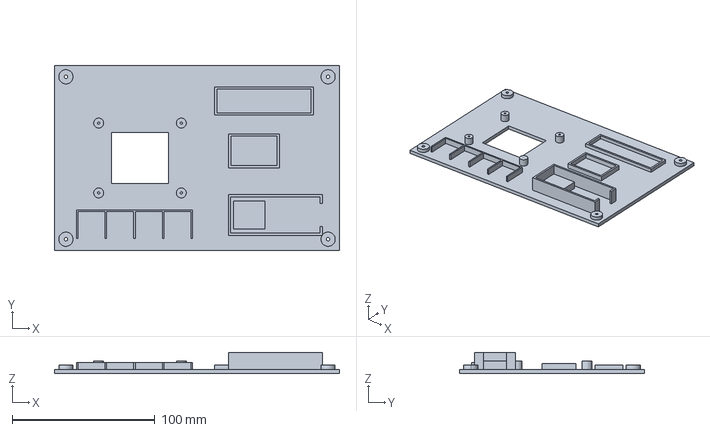
[picture p34: CAD file, 2026-11-14]
phases/02-controller/3d/CTL-10b_controller_tray.step
200.0 x 130.0 x 15.0 mm
