Normansrule/Gonioreflectometer-Open-Source/phases/03-frame/3d/FRM-01g_deck_tile_NW.step

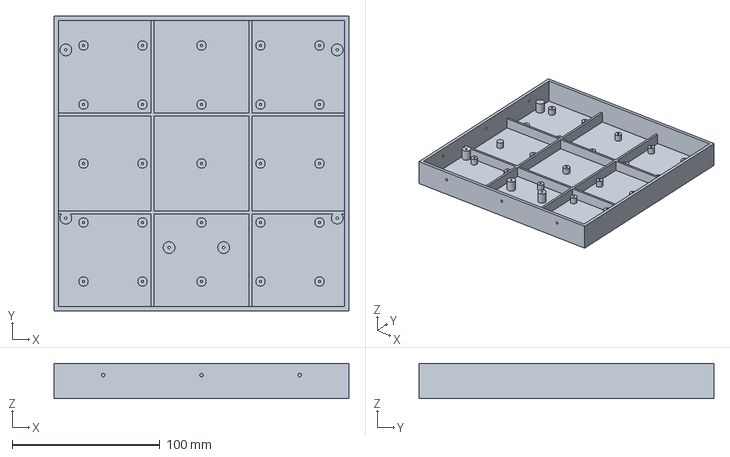
[picture p35: CAD file, 2026-11-14]
phases/03-frame/3d/FRM-01g_deck_tile_NW.step
200.0 x 200.0 x 24.0 mm
