Normansrule/Gonioreflectometer-Open-Source/phases/04-light-arm/3d/LAR-08g_arm_bar.step

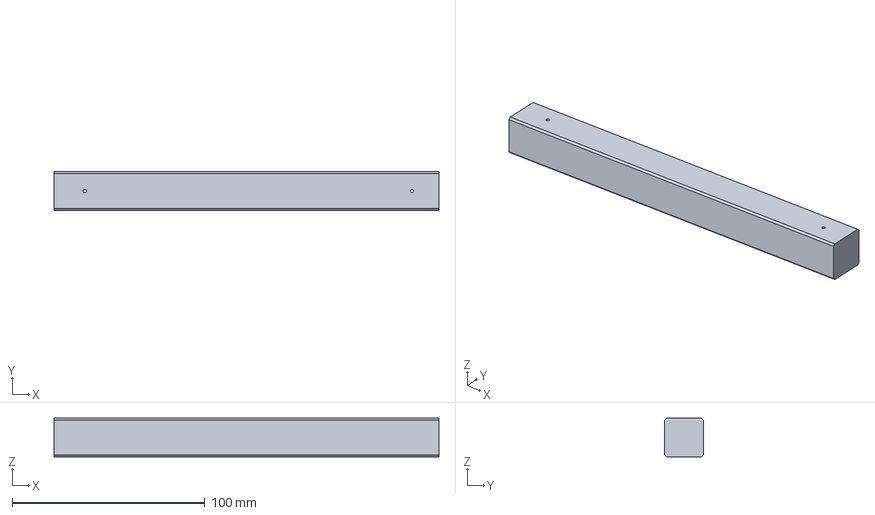
[picture p36: CAD file, 2026-11-14]
phases/04-light-arm/3d/LAR-08g_arm_bar.step
200.0 x 20.0 x 20.0 mm
