Normansrule/Gonioreflectometer-Open-Source/phases/05-table/3d/TBL-07h_table_flag.step

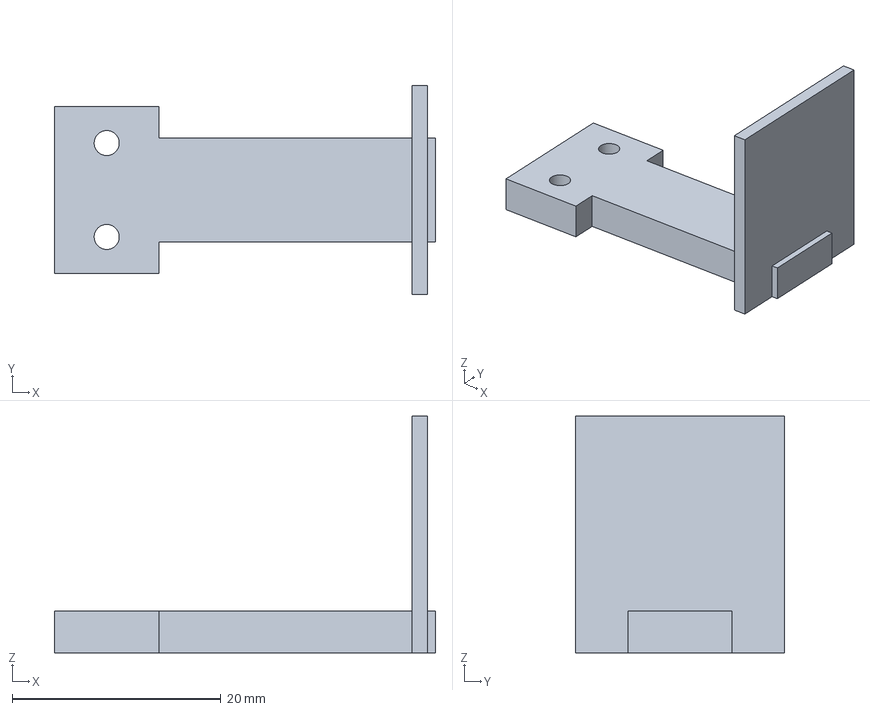
[picture p37: CAD file, 2026-11-03]
phases/05-table/3d/TBL-07h_table_flag.step
36.5 x 20.0 x 22.7 mm
