Normansrule/Gonioreflectometer-Open-Source/phases/06-camera-light/3d/LSR-05a_lamp_tube.step

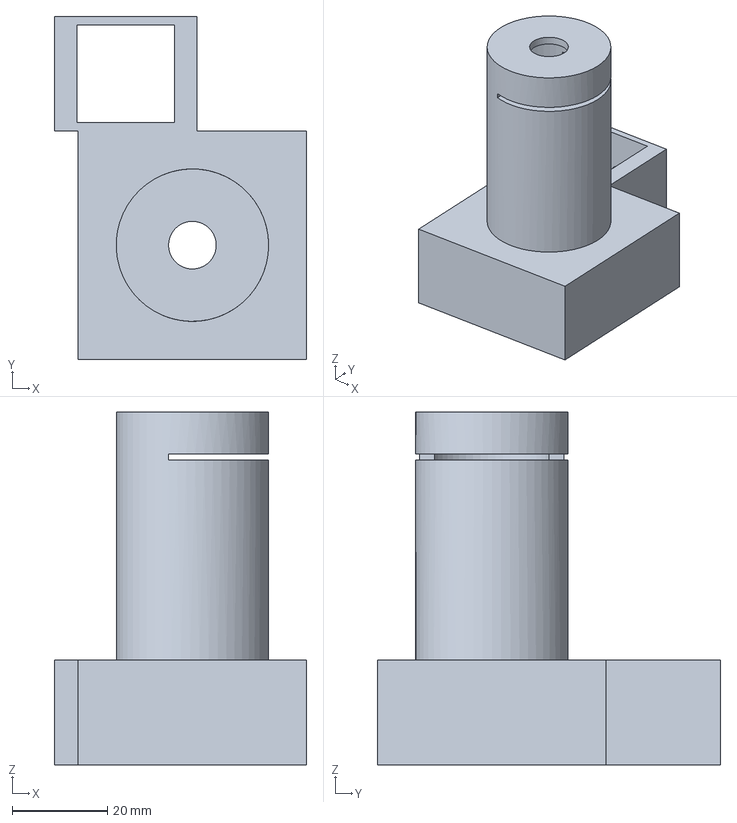
[picture p38: CAD file, 2026-11-14]
phases/06-camera-light/3d/LSR-05a_lamp_tube.step
53.0 x 72.0 x 74.0 mm
