Normansrule/Gonioreflectometer-Open-Source/phases/07-calibrate/3d/CAL-06a_ptfe_holder.step

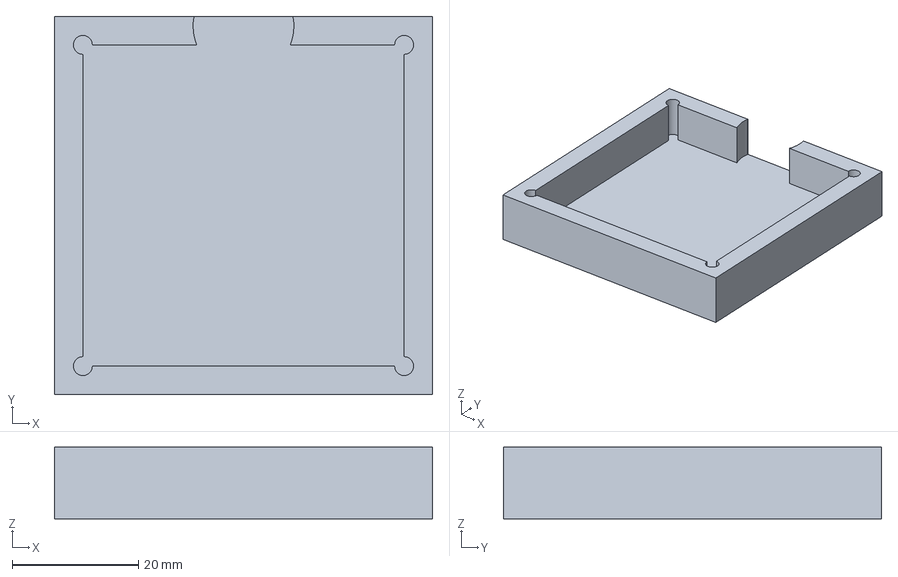
[picture p39: CAD file, 2026-10-21]
phases/07-calibrate/3d/CAL-06a_ptfe_holder.step
60.0 x 60.0 x 11.4 mm
