Normansrule/Gonioreflectometer-Open-Source/phases/08-tilt/3d/TLT-07b_pulley_100T.step

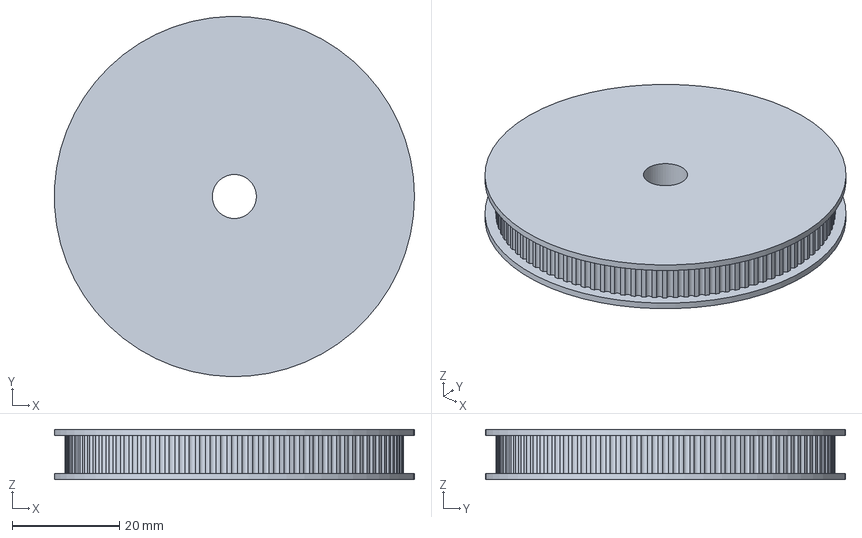
[picture p40: CAD file, 2026-10-21]
phases/08-tilt/3d/TLT-07b_pulley_100T.step
67.1 x 67.1 x 9.40 mm
