Normansrule/Gonioreflectometer-Open-Source/phases/09-spin/3d/SPN-07a_spin_platter.step

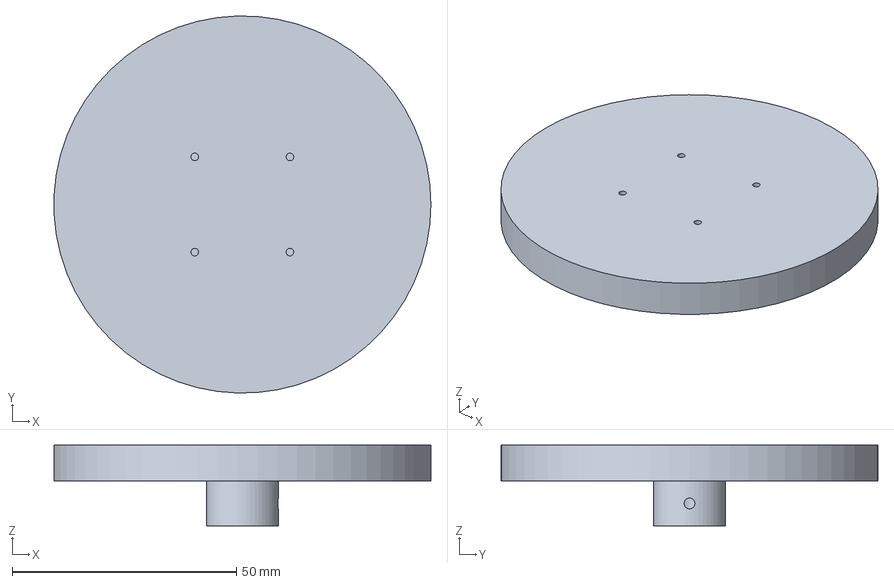
[picture p41: CAD file, 2026-10-21]
phases/09-spin/3d/SPN-07a_spin_platter.step
83.9 x 84.0 x 18.0 mm
