Normansrule/Gonioreflectometer-Open-Source/phases/10-color/3d/SPC-03a_spectral_tube.step

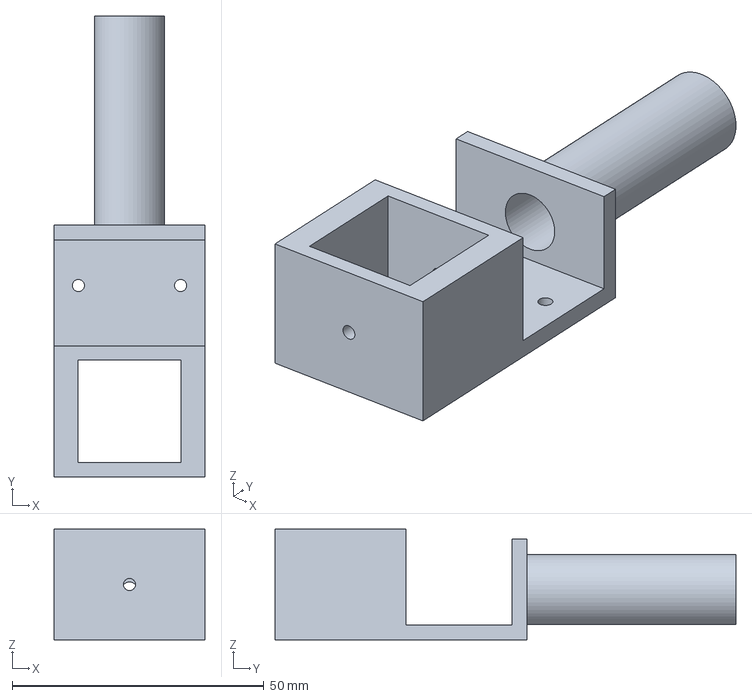
[picture p42: CAD file, 2026-10-21]
phases/10-color/3d/SPC-03a_spectral_tube.step
30.0 x 91.5 x 22.0 mm
