Normansrule/Gonioreflectometer-Open-Source/phases/11-scan-capture/3d/SCN-03a_riser_20.step

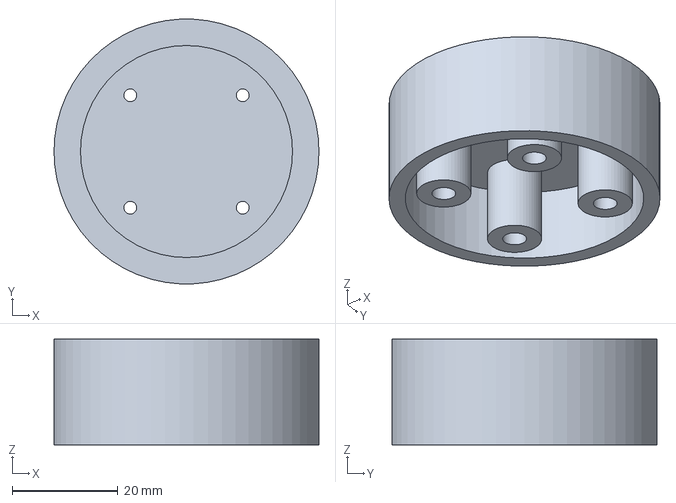
[picture p43: CAD file, 2026-10-21]
phases/11-scan-capture/3d/SCN-03a_riser_20.step
50.0 x 49.9 x 20.0 mm
