Normansrule/Gonioreflectometer-Open-Source/phases/15-standalone/3d/STA-10b_screen_bezel.step

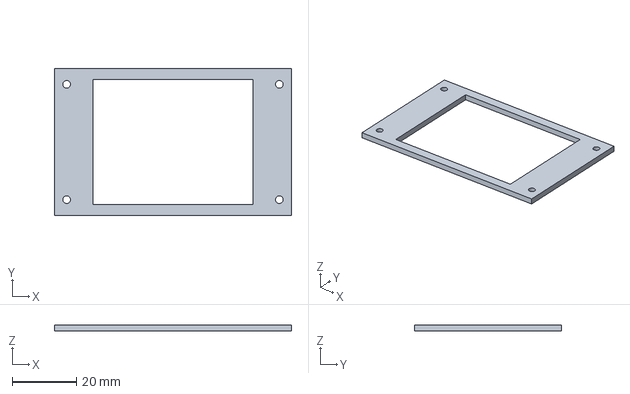
[picture p44: CAD file, 2026-11-14]
phases/15-standalone/3d/STA-10b_screen_bezel.step
74.0 x 46.0 x 2.00 mm
