Normansrule/Gonioreflectometer-Open-Source/cad/open/CTL-06_kicad_JST_XH_B3B_header.step

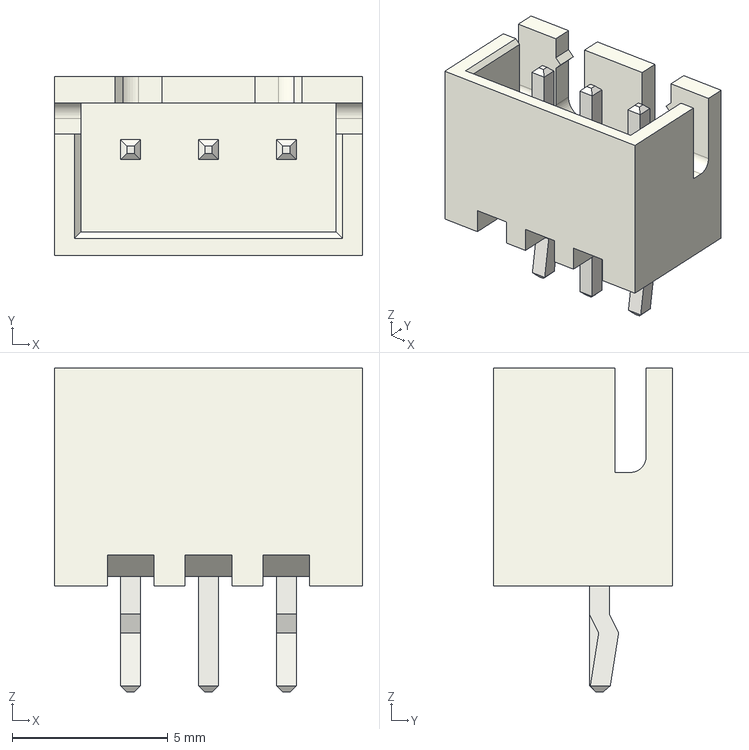
[picture p45: CAD file, 2026-10-10]
cad/open/CTL-06_kicad_JST_XH_B3B_header.step
9.90 x 5.75 x 10.4 mm
