Normansrule/Gonioreflectometer-Open-Source/phases/02-controller/3d/CTL-10a_button_panel.step

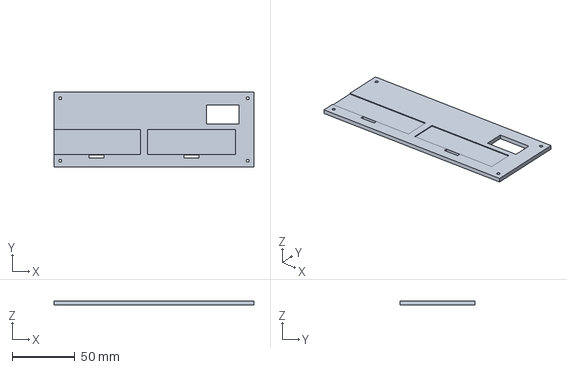
[picture p46: CAD file, 2026-10-21]
phases/02-controller/3d/CTL-10a_button_panel.step
160.0 x 60.0 x 3.00 mm
