Normansrule/Gonioreflectometer-Open-Source/phases/04-light-arm/3d/LAR-08a_rim_segment.step

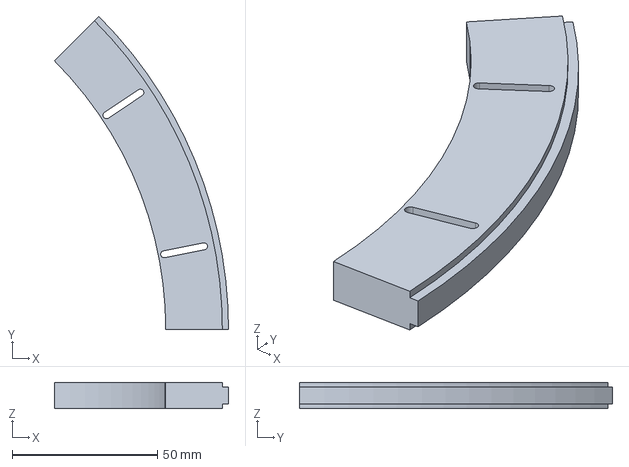
[picture p47: CAD file, 2026-10-21]
phases/04-light-arm/3d/LAR-08a_rim_segment.step
59.9 x 107.8 x 9.00 mm
