Normansrule/Gonioreflectometer-Open-Source/phases/05-table/3d/TBL-07g_endstop_riser.step

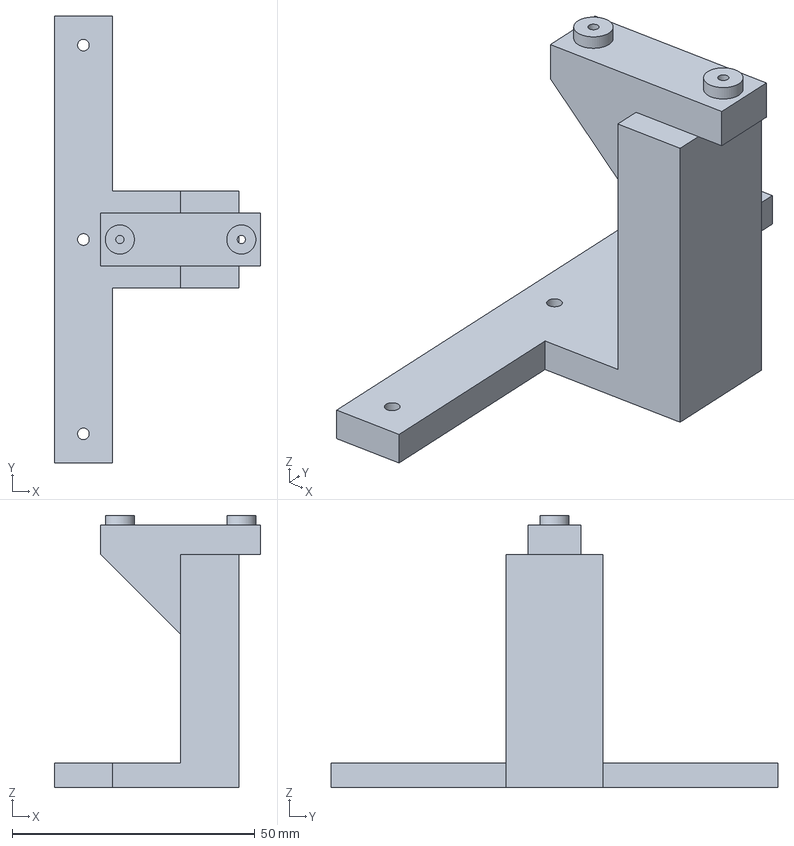
[picture p48: CAD file, 2026-11-03]
phases/05-table/3d/TBL-07g_endstop_riser.step
42.5 x 92.0 x 56.0 mm
