Normansrule/Gonioreflectometer-Open-Source/phases/06-camera-light/3d/LSR-05b_lamp_cap.step

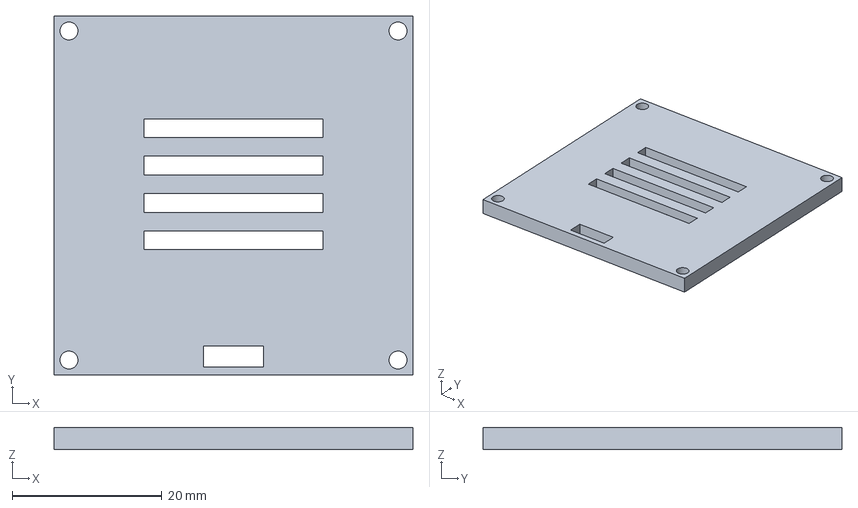
[picture p49: CAD file, 2026-10-21]
phases/06-camera-light/3d/LSR-05b_lamp_cap.step
48.0 x 48.0 x 3.00 mm
