Normansrule/Gonioreflectometer-Open-Source/phases/07-calibrate/3d/CAL-06c_ball_holder.step

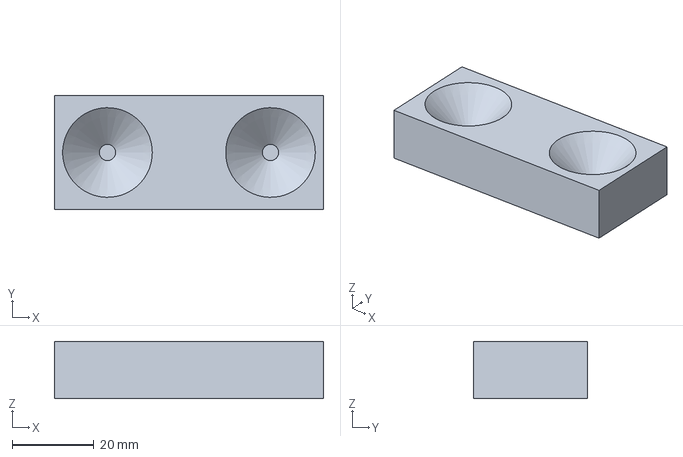
[picture p50: CAD file, 2026-10-21]
phases/07-calibrate/3d/CAL-06c_ball_holder.step
66.0 x 28.0 x 14.0 mm
