Normansrule/Gonioreflectometer-Open-Source/phases/08-tilt/3d/TLT-07c_tilt_cradle.step

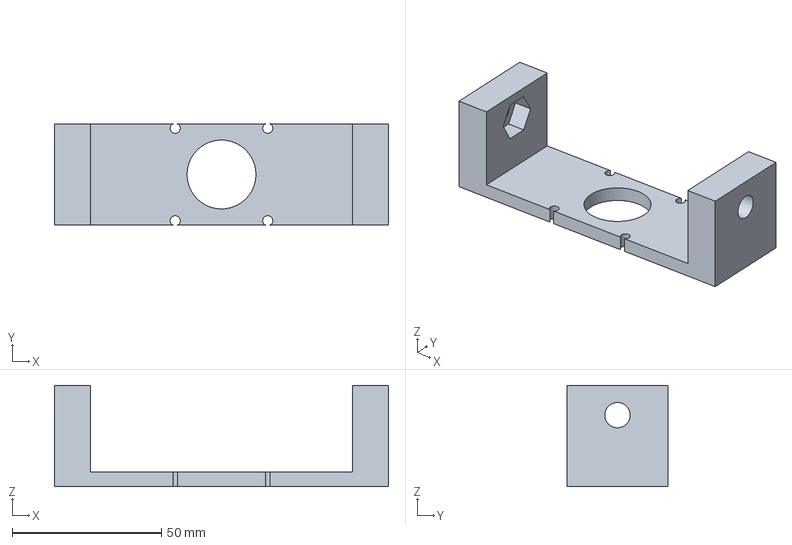
[picture p51: CAD file, 2026-10-21]
phases/08-tilt/3d/TLT-07c_tilt_cradle.step
112.0 x 34.0 x 34.0 mm
