Normansrule/Gonioreflectometer-Open-Source/phases/10-color/3d/MSK-06b_led_mast.step

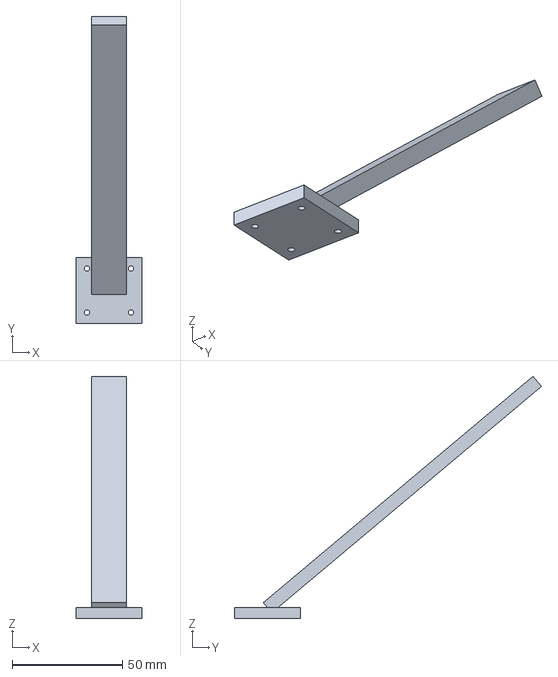
[picture p52: CAD file, 2026-10-21]
phases/10-color/3d/MSK-06b_led_mast.step
30.0 x 139.5 x 110.1 mm
