Normansrule/Gonioreflectometer-Open-Source/phases/11-scan-capture/3d/SCN-03c_riser_60.step

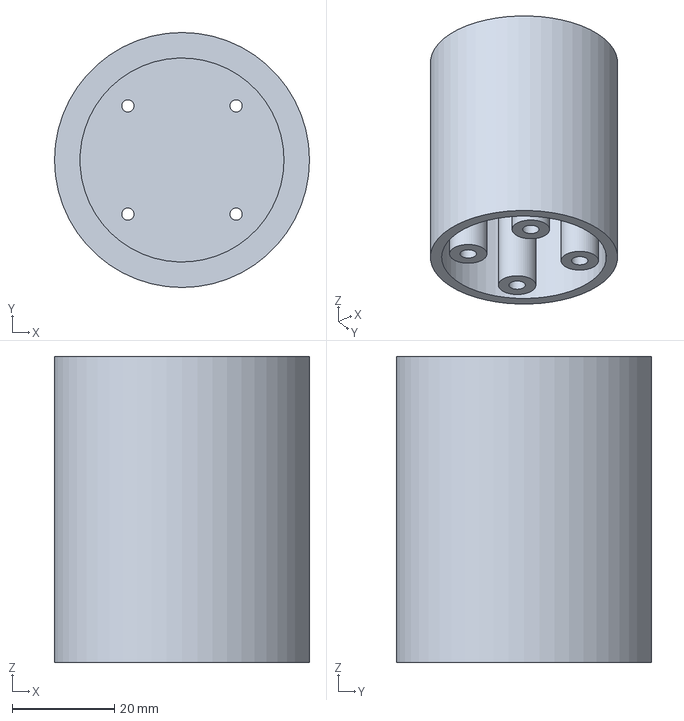
[picture p53: CAD file, 2026-10-21]
phases/11-scan-capture/3d/SCN-03c_riser_60.step
50.0 x 50.0 x 60.0 mm
