Normansrule/Gonioreflectometer-Open-Source/phases/15-standalone/3d/STA-10a_screen_stand.step

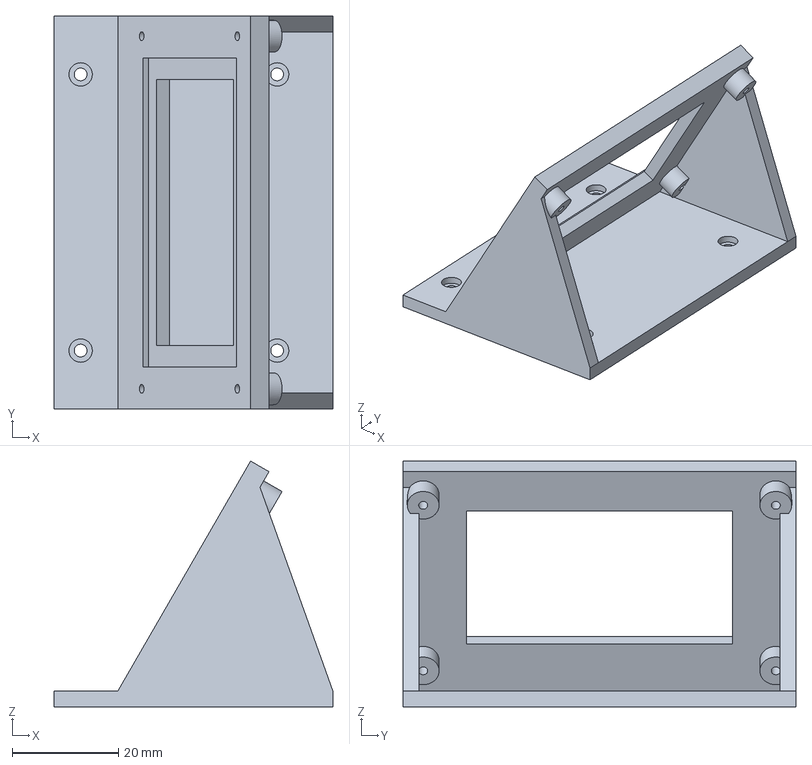
[picture p54: CAD file, 2026-11-14]
phases/15-standalone/3d/STA-10a_screen_stand.step
52.5 x 74.0 x 46.3 mm
