Normansrule/Gonioreflectometer-Open-Source/cad/open/LAR-04_adafruit_1253_gt2_20t_pulley_8mm_bore.step

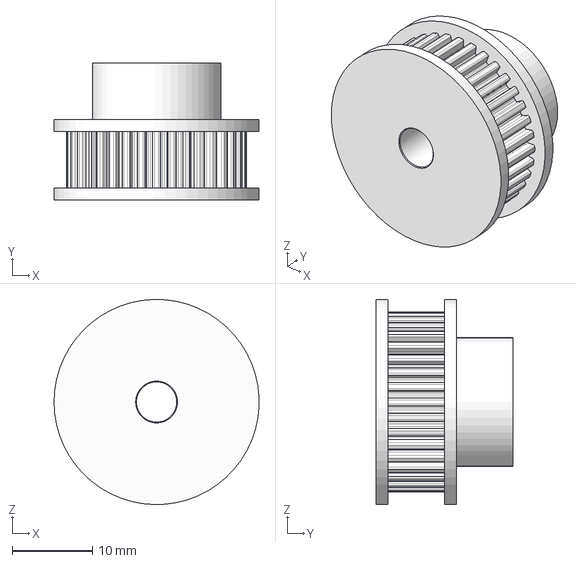
[picture p55: CAD file, 2026-10-10]
cad/open/LAR-04_adafruit_1253_gt2_20t_pulley_8mm_bore.step
25.5 x 17.0 x 25.5 mm
