Normansrule/Gonioreflectometer-Open-Source/phases/04-light-arm/3d/LAR-08c_arm_segment.step

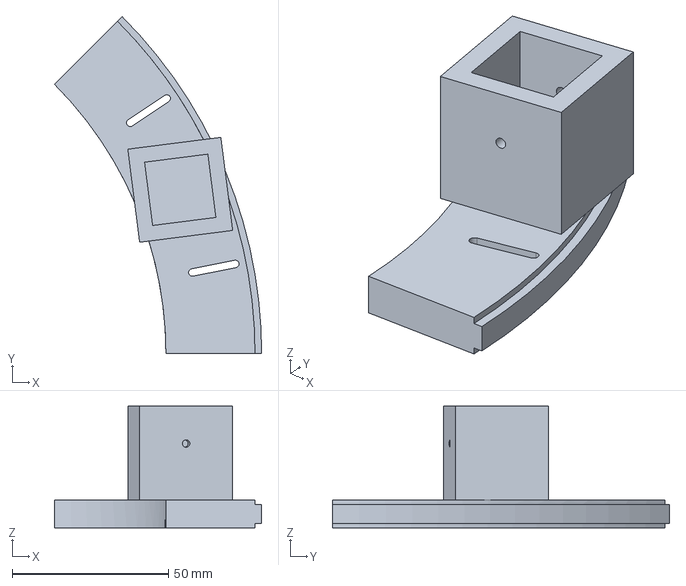
[picture p56: CAD file, 2026-10-21]
phases/04-light-arm/3d/LAR-08c_arm_segment.step
66.3 x 107.8 x 39.0 mm
