Normansrule/Gonioreflectometer-Open-Source/phases/05-table/3d/TBL-07a_table_drum.step

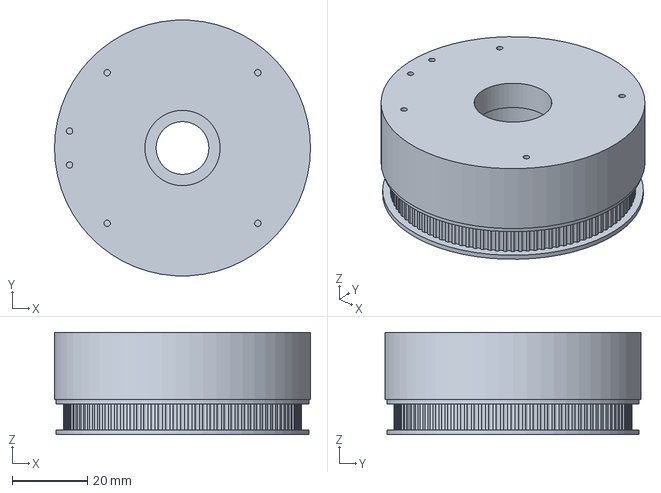
[picture p57: CAD file, 2026-11-03]
phases/05-table/3d/TBL-07a_table_drum.step
68.0 x 67.9 x 27.2 mm
