Normansrule/Gonioreflectometer-Open-Source/phases/06-camera-light/3d/CAM-03a_aperture_stop_f8.step

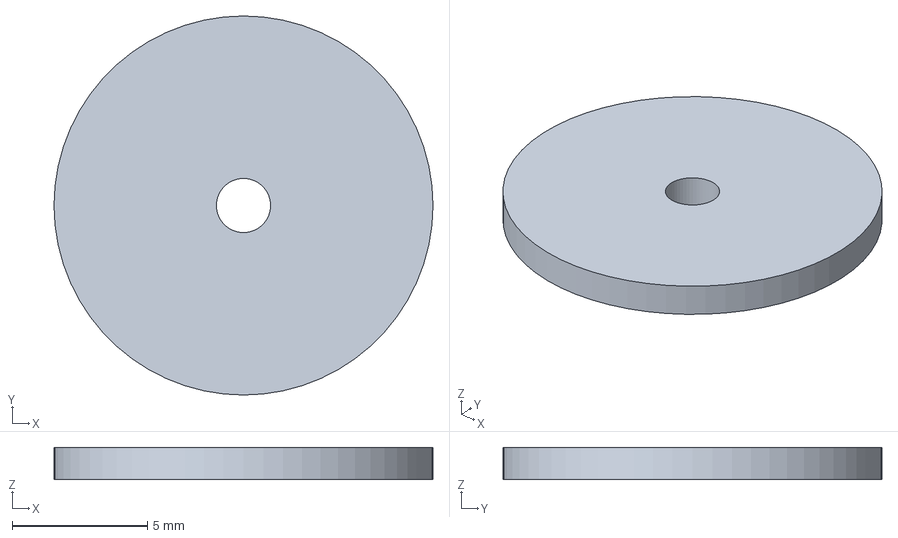
[picture p58: CAD file, 2026-10-21]
phases/06-camera-light/3d/CAM-03a_aperture_stop_f8.step
14.0 x 14.0 x 1.20 mm
