Normansrule/Gonioreflectometer-Open-Source/phases/07-calibrate/3d/ENC-04a_dowel_socket.step

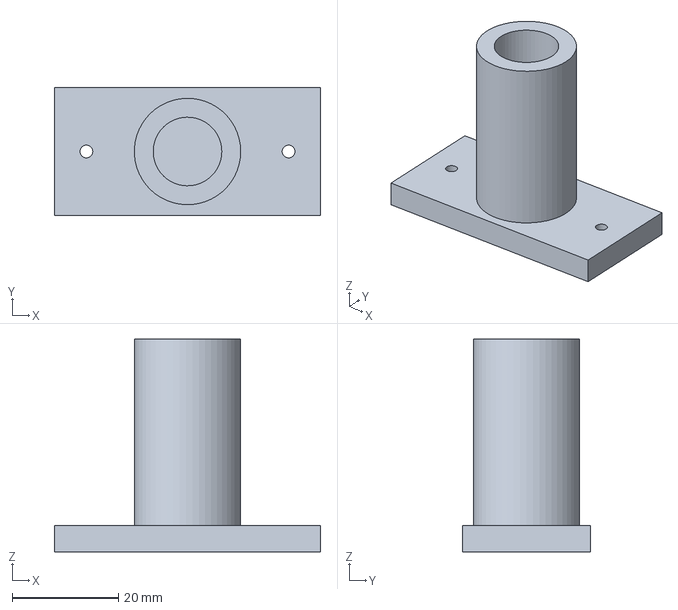
[picture p59: CAD file, 2026-10-21]
phases/07-calibrate/3d/ENC-04a_dowel_socket.step
50.0 x 24.0 x 40.0 mm
