Normansrule/Gonioreflectometer-Open-Source/phases/08-tilt/3d/TLT-07a_tilt_yoke.step

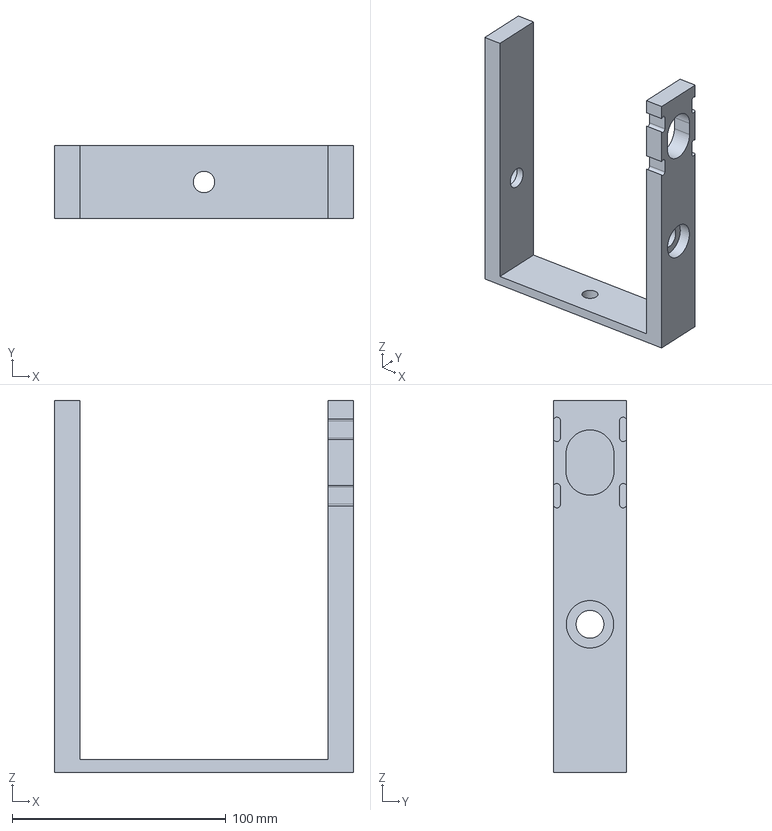
[picture p60: CAD file, 2026-10-21]
phases/08-tilt/3d/TLT-07a_tilt_yoke.step
140.0 x 34.0 x 173.9 mm
