Normansrule/Gonioreflectometer-Open-Source/phases/10-color/3d/MSK-06a_led_ring.step

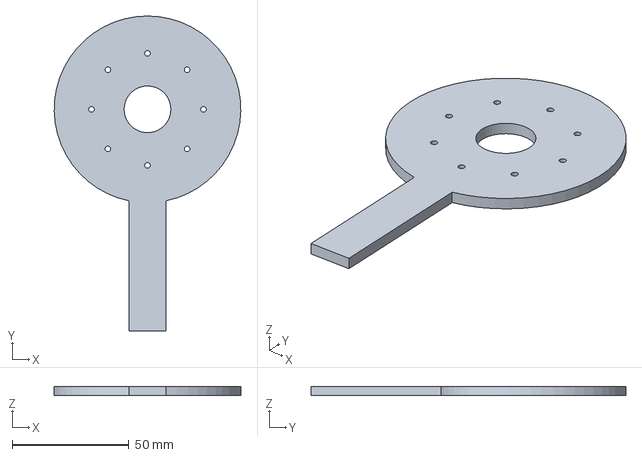
[picture p61: CAD file, 2026-10-21]
phases/10-color/3d/MSK-06a_led_ring.step
80.0 x 135.0 x 4.00 mm
