Normansrule/Gonioreflectometer-Open-Source/phases/11-scan-capture/3d/SCN-03d_scan_camera_plate_15.step

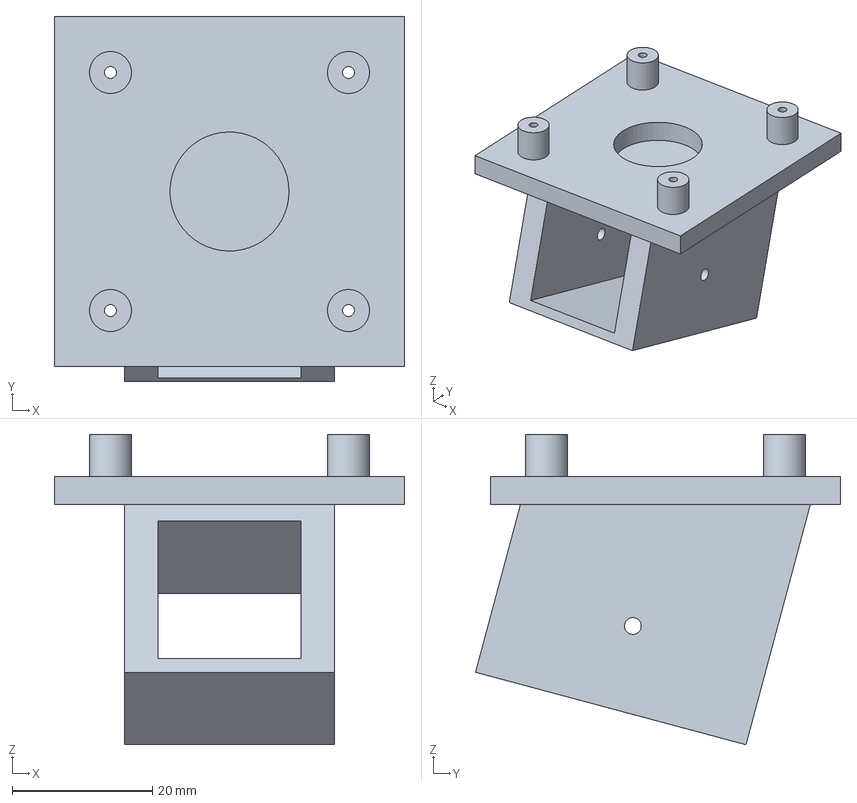
[picture p62: CAD file, 2026-10-21]
phases/11-scan-capture/3d/SCN-03d_scan_camera_plate_15.step
50.0 x 52.1 x 44.3 mm
