Normansrule/Gonioreflectometer-Open-Source/phases/15-standalone/3d/STA-07a_pi_zero_mount.step

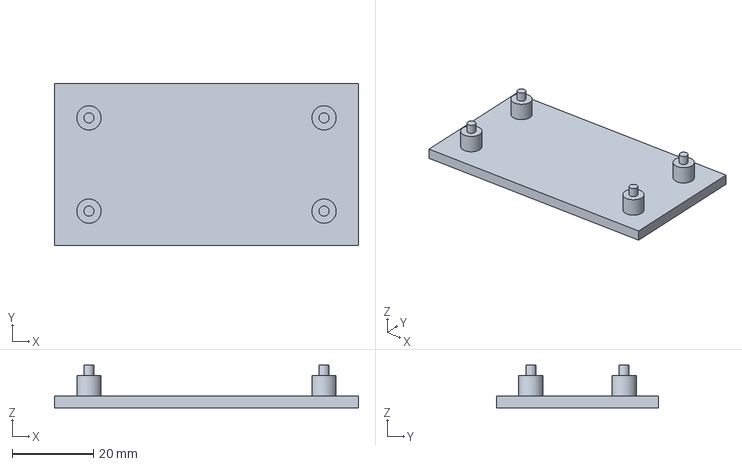
[picture p63: CAD file, 2026-10-21]
phases/15-standalone/3d/STA-07a_pi_zero_mount.step
75.0 x 40.0 x 10.6 mm
