Normansrule/Gonioreflectometer-Open-Source/cad/open/CTL-11_kicad_JST_XH_B4B_header.step

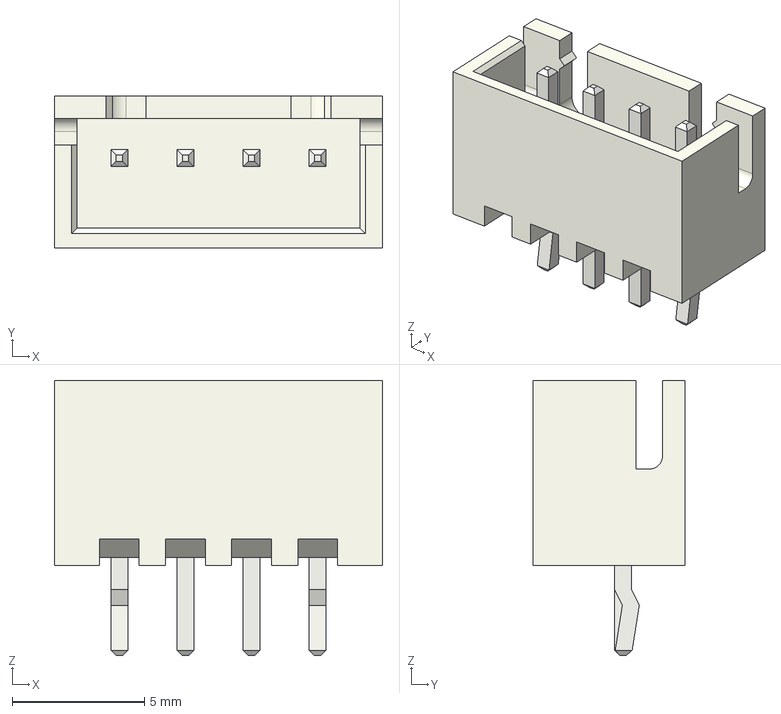
[picture p64: CAD file, 2026-10-10]
cad/open/CTL-11_kicad_JST_XH_B4B_header.step
12.4 x 5.75 x 10.4 mm
