Normansrule/Gonioreflectometer-Open-Source/phases/05-table/3d/TBL-07b_home_flag.step

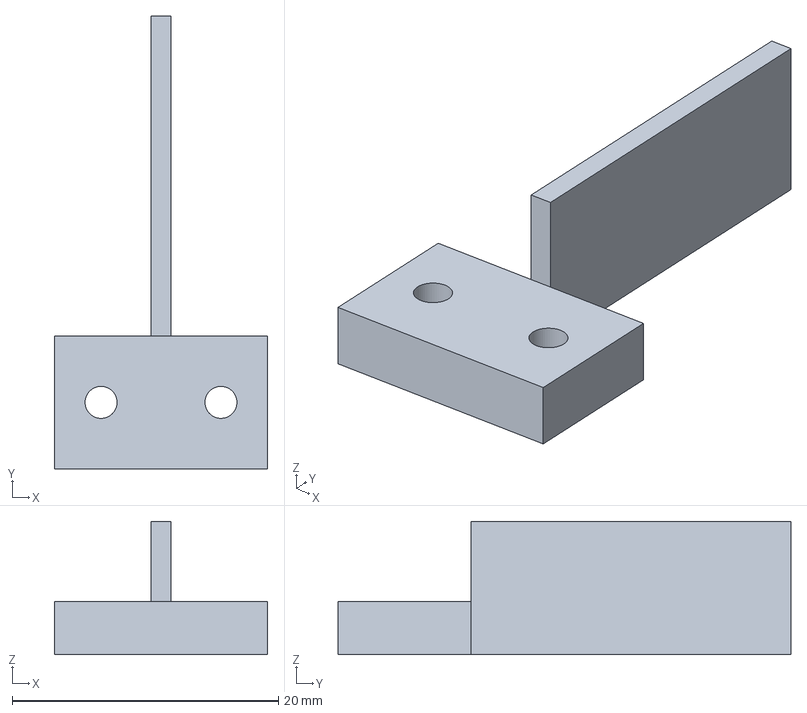
[picture p65: CAD file, 2026-10-21]
phases/05-table/3d/TBL-07b_home_flag.step
16.0 x 34.0 x 10.0 mm
