Normansrule/Gonioreflectometer-Open-Source/phases/06-camera-light/3d/CAM-03b_camera_plate.step

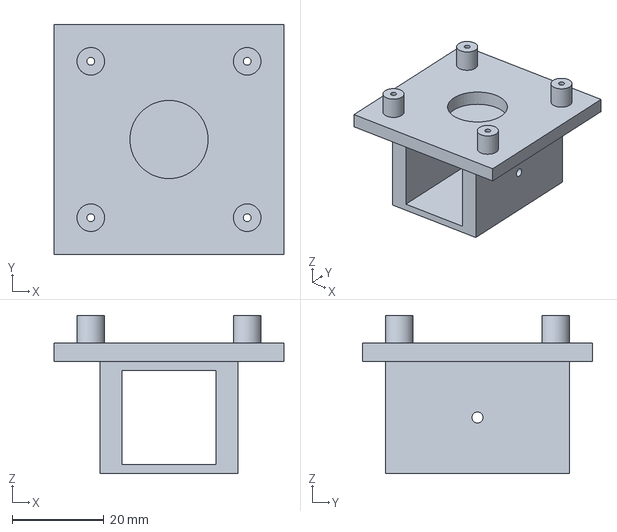
[picture p66: CAD file, 2026-10-21]
phases/06-camera-light/3d/CAM-03b_camera_plate.step
50.0 x 50.0 x 34.4 mm
