Normansrule/Gonioreflectometer-Open-Source/phases/07-calibrate/3d/CAL-06b_mirror_holder.step

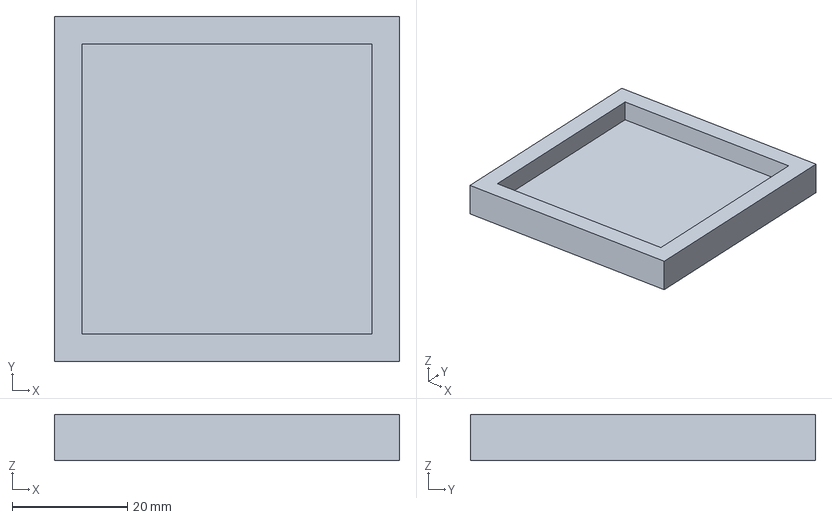
[picture p67: CAD file, 2026-10-21]
phases/07-calibrate/3d/CAL-06b_mirror_holder.step
60.0 x 60.0 x 8.00 mm
