Normansrule/Gonioreflectometer-Open-Source/phases/11-scan-capture/3d/SCN-03b_riser_40.step

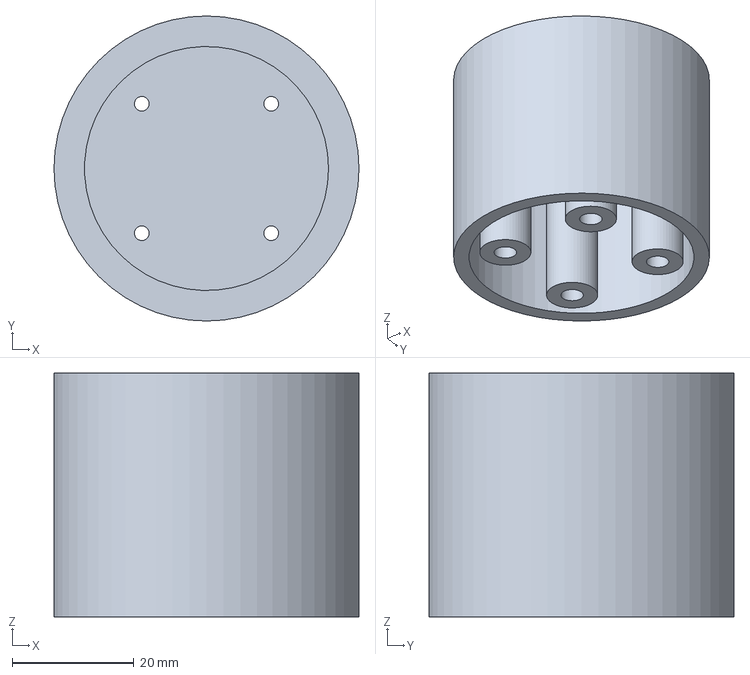
[picture p68: CAD file, 2026-10-21]
phases/11-scan-capture/3d/SCN-03b_riser_40.step
50.0 x 50.0 x 40.0 mm
