Normansrule/Gonioreflectometer-Open-Source/cad/open/SPC-01_adafruit_4698_as7341.step

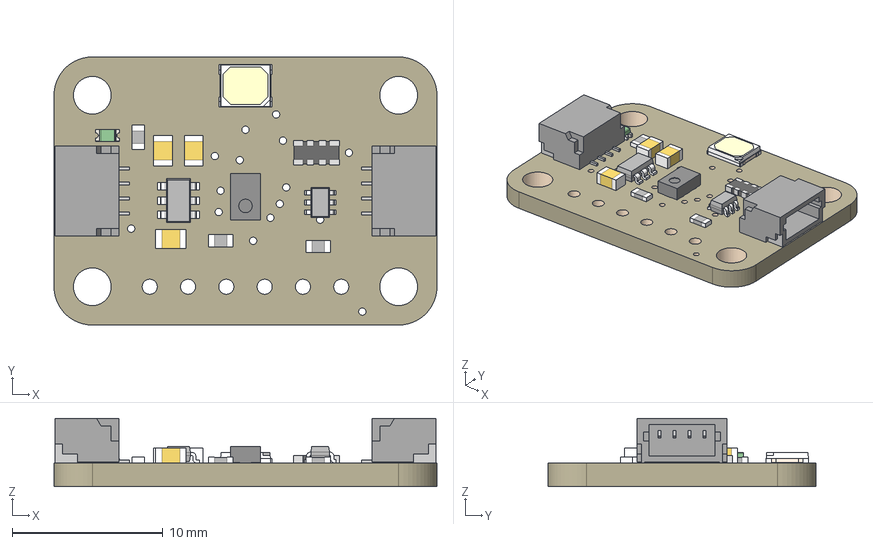
[picture p69: CAD file, 2026-10-10]
cad/open/SPC-01_adafruit_4698_as7341.step
25.4 x 17.8 x 4.53 mm
Board
10uF x 3
10K x 3
10K_1
BSS138
STEMMA_I2C_QT x 2
GREEN
AS7341
EAHC2835WD6
AP7312-3.3/1.8
