Normansrule/Gonioreflectometer-Open-Source/phases/04-light-arm/3d/LAR-08e_cross_clamp.step

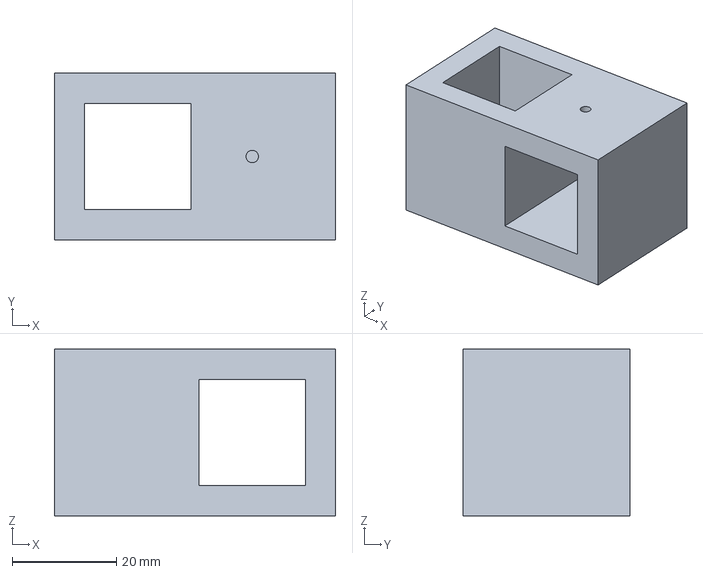
[picture p70: CAD file, 2026-10-21]
phases/04-light-arm/3d/LAR-08e_cross_clamp.step
54.0 x 32.0 x 32.0 mm
