Normansrule/Gonioreflectometer-Open-Source/phases/05-table/3d/TBL-07f_spacers.step

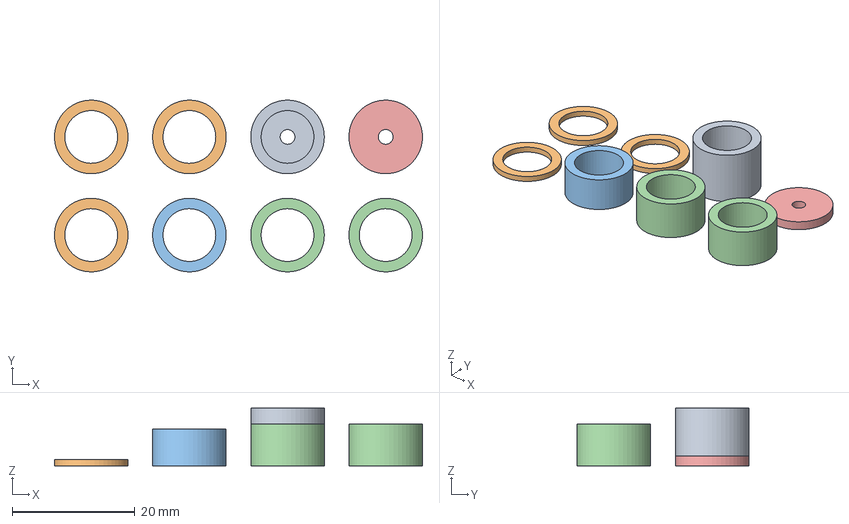
[picture p71: CAD file, 2026-10-21]
phases/05-table/3d/TBL-07f_spacers.step
60.0 x 28.0 x 9.40 mm
