Normansrule/Gonioreflectometer-Open-Source/cad/open/CTL-11_kicad_JST_PH_B6B_header.step

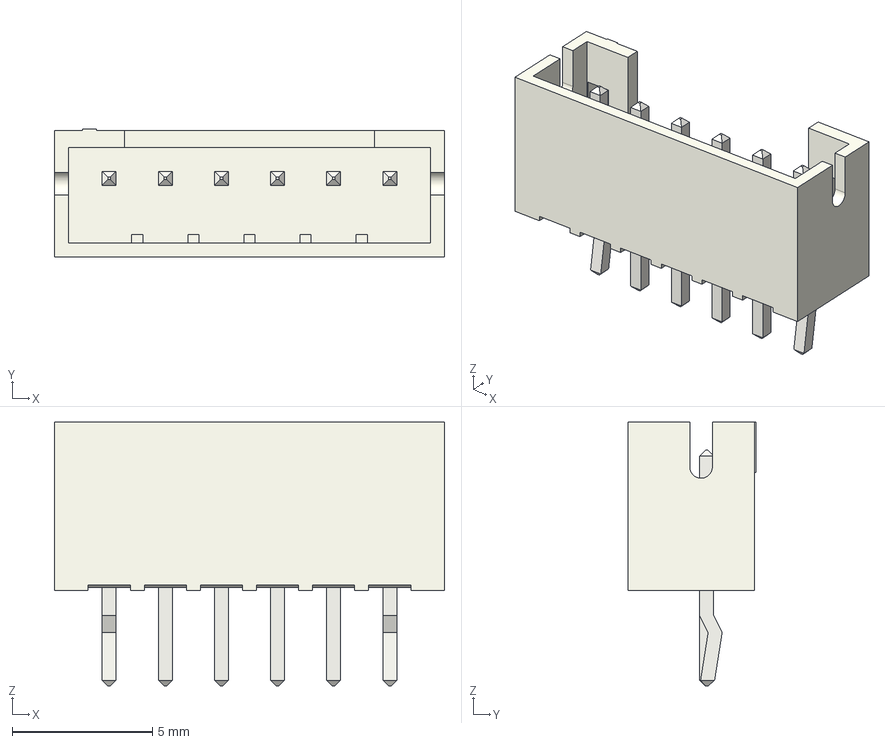
[picture p72: CAD file, 2026-10-10]
cad/open/CTL-11_kicad_JST_PH_B6B_header.step
13.9 x 4.55 x 9.40 mm
