Normansrule/Gonioreflectometer-Open-Source/phases/03-frame/3d/FRM-09c_protractor_segment.step

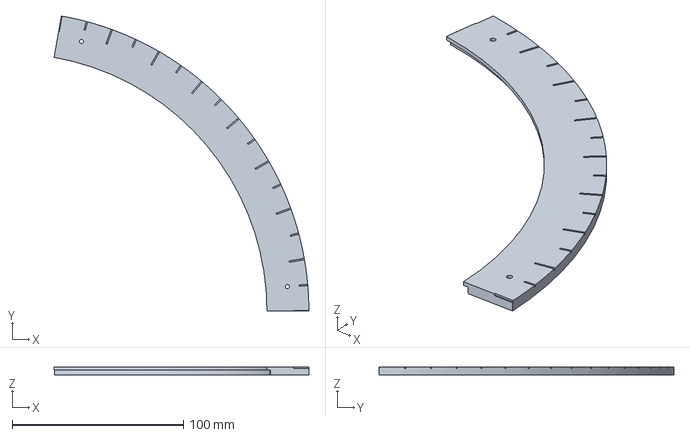
[picture p73: CAD file, 2026-10-21]
phases/03-frame/3d/FRM-09c_protractor_segment.step
148.9 x 172.3 x 4.60 mm
