Normansrule/Gonioreflectometer-Open-Source/phases/04-light-arm/3d/LAR-08b_ring_motor_mount.step

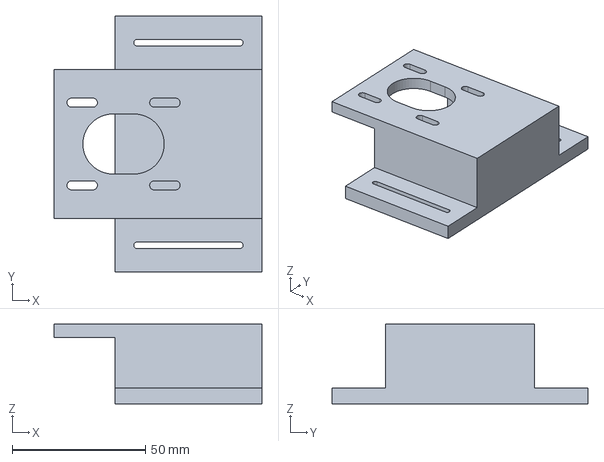
[picture p74: CAD file, 2026-10-21]
phases/04-light-arm/3d/LAR-08b_ring_motor_mount.step
77.8 x 96.0 x 30.0 mm
