Normansrule/Gonioreflectometer-Open-Source/phases/05-table/3d/TBL-07d_table_post.step

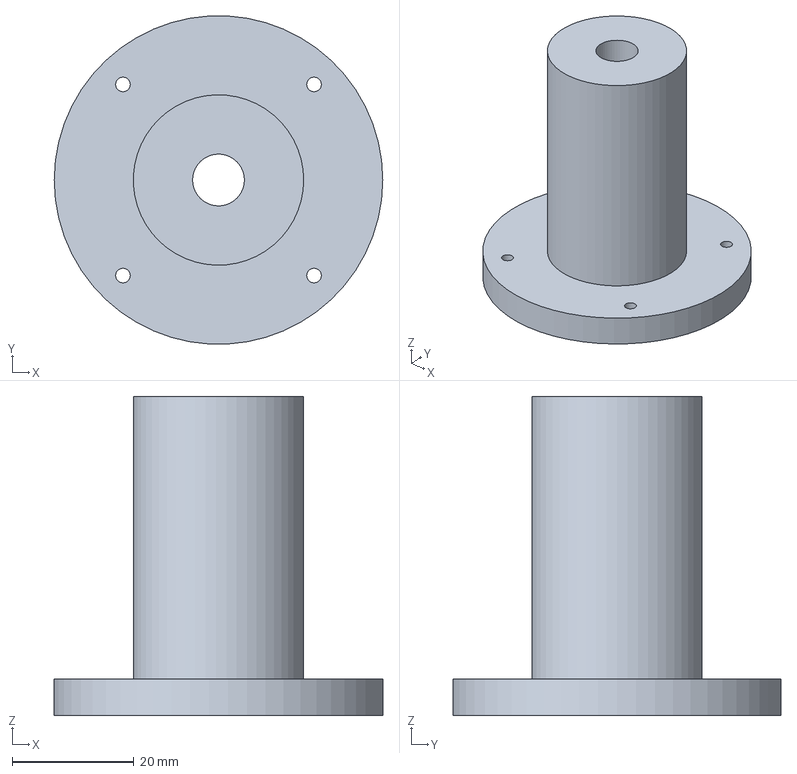
[picture p75: CAD file, 2026-10-21]
phases/05-table/3d/TBL-07d_table_post.step
54.0 x 53.9 x 52.5 mm
