Normansrule/Gonioreflectometer-Open-Source/phases/05-table/3d/TBL-07c_table_motor_bracket.step

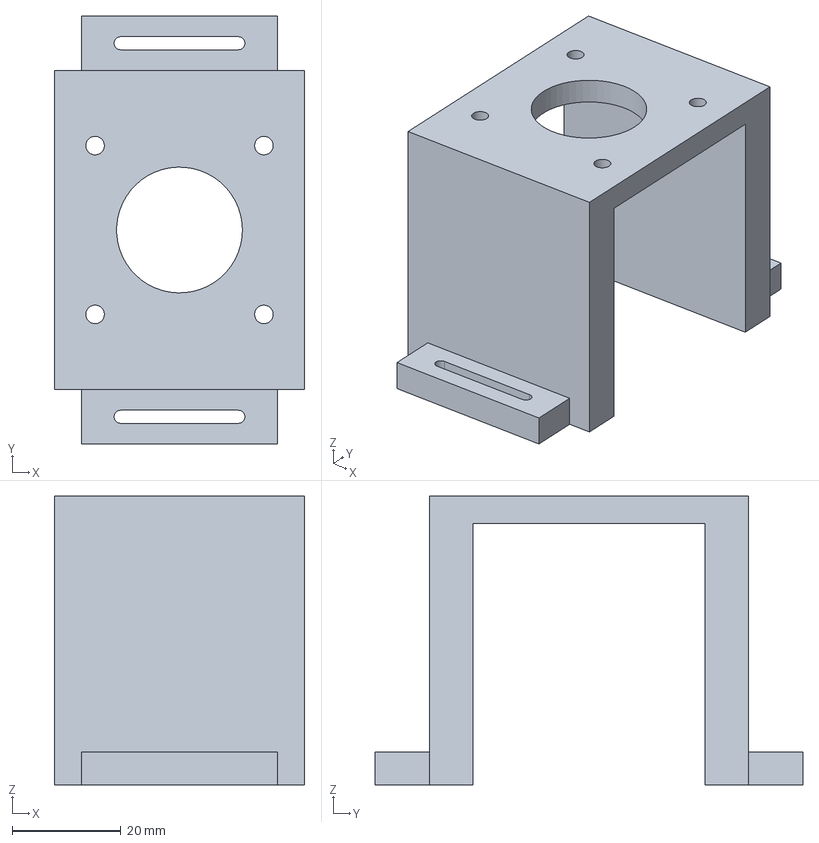
[picture p76: CAD file, 2026-10-21]
phases/05-table/3d/TBL-07c_table_motor_bracket.step
46.0 x 78.6 x 53.0 mm
