Normansrule/Gonioreflectometer-Open-Source/phases/03-frame/3d/FRM-02a_outrigger_bar_1.step

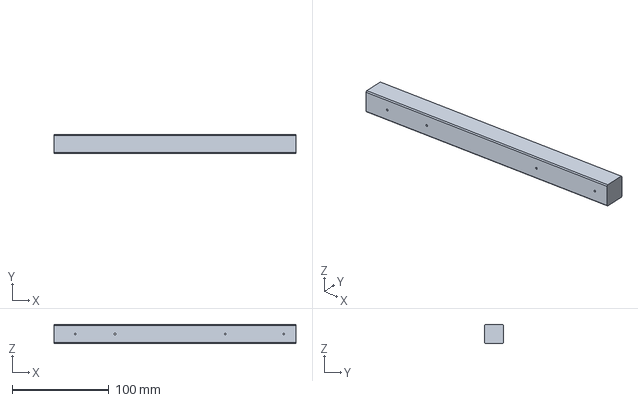
[picture p77: CAD file, 2026-10-21]
phases/03-frame/3d/FRM-02a_outrigger_bar_1.step
250.0 x 20.0 x 20.0 mm
