Normansrule/Gonioreflectometer-Open-Source/phases/03-frame/3d/FRM-02c_scan_post_bar_1.step

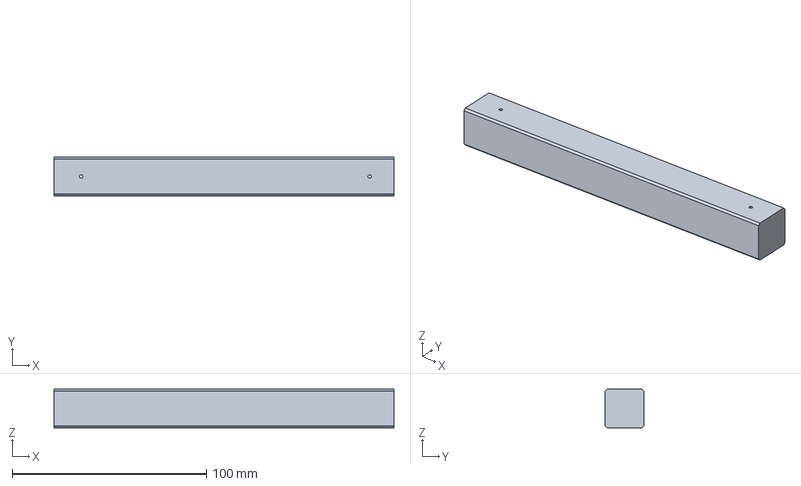
[picture p78: CAD file, 2026-10-21]
phases/03-frame/3d/FRM-02c_scan_post_bar_1.step
175.0 x 20.0 x 20.0 mm
