Normansrule/Gonioreflectometer-Open-Source/phases/03-frame/3d/FRM-09e_post_socket.step

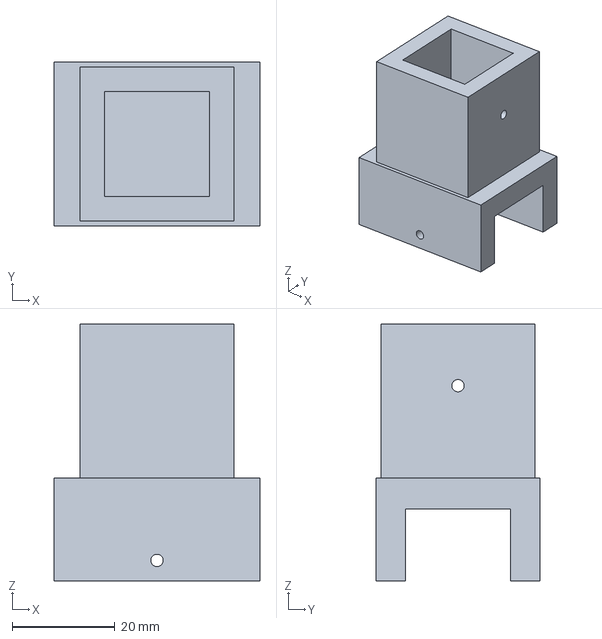
[picture p79: CAD file, 2026-10-21]
phases/03-frame/3d/FRM-09e_post_socket.step
40.0 x 32.0 x 50.0 mm
