Normansrule/Gonioreflectometer-Open-Source/phases/03-frame/3d/FRM-09d_bar_saddle.step

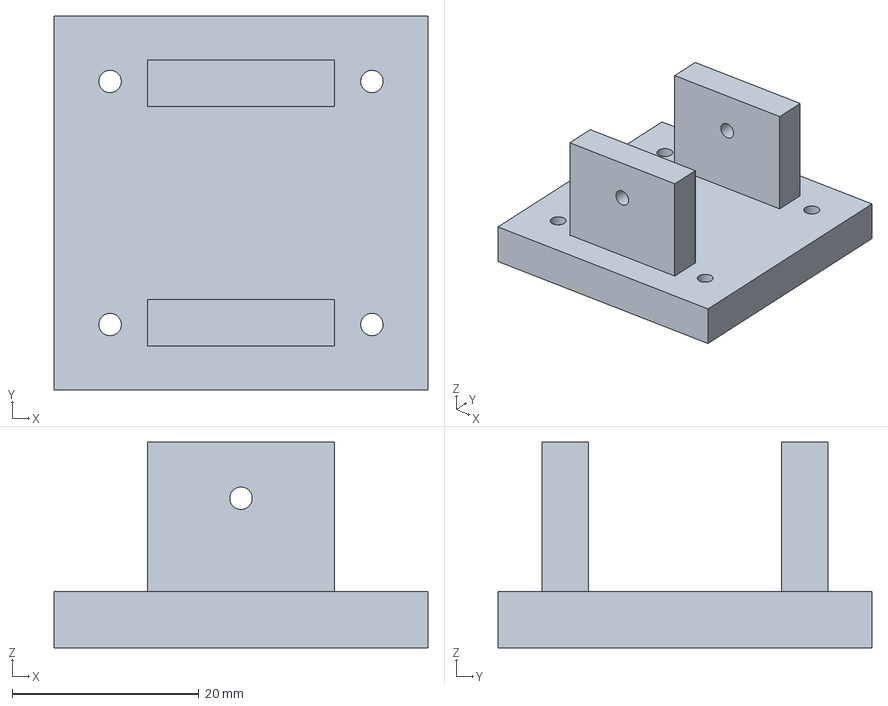
[picture p80: CAD file, 2026-10-21]
phases/03-frame/3d/FRM-09d_bar_saddle.step
40.0 x 40.0 x 22.0 mm
