Normansrule/Gonioreflectometer-Open-Source/phases/03-frame/3d/FRM-09i_bar_coupler.step

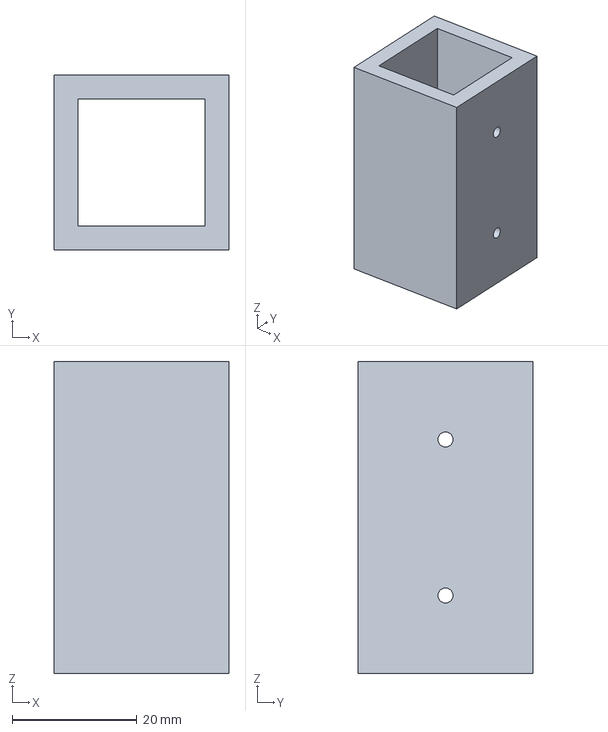
[picture p81: CAD file, 2026-10-21]
phases/03-frame/3d/FRM-09i_bar_coupler.step
28.0 x 28.0 x 50.0 mm
