Normansrule/Gonioreflectometer-Open-Source/phases/03-frame/3d/FRM-09h_camera_pillar.step

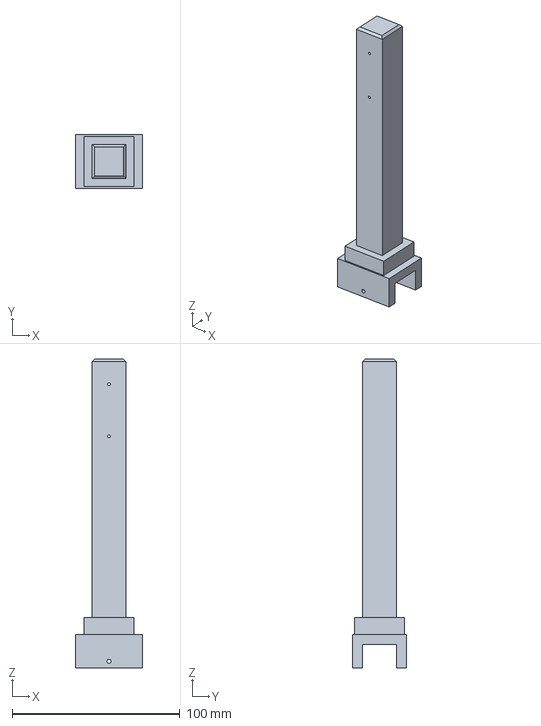
[picture p82: CAD file, 2026-10-21]
phases/03-frame/3d/FRM-09h_camera_pillar.step
40.0 x 32.0 x 184.0 mm
