Normansrule/Gonioreflectometer-Open-Source/phases/03-frame/3d/FRM-09f_end_foot.step

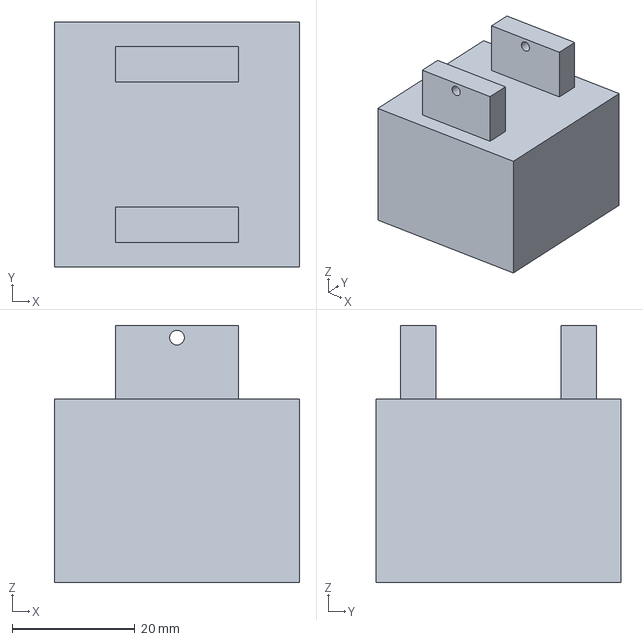
[picture p83: CAD file, 2026-10-21]
phases/03-frame/3d/FRM-09f_end_foot.step
40.0 x 40.0 x 42.0 mm
