Normansrule/Gonioreflectometer-Open-Source/(list of files, cad)

Other CAD files:
phases/03-frame/3d/FRM-01d_deck_tile_W.step
phases/03-frame/3d/FRM-01e_deck_tile_C.step
phases/03-frame/3d/FRM-01i_deck_tile_NE.step
phases/04-light-arm/3d/LAR-08f_upright_bar.step
phases/03-frame/3d/FRM-01f_deck_tile_E.step
phases/03-frame/3d/FRM-01b_deck_tile_S.step
phases/03-frame/3d/FRM-01c_deck_tile_SE.step
phases/03-frame/3d/FRM-01h_deck_tile_N.step
phases/03-frame/3d/FRM-02d_scan_post_bar_2.step
phases/03-frame/3d/FRM-01a_deck_tile_SW.step
phases/03-frame/3d/FRM-02b_outrigger_bar_2.step
cad/bought/CAL-01_ptfe_tile_50mm_3x3mm.step
cad/bought/CAL-01_ptfe_tile_50mm_3x3mm.stl
cad/bought/CAL-02_mirror_tile_50mm.step
cad/bought/CAL-02_mirror_tile_50mm.stl
cad/bought/CAL-03_chrome_ball_1in.step
cad/bought/CAL-03_chrome_ball_1in.stl
cad/bought/CAL-04_charuco_glass_4x6in.step
cad/bought/CAL-04_charuco_glass_4x6in.stl
cad/bought/CAL-05_colorchecker_mini.step
cad/bought/CAL-05_colorchecker_mini.stl
cad/bought/CAL-07_grey_card_8x10in.step
cad/bought/CAL-07_grey_card_8x10in.stl
cad/bought/CAM-01_arducam_b0433_imx477_usb.step
cad/bought/CAM-01_arducam_b0433_imx477_usb.stl
cad/bought/CAM-02_m12_lens_16mm.step
cad/bought/CAM-02_m12_lens_16mm.stl
cad/bought/CTL-01_btt_skr_pico_envelope.step
cad/bought/CTL-01_btt_skr_pico_envelope.stl
cad/bought/CTL-02_esp32s3_devkitc1.step
cad/bought/CTL-02_esp32s3_devkitc1.stl
cad/bought/CTL-03_usb_cable_e4.step
cad/bought/CTL-03_usb_cable_e4.stl
cad/bought/CTL-05_membrane_keypad_1x4.step
cad/bought/CTL-05_membrane_keypad_1x4.stl
cad/bought/CTL-06_jst_xh_lead_3pin.step
cad/bought/CTL-06_jst_xh_lead_3pin.stl
cad/bought/CTL-07_jumper_wire_mf.step
cad/bought/CTL-07_jumper_wire_mf.stl
cad/bought/CTL-08_fan_40mm.step
cad/bought/CTL-08_fan_40mm.stl
cad/bought/CTL-11_stepper_cable_ph_xh.step
cad/bought/CTL-11_stepper_cable_ph_xh.stl
cad/bought/ENC-01_blackout_fabric_2yd.step
cad/bought/ENC-01_blackout_fabric_2yd.stl
cad/bought/ENC-02_felt_9x12in.step
cad/bought/ENC-02_felt_9x12in.stl
cad/bought/ENC-03_dowel_half_in_36in.step
cad/bought/ENC-03_dowel_half_in_36in.stl
cad/bought/ENC-05_flock_sheet.step
cad/bought/ENC-05_flock_sheet.stl
cad/bought/FRM-06_screws_m2_samples.step
cad/bought/FRM-06_screws_m2_samples.stl
cad/bought/FRM-07_screw_m3x8.step
cad/bought/FRM-07_screw_m3x8.stl
cad/bought/FRM-08_bearing_608_2rs.step
cad/bought/FRM-08_bearing_608_2rs.stl
cad/bought/LAR-01_lazy_susan_12in.step
cad/bought/LAR-01_lazy_susan_12in.stl
cad/bought/LAR-02_nema17_17hs4401.step
cad/bought/LAR-02_nema17_17hs4401.stl
cad/bought/LAR-03_gt2_belt_open_1m.step
cad/bought/LAR-03_gt2_belt_open_1m.stl
cad/bought/LAR-04_gt2_pulley_20t_5mm.step
cad/bought/LAR-04_gt2_pulley_20t_5mm.stl
cad/bought/LAR-05_tcst2103_endstop_module.step
cad/bought/LAR-05_tcst2103_endstop_module.stl
cad/bought/LAR-06_limit_switch_sealed_prewired.step
cad/bought/LAR-06_limit_switch_sealed_prewired.stl
cad/bought/LSR-01_citizen_clu701_cob.step
cad/bought/LSR-01_citizen_clu701_cob.stl
cad/bought/LSR-01_citizen_clu7a3_cob.step
cad/bought/LSR-02_meanwell_nldd_350hw.step
cad/bought/LSR-02_meanwell_nldd_350hw.stl
cad/bought/LSR-03_wakefield_910_40_2_12_2_b0.step
cad/bought/LSR-03_wakefield_910_40_2_12_2_b0.stl
cad/bought/LSR-04_thermal_pad_40x40.step
cad/bought/LSR-04_thermal_pad_40x40.stl
cad/bought/LSR-06_te_lumawise_z35_2213678_5.step
cad/bought/LSR-06_te_lumawise_z35_2213678_5.stl
cad/bought/MSK-01_star_led_20mm.step
cad/bought/MSK-01_star_led_20mm.stl
cad/bought/MSK-02_meanwell_nldd_350h.step
cad/bought/MSK-02_meanwell_nldd_350h.stl
cad/bought/MSK-03_mosfet_module_4ch.step
cad/bought/MSK-03_mosfet_module_4ch.stl
cad/bought/MSK-05_polarizer_film_100mm.step
cad/bought/MSK-05_polarizer_film_100mm.stl
cad/bought/PWR-10_pc817_opto_module_24v.step
cad/bought/PWR-10_pc817_opto_module_24v.stl
cad/bought/PWR-15_wire_18awg_pair.step
cad/bought/PWR-15_wire_18awg_pair.stl
cad/bought/PWR-20_wago_221_assortment_12.step
cad/bought/PWR-20_wago_221_assortment_12.stl
cad/bought/PWR-21_battery_6s_24v_5ah.step
cad/bought/PWR-28_estop_22mm_1no1nc.step
cad/bought/PWR-28_estop_station_1no1nc.step
cad/bought/PWR-28_estop_station_1no1nc.stl
cad/bought/PWR-30_dc_jack_screw_terminal.step
cad/bought/PWR-30_dc_jack_screw_terminal.stl
cad/bought/SCN-01_mounting_putty_blob.step
cad/bought/SCN-01_mounting_putty_blob.stl
cad/bought/SCN-02_charuco_mat_print.step
cad/bought/SCN-02_charuco_mat_print.stl
cad/bought/SPC-02_jst_sh_cable.step
cad/bought/SPC-02_jst_sh_cable.stl
cad/bought/SPN-01_nema17_17hs08_1004s_pancake.step
cad/bought/SPN-01_nema17_17hs08_1004s_pancake.stl
cad/bought/STA-01_pi_zero_2wh.step
cad/bought/STA-01_pi_zero_2wh.stl
cad/bought/STA-02_microsd_card.step
cad/bought/STA-02_microsd_card.stl
cad/bought/STA-03_buck_lm2596_display.step
cad/bought/STA-03_buck_lm2596_display.stl
cad/bought/STA-04_otg_adapter.step
cad/bought/STA-04_otg_adapter.stl
cad/bought/STA-05_ssd1306_oled_096in.step
cad/bought/STA-05_ssd1306_oled_096in.stl
cad/bought/STA-06_jumper_wire_ff.step
cad/bought/STA-06_jumper_wire_ff.stl
cad/bought/STA-08_usb_cable_micro_b.step
cad/bought/STA-08_usb_cable_micro_b.stl
cad/bought/STA-09_waveshare_2in_lcd.step
cad/bought/STA-09_waveshare_2in_lcd.stl
cad/bought/TBL-02_gt2_belt_232_loop.step
cad/bought/TBL-02_gt2_belt_232_loop.stl
cad/bought/TBL-05_bolt_m8x75_nut.step
cad/bought/TBL-05_bolt_m8x75_nut.stl
cad/bought/TLT-02_gt2_belt_280_loop.step
cad/bought/TLT-02_gt2_belt_280_loop.stl
cad/bought/TLT-05_bolt_m8x35_nut.step
cad/bought/TLT-05_bolt_m8x35_nut.stl
phases/00-plan/3d/PLAN-01_tolerance_coupon.stl
phases/01-power/3d/PWR-18_power_plate.stl
phases/02-controller/3d/CTL-10a_button_panel.stl
phases/02-controller/3d/CTL-10b_controller_tray.stl
phases/03-frame/3d/FRM-01a_deck_tile_SW.stl
phases/03-frame/3d/FRM-01b_deck_tile_S.stl
phases/03-frame/3d/FRM-01c_deck_tile_SE.stl
phases/03-frame/3d/FRM-01d_deck_tile_W.stl
phases/03-frame/3d/FRM-01e_deck_tile_C.stl
phases/03-frame/3d/FRM-01f_deck_tile_E.stl
phases/03-frame/3d/FRM-01g_deck_tile_NW.stl
phases/03-frame/3d/FRM-01h_deck_tile_N.stl
phases/03-frame/3d/FRM-01i_deck_tile_NE.stl
phases/03-frame/3d/FRM-02a_outrigger_bar_1.stl
phases/03-frame/3d/FRM-02b_outrigger_bar_2.stl
phases/03-frame/3d/FRM-02c_scan_post_bar_1.stl
phases/03-frame/3d/FRM-02d_scan_post_bar_2.stl
phases/03-frame/3d/FRM-09c_protractor_segment.stl
phases/03-frame/3d/FRM-09d_bar_saddle.stl
phases/03-frame/3d/FRM-09e_post_socket.stl
phases/03-frame/3d/FRM-09f_end_foot.stl
phases/03-frame/3d/FRM-09h_camera_pillar.stl
phases/03-frame/3d/FRM-09i_bar_coupler.stl
phases/04-light-arm/3d/LAR-08a_rim_segment.stl
phases/04-light-arm/3d/LAR-08b_ring_motor_mount.stl
phases/04-light-arm/3d/LAR-08c_arm_segment.stl
phases/04-light-arm/3d/LAR-08e_cross_clamp.stl
phases/04-light-arm/3d/LAR-08f_upright_bar.stl
phases/04-light-arm/3d/LAR-08g_arm_bar.stl
phases/05-table/3d/TBL-07a_table_drum.stl
phases/05-table/3d/TBL-07b_home_flag.stl
phases/05-table/3d/TBL-07c_table_motor_bracket.stl
phases/05-table/3d/TBL-07d_table_post.stl
phases/05-table/3d/TBL-07f_spacers.stl
phases/05-table/3d/TBL-07g_endstop_riser.stl
phases/05-table/3d/TBL-07h_table_flag.stl
phases/06-camera-light/3d/CAM-03a_aperture_stop_f8.stl
phases/06-camera-light/3d/CAM-03b_camera_plate.stl
phases/06-camera-light/3d/LSR-05a_lamp_tube.stl
phases/06-camera-light/3d/LSR-05b_lamp_cap.stl
phases/07-calibrate/3d/CAL-06a_ptfe_holder.stl
phases/07-calibrate/3d/CAL-06b_mirror_holder.stl
phases/07-calibrate/3d/CAL-06c_ball_holder.stl
phases/07-calibrate/3d/ENC-04a_dowel_socket.stl
phases/08-tilt/3d/TLT-07a_tilt_yoke.stl
phases/08-tilt/3d/TLT-07b_pulley_100T.stl
phases/08-tilt/3d/TLT-07c_tilt_cradle.stl
phases/09-spin/3d/SPN-07a_spin_platter.stl
phases/10-color/3d/MSK-06a_led_ring.stl
phases/10-color/3d/MSK-06b_led_mast.stl
phases/10-color/3d/SPC-03a_spectral_tube.stl
phases/11-scan-capture/3d/SCN-03a_riser_20.stl
phases/11-scan-capture/3d/SCN-03b_riser_40.stl
phases/11-scan-capture/3d/SCN-03c_riser_60.stl
phases/11-scan-capture/3d/SCN-03d_scan_camera_plate_15.stl
phases/15-standalone/3d/STA-07a_pi_zero_mount.stl
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
