Normansrule/Gonioreflectometer-Open-Source/cad/PRINT.md

# Print list (black ABS)

<!-- generated by tools/cad/printability.py - do not edit by hand -->

Enclosed printer, nozzle 245–255 °C, bed 100–105 °C, fan ≤ 20 %, 0.2 mm layers, 4 walls, 25 % gyroid, brim on tall or long parts, door shut until cool; XY shrink compensation from the tolerance coupon (M03.3). Print in the orientation of the STL (flat face down). Filament is an estimate (±25 %): the slicer has the real number.

**Core machine: ≈ 2666 g of ABS** (67 % of the 4 kg FIL-01 supply; ±25 %, plus any reprints) · optional add-ons (stages 10, 15, CAL-06c, ENC-04a): ≈ 131 g · minimum build volume 220 × 220 × 200 mm (largest part: FRM-09h, 184 mm tall).

| Stage | ID | Part | Print | Size x × y × z (mm) | ≈ g each | ≈ g total | Fits |
|---|---|---|---:|---|---:|---:|---|
| 00-plan | PLAN-01 | [Fit test: M2 self-tap holes + 608 pockets](../phases/00-plan/3d/PLAN-01_tolerance_coupon.stl) | 1 | 100 × 60 × 8 | 26 | 26 | yes |
| 01-power | PWR-18 | [Power plate (jack + e-stop box)](../phases/01-power/3d/PWR-18_power_plate.stl) | 1 | 130 × 110 × 12 | 46 | 46 | yes |
| 02-controller | CTL-10a | [Keypad panel + OLED window](../phases/02-controller/3d/CTL-10a_button_panel.stl) | 1 | 160 × 60 × 3 | 26 | 26 | yes |
| 02-controller | CTL-10b | [Controller tray (SKR Pico + ESP32-S3 + opto + LED driver)](../phases/02-controller/3d/CTL-10b_controller_tray.stl) | 1 | 200 × 130 × 15 | 79 | 79 | yes |
| 03-frame | FRM-01a | [Deck tile SW (x -300..-100, y -300..-100)](../phases/03-frame/3d/FRM-01a_deck_tile_SW.stl) | 1 | 200 × 200 × 24 | 158 | 158 | yes |
| 03-frame | FRM-01b | [Deck tile S (x -100..100, y -300..-100)](../phases/03-frame/3d/FRM-01b_deck_tile_S.stl) | 1 | 200 × 200 × 24 | 158 | 158 | yes |
| 03-frame | FRM-01c | [Deck tile SE: power plate (x 100..300, y -300..-100)](../phases/03-frame/3d/FRM-01c_deck_tile_SE.stl) | 1 | 200 × 200 × 24 | 159 | 159 | yes |
| 03-frame | FRM-01d | [Deck tile W (x -300..-100, y -100..100)](../phases/03-frame/3d/FRM-01d_deck_tile_W.stl) | 1 | 200 × 200 × 24 | 160 | 160 | yes |
| 03-frame | FRM-01e | [Deck tile C: table post + motor (x -100..100, y -100..100)](../phases/03-frame/3d/FRM-01e_deck_tile_C.stl) | 1 | 200 × 200 × 24 | 161 | 161 | yes |
| 03-frame | FRM-01f | [Deck tile E: M4 motor + saddles (x 100..300, y -100..100)](../phases/03-frame/3d/FRM-01f_deck_tile_E.stl) | 1 | 200 × 200 × 24 | 164 | 164 | yes |
| 03-frame | FRM-01g | [Deck tile NW: controller tray (x -300..-100, y 100..300)](../phases/03-frame/3d/FRM-01g_deck_tile_NW.stl) | 1 | 200 × 200 × 24 | 161 | 161 | yes |
| 03-frame | FRM-01h | [Deck tile N (x -100..100, y 100..300)](../phases/03-frame/3d/FRM-01h_deck_tile_N.stl) | 1 | 200 × 200 × 24 | 158 | 158 | yes |
| 03-frame | FRM-01i | [Deck tile NE (x 100..300, y 100..300)](../phases/03-frame/3d/FRM-01i_deck_tile_NE.stl) | 1 | 200 × 200 × 24 | 158 | 158 | yes |
| 03-frame | FRM-02a | [Outrigger bar 1, 250 mm (x 215..465)](../phases/03-frame/3d/FRM-02a_outrigger_bar_1.stl) | 1 | 250 × 20 × 20 | 45 | 45 | yes |
| 03-frame | FRM-02b | [Outrigger bar 2, 250 mm (x 465..715)](../phases/03-frame/3d/FRM-02b_outrigger_bar_2.stl) | 1 | 250 × 20 × 20 | 45 | 45 | yes |
| 03-frame | FRM-02c | [Scan post bar 1, 175 mm (z 36..211)](../phases/03-frame/3d/FRM-02c_scan_post_bar_1.stl) | 1 | 175 × 20 × 20 | 32 | 32 | yes |
| 03-frame | FRM-02d | [Scan post bar 2, 175 mm (z 211..386)](../phases/03-frame/3d/FRM-02d_scan_post_bar_2.stl) | 1 | 175 × 20 × 20 | 32 | 32 | yes |
| 03-frame | FRM-09c | [Ring scale + lazy-Susan clamp, 80 deg (print 4: 20-340 deg)](../phases/03-frame/3d/FRM-09c_protractor_segment.stl) | 4 | 149 × 172 × 5 | 19 | 76 | yes |
| 03-frame | FRM-09d | [Outrigger saddle (print 2)](../phases/03-frame/3d/FRM-09d_bar_saddle.stl) | 2 | 40 × 40 × 22 | 9 | 18 | yes |
| 03-frame | FRM-09e | [Scan-post socket on the outrigger](../phases/03-frame/3d/FRM-09e_post_socket.stl) | 1 | 40 × 32 × 50 | 19 | 19 | yes |
| 03-frame | FRM-09h | [Measuring-camera pillar on the outrigger](../phases/03-frame/3d/FRM-09h_camera_pillar.stl) | 1 | 40 × 32 × 184 | 40 | 40 | yes |
| 03-frame | FRM-09f | [Outrigger end foot](../phases/03-frame/3d/FRM-09f_end_foot.stl) | 1 | 40 × 40 × 42 | 22 | 22 | yes |
| 03-frame | FRM-09i | [Bar coupler: outrigger, scan post (print 2)](../phases/03-frame/3d/FRM-09i_bar_coupler.stl) | 2 | 28 × 28 × 50 | 15 | 29 | yes |
| 04-light-arm | LAR-08a | [Belt rim segment (print 7)](../phases/04-light-arm/3d/LAR-08a_rim_segment.stl) | 7 | 60 × 108 × 9 | 12 | 87 | yes |
| 04-light-arm | LAR-08b | [M4 motor mount at 0 deg, pinion meshes the rim](../phases/04-light-arm/3d/LAR-08b_ring_motor_mount.stl) | 1 | 78 × 96 × 30 | 42 | 42 | yes |
| 04-light-arm | LAR-08c | [Arm segment: rim segment + upright socket](../phases/04-light-arm/3d/LAR-08c_arm_segment.stl) | 1 | 66 × 108 × 39 | 26 | 26 | yes |
| 04-light-arm | LAR-08e | [Cross clamp: upright to horizontal arm](../phases/04-light-arm/3d/LAR-08e_cross_clamp.stl) | 1 | 54 × 32 × 32 | 19 | 19 | yes |
| 04-light-arm | LAR-08f | [Light-arm upright bar, 200 mm](../phases/04-light-arm/3d/LAR-08f_upright_bar.stl) | 1 | 200 × 20 × 20 | 36 | 36 | yes |
| 04-light-arm | LAR-08g | [Horizontal light-arm bar, 200 mm](../phases/04-light-arm/3d/LAR-08g_arm_bar.stl) | 1 | 200 × 20 × 20 | 36 | 36 | yes |
| 05-table | TBL-07a | [Table drum: 100T teeth, 608 seats, OG-40 top](../phases/05-table/3d/TBL-07a_table_drum.stl) | 1 | 68 × 68 × 27 | 37 | 37 | yes |
| 05-table | TBL-07b | [Home flag (print 2: tilt, spin)](../phases/05-table/3d/TBL-07b_home_flag.stl) | 2 | 16 × 34 × 10 | 1 | 2 | yes |
| 05-table | TBL-07c | [Table motor bracket (shaft up, slotted)](../phases/05-table/3d/TBL-07c_table_motor_bracket.stl) | 1 | 46 × 79 × 53 | 30 | 30 | yes |
| 05-table | TBL-07d | [Table post: fixed M8 x 75 axle (hex-locked head)](../phases/05-table/3d/TBL-07d_table_post.stl) | 1 | 54 × 54 × 52 | 21 | 21 | yes |
| 05-table | TBL-07f | [Spacers + shims, table and tilt (one print)](../phases/05-table/3d/TBL-07f_spacers.stl) | 1 | 60 × 28 × 9 | 2 | 2 | yes |
| 05-table | TBL-07g | [Table endstop riser (3 deck pilots, +X)](../phases/05-table/3d/TBL-07g_endstop_riser.stl) | 1 | 42 × 92 × 56 | 14 | 14 | yes |
| 05-table | TBL-07h | [Table home flag (fin at r 60)](../phases/05-table/3d/TBL-07h_table_flag.stl) | 1 | 36 × 20 × 23 | 2 | 2 | yes |
| 06-camera-light | CAM-03a | [f/8 aperture stop](../phases/06-camera-light/3d/CAM-03a_aperture_stop_f8.stl) | 1 | 14 × 14 × 1 | 0 | 0 | yes |
| 06-camera-light | CAM-03b | [Camera plate + post clamp](../phases/06-camera-light/3d/CAM-03b_camera_plate.stl) | 1 | 50 × 50 × 34 | 18 | 18 | yes |
| 06-camera-light | LSR-05a | [Lamp body + tube, bar clamp, polarizer slot](../phases/06-camera-light/3d/LSR-05a_lamp_tube.stl) | 1 | 53 × 72 × 74 | 36 | 36 | yes |
| 06-camera-light | LSR-05b | [Lamp back cap](../phases/06-camera-light/3d/LSR-05b_lamp_cap.stl) | 1 | 48 × 48 × 3 | 6 | 6 | yes |
| 07-calibrate | CAL-06a | [PTFE holder](../phases/07-calibrate/3d/CAL-06a_ptfe_holder.stl) | 1 | 60 × 60 × 11 | 15 | 15 | yes |
| 07-calibrate | CAL-06b | [Mirror holder](../phases/07-calibrate/3d/CAL-06b_mirror_holder.stl) | 1 | 60 × 60 × 8 | 14 | 14 | yes |
| 07-calibrate | CAL-06c (optional) | [Chrome-ball holder](../phases/07-calibrate/3d/CAL-06c_ball_holder.stl) | 1 | 66 × 28 × 14 | 12 | 12 | yes |
| 07-calibrate | ENC-04a (optional) | [Dowel socket (print 4)](../phases/07-calibrate/3d/ENC-04a_dowel_socket.stl) | 4 | 50 × 24 × 40 | 10 | 38 | yes |
| 08-tilt | TLT-07a | [Tilt yoke: 608 seats, motor slots above the axis](../phases/08-tilt/3d/TLT-07a_tilt_yoke.stl) | 1 | 140 × 34 × 174 | 80 | 80 | yes |
| 08-tilt | TLT-07b | [GT2 100T pulley (5:1) on the stub axle](../phases/08-tilt/3d/TLT-07b_pulley_100T.stl) | 1 | 67 × 67 × 9 | 17 | 17 | yes |
| 08-tilt | TLT-07c | [Tilt cradle: stub-axle nut traps, spin motor floor](../phases/08-tilt/3d/TLT-07c_tilt_cradle.stl) | 1 | 112 × 34 × 34 | 24 | 24 | yes |
| 09-spin | SPN-07a | [Spin platter: clamps the motor D-shaft (direct drive)](../phases/09-spin/3d/SPN-07a_spin_platter.stl) | 1 | 84 × 84 × 18 | 25 | 25 | yes |
| 10-color | MSK-06a (optional) | [LED ring (8 bands)](../phases/10-color/3d/MSK-06a_led_ring.stl) | 1 | 80 × 135 × 4 | 18 | 18 | yes |
| 10-color | MSK-06b (optional) | [40 deg LED mast](../phases/10-color/3d/MSK-06b_led_mast.stl) | 1 | 30 × 139 × 110 | 14 | 14 | yes |
| 10-color | SPC-03a (optional) | [Spectral sensor tube + post clamp](../phases/10-color/3d/SPC-03a_spectral_tube.stl) | 1 | 30 × 92 × 22 | 14 | 14 | yes |
| 11-scan-capture | SCN-03a | [Riser 20 mm](../phases/11-scan-capture/3d/SCN-03a_riser_20.stl) | 1 | 50 × 50 × 20 | 16 | 16 | yes |
| 11-scan-capture | SCN-03b | [Riser 40 mm](../phases/11-scan-capture/3d/SCN-03b_riser_40.stl) | 1 | 50 × 50 × 40 | 29 | 29 | yes |
| 11-scan-capture | SCN-03c | [Riser 60 mm](../phases/11-scan-capture/3d/SCN-03c_riser_60.stl) | 1 | 50 × 50 × 60 | 41 | 41 | yes |
| 11-scan-capture | SCN-03d | [Scan camera plate, looks 15 deg down](../phases/11-scan-capture/3d/SCN-03d_scan_camera_plate_15.stl) | 1 | 50 × 52 × 44 | 20 | 20 | yes |
| 15-standalone | STA-07a (optional) | [Pi Zero 2 W mount](../phases/15-standalone/3d/STA-07a_pi_zero_mount.stl) | 1 | 75 × 40 × 11 | 9 | 9 | yes |
| 15-standalone | STA-10a (optional) | [Status screen stand (4 deck pilots)](../phases/15-standalone/3d/STA-10a_screen_stand.stl) | 1 | 52 × 74 × 46 | 22 | 22 | yes |
| 15-standalone | STA-10b (optional) | [Status screen bezel](../phases/15-standalone/3d/STA-10b_screen_bezel.stl) | 1 | 74 × 46 × 2 | 3 | 3 | yes |

Total all parts: ≈ 2797 g. Regenerate: `make parts` (or `python tools/cad/printability.py`).
