Normansrule/Gonioreflectometer-Open-Source/paper/build/opengonio.pdf

## Open Source Gonioreectometer: a four-axis BRDF instrument and 3D scanner built from printed parts without soldering

Aleksander Normana,∗

aCalifornia State University, Dominguez Hills, Carson, CA, USA

Abstract

The Open Source Gonioreectometer measures the bidirectional reectance distribution function (BRDF) of at samples and scans objects in 3D. A light arm on a 305 mm ring and three sample axes (yaw, tilt, spin) set every illumination and viewing direction relative to a xed camera, following Ansari-Asl et al. (2024). All 58 structural parts are 3D printed in ABS; the 48 bought parts cost US$511.60 from three distributors. No soldering, drilling, sawing or crimping is needed. Calibration uses a mirror for angles, an exposure series for camera response and a pressed-PTFE tile for absolute reectance. Fitted Lambert + GGX parameters export to game engines. [TBD: repeatability, accuracy vs. reference data].

Keywords: BRDF, gonioreectometer, material appearance, open hardware, 3D printing, photometric calibration

∗Corresponding author: [TBD: email]

Preprint submitted to HardwareX | November 14, 2026

Specications table

Hardware name | Open Source Gonioreectometer
Subject area | Engineering and materials science; computer graphics (material appearance)
Hardware type | Measuring physical properties and in-lab sen-sors; imaging tools
Closest commercial analog | Laboratory gonioreectometers and go-niospectrophotometers
Open source license | Hardware CERN-OHL-S-2.0; software GPL-3.0-or-later; documentation CC BY-SA 4.0
Cost of hardware | US$511.60 in parts (cap US$630); tools US$469.76
Source le repository | https://github.com/Normansrule/Gonioreectometer-Open-Source (https://github.com/Normansrule/Gonioreflectometer-Open-Source) (DOI at release)
1. Hardware in context

Gonioreectometers measure how a surface reects light as a function of incident and reected direction (Nicodemus et al., 1977). Laboratory instruments reach high accuracy at high cost (Höpe et al., 2012, 2006; Saha et al., 2024); image-based (Marschner et al., 2000; Matusik et al., 2003) and robot-arm (Lyngby et al., 2019) setups lower the cost but still need machining or industrial arms. Consumer-hardware capture (Filip et al., 2014) trades angular coverage for speed. Ansari-Asl et al. (2024) describe a multispectral goniometric device with a light arm and a three-axis sample stage. The Open Source Gonioreectometer reproduces that geometry with printed parts, stepper motors and a USB camera, for builders without a workshop, consistent with open-hardware practice (Bonvoisin et al., 2017; Pearce, 2012).

2. Hardware description

Geometry. M4 (light arm, 20324°, 24:1 belt on the ring), M3 (yaw, ±180°, 5:1), M2 (tilt, ±90°, 5:1), M1 (spin, direct drive). Camera xed at 350 mm; light at 300 mm (Fig. 2). Anisotropic materials need M1 (Ward, 1992).

2

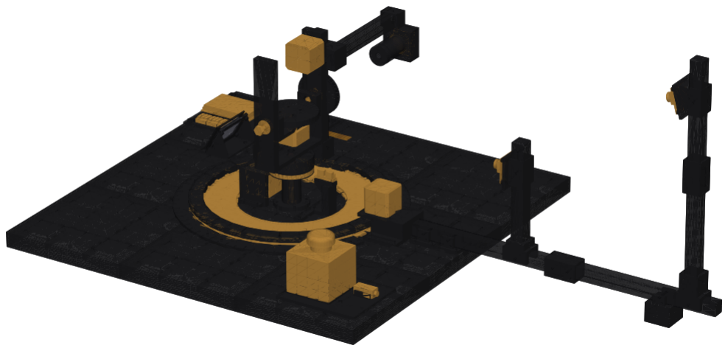
[picture p109: figure]

Figure 1: Whole-machine assembly from the repository CAD (cad/assembly). Sample axes at centre, light arm on the ring, measuring camera on the right.

Light. Chip-on-board LED, colour rendering index 97, 350 mA constant current, collimating printed tube with a 10 mm aperture; solderless holder clamped by the lamp body.

Camera. 12 MP IMX477 USB module, 16 mm lens, printed f/8 stop; exposure, gain and white balance locked.

Control. grblHAL on an RP2040 board (BTT SKR Pico, USB-C) drives four steppers; a microcontroller reads keypads and sensors; optical homing on every axis; over-travel switches in the emergency-stop loop.

One screw size. Every printed join and module mount is an M2 screw self-tapping into a printed pilot; M3 only into the motors, M8 bolts as axles. The base is a printed deck of nine tiles with a pilot at every mount point.

No-tool joins. Lever connectors, screw terminals and modules (optocoupler, LED driver) instead of loose chips.

3. Design les summary

3

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

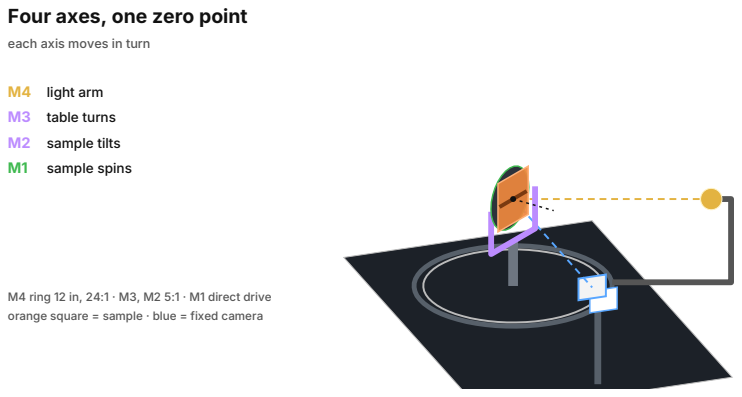
[picture p110: figure]

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

Design le | Type | License | Location
STA-10b screen bezel Bought-part stand-ins Whole-machine assembly CAD source (CadQuery) | STEP, STL STEP, STL STEP Python | CERN-OHL-S-2.0 CERN-OHL-S-2.0 CERN-OHL-S-2.0 GPL-3.0-or-later | 15-standalone cad/bought cad/assembly tools/cad
4. Bill of materials summary

Parts from Digi-Key, Amazon and Adafruit. Tools (US$469.76, including the printer) are listed separately in the repository. Printed parts: ≈2666 g ABS.

Table 2: Bill of materials summary (core machine; shared packs counted once; prices in USD, checked on the store pages).

Designator | Component | No. | Unit | Total | Source
FIL-01 | ABS lament 1.75 mm, black, 1 kg (4 spools) | 4 | 15.99 | 63.96 | Amazon
PWR-30 | 24 V 3 A wall adapter with screw-
| terminal DC jack | 1 | 17.85 | 17.85 | Amazon
PWR-28 | Emergency stop in its own box,
| latching, 1 NO + 1 NC, screw ter-
| minals | 1 | 8.99 | 8.99 | Amazon
PWR-10 | Optocoupler module PC817, 24 V
input, screw terminals (2-pack)
1 | 6.99 | 6.99 | Amazon
PWR-15 | 18 AWG silicone wire red/black, 1.5
m (5 ft) each colour
1 | 7.98 | 7.98 | Amazon
PWR-20 | Lever wire connectors, WAGO 221
assortment (12)
2 | 12.45 | 24.90 | Amazon
CTL-01 | BIGTREETECH SKR Pico V1.0
(RP2040, 4 × TMC2209 UART, USB-C)
1 | 35.99 | 35.99 | Amazon
CTL-03 | USB-A to USB-C data cables, 3 ft (2-pack) | 1 | 8.99 | 8.99 | Amazon
CTL-05 | Membrane keypad 1 x 4 | 1 | 7.89 | 7.89 | Amazon
CTL-06 | JST-XH pre-crimped lead kit | 1 | 10.99 | 10.99 | Amazon
CTL-07 | Jumper wires male-female 20 cm (120) | 1 | 6.98 | 6.98 | Amazon

6

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

Designator | Component | No. | Unit | Total | Source
TLT-05 SPN-01 SCN-01 | M8 x 35 hex bolts, half thread (10-pack; 2 used) NEMA 17 pancake stepper 16 Ncm 1 A (direct drive) Mounting putty 2 oz | 1 1 1 | 9.19 11.99 2.33 | 9.19 11.99 2.33 | Amazon Amazon Amazon
Total | | | | 511.60
5. Build instructions

The repository splits the build into stages (power, controller, frame, each axis, camera and light, calibration). Each step lists time, parts, actions, a measured pass criterion and what to check on failure (phases/*/README.md).

1. Print the tolerance coupon; set clearance and self-tap hole size.
2. Wire the power (wall adapter, e-stop, limit switch); check polarity before the rst power-on.
3. Mount the controller; move one motor from the laptop.
4. Print and bolt the deck; screw every mount into its pilot; assemble the axes; home each axis.
5. Mount camera and lamp; run the mirror test; calibrate (Section 7).
6. Operation instructions
1. opengonio check-pose M4=60 M3=30: angle and collision check.
2. opengonio capture inplane step 10 out data/s: in-plane sweep.
3. opengonio curve data/s: calibrated BRDF curve and Lambert + GGX t (Trowbridge & Reitz, 1975; Walter et al., 2007).

Safety: the lamp is viewed only through the sample; the emergency stop cuts motor power.

7. Validation and characterization

Calibration.. Angle oset from the mirror peak (M3 = M4/2 in-plane); dark level from a lamp-o frame; camera response from an exposure series (Debevec & Malik, 1997); absolute scale from pressed PTFE (Weidner & Hsia, 1981):

fr =

Clin

Cw,lin

ρw
π

cos 45◦
cos θi

, Clin = (C − Cd)

γ
. | (1)

8

Results.. [TBD: angular repeatability per axis (mirror, 10 repeats); lamp drift over a run; PTFE reectance vs. reference; matte and glossy samples vs. MERL (Matusik et al., 2003) or RGL (RGL-EPFL material database, n.d.) data; scan accuracy].

Ethics statements

No human or animal subjects.

CRediT author statement

Aleksander Norman: Conceptualization, Methodology, Software, Hardware, Writing original draft.

Declaration of competing interest

None.

Acknowledgements

[TBD: acknowledgements]

References

Ansari-Asl, M., Barbieri, M., Obein, G., & Hardeberg, J. Y. (2024). Optical and electromechanical design and implementation of an advanced multispectral device to capture material appearance. Journal of Imaging, 10 (3), 55. https://doi.org/10.3390/jimaging10030055
Bonvoisin, J., Mies, R., Boujut, J.-F., & Stark, R. (2017). What is the 'source' of open source hardware? Journal of Open Hardware, 1 (1). https : //doi.org/10.5334/joh.7
Debevec, P., & Malik, J. (1997). Recovering high dynamic range radiance maps from photographs. Proc. SIGGRAPH '97. https://pauldebevec.com/Research/HDR/debevec-siggraph97.pdf (https://pauldebevec.com/Research/HDR/debevec-siggraph97.pdf)
Filip, J., Vávra, R., & Krupi£ka, M. (2014). Rapid material appearance acquisition using consumer hardware. Sensors, 14 (10), 1978519805. https: //doi.org/10.3390/s141019785

9

Höpe, A., et al. (2012). ARGon3: '3D appearance robot-based gonioreectometer' at PTB. Review of Scientic Instruments, 83 (4), 045102. https://pubs.aip.org/aip/rsi/article/83/4/045102/355039/ARGon3-3D-appearance-robot-based (https://pubs.aip.org/aip/rsi/article/83/4/045102/355039/ARGon3-3D-appearance-robot-based)
Höpe, A., Hünerho, D., & Hauer, K.-O. (2006). Robot-based gonioreectometer. In Industrial robotics: Programming, simulation and applications (pp. 624632). (ed. L. K. Huat). https://cdn.intechopen.com/pdfs/284/InTech-Robot_based_gonioreectometer.pdf (https://cdn.intechopen.com/pdfs/284/InTech-Robot_based_gonioreflectometer.pdf)
Lyngby, R. A., Matthiassen, J. B., Frisvad, J. R., Dahl, A. B., & Aanæs,
H. (2019). Using a robotic arm for measuring BRDFs. SCIA 2019. https://doi.org/10.1007/978-3-030-20205-7_16
Marschner, S. R., Westin, S. H., Lafortune, E. P. F., & Torrance, K. E. (2000). Image-based bidirectional reectance distribution function measurement. Applied Optics, 39 (16), 25922600. https://doi.org/10.1364/AO.39.002592 (https://doi.org/10.1364/AO.39.002592)
Matusik, W., Pster, H., Brand, M., & McMillan, L. (2003). Ecient isotropic BRDF measurement. Proc. 14th Eurographics Workshop on Rendering. https://www.pbr-book.org/4ed/Reection_Models/Further_Reading (https://www.pbr-book.org/4ed/Reflection_Models/Further_Reading)
Nicodemus, F. E., Richmond, J. C., Hsia, J. J., Ginsberg, I. W., & Limperis,
T. (1977). Geometrical considerations and nomenclature for reectance. NBS Monograph, 160. https://doi.org/10.6028/NBS.MONO.160 Pearce, J. M. (2012). Building research equipment with free, open-source hardware. Science, 337 (6100), 13031304. https://doi.org/10.1126/science.1228183 (https://doi.org/10.1126/science.1228183)
RGL-EPFL material database. (n.d.). https : / / rgl . ep . ch / pages / lab / material-database (https://rgl.epfl.ch/pages/lab/material-database)
Saha, D., Gevaux, L., Frisvad, J. R., & Obein, G. (2024). Bidirectional re-ectance measurements over a micrometric surface area using a goniospectrophotometer. Review of Scientic Instruments, 95 (5), 055114. https://doi.org/10.1063/5.0193490
Trowbridge, T. S., & Reitz, K. P. (1975). Average irregularity representation of a rough surface for ray reection. Journal of the Optical Society of America, 65 (5), 531536. https://doi.org/10.1364/JOSA.65.000531 Walter, B., Marschner, S., Li, H., & Torrance, K. (2007). Microfacet models for refraction through rough surfaces. Eurographics Symposium on Rendering.

10

Ward, G. J. (1992). Measuring and modeling anisotropic reection. ACM SIGGRAPH Computer Graphics, 26 (2), 265272. https://doi.org/10.1145/142920.134078 (https://doi.org/10.1145/142920.134078)
Weidner, V. R., & Hsia, J. J. (1981). Reection properties of pressed polytetrauoroethylene powder. Journal of the Optical Society of America, 71 (7), 856861. https://doi.org/10.1364/JOSA.71.000856

11
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
