Normansrule/Gonioreflectometer-Open-Source/docs/og/img/assembly.png

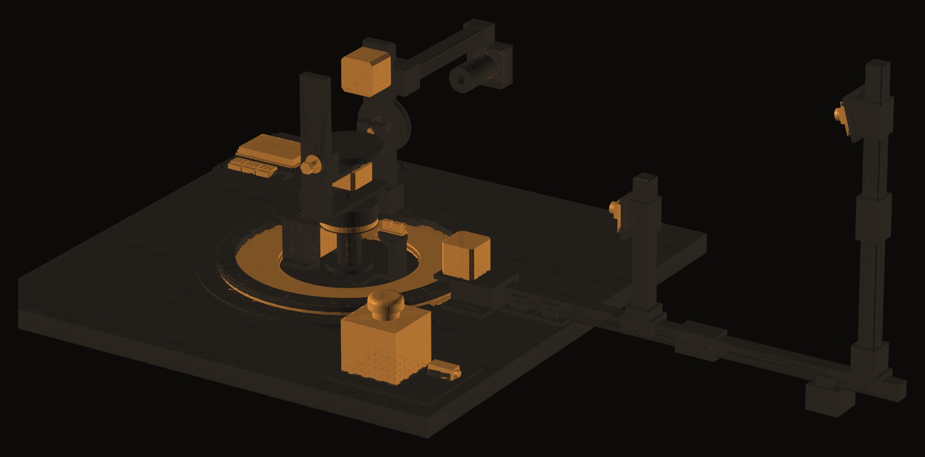
docs/og/img/assembly.png
