Normansrule/Gonioreflectometer-Open-Source/wiki/Appendix-C-Calibration-and-3D.md

# Appendix C · Calibration, HDR, photometric stereo, 3D scanning

<!-- generated by tools/refs_bib.py from REFERENCES.md - edit that file, then `make build` -->

Background papers and sources, by topic. Format: APA reference — *what this project uses it for*. Full list: [Bibliography](Bibliography.md).

## 3D photo scanner

- *COLMAP output format*. (n.d.). https://colmap.github.io/format.html — *COLMAP text model, quaternions* `[S1]`
- COLMAP FAQ. (n.d.). *Reconstruct sparse/dense model from known camera poses*. https://colmap.github.io/faq.html — *`run_colmap.sh` command sequence, meshing* `[S2]`
- Schönberger, J. L., & Frahm, J.-M. (2016). *Structure-from-motion revisited*. https://doi.org/10.1007/978-3-319-46487-9_31 — *Photogrammetry engine* `[S3]`
- Woodham, R. J. (1980). Photometric method for determining surface orientation from multiple images. *Optical Engineering*, *19*(1). https://doi.org/10.1117/12.7972479 — *Photometric stereo* `[S4]`
- Laurentini, A. (1994). The visual hull concept for silhouette-based image understanding. *IEEE Transactions on Pattern Analysis and Machine Intelligence*, *16*(2). https://doi.org/10.1109/34.273735 — *Visual hull* `[S5]`
- Szeliski, R. (1993). Rapid octree construction from image sequences. *CVGIP: Image Understanding*, *58*(1). https://www.sciencedirect.com/science/article/abs/pii/S1049966083710296 — *Voxel carving* `[S6]`
- Kutulakos, K. N., & Seitz, S. M. (2000). A theory of shape by space carving. *International Journal of Computer Vision*. https://doi.org/10.1023/A:1008191222954 — *Space carving* `[S7]`
- *MVTec HALCON ‘photometric_stereo‘ reference*. (n.d.). https://www.mvtec.com/doc/halcon/13/en/photometric_stereo.html — *≥ 3 images, non-coplanar light directions* `[S8]`
- Fitzgibbon, A. W., Cross, G., & Zisserman, A. (1998). *Automatic 3D model construction for turn-table sequences*. https://doi.org/10.1007/3-540-49437-5_11 — *Turntable (rotating-object) reconstruction* `[S9]`
- *Meshroom / AliceVision*. (n.d.). https://alicevision.org/ — *Alternative reconstruction* `[S10]`
- *OpenCV ‘solvePnP‘*. (n.d.). https://docs.opencv.org/4.13.0/d5/d1f/calib3d_solvePnP.html — *Camera axis convention, pose checks* `[S11]`
- *OpenCV ChArUco calibration*. (n.d.). https://docs.opencv.org/4.13.0/da/d13/tutorial_aruco_calibration.html — *Scan-mode intrinsics, scanning mat* `[S12]`
- Schnieders, D., & Wong, K.-Y. K. (2013). Camera and light calibration from reflections on a sphere. *Computer Vision and Image Understanding*. https://www.sciencedirect.com/science/article/abs/pii/S1077314213001082 — *Chrome-ball light calibration* `[S13]`
- Yu, Chen, & Da. (2025). Geometric calibration for photometric stereo under near-field point light sources using spheres. *Optics & Laser Technology*, *180*. https://www.sciencedirect.com/science/article/pii/S0030399224010156 — *Near-light correction (phase 11)* `[S14]`
- Goldman, D. B., Curless, B., Hertzmann, A., & Seitz, S. M. (2005). *Shape and spatially-varying BRDFs from photometric stereo*. https://doi.org/10.1109/ICCV.2005.219 — *Material on the mesh (phase 13)* `[S15]`
- *Blender manual: PLY, OBJ, glTF 2.0, formats*. (n.d.). https://docs.blender.org/manual/en/latest/files/import_export/ply.html — *Mesh import check* `[S16]`
- *OpenMVS*. (n.d.). https://github.com/cdcseacave/openMVS — *Optional dense/mesh stage* `[S17]`
- *RealityScan (formerly RealityCapture)*. (n.d.). https://www.realityscan.com/license — *Optional reconstruction* `[S18]`
- *QuakeHold! Museum putty*. (n.d.). https://www.sosproducts.com/quakehold-museum-putty-p/64810.htm — *Heavier-object option* `[S19]`
- *Loctite fun-tak 2 oz*. (n.d.). https://www.staples.com/Loctite-Fun-Tak-2-oz-Mounting-Adhesive-Putty-1270884/product_1480018 — *$3.49 object mount* `[S20]`

## Geometric camera calibration

- Zhang, Z. (2000). A flexible new technique for camera calibration. *IEEE Transactions on Pattern Analysis and Machine Intelligence*, *22*(11), 1330–1334. https://doi.org/10.1109/34.888718 — *Planar-target intrinsics (phase 06)* `[V1]`
- Tsai, R. Y. (1987). A versatile camera calibration technique for high-accuracy 3D machine vision metrology using off-the-shelf TV cameras and lenses. *IEEE Journal of Robotics and Automation*, *3*(4), 323–344. https://doi.org/10.1109/JRA.1987.1087109 — *Classic calibration background (phase 06)* `[V2]`
- Heikkilä, J., & Silvén, O. (1997). A four-step camera calibration procedure with implicit image correction. *Proceedings of the IEEE Conference on Computer Vision and Pattern Recognition*, 1106–1112. https://doi.org/10.1109/CVPR.1997.609468 — *Distortion model and correction (phase 06)* `[V3]`
- Brown, D. C. (1971). Close-range camera calibration. *Photogrammetric Engineering*, *37*(8), 855–866. https://www.semanticscholar.org/paper/Close-Range-Camera-Calibration-Brown/1150007b62a3c7dac99c2c8f85c63bfab74891af — *Radial/tangential lens distortion (phase 06)* `[V4]`
- Bouguet, J.-Y. (2022). *Camera calibration toolbox for Matlab*. https://doi.org/10.22002/D1.20164 — *Reference calibration workflow (phase 06)* `[V5]`
- Schöps, T., Larsson, V., Pollefeys, M., & Sattler, T. (2020). Why having 10,000 parameters in your camera model is better than twelve. *Proceedings of the IEEE Conference on Computer Vision and Pattern Recognition*. https://openaccess.thecvf.com/content_CVPR_2020/html/Schops_Why_Having_10000_Parameters_in_Your_Camera_Model_Is_Better_CVPR_2020_paper.html — *Calibration accuracy limits (phase 17)* `[V6]`
- Garrido-Jurado, S., Muñoz-Salinas, R., Madrid-Cuevas, F. J., & Marín-Jiménez, M. J. (2014). Automatic generation and detection of highly reliable fiducial markers under occlusion. *Pattern Recognition*, *47*(6), 2280–2292. https://doi.org/10.1016/j.patcog.2014.01.005 — *ArUco markers on ChArUco board (phases 06, 11)* `[V7]`
- Hartley, R., & Zisserman, A. (2004). *Multiple view geometry in computer vision* (2nd ed.). https://doi.org/10.1017/CBO9780511811685 — *Projection, triangulation, bundle adjustment (phases 06, 11)* `[V8]`
- Szeliski, R. (2022). *Computer vision: Algorithms and applications* (2nd ed.). https://doi.org/10.1007/978-3-030-34372-9 — *General CV reference (phases 06, 07, 08, 09, 10, 11, 12, 13)* `[V9]`

## Hand-eye and robot-world calibration (AX=XB, AX=YB)

- Tsai, R. Y., & Lenz, R. K. (1989). A new technique for fully autonomous and efficient 3D robotics hand/eye calibration. *IEEE Transactions on Robotics and Automation*, *5*(3), 345–358. https://doi.org/10.1109/70.34770 — *Hand-eye AX=XB baseline (phase 11)* `[V10]`
- Park, F. C., & Martin, B. J. (1994). Robot sensor calibration: Solving AX=XB on the Euclidean group. *IEEE Transactions on Robotics and Automation*, *10*(5), 717–721. https://doi.org/10.1109/70.326576 — *Lie-group hand-eye solver (phase 11)* `[V11]`
- Daniilidis, K. (1999). Hand-eye calibration using dual quaternions. *International Journal of Robotics Research*, *18*(3), 286–298. https://doi.org/10.1177/02783649922066213 — *Simultaneous rotation/translation hand-eye (phase 11)* `[V12]`
- Zhuang, H., Roth, Z. S., & Sudhakar, R. (1994). Simultaneous robot/world and tool/flange calibration by solving homogeneous transformation equations of the form AX=YB. *IEEE Transactions on Robotics and Automation*, *10*(4), 549–554. https://doi.org/10.1109/70.313105 — *AX=YB formulation (phase 11)* `[V13]`
- Dornaika, F., & Horaud, R. (1998). Simultaneous robot-world and hand-eye calibration. *IEEE Transactions on Robotics and Automation*, *14*(4), 617–622. https://doi.org/10.1109/70.704233 — *AX=YB nonlinear solution (phase 11)* `[V14]`
- Shah, M. (2013). Solving the robot-world/hand-eye calibration problem using the Kronecker product. *Journal of Mechanisms and Robotics*, *5*(3), 031007. https://doi.org/10.1115/1.4024473 — *Closed-form AX=YB (OpenCV SHAH) (phase 11)* `[V15]`
- Tabb, A., & Ahmad Yousef, K. M. (2017). Solving the robot-world hand-eye(s) calibration problem with iterative methods. *Machine Vision and Applications*. https://doi.org/10.1007/s00138-017-0841-7 — *Reprojection-error AX=YB refinement (phase 11)* `[V16]`
- Ali, I., Suominen, O., Gotchev, A., & Ruiz Morales, E. (2019). Methods for simultaneous robot-world-hand–eye calibration: A comparative study. *Sensors*, *19*(12), 2837. https://doi.org/10.3390/s19122837 — *Choosing an AX=YB method (phase 11)* `[V17]`
- *OpenCV, camera calibration and 3D reconstruction (‘calibrateHandEye‘, ‘calibrateRobotWorldHandEye‘)*. (n.d.). https://docs.opencv.org/4.13.0/d9/d0c/group__calib3d.html — *Hand-eye implementation (phase 11)* `[V18]`

## Radiometric calibration and HDR capture

- Mitsunaga, T., & Nayar, S. K. (1999). Radiometric self calibration. *Proceedings of the IEEE Conference on Computer Vision and Pattern Recognition*, 374–380. https://doi.org/10.1109/CVPR.1999.786966 — *Polynomial response curve (phase 07)* `[V19]`
- Robertson, M. A., Borman, S., & Stevenson, R. L. (2003). Estimation-theoretic approach to dynamic range enhancement using multiple exposures. *Journal of Electronic Imaging*, *12*(2), 219–228. https://doi.org/10.1117/1.1557695 — *Weighted HDR merge (OpenCV Robertson) (phase 07)* `[V20]`
- Grossberg, M. D., & Nayar, S. K. (2003). What is the space of camera response functions? *Proceedings of the IEEE Conference on Computer Vision and Pattern Recognition*. https://doi.org/10.1109/TPAMI.2004.88 — *Response-curve prior (EMoR) (phase 07)* `[V21]`
- Hasinoff, S. W., Durand, F., & Freeman, W. T. (2010). Noise-optimal capture for high dynamic range photography. *Proceedings of the IEEE Conference on Computer Vision and Pattern Recognition*, 553–560. https://doi.org/10.1109/CVPR.2010.5540167 — *Choosing exposure brackets (phase 07)* `[V22]`
- Granados, M., Ajdin, B., Wand, M., Theobalt, C., Seidel, H.-P., & Lensch, H. P. A. (2010). Optimal HDR reconstruction with linear digital cameras. *Proceedings of the IEEE Conference on Computer Vision and Pattern Recognition*. https://vcai.mpi-inf.mpg.de/projects/opthdr/ — *Noise-weighted HDR merge (phase 07)* `[V23]`
- Reinhard, E., Ward, G., Pattanaik, S., Debevec, P., Heidrich, W., & Myszkowski, K. (2010). *High dynamic range imaging: Acquisition, display, and image-based lighting* (2nd ed.). https://www.oreilly.com/library/view/high-dynamic-range/9780123749147/ — *HDR formats and theory (phase 07)* `[V24]`

## Photometric stereo

- Hertzmann, A., & Seitz, S. M. (2005). Example-based photometric stereo: Shape reconstruction with general, varying BRDFs. *IEEE Transactions on Pattern Analysis and Machine Intelligence*, *27*(8), 1254–1264. https://doi.org/10.1109/TPAMI.2005.158 — *Reference-sphere PS for glossy objects (phase 11)* `[V25]`
- Basri, R., Jacobs, D., & Kemelmacher, I. (2007). Photometric stereo with general, unknown lighting. *International Journal of Computer Vision*, *72*(3), 239–257. https://doi.org/10.1007/s11263-006-8815-7 — *Spherical-harmonic lighting PS (phase 12)* `[V26]`
- Ackermann, J., & Goesele, M. (2015). A survey of photometric stereo techniques. *Foundations and Trends in Computer Graphics and Vision*, *9*. https://doi.org/10.1561/0600000065 — *PS method overview (phases 11, 12)* `[V27]`
- Shi, B. et al. (2016). A benchmark dataset and evaluation for non-Lambertian and uncalibrated photometric stereo. *Proceedings of the IEEE Conference on Computer Vision and Pattern Recognition*. https://openaccess.thecvf.com/content_cvpr_2016/html/Shi_A_Benchmark_Dataset_CVPR_2016_paper.html — *PS validation dataset (phase 12)* `[V28]`
- Mecca, R., Wetzler, A., Bruckstein, A. M., & Kimmel, R. (2014). Near field photometric stereo with point light sources. *SIAM Journal on Imaging Sciences*, *7*(4), 2732–2770. https://doi.org/10.1137/140968100 — *Near-light PS model (phase 12)* `[V29]`
- Quéau, Y., Durix, B., Wu, T., Cremers, D., Lauze, F., & Durou, J.-D. (2018). LED-based photometric stereo: Modeling, calibration and numerical solution. *Journal of Mathematical Imaging and Vision*, *60*(3), 313–340. https://doi.org/10.1007/s10851-017-0761-1 — *LED anisotropy and falloff model (phases 11, 12)* `[V30]`
- Logothetis, F., Quéau, Y., Mecca, R., & Cipolla, R. (2017). Semi-calibrated near-light photometric stereo. *SSVM*. https://doi.org/10.1007/978-3-319-58771-4_52 — *Unknown LED intensities (phase 12)* `[V31]`
- Santo, H., Waechter, M., & Matsushita, Y. (2020). Deep near-light photometric stereo for spatially varying reflectances. *European Conference on Computer Vision*. https://doi.org/10.1007/978-3-030-58598-3_9 — *Learned near-light PS option (phase 17)* `[V32]`
- Papadhimitri, T., & Favaro, P. (2013). A new perspective on uncalibrated photometric stereo. *Proceedings of the IEEE Conference on Computer Vision and Pattern Recognition*. https://openaccess.thecvf.com/content_cvpr_2013/papers/Papadhimitri_A_New_Perspective_2013_CVPR_paper.pdf — *Perspective uncalibrated PS fallback (phase 12)* `[V33]`
- Ikehata, S. (2018). CNN-PS: CNN-based photometric stereo for general non-convex surfaces. *European Conference on Computer Vision*. https://doi.org/10.1007/978-3-030-01267-0_1 — *Learned PS for glossy objects (phase 17)* `[V34]`
- Quéau, Y., Durou, J.-D., & Aujol, J.-F. (2018). Normal integration: A survey. *Journal of Mathematical Imaging and Vision*, *60*(4), 576–593. https://doi.org/10.1007/s10851-017-0773-x — *Normals to depth map (phase 12)* `[V35]`
- Nehab, D., Rusinkiewicz, S., Davis, J., & Ramamoorthi, R. (2005). Efficiently combining positions and normals for precise 3D geometry. *ACM Transactions on Graphics*, *24*(3). https://gfx.cs.princeton.edu/pubs/Nehab_2005_ECP/index.php — *Fuse PS normals with mesh (phase 12)* `[V36]`

## Multi-view reconstruction, visual hulls, meshing

- Snavely, N., Seitz, S. M., & Szeliski, R. (2006). Photo tourism: Exploring photo collections in 3D. *ACM Transactions on Graphics*, *25*(3), 835–846. https://doi.org/10.1145/1141911.1141964 — *Incremental SfM background (phase 12)* `[V37]`
- Furukawa, Y., & Ponce, J. (2010). Accurate, dense, and robust multiview stereopsis. *IEEE Transactions on Pattern Analysis and Machine Intelligence*, *32*(8), 1362–1376. https://doi.org/10.1109/TPAMI.2009.161 — *Patch-based MVS (PMVS) (phase 12)* `[V38]`
- Furukawa, Y., & Hernández, C. (2015). Multi-view stereo: A tutorial. *Foundations and Trends in Computer Graphics and Vision*, *9*. https://doi.org/10.1561/0600000052 — *MVS overview (phase 12)* `[V39]`
- Griwodz, C. et al. (2021). AliceVision meshroom: An open-source 3D reconstruction pipeline. *Proc. ACM MMSys*. https://doi.org/10.1145/3458305.3478443 — *Alternative pipeline citation (phase 12)* `[V40]`
- Matusik, W., Buehler, C., Raskar, R., Gortler, S. J., & McMillan, L. (2000). Image-based visual hulls. *Proc. SIGGRAPH*. https://doi.org/10.1145/344779.344951 — *Silhouette visual hull (phase 12)* `[V41]`
- Hernández Esteban, C., & Schmitt, F. (2004). Silhouette and stereo fusion for 3D object modeling. *Computer Vision and Image Understanding*, *96*(3), 367–392. https://www.sciencedirect.com/science/article/abs/pii/S1077314204000542 — *Hull + stereo fusion on turntable (phase 12)* `[V42]`
- Lorensen, W. E., & Cline, H. E. (1987). Marching cubes: A high resolution 3D surface construction algorithm. *Proc. SIGGRAPH*. https://doi.org/10.1145/37401.37422 — *Voxel grid to mesh (phase 12)* `[V43]`
- Curless, B., & Levoy, M. (1996). A volumetric method for building complex models from range images. *Proc. SIGGRAPH*. https://doi.org/10.1145/237170.237269 — *TSDF fusion of depth maps (phase 12)* `[V44]`
- Kazhdan, M., Bolitho, M., & Hoppe, H. (2006). Poisson surface reconstruction. *Eurographics Symposium on Geometry Processing*. https://diglib.eg.org/items/245d6ba1-0209-4365-a4a4-16ce46421620 — *Oriented points to mesh (phase 12)* `[V45]`
- Kazhdan, M., & Hoppe, H. (2013). Screened Poisson surface reconstruction. *ACM Transactions on Graphics*, *32*(3), 29. https://doi.org/10.1145/2487228.2487237 — *Default meshing step (phase 12)* `[V46]`
- Zhou, Q.-Y., Park, J., & Koltun, V. (2018). *Open3D: A modern library for 3D data processing*. https://arxiv.org/abs/1801.09847 — *Point cloud/mesh library (phases 12, 13, 14)* `[V47]`

## Reflectance capture rigs and polarization

- Debevec, P., Hawkins, T., Tchou, C., Duiker, H.-P., Sarokin, W., & Sagar, M. (2000). Acquiring the reflectance field of a human face. *Proc. SIGGRAPH*. https://doi.org/10.1145/344779.344855 — *Light-stage relighting concept (phases 09, 11)* `[V48]`
- Ma, W.-C., Hawkins, T., Peers, P., Chabert, C.-F., Weiss, M., & Debevec, P. (2007). Rapid acquisition of specular and diffuse normal maps from polarized spherical gradient illumination. *Eurographics Symposium on Rendering*. https://diglib.eg.org/items/da04b92c-39fe-41d1-a658-a8535521521c — *Polarized diffuse/specular normals (phase 10)* `[V49]`
- Ghosh, A., Fyffe, G., Tunwattanapong, B., Busch, J., Yu, X., & Debevec, P. (2011). Multiview face capture using polarized spherical gradient illumination. *ACM Transactions on Graphics*, *30*(6). https://doi.org/10.1145/2070781.2024163 — *Multi-view polarized capture (phases 10, 11)* `[V50]`
- Nayar, S. K., Fang, X.-S., & Boult, T. (1997). Separation of reflection components using color and polarization. *International Journal of Computer Vision*, *21*(3), 163–186. https://doi.org/10.1023/A:1007937815113 — *Diffuse/specular split with polarizer (phase 10)* `[V51]`
- Wolff, L. B. (1990). Polarization-based material classification from specular reflection. *IEEE Transactions on Pattern Analysis and Machine Intelligence*, *12*(11), 1059–1071. https://doi.org/10.1109/34.61705 — *Polarization physics background (phase 10)* `[V52]`

## Open-source turntable scanners

- *OpenScan (Raspberry Pi photogrammetry scanner)*. (n.d.). https://openscan.eu/pages/openscan-mini — *DIY scanner prior art (phase 11)* `[V53]`
- *FabScan, media computing group, RWTH aachen university*. (n.d.). https://hci.rwth-aachen.de/fabscan — *Turntable laser scanner prior art (phase 11)* `[V54]`
- *BQ ciclop scanner + horus software*. (n.d.). https://github.com/bqlabs/ciclop — *Turntable calibration UX reference (phases 11, 14)* `[V55]`

## Texturing and UV unwrapping

- Lévy, B., Petitjean, S., Ray, N., & Maillot, J. (2002). Least squares conformal maps for automatic texture atlas generation. *ACM Transactions on Graphics*, *21*(3), 362–371. https://doi.org/10.1145/566654.566590 — *LSCM UV unwrapping (phase 13)* `[V56]`
- *Xatlas, mesh parameterization / UV unwrapping library*. (n.d.). https://github.com/jpcy/xatlas — *Automatic UV atlas (phase 13)* `[V57]`
- Waechter, M., Moehrle, N., & Goesele, M. (2014). Let there be color! Large-scale texturing of 3D reconstructions. *European Conference on Computer Vision*. https://doi.org/10.1007/978-3-319-10602-1_54 — *View selection for mesh textures (phase 13)* `[V58]`
