Normansrule/Gonioreflectometer-Open-Source/phases/01-power/test.csv

Test | Date | Measured | Pass criterion | Pass/Fail | Notes
T1 Out + to − resistance (unpowered, adapter unplugged) |  |  | > 10 kOhm or OL
T3 Voltage and polarity at MOT+ / MOT− |  |  | +23.0 to +25.0 V (positive sign)
T4 Loaded (SKR Pico + motor holding) |  |  | >= 22.5 V at SKR Pico POWER
T5 E-stop |  |  | out < 1 V in 1 s; POWER 0; laptop up
T6 Limit switch (stage 04) |  |  | lever pressed: out < 1 V; released: back to T3
T7 E-stop sense |  |  | POWER 1 when on, POWER 0 on e-stop or limit switch; 20 of 20 presses read right
T9 Thermal 30 min |  |  | adapter case and every terminal <= 45 C (multimeter probe)
T12 Path loss |  |  | jack + to SKR Pico POWER + drop <= 0.3 V at 1 A
