Normansrule/Gonioreflectometer-Open-Source/paper/figures/architecture.pdf

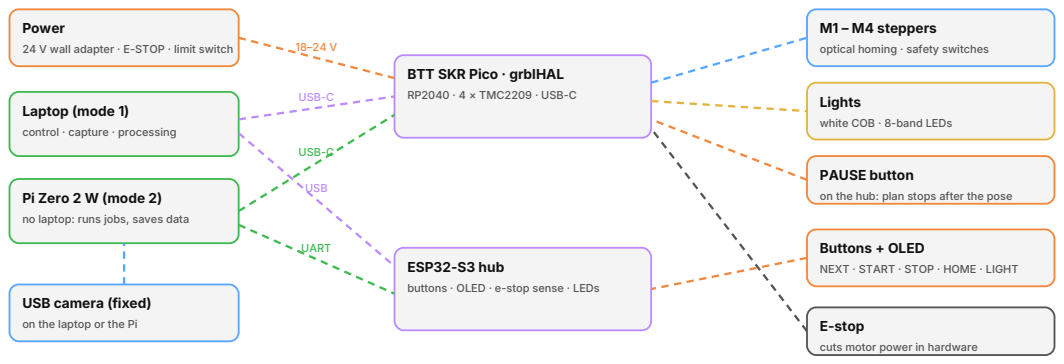
[picture p112: page 1]
USB-C; USB; UART

Power
24 V wall adapter · E-STOP · limit switch

M1 – M4 steppers
optical homing · safety switches

BTT SKR Pico · grblHAL
RP2040 · 4 × TMC2209 · USB-C

Lights
white COB · 8-band LEDs

Laptop (mode 1)
control · capture · processing

PAUSE button
on the hub: plan stops after the pose

Pi Zero 2 W (mode 2)
no laptop: runs jobs, saves data

Buttons + OLED
NEXT · START · STOP · HOME · LIGHT

ESP32-S3 hub
buttons · OLED · e-stop sense · LEDs

USB camera (fixed)
on the laptop or the Pi

E-stop
cuts motor power in hardware
