Normansrule/Gonioreflectometer-Open-Source/software/config/machine.yaml

# OpenGonio machine description (what you BUILT; measured values live in calibration.yaml). installed_phase = the phase you finished (4 M4 · 5 M3 · 6 light · 8 M2 · 9 M1 · 10 LED bank).
# Geometry follows the fixed-camera / rotating-sample / light-arm layout of [R1].
# Origin = zero point (sample surface centre). +Z up. Camera fixed on +X.
# Angles in degrees, lengths in mm.  SPDX-License-Identifier: GPL-3.0-or-later

machine:
  name: OpenGonio
  installed_phase: 6
  camera_distance_mm: 350.0
  camera_elevation_deg: 0.0     # fixed L-arm; set to the value you lock it at
  light_distance_mm: 300.0
  ring_radius_mm: 140.0         # light arm root on the 12 in ring
  camera_head_radius_mm: 30.0
  lamp_head_radius_mm: 30.0
  arm_radius_mm: 15.0
  keep_out_mm: 30.0
  min_phase_angle_deg: 5.0      # extra angular buffer between light and camera, as in [R1]
  repeatability_target_deg: 0.1

controller:                     # BTT SKR Pico V1.0 running grblHAL (USB-C)
  firmware: grblhal             # grblhal (SKR Pico) | fluidnc (ESP32 boards such as the FYSETC E4)
  transport: serial             # serial (USB-C) | tcp (WiFi: FluidNC boards only)
  port: auto                    # COM5, /dev/ttyACM0 ... auto = first port with the firmware's USB VID (RP2040 0x2E8A)
  baud: 115200
  host: fluidnc.local           # tcp only (FluidNC)
  tcp_port: 23
  feed_deg_per_min: 600

hub:                            # ESP32-S3 DevKitC-1 panel + sensor hub (MicroPython)
  port: auto                    # auto = first Espressif USB port (VID 0x303A: the board's "USB" connector)
  baud: 115200

station:                        # standalone mode: Pi Zero 2 W runs `opengonio station` (no laptop)
  controller: {transport: serial, port: auto}   # SKR Pico USB-C into the Pi's USB hub (STA-04)
  hub_port: /dev/serial0        # ESP32-S3 hub on the Pi UART (Pi GPIO14 TX -> hub GPIO 48 RX, GPIO15 RX <- hub GPIO 47 TX)
  data_dir: ~/opengonio-data    # one folder per job: images + manifest.json
  exposure_ms: 20

spectral:                       # AS7341 above the camera lens (stage 10): set from your mount
  elevation_deg: 7.0            # sensor line of sight above the camera axis (45 mm over 350 mm)
  field_deg: 4.0                # 3 mm aperture, 40 mm tube

sample:                         # planar sample on the platter (roi.py: which pixels count as valid signal)
  size_mm: 50.0                 # square swatch side
  roi_fraction: 0.8             # use the central 80 % of the swatch (edges, chamfers, holder shadows excluded)
  lit_fraction: 0.9             # and the inner 90 % of the lamp's fully lit spot
  min_area_mm2: 25.0            # less valid area than this: no value for that pose

camera:
  index: 0
  width: 3840
  height: 3032
  focal_length_mm: 16.0
  pixel_um: 1.55
  exposure_ms: 20               # locked in M17.2; dark and white calibration must use the same value

lights:                         # controller digital outputs (M62/M63 P<n>); grblHAL port numbers from `$PINS` (M08.2)
  white: {output: 4, phase: 6, elevation_deg: 0.0, warmup_s: 60, umbra_radius_mm: 16.2}   # warm-up: measured in M18.2; umbra: nominal from the lamp tube (10 mm exit 61.7 mm from the 4.2 mm COB), measure in M18.1
  multispectral:                # optional colour kit (M30): LED bank on a 40 deg mast, non-coplanar lights for photometric stereo
    output: 3
    phase: 10
    elevation_deg: 40.0
    built: false                # set true once built
    blocked: "NLDD-350H needs >= 6 V across its output; one colour LED is ~2-3.5 V, so the driver is out of regulation, and switching LEDs in and out on its live output can spike the current. Do not energize until a reviewed driver circuit replaces it (audit F09)"   # software refuses to switch it on while this is set

scan:                           # 3D photo scanner (stage 11): second camera fixed at 650 mm, 15 deg up, looking over the first
  camera_index: 1               # second USB camera (CAM-04). One-camera option: 0, and move the camera to the scan post
  camera_distance_mm: 650.0     # f/8: see phases/06-camera-light/optics.md (field, DOF, resolution)
  camera_elevation_deg: 15.0    # its picture clears the measuring camera by 15 mm (opengonio scan plan prints it)
  aperture_f: 8
  object_max_radius_mm: 55.0    # bounding sphere of the object about its centre (2r <= DOF)
  platter_offset_mm: 0.0        # delta: support surface below the zero point = 60 - riser height (mm)
  calibration: null             # path to scan_calibration.yaml from `opengonio scan calibrate` (measured camera pose)
  lamp_m4_deg: 30.0             # white lamp beside the camera for photogrammetry frames
  rings:                        # camera elevation above the platter (deg) : images per ring
    - {elevation_deg: 20, count: 36}   # lowest view: M2 = 90 - 20 + 15 = 85 (tilt limit 90)
    - {elevation_deg: 35, count: 36}
    - {elevation_deg: 50, count: 36}
    - {elevation_deg: 65, count: 24}
    - {elevation_deg: 80, count: 12}
  ps_band: 3                    # LED bank band used for photometric stereo (one band = one albedo)
  ps_m4_deg: [40, 100, 160, 220, 280, 320]

axes:
  M4:
    name: light_arm             # angle from camera to light, about +Z (through the back at 180)
    fluidnc_axis: X
    phase: 4
    min_deg: 20.0
    max_deg: 324.0            # the upright stands 15.3 deg beyond the lamp (off the beam line); it clears the motor to here
    home_deg: 20.0              # switch at the near-camera end; roller-lever safety switch just beyond
    gear_ratio: 24.0            # ring rim pitch diameter / 20T pulley (set from CAD)
  M3:
    name: table_yaw             # whole stage about +Z; 0 = sample normal faces the camera
    fluidnc_axis: Y
    phase: 5
    min_deg: -180.0
    max_deg: 180.0
    home_deg: -180.0
    gear_ratio: 5.0
  M2:
    name: sample_tilt           # about the stage's horizontal axis; + tilts the normal up
    fluidnc_axis: Z
    phase: 8
    min_deg: -90.0
    max_deg: 90.0
    home_deg: -90.0
    gear_ratio: 5.0
  M1:
    name: sample_spin           # about the sample normal
    fluidnc_axis: A
    phase: 9
    min_deg: -180.0
    max_deg: 180.0
    home_deg: -180.0
    gear_ratio: 1.0             # direct drive: platter on the pancake motor's shaft (no belt)
    microsteps: 64              # TMC2209 at 1/64: 0.028 deg per step, same steps/deg as the old 4:1 belt
