Normansrule/Gonioreflectometer-Open-Source/(commit log)

2026-10-04 Initial design baseline: power budget, master BOM, Phase 1 power module, roadmap
    - Final-machine power budget (120 W adapter, 61% headroom at peak)
    - Master BOM for all six phases: spec / budget / own-stock paths vs caps
    - Phase 1 Power module: full 8-section documentation and acceptance log
    - Interface standards, Klipper config, opengantry Python package with tests
    - Goal-oriented roadmap: 8 milestones, 39 checklist issues
    Claude-Session: https://claude.ai/code/session_01PTPxPzrdtGVLZ3YocnGvzd
    [acceptance_log.csv, base-frame.csv, calibration-kit.csv, camera-arm.csv, camera-head.csv, controller.csv, enclosure.csv, light-arm.csv]
2026-10-04 Apply independent review: GPIO clamp, PG pull-up wording, controller_fan, UART series resistor, test limits
    - 10 k series + BAT85 clamps on MOTION_SENSE; netlist lists every pin per net
    - printer.cfg uses [controller_fan] so the fan follows stepper enable
    - 1 k in series on Pi TX; serial console disabled; usb_max_current_enable left off
    - T4 >= 4.80 V, T10 single limit, T11 >= 23.0 V; buck-allocation warning in the budget tool
    - BOM: USB-C pigtail >= 20 AWG 5 A, budget buck has no PG pin
    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
    [controller.csv, master_bom.csv, power.csv, printer.cfg]
2026-10-04 electronics: match MOTION_SENSE protection to the power netlist
    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
2026-10-04 v0.2: fixed-camera multispectral design after Ansari-Asl et al. 2024, laptop host
    - Architecture: fixed USB camera, sample stage M3/M2/M1, light arm M4 on a ring [R1]
    - Laptop control: FYSETC E4 + FluidNC (USB / WiFi / Bluetooth), Pico button + sensor hub
    - Cheapest-first BOM: $496.62 buy-all, $441.94 with own consumables; 60 W adapter
    - Animated SVGs, interactive Pages site, full CS348b + device equations
    - REFERENCES.md with every source (IDs cited in BOM, docs and code)
    - Power and controller modules complete; publish script for a private repo
    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
    [acceptance_log.csv, base-frame.csv, calibration-kit.csv, camera-arm.csv, camera-fixed.csv, camera-head.csv, config.yaml, controller.csv]
2026-10-04 v0.3: 3D photo scanner phase and milestones M5-M10
    - Phase 6 scanner: scan mode (650 mm, f/8), 144-view ring plan from M1/M2,
    measured camera pose (ChArUco + AX = YB fit), COLMAP model with known poses,
    image-ID sync, visual-hull carving, near-light photometric stereo (LED bank mast)
    - scan-kit module, scanner docs + equations, animated scanner figure,
    interactive view-sphere planner on the site, references S1-S20
    - Milestones: 11 milestones / 49 checklist issues; sync updates renamed items
    - Budget: $498.95 buy-all across seven phases
    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
    [base-frame.csv, machine.yaml, master_bom.csv, multispectral-kit.csv, power.csv, scan-kit.csv]
2026-10-04 v0.4: 17 small phases, one folder each (research, design, 3d, bom, test), shorter text
    - .github/phases.yml is the single source; tools/roadmap.py writes phases/*/README.md,
    the README table, and GitHub milestones (one per phase) and issues (one per step)
    - BOM split per phase; bom_check shows cost per phase and running total vs $500
    - Axis phases renumbered (M4 4, M3 5, M2 8, M1 9, LED bank 10); scan needs M1 + M2
    - Removed unused files and placeholder packages
    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
    [acceptance_log.csv, base-frame.csv, bom.csv, calibration-kit.csv, camera-fixed.csv, config.yaml, controller.csv, enclosure.csv]
2026-10-05 update from new zip
    [papers.tsv]
2026-10-05 Visible README, printable parts, 3D folders
    [CAL-06a_ptfe_holder.step, CAL-06a_ptfe_holder.stl, CAL-06b_mirror_holder.step, CAL-06b_mirror_holder.stl, CAL-06c_ball_holder.step, CAL-06c_ball_holder.stl, CAM-03a_aperture_stop_f8.step, CAM-03a_aperture_stop_f8.stl]
2026-10-05 Flatter stages, STEP + STL
    [CAL-06a_ptfe_holder.step, CAL-06a_ptfe_holder.stl, CAL-06b_mirror_holder.step, CAL-06b_mirror_holder.stl, CAL-06c_ball_holder.step, CAL-06c_ball_holder.stl, CAM-03a_aperture_stop_f8.step, CAM-03a_aperture_stop_f8.stl]
2026-10-07 Build audit fixes: bolt axles, direct spin, wiring
    [CAM-03b_camera_plate.step, CAM-03b_camera_plate.stl, CTL-10a_button_panel.step, CTL-10a_button_panel.stl, CTL-10b_controller_tray.step, CTL-10b_controller_tray.stl, FRM-09a_og40_adapter.step, FRM-09a_og40_adapter.stl]
2026-10-10 Solder-free lamp (CLU7A3 + TE Z35), lamp clamp fix, pre-soldered colour LEDs
    [CAL-01_ptfe_tile_50mm_3x3mm.step, CAL-02_mirror_tile_50mm.step, CAL-03_chrome_ball_1in.step, CAL-04_charuco_glass_4x6in.step, CAL-05_colorchecker_mini.step, CAL-06a_ptfe_holder.step, CAL-06a_ptfe_holder.stl, CAL-06b_mirror_holder.step]
2026-10-11 Paper: Open Source Gonioreflectometer
    [CAL-01_ptfe_tile_50mm_3x3mm.stl, CAL-02_mirror_tile_50mm.stl, CAL-03_chrome_ball_1in.stl, CAL-04_charuco_glass_4x6in.stl, CAL-05_colorchecker_mini.stl, CAL-07_grey_card_8x10in.stl, CAM-01_arducam_b0433_imx477_usb.stl, CAM-02_m12_lens_16mm.stl]
2026-10-11 Fix CI: TeX packages, no-pandoc build, actions v6
    [opengonio-bom.xlsx]
2026-10-11 Rebuild paper PDF and exports
    [opengonio-bom.xlsx]
2026-10-11 M2 screws, printed deck, modules
    [CAL-01_ptfe_tile_50mm_3x3mm.stl, CAL-02_mirror_tile_50mm.stl, CAL-03_chrome_ball_1in.stl, CAL-04_charuco_glass_4x6in.stl, CAL-05_colorchecker_mini.stl, CAL-07_grey_card_8x10in.stl, CAM-01_arducam_b0433_imx477_usb.stl, CAM-02_m12_lens_16mm.stl]
2026-10-12 Battery and plug-in power box
2026-10-19 Wiring tables pin by pin, motors ordered, pancake splice
2026-10-21 Raking-light redesign: website, lab, control app, README
    [CAL-01_ptfe_tile_50mm_3x3mm.step, CAL-01_ptfe_tile_50mm_3x3mm.stl, CAL-02_mirror_tile_50mm.step, CAL-02_mirror_tile_50mm.stl, CAL-03_chrome_ball_1in.step, CAL-03_chrome_ball_1in.stl, CAL-04_charuco_glass_4x6in.step, CAL-04_charuco_glass_4x6in.stl]
2026-10-21 Animated hero and live four-axis machine
    [opengonio-bom.xlsx]
2026-11-03 Confirmed parts at published sizes; lever-connector pockets on the tray
    [CTL-02_esp32s3_devkitc1.step, CTL-02_esp32s3_devkitc1.stl, CTL-08_fan_40mm.step, CTL-10b_controller_tray.step, CTL-10b_controller_tray.stl, FRM-01e_deck_tile_C.step, FRM-01e_deck_tile_C.stl, FRM-06_screws_m2_samples.step]
2026-11-04 App: device strip, spectral sensor panel, run quality, session log; shared page footer
    [opengonio-bom.xlsx]
2026-11-12 Project map (docs/explore) with plain-words tour; bench walkthroughs; stage 17 battery power; small-phone fixes
    [opengonio-bom.xlsx]
2026-11-12 Machine wiring walkthrough: motors, endstops, lamp, camera, add-ons, whole-machine test
    [opengonio-bom.xlsx]
2026-11-12 Inside page (software, tests, firmware, wiring, roadmap) + control app running in the browser
    [opengonio-bom.xlsx]
2026-11-14 Render: measured material on scanned objects, glTF export, WebGL viewer
    [CTL-10b_controller_tray.step, CTL-10b_controller_tray.stl, FRM-01d_deck_tile_W.step, FRM-01d_deck_tile_W.stl, FRM-01g_deck_tile_NW.step, FRM-01g_deck_tile_NW.stl, LAR-08g_arm_bar.step, LAR-08g_arm_bar.stl]
2026-11-14 Sync parts list (PARTS.md -> bom.csv, budget, checklists)
