Normansrule/Gonioreflectometer-Open-Source/(notices)

Notices in the files:
cad/open/CTL-11_kicad_JST_XH_B4B_header.step:
Copyright (C) 2019, Rene Poeschl
This work is licensed under the [Creative Commons CC-BY-SA 4.0 License](https://creativecommons.org/licenses/by-sa/4.0/legalcode),
with the following exception:
To the extent that the creation of electronic designs that use 'Licensed Material' can be considered to be 'Adapted Material',
You are free to use the library data in your own projects without the obligation to share your project files under this or any other license agreement.
cad/open/CTL-11_kicad_JST_PH_B6B_header.step:
Copyright (C) 2017, Rene Poeschl
